sbelakho2/Cutting/hardware/if-b01/manufacturing/draft-r2-2026-09-13/assembly/if-b01-top-render.png

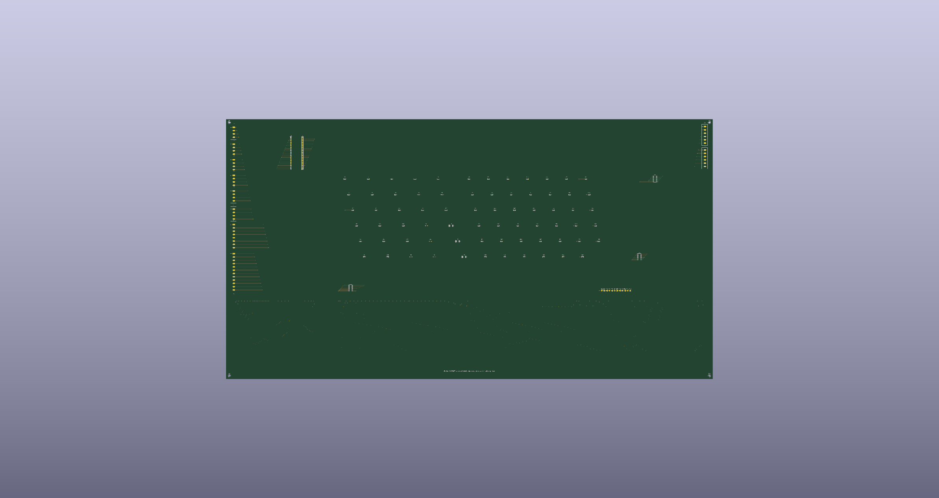
hardware/if-b01/manufacturing/draft-r2-2026-09-13/assembly/if-b01-top-render.png
