sbelakho2/Cutting/branding/brand-board.jpg

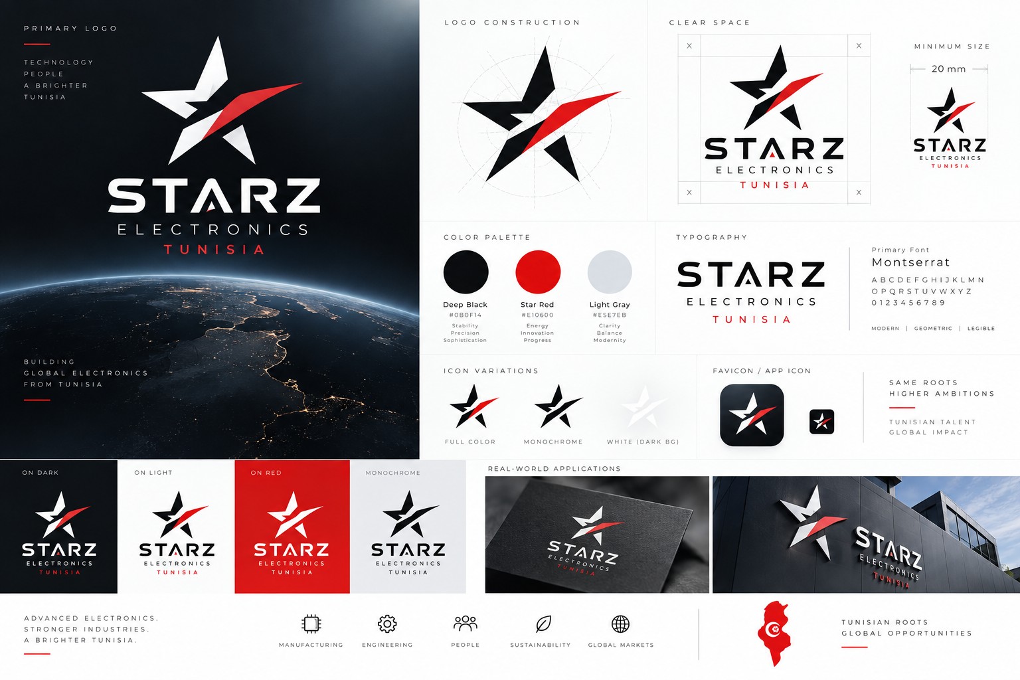
branding/brand-board.jpg
