sbelakho2/Cutting/engineering/README.md

# STARZ engineering — parts-first revision

This directory contains the replacement engineering work. **It is not a fabrication or energisation release.** The earlier generic-stage CAD and the “exact / zero-uncertainty” purchasing and physics reports are not the authority for this revision.

## Committed cutting-axis architecture

Two identical, independently driven, horizontal cutting axes:

| Item | Single selection | Basis |
|---|---|---|
| Complete ballscrew / guide / fixed-bearing axis | HIWIN **KK8610C-340A1-F0** (C-grade substitution, priced MISUMI VN shelf VND 21,146,653 on 2026-09-16; original P-grade identity KK8610P340A1F0 / article 10.00026), one standard block, no cover | Actual manufacturer product record; 10 mm lead, 340 mm rail, 440 mm overall axis length, 194 mm usable travel after reserves; C-grade accuracy margin analysis in [axis-replacement-findings](sources/axis-replacement-findings.md) |
| Motor / driver / cables | STEPPERONLINE **1-CL86T-P85-V41**: **34E1K-85**, **CL86T-V41**, **CM2M-18**, **CE2M**, **CABLE-PC-1** | Actual kit contents and motor drawing; no substitution with the previous NEMA23 kit |
| Shaft coupling | R+W **MK2/100/50/8/14**, H7 bores, no keyways | Manufacturer-configured catalogue coupling; 10 Nm nominal, 40 mm diameter, 50 mm length, **16 mm fit length** on the stage's 18 mm exposed shaft |
| Motion power | One STEPPERONLINE **LE-350-60** per cutting axis; buses **not paralleled** | Actual 60 V / 5.8 A model, 215 × 115 × 30 mm; regeneration protection is a separate design item, not a claimed PSU function |
| Transmission | **Direct 1:1**, no reduction belt | Actual stage lead and motor torque curve determine commanded speed and thrust |

The purchased axis is not shortened or represented as the old 175/180 mm generic slide. The motor is not represented as a 56 mm body. Its drawing shows **112.3 mm motor body plus 21.8 mm rear encoder section**, i.e. **134.1 mm before the 37 mm output shaft**. Cable space is additional.

The detailed shaft check rejected the initially screened KSD10: its 19 mm hub bore length exceeds the stage's 18 mm exposed shaft. The selected MK2 has a documented 16 mm fit length. No shaft extension, partly engaged hub or enlarged purchased housing is introduced.

This commits the actuation architecture, not the whole-machine BOM. Unselected transport, measurement, tooling, guard, electrical-protection and payoff interfaces must not silently inherit fabricated catalogue identities from the old reports.

## Load-path revision from simulation

The first40mm-wide holder passed a preliminary stress screen but **failed the loaded blade-clearance bound**: two holders could consume approximately0.0415mm versus0.020mm nominal clearance. Widening the same eccentric arm to70mm still failed (approximately0.0228mm). **R3 centres the70mm backbone on the screw/load line and machines the blade-seat pocket only at the nose, with a3mm internal fillet.** The blade plane and purchased hardware are unchanged. Earlier stress/displacement values do not validate this new load path; use its own regenerated results.

R3 left only0.00273mm in its isolated single-load-sign clearance screen. **R4 moves each complete purchased axis25mm closer to the wire and shortens the holder by25mm**, retaining the8mm carriage reserve and the0.020mm nominal blade gap. Completed R4all-sign/proof/gravityFEM at1.6mm mesh used77143nodes:working28.9957MPa,proof57.9871MPa,isolated rigid-blade pair gap+0.00454023mm. Holder displacement,frequency andpeak-stress refinement criteria passed. Adapter anddatum retained fourREFINEcriteria;they are not converged.

**R5** shortened the motor adapter to15mm and introduced the256-corner coupling stack,with≥0.53mm full-hub insertion reserve and≥12.58mm shaft-end gap. **R6** preserves that axial stack but deepens F0counterbores to8.5mm after explicitM5screw heads exposed interference with the actual motor pilot. The32adapter/motor screw/washer occurrences are now modeled. [R6adapter drawing](generated/drawings/H003-R6-adapter.pdf). Earlier adapterFEM does not validate this changed geometry.

The dedicated [R6 adapter FEM](generated/adapter-r6-analysis/report.md) now replaces the ideal fixed nodes with a resolved-pressure elastic-foundation model: the 4×8.0kN F0 M5 class10.9 preload (60% of the13.35kN proof load; required-preload screen, not a torque prediction) is applied on the counterbore-floor washer seats r∈[2.75,4.5]mm as a C¹-smooth quartic profile p(r)=p_peak·(1−s²)² with s=(r−3.625)/0.875 — zero with zero slope at both annulus edges, peak376.33MPa at r=3.625mm, mean p0=200.71MPa, so the per-seat resultant stays exactly8.0kN — and the Winkler foundation on the stage-side seat annuli shares the same resolved profile (action–reaction through the ISO7092 washer; peak kn=94,759.7N/mm³, kt=kn/2.67=35,490.5N/mm³), preserving the elastic half-space annular-punch calibration2·E·b/(1−ν²)=2014.41MN/m per seat over the39.86mm² annulus (E=205GPa,ν=0.29,b=4.5mm); the fully free system is solved with the supernodal CHOLMOD direct solver (METIS). The unchanged±8.5Nm/150N resultants stay on the actual85.85mm motor-flange bearing footprint (outside the Ø73.10 pilot bore, clear of the four Ø6.5 motor holes). Six uniform meshes6/4/2.8/2/1.4/1.0mm plus the isolated local-refinement pair (1.0mm background→0.7mm within8mm of the raw peak); finest level110580nodes. The uniform-patch edge singularity is removed — the pair peak285.987MPa sits on the counterbore floor0.59mm inside the washer-OD edge, not at a patch edge — but the gate pair still measures18.4573% raw peak and4.9551% displacement, because the resolved seat features (surface compression layer under the profile peak, floor-shelf deflection at the hole edge) live on the1.75mm seat annulus, the order of the pair's1.0mm background element; the gate rows remain **REFINE** (no criterion was relaxed, and the150000-node direct-solver cap is unchanged). A seat-scale focused pair of the same global model (0.15mm within3mm→0.1mm within2mm of the peak seat,1.5mm bulk,≤150000nodes) refines321.67→312.71MPa, last-change2.86%≤5%, bounding the model peak at≈313MPa — the raw peak converges at the feature's own scale and is local preload seat compression (yield/3 screen216.667MPa **FAIL**, below the650MPa certified yield). Stiffness sensitivity×0.5/×2 moves the peak+0.17%. The remaining gap is physical, not numerical: the resolved profile shape and the foundation stiffness are calibrated models, not measurements — a measured washer/joint contact stiffness or a two-body washer contact solve is the remaining justified step ([findings](sources/adapter-contact-findings.md)).

`starz_engineering` now accepts `--fem-part` with `holder`, `adapter` or `datum`, and a strictly decreasing `--fem-mesh-sizes` sequence for one selected part. Outputs explicitly record the requested scope; omitted parts are not validated. Ten malformed/ambiguous requests are checked by a regression before report creation. The150000-node direct-solver cap and all convergence/equilibrium limits remain unchanged.

## Selected feed cartridge

- **HTPA20S5M250-A-N14** keyed pulleys and **HTBN225S5M-250** belt;62.5mm nominalcentres,52.5–64.5mm adjustment requirement.
- Original **24HS40-5004D-E1000** motor STEP includes aD-flat,not a removablekey. Its50mm mountinggrid is modeled.
- **6001-2Z/C3** rear/nonlocating and **6002-2Z/C3** front/locating bearings,KM2/MB2retention,SEEGERA12groove,positivekeys. The roller receives the explicitly documentedF110secondarykeyway.
- [Cartridge3D](generated/feed/feed-cartridge.step), [four-rollerlayout](generated/feed-cassette/feed-cassette.step), [scope](generated/feed/status.json), [25calculation checks](generated/feed-analysis/checks.csv), [dimension and assembly record](../docs/12-feed-cartridge-fabrication.md), [F101 R6 A3 shaft sheet](generated/drawings/F101-R6-shaft.pdf), [machining-detail sheet](generated/drawings/F101-R6-details.pdf).
- The12mm pulley-seat iteration failed its bending screen and was replaced by14mm. R3combined-load shaft displacement bound0.0263053mm;3×notch-sensitivity working/fault stresses175.371/329.551MPa. These are beam/sensitivity results,not resolved key-seat/root/contactFEM or physical accuracy.
- R2makesF112frontbearingblock removable;the pre-keyed shaft/pulley/module stack entersF102from+S. MB2's actual inwardtang is modeled andits shaftslot extendedacross the14mmseat. Continuous sweep envelopes pass;separate regressions reproduce both the oldmonolithic-housing trap andclosedtang-slot obstruction. Sevenfeedtests passed83.87s.32occurrences in the motor-drivenexample;follower/passiveroles no longerduplicate motors.
- Pressure/tensioning slides,all fasteners,wireguides and full-machine integration are not in the exported single-cartridge assembly.
- R3models the actualMCØ4urethane-access holes andputs thewire atS108.75,with0.55mmboundedpocketclearance and2.10mmtreadedgeclearance. NipsX75.5/138nominal preserve10mminsulatedgrip on200mmparts duringfulltailbackfeed. Motoronfarshaft;upperhousings rotated180°abouttheirshafts. The116-partlayoutpasses1.2/4.5mmwireODstaticchecks;R3targeted9/9tests passed278.08s. Housingreliefnow accommodatesbeltbacking outtoR18.8455,notjust the36mmflanges.
- R4usesmatchedj5bearingseats andbounded housingclearances. [Fitreport](generated/bearing-fit/report.md) and[machiningwindows](generated/bearing-fit/matching-limits.csv):256corners,minresidual1.28µm within theexplicittemperatureenvelope. The desk [bearing-contact-thermal study](generated/bearing-contact-thermal/report.md) closes thehousing-compliance part (17.65MParesolvedseatpressure;seat vm22.73MPavs650MPa,ring82.26MPavs≈1700MPa;the record'sF112boreclearancecarriesnofitpressure;compliant-vs-rigidseatstresschange≤3.9MPaabsolute—PASS) andbounds thethermalfield (30Wstandstill→29.66Kfront-seatrisevs the20Kenvelope atthecentralstatedseatconductance—HOLD). Thethermalfield itselfremainsunverified byhardware;the oldh6bearingseats arewithdrawn.
- One incoming roller-bore band10.000–10.030mm covers the currentH7 product drawing and archivedEU +0.01/+0.03 callout. With the unchanged10h6 shaft, maximum diametral clearance is0.039mm. The key transmits torque; this is not an interference-fit roller.
- R5 added R0.20bearing/roller shoulders,R0.50neck shoulder,R0.04ring-groove roots,R0.15key-floor perimeters,matching C0.20key/C0.30spacer relief,and Ø13.50M15runout. The blind M5 hole has14mm full thread after its C0.20entry,18mm cylindrical drill depth plus118°point; cutting-lead allowance1.28mm,not verified clearance to an undimensioned male centre. The [selected Dormer E412M5 operation](../docs/14-f101-tapping-operation.md) requires guarded measured physical-tip-to-full-form distance≤3.18mm for≥0.50mm cylindrical clearance. Manufacturer3D blind application,not the rejected E003's2.5D.
- R6 adds external C0.20 shaft ends,C0.50 M15 lead,R0.50 washer-slot plan/vertical-intersection blends andR0.15 floor/lip blends. All interacting pocket radii are built simultaneously on the cutting volume. Nominal point classifiers,cartridge intersections and continuous insertion paths pass;the old unfinished shaft is rejected.
- The new [section audit](generated/feed-sections/report.md) integrates191 nominal B-rep plane sections for area,centroid and principal bending inertias. No checked minimum principal I falls below its reduced beam counterpart;minimum ratio1.00. Independent solid/annular/translated/rotated/notched-section benchmarks pass. This is sampled nominal stiffness,not a continuous tolerance bound,local stress,fatigue or true helical-thread analysis. Updated beam displacement screen0.02636934mm;working/fault3× sensitivity175.371/329.551MPa. Local contact/preload/thermal-field work remains open.
- The beam solver now diagonally equilibrates translation/rotation DOFs and uses residual refinement. Every real section/load/support remains a node; redundant subdivisions below0.5mm are avoided because each constant-EI,point-loaded interval has an exact cubic solution. Independent short-feature and original beam benchmarks pass without relaxing residual or comparison tolerances.

## Distributed shaft stress study

The new [F101 R6 3D stress study](generated/feed-fem/report.md) uses eight full-tensor/displacement bases,all radial signs,six transmission-torque vertices and48 rotation phases with a rigorous per-mesh unsampled-angle bound. Distributed resultants do not torsionally clamp the bearing seats. Actual eccentric mesh gravity produces an additional0.000179097Nm drive-holding amplitude,which is checked and retained. [Equations and scope](../docs/15-feed-shaft-stress-model.md).

Four bulk/root meshes2/.30,1.6/.20,1.2/.13,1/.09mm finish at131909nodes/603290tetrahedra. Finest working/fault stress upper bounds76.5876/158.193MPa;working displacement bound0.0205005mm. Whole-shaft peak and displacement last-refinement checks pass,**but16 regional raw-peak/angular-bound checks remain unmet**. No percentile replaces a raw peak. Nominal-thread envelopes and omitted contact/preload/fatigue effects are not qualified.

The distributed solver uses exact gauge cancellation with CHOLMOD supernodal Cholesky through Eigen and METIS nested-dissection ordering;SuiteSparse/CHOLMOD with METIS is an engineering-build dependency. The earlier full suites passed44/44 native and44/44 ASan/UBSan, resolving the scalar-backend timeout with unchanged4% compliance/12% tensor criteria and150000-node cap. The preserved four-mesh/96-phase artifacts pass their ten field-data audits while retaining16 original spatial-convergence holds. [Historical verification record](../docs/verification/feed-shaft-fem.md).

The [earlier focused refinement increment](../docs/16-local-shaft-refinement.md) adds six full-shaft feature series,three independent background checks,all-root compatibility and a96-phase A12 audit:26 meshes,520 regional rows and52 independently checked VTUs. That source state retained A12,M15 and pulley-key/slot local holds. Neck,roller shoulder and roller key passed their local last-change/background comparisons without claiming all-root or physical qualification. Exactly six constraints use rigid-equilibrium reactions plus rigid-motion lifting;seven–twelve retain the Schur formulation. This resolved the focused mesh's false mixed-scale rank rejection,not by changing a dependence threshold. Its code passed **46/46 native in435.55 s** and **46/46 ASan/UBSan in835.01 s**. [Historical verification record](../docs/verification/local-shaft-refinement.md).

The earlier [CAD-feature increment](../docs/17-cad-feature-shaft-refinement.md) audits85 actual shaft faces and640 peak locations,adds five explicit CAD-feature sizing selections,and publishes26 meshes/52 audited fields. That M15 series passes local last-change,finer-background and96-phase comparisons. Pulley key-floor last changes pass,with background checked only at the penultimate level;the wider pulley/slot working check failed. Both A12 roots remained unconverged. The finest front-root peak has four vertices on its torus but a centroid0.000281177056 mm outside the exact solid;the original raw value remains visible. Its source passed **49/49 native tests in440.53 s and49/49 ASan/UBSan in707.15 s**. [Historical verification record](../docs/verification/cad-feature-shaft-refinement.md).

The current [A12 boundary-topology increment](../docs/18-a12-boundary-topology.md) reproduces that exact cell, adds explicit `--mesh-optimizer netgen`, and checks same-surface cells and all40 raw/phase-bound peak centroids. The original default mesher and old results remain reproducible. Eight studies add17 meshes/34 independently audited fields; both A12 roots pass local and specified finest-background0.20→0.17 mm comparisons. A96-phase front audit stays inside the48-phase bounds. The all-root Netgen series still has12 regional refinement holds. Every centroid of the finest front mesh was checked:136 exterior points in the baseline versus25 after optimization, with9→0 in A12. The25 non-A12 points remain reported; this is not complete geometry or stress qualification. All existing limits, regions, physical CAD and focused scope holds are retained. **52/52 native tests passed in579.68 s and52/52 ASan/UBSan tests in873.81 s**,with no sanitizer diagnostics. Project/Eigen code is instrumented;prebuilt third-party libraries are not. [A12 verification record](../docs/verification/a12-boundary-topology.md).

The current [exterior-centroid diagnosis increment](../docs/19-exterior-centroid-diagnosis.md) adds `starz_mesh_io` (fail-closed ASCII linear VTU reader), `starz_cad_boundary` (exact trimmed-face inspector) and `starz_feed_cell_geometry_audit`. All25 retained discrepancies project onto five concave fillet tori (faces68,71/72,63,61,7) with gaps0.0093–5.452 µm; three vertices per cell lie on CAD faces, one is interior. Two torus feature selections (`rear_shoulder_blends`,`roller_key_floor`) and a probe `--focus` list were added; at0.03 mm root with four torus features, all586087 centroids give3 exterior/0 on within148934 nodes; the0.02 and0.009375 mm runs exceed the unchanged150000-node cap and were rejected. Mesh-only; no stress rerun or containment claim. **54/54 native tests passed in 654.37 s; 54/54 ASan/UBSan tests passed in 740.25 s** ([verification record](../docs/verification/exterior-centroid-diagnosis.md)).

The [torus-focused root rerun](../docs/26-feed-shaft-torus-root-rerun.md) runs the unchanged four-mesh series2/.30,1.6/.20,1.2/.13,1/.09 mm with a whole-shaft `concave_fillet_tori` guide (the six diagnosed concave fillet tori plus both A12 roots; growth0.45) and both optimizers, all loads,48 phases, torque vertices, gravity and gates identical. Finest [Netgen](generated/feed-fem-torus/netgen/report.md)129936 nodes/565476 tetrahedra, working/fault bounds74.7377/165.049 MPa, displacement0.0206120 mm. The original gmsh-optimizer variant reported34 exterior same-surface centroids; the 2026-09-16 centroid closure ([findings](sources/centroid-closure-findings.md)) swept24 configurations (feature subsets, 0.02–0.04 mm torus roots, growth0.3–0.6, both optimizers) and showed the gmsh optimizer cannot remove the last concave-surface sliver tetrahedra within the unchanged150000-node cap (best: 2 exterior at148510 nodes), while Netgen eliminates same-surface tetrahedra entirely. The [gmsh](generated/feed-fem-torus/gmsh/report.md) series was therefore rerun with the Netgen volume optimizer (levels, feature, growth, loads, 48 phases and every gate unchanged): 0 exterior same-surface and 0 exterior peak centroids at129936≤150000 nodes, byte-identical to the Netgen series, closing the fail-closed CAD boundary audit gate. The residual whole-shaft continuous CAD-containment audit (`starz_containment_audit`, [findings](sources/containment-audit-findings.md)) then classified every element centroid of all four levels with the exact BRep point-in-solid test at1×10⁻⁷ mm: **32 exterior / 0 on-boundary** of1,125,721 centroids (0/24/3/5 per level), all facet slivers on the concave fillet tori (faces68,7,9,61,63,71,72), gaps0.0071–5.51 µm. The ten remaining regional holds are stable-location stress concentrations at under-resolved R0.15–0.20 blends (M15 runout, roller shoulder, roller key-floor perimeter) whose finer resolution exceeds the unchanged150000-node cap. Growth0.70 variants are worse (29/14 fails) and are retained as [records](generated/feed-fem-torus/gmsh-growth-0.70/status.json) without VTUs. The no-feature path reproduces the published all-root Netgen series byte-identically. No acceptance criterion or node cap was relaxed.

The [regional submodel record](../docs/28-feed-shaft-submodel-record.md) closes the remaining blend holds: exact global displacement transfer (VTU reproduction to1e-7 MPa), interpolated Dirichlet cut faces (0 unsupported points), 0.02→0.01/0.0175 mm sector roots ≤150000 nodes/window, the unchanged5% last-change gate, and Pilkey shoulder-fillet Kt cross-checks where applicable. All eleven regional rows (roller shoulder, M15 relief, roller key root, pulley key/MB2 slot; working+fault; both optimizers) **converge between0.02% and4.0%** with CAD-inside stable peaks; the M15 peak is a real bounded slot-wall∩groove corner (no handbook factor asserted) and the key-floor/S plateaus are documented blend behaviour. The submodel columns are additive. The whole-shaft same-surface exterior-centroid audit closed on 2026-09-16 (0 exterior in both four-mesh series at≤150000 nodes; [closure findings](sources/centroid-closure-findings.md)); it is a mesh-quality audit, not a fabrication blocker. The stronger all-cell containment audit reports32 exterior centroids, so `continuous_CAD_containment_verified` remains false; per-level counts are in [containment-audit.csv](generated/feed-fem-torus/gmsh/containment-audit.csv).

## Combined placement and regressions

[287-occurrencehead/eight-rollerlayout](generated/layout/head-and-feed-layout.step),[manifest](generated/layout/manifest.csv),[scope](generated/layout/status.json). Leftcassette isrotated180°aboutZ,not mirroredintounavailableleft-handedparts. Cross-subsystemstaticchecks passat1.2/4.5mmwireOD. A17.5mmstrictXgap certifieshead/feedseparation for everyindependentjawYposition. Near-shaftmotorplacement failsa dedicatedregression. Theframe,measurement,pressure/tensioningmechanisms,guardsandwiring arenotrepresentedbythisplacementSTEP.

Previous **head R6 / feed R6 / measuring R1** baseline: **39/39 passed natively in 713.65 s** and **39/39 passed under ASan/UBSan in 1324.91 s**. The public R6 cartridge/cassette/combined STEP exports and readbacks completed successfully. F101 R6 has two separately exported single-page A3 sheets;37/38 labels were checked in bounds without overlap. [Verification record](../docs/verification/feed-r6.md). Exact bounding boxes are cached once per unchanged solid; no collision pair or tolerance was removed. Measurement remains a separate interface/mount export,not an installed addition to the287-part layout.

## Mechanism integration R4 (`S1-B-MECH-R4-2026-09-16`)

`starz_mechanism_cad` builds the 504-occurrence full-machine source: head, both cassettes, two spring-loaded pressure carriers (4× MISUMI LHFRW12 bushings on PSFJ12-240 posts, SWU17-60 springs, DIN 913 adjusters), two wire guides with OD-specific F206 inserts, the measuring module with its SWU10.5-35 arm spring and 626 counter-roller fork, the 640×1120×25 EN AW-6082 T651 bed and welded frame, the R2 guard selections (DC01 2 mm side/rear/roof, 5 mm polycarbonate front door, S235JR lock plate, Bernstein SLC/ACF envelopes) and the R2 payoff (welded Ø400×160 spool on a Ø20 h6 C45 spindle, 47H7 6204 pockets in 18 mm S235JR posts, 430×560×8 base, Ø180×6 brake disc and caliper bracket). [Manifest](generated/mechanism/manifest.csv), [BOM](generated/mechanism/mechanism-bom.csv), [scope](generated/mechanism/status.json). A3 sheets: [P002 spindle](generated/drawings/P002-R2-payoff-spindle.pdf), [P004–P007 plates](generated/drawings/P004-P007-R2-payoff-plates.pdf), [G101–G106 panels](generated/drawings/G101-G106-R2-guard-panels.pdf). Checks at 1.2 and 4.5 mm wire verify valid solids for all nine groups, every guard/payoff pair and the remaining implemented cross-group pairs, spring deflection inside catalogue windows, nip preload 50–75 N and wheel force 6–19 N, ±10 mm bushing travel inside the posts, moving-head X clearance, and zero common volume between every part and the 880 mm external wire envelope. The three head/cassette placement pairs are covered separately by `starz_layout_cad`. Four regressions prove the gates reject a shifted bushing, a slack carrier spring, a light wheel and a blocked guard wire route. The R2 guard/payoff parts are fabrication-ready design solids for the internal build (A3 sheets in [generated/drawings](generated/drawings/)): `guard_door_kinematics_validated`, `guard_safety_function_validated`, `payoff_selection_complete` and `payoff_rotation_validated` remain false until the physical build; the brake pads, adjuster spring, door hardware and Bernstein drilling pattern are purchase-to-requirement. Cabinet, wiring and safety functions are not modeled by the mechanism CAD; `full_machine_integrated`, `physical_results` and `fabrication_released` stay false until the machine is built and measured. See the [guard/payoff selection record](../docs/26-guard-and-payoff-selection.md) and the [fabrication guide](../docs/31-fabrication-guide.md).

## Precision finishing and physical qualification

[Finishing cards](../docs/21-precision-finishing.md) (`starz_finishing_cards`) compute per-shaft j5 seat targets and pass schedules from measured bearing bores, and housing bore targets, all guard-banded by gauge U(k=2). [Qualification](../docs/20-physical-qualification.md) (`starz_qualification`) evaluates 30-piece length cells at two ODs × two lengths against ±(0.05 % + 0.20 mm) with Cpk ≥ 1.33, plus nip and wheel force records, and refuses blank or incomplete data. Both ship blank templates under [generated/finishing/templates](generated/finishing/templates) and [generated/qualification/templates](generated/qualification/templates). **No part has been finished and no machine has been measured.**

## Measuring interfaces and calibration R2

- [Manufacturer transcription](sources/measurement-interfaces.csv), [shared constants](../shared/measurement_spec.hpp), [interface STEP manifest](generated/measurement/manifest.csv) and [assembly/calibration record](../docs/13-measuring-interfaces-and-calibration.md).
- Substitution 2026-09-16 (unpriced Kübler/Autonics replaced): **ifm E60137** wheel (200 mm circumference, Ø63.66, Ø6 bore, PU 90 Shore A; ifm publishes no tolerance and no hub/screw dimensions — profile stations are retained placeholders) and **ifm RU3100** encoder (Ø6×10 shaft, no flat, tip10 from face; body Ø58.6×63.5; synchro flange 3×M4×0.7×6 PCD42; 1024 PPR factory TTL/HTL, 1000 kHz, 12000 rpm). Both short-tip and wrong-wheel-screw regressions still reject incorrect interpretations.
- [M201 plate A3 drawing](generated/drawings/M201-R2-encoder-plate.pdf) and [five-part encoder mount](generated/measurement/encoder-mount.step).60×60×6 mm6082-T6 plate; Ø36.5-class synchro-flange seat;3×Ø4.5 onPCD42;4×M4 support taps;M4×12 flange screws and M4×6 support screws in M203 rear counterbores;0.2 mm edge chamfers. The source integrates the measuring shaft and pressure/guide assemblies in mechanism R4 (lug raised15.915 mm for the larger wheel); their physical support/torque, fabrication and qualification evidence remain open.
- [C++ calibration API](include/measurement_models.hpp) and [report](generated/measurement-analysis/report.md). A32-interval weighted phase-map fitter rejects unobservable or nonmonotone data. Negative counts, reversals, int64 extremes, malformed CSV, separate verification, hard-link input aliases and failing residuals are tested. Existing reference controls remain unchanged and disabled for hardware.
- The report's392 held-out observations are **synthetic**. Maximum interpolation residual0.000650204 mm against the independent first-harmonic bound0.000963829 mm (eccentricity bound unchanged; the 200 mm wheel only rescales the phase map) is a numerical benchmark, not physical accuracy. The0.025 mm+0.01% metrology allocation must be verified using actual traceable data, qualified wire/contact conditions and a valid index reference.
- [Current analytic-only results](generated/current-analytical/checks.csv) retain17 checks and2 failures. The uncalibrated1m budget is now **1.65 mm** because source circumference alone contributes1.0 mm. Earlier FEM archives retain their original analytical context; this correction does not rerun or relabel their physical solves. The separate626 CN10K screen leaves0.5 µm before fit loss and is not approved.
- Use the individual `starz_measurement_cad`, `starz_measurement_analysis` and `starz_fabrication_drawings` targets for this work. Do not run the expensive full-head FEM generation target just to update measurement files.

## Evidence and model discipline

- Read [sources/catalogue-evidence.md](sources/catalogue-evidence.md) before using any numerical rating.
- A manufacturer's **static load rating**, **maximum working load**, **dynamic load rating**, and **repeatability** are different quantities.
- Specified load cases are design/test requirements, **not measured wire-cutting forces**.
- Materials, friction, contact, preload, support stiffness, motor temperature and wire-lot behaviour require qualification. No script can remove that requirement.
- Models must expose failed checks, numerical convergence and physical-validation holds. Exit success is not machine certification.
- All new analysis and CAD computation use C++20. Do not extend the legacy Python calculator as the machine's engineering authority.
- Prices observed on a product page are merchandise prices, not Tunisia-delivered quotations. No purchase, vendor contact, freight booking or duty eligibility verification has occurred.

## Superseded work

The S1-A full-machine CAD, the “exact / zero-uncertainty” component, physics, dimension and software-architecture documents, the single-point BOM and the Python calculator were removed from the repository on2026-09-13 and archived outside it (`Cutting-superseded-2026-09-13.tar.zst`). None of their identities, prices, load values or release statements may be reused. Existing nominal CAD checks validate only their explicitly declared geometry. Reference-only controls remain fail-closed.
