sbelakho2/Cutting/branding/README.md

# STARZ Electronics · Tunisia

The supplied [brand board](brand-board.jpg) is preserved unchanged. The machine and native HMI use **STARZ ELECTRONICS / TUNISIA**, not an invented Stars logo.

| Token | Board value |
|---|---|
| Deep Black | `#0B0F14` |
| Star Red | `#E10600` |
| Light Gray | `#E5E7EB` |
| Typography | Montserrat; system sans-serif fallback when not installed |

[starz-mark.svg](starz-mark.svg) is a manually reconstructed engineering trace, **not an original supplied vector master**. The C++ asset exporter also produces an **unaltered raster crop** of the original primary logo for the HMI and machine-decal preview. Use that crop rather than claiming the trace is exact. Approve a vector master before printing production decals; do not distort, mirror, or laser-cut load-bearing structure into the logo shape.

Minimum mark size on the board: 20 mm. Reserve clear space at least one quarter of mark height in this prototype layout pending the brand owner's exact X-unit definition. Use a 120 × 90 mm exterior decal; no branding obscures guards, warning labels, or indicators. Black structural skins, gray working surfaces, red non-safety accent strip. Emergency-stop devices retain their required red actuator/yellow background independently of brand colors.

The original artwork remains the owner's material. No Komax trademarks or product imagery are embedded in the STARZ machine.
