sbelakho2/Cutting/hardware/if-b01/review/if-b01-native-source-review.md

# IF-B01 native source review record

**Revision:** `S1-B-IF-B01-NATIVE-DRAFT-R2-2026-09-13`  
**Status:** source-level evidence only — **not released for PCB fabrication,
assembly, energisation, cabinet integration, safety use or machine operation.**

This record identifies what the native KiCad baseline proves and, importantly,
what it does not prove. It is not a design-review approval, manufacturing
release, physical test result or safety validation record.

## Scope of the native baseline

The editable [project](../if-b01.kicad_pro), [logical schematic](../if-b01.kicad_sch),
[local symbols](../if-b01.kicad_sym), [local footprints](../if-b01.pretty) and
[intent manifest](../if-b01-native-intent.json) are generated from the controlled
[component input](../if-b01-bom.csv), [connector-net input](../if-b01-netlist.csv)
and [controller signal specification](../../../shared/controls_spec.hpp).

The schematic embeds its local-symbol cache so it remains parseable without a
user-specific symbol-library configuration. The PCB file is a
$750\times400\ \mathrm{mm}$, four-layer placed/routed draft with all 90 board
footprints, four M3 mounting holes, local F.Cu pad escapes, In1.Cu vertical
breakouts and B.Cu net buses. The intentionally spacious routing-cell strategy
makes all generated copper inspectable, but remains subject to human and
fabricator review.

## Recorded checks

| Check | Result | Evidence / boundary |
|---|---|---|
| Generator input reconciliation | Passed | Every one of the 112 electrical BOM references is represented once; fixed U1/U2/U3 pin allocations and J3–J12 pin/net mappings are checked before source is written. |
| KiCad CLI | `10.0.6` | Local tool availability only; it does not establish manufacturing capability. |
| Schematic ERC | Zero reported violations | [if-b01-erc.rpt](if-b01-erc.rpt). This is a source-level electrical-rule result, not circuit analysis or a human review. |
| Native export parity | Passed: 112 BOM references, 102 netlist references, 298 connected symbol pins, six intentional no-connects | [if-b01-netlist.net](if-b01-netlist.net) and [if-b01-native-bom.csv](if-b01-native-bom.csv) are compared with the manifest. The ten supplied off-board mating plugs are BOM entries and intentionally have no electrical symbol pins. |
| Coordinate-derived socket regression | Passed: 40 physical Pico 2 pins recovered from J1/J2 pad coordinates | [check_if_b01_gpio_mapping.py](../../../tools/check_if_b01_gpio_mapping.py) derives every physical pin from pad position and fails on a reversed/mirrored socket row; the dry-contact pull-configuration contract is checked in the same gate. |
| PCB DRC with schematic parity | Zero physical DRC violations, zero unconnected pads and zero schematic-parity issues | [if-b01-pcb-drc.rpt](if-b01-pcb-drc.rpt), generated by KiCad 10.0.6 with `--schematic-parity --all-track-errors --severity-all --exit-code-violations`. This is a source check, not layout approval. |
| Draft manufacturing-output generation | Passed after all source gates | [draft output package](../manufacturing/draft-r2-2026-09-13) has four-copper, solder-mask, paste, silkscreen and outline Gerbers; drill, placement, assembly-view, board-only STEP, IPC-D-356, BOM and source/output SHA-256 manifest files. It is not a release package. |

## Preserved source constraints

- J1/J2 place a real Pico 2: J2's dedicated reversed socket footprint puts pad 1
  (physical pin 21, `GP16`) at the row bottom; the coordinate regression fails
  any mirrored or reversed socket row.
- U2 channels 1–7 are BF `PUL−`, BF `DIR−`, BR `PUL−`, BR `DIR−`, FL `PUL−`,
  FL `DIR−`, and FR `PUL−`; U3 channel 1 is FR `DIR−`.
- U3 channels 6 and 7 inputs are tied to `0V_PELV`; their outputs have explicit
  no-connects and no field connector allocation.
- U1 receives the four encoder single-ended TTL signals on its + inputs and
  exposes only the selected non-inverted receiver outputs to `GP8`–`GP11`; the
  minus inputs carry the R38–R45/C14–C17 2.5 V mid-bias and no 120 Ω terminator
  exists on the board.
- The dry-contact pull-configuration contract requires the RP2350 internal pulls
  to be disabled in both firmware images on `GP12`–`GP16`, `GP27`, `GP18`–`GP21`.
- C1 is the 16 V 3.3 V receiver decoupler. C2/C3 are the distinct 50 V
  `GRM188R71H104KA93D` bypass capacitors from `+24V_TPL_COM` to `0V_PELV`.
- F1–F3 are verified 1812 SMD PTCs: `MF-MSMF050/60X` on the 24 V branch and
  `MF-MSMF050/16X` on the two 5 V encoder branches.
- The common-anode 24 V PUL/DIR/ENA positive wiring remains cabinet wiring and
  is not routed through IF-B01.

## Open release gates

1. Review the logical circuit and datasheets, including actual fault energy,
  TPL COM bypass/bulk capacitance, connector ratings, input protection, power
  loading, return paths and the present layout strategy.
2. Validate selected footprints, connector orientation, the 750 × 400 mm panel,
  fabricator stack-up, copper, drill, clearance, mask, silkscreen and assembly
  capability; revise the draft source where a manufacturer requirement differs.
3. Build and inspect a bare board, execute the isolated fixture procedure and
   record actual measurements before connection to production motor drivers.
4. Complete the separate cabinet, DC-power, PE, EMC, guarding and safety-function
   evidence. IF-B01 and its firmware signals are not safety functions.
