sbelakho2/Cutting/engineering/generated/bearing-fit/report.md

# Selected feed bearing fit envelope

SKF6001-2Z/C3and6002-2Z/C3,unmountedC3=11–25µm. Use **matched j5bearing seats**,not unselectedh6. For10<d≤18mm,j5is−3/+5µm;each actualbearing bore ismatched to **3–6µm diametral interference** withinthatzone. The matchingtable lists actual-size limits,not gaugeuncertainty. F102bore28.008–28.018mm;F112bore32.008–32.019mm. No retentionadhesive oradditionalbearingpreload is specified.

Enumerated **256independent corners**. Minimum residualradialclearance **1.28µm**;minimum outerring/housingdiametralclearance **2.432µm**. The maximumcatalogue/C3andj5ranges cannot simplybe combined:anunselected12µminterferencecase fails andis testedasaregression.

## Thermal envelope used

Housing10–55°C;outerring0–5Kabovehousing;innerring0–10Kaboveouter;shaft0–5Kaboveinner. These areexplicitdesign/acceptancelimits,NOTmeasuredtemperatures or a completedheat-transferprediction. The thermalnetwork andinstrumentedcold-start/hot-run testmust demonstrate these limitsbeforethefit isreleased. Steel12µm/m/K,6082aluminium23.4µm/m/K;ringthermalreduction0.012ΔT(d+D)/2inµm. Fitreductionfactor1.0 isusedasaconservativebound;no favourablethick-steelhousingfactor isappliedtoaluminium.

## Inspection and assembly

Finish matchedjournalswithcertifiedcylindricalfinishing;Ra≤0.4µm. Markeachbearing/shaft/cartridgepair. Gaugeuncertaintymustbeincluded:combineddiameteruncertainty≤0.5µm requiresmeasuredinterference3.5–5.5µmandguardedj5limits. Measureat20°C;pressonlytherelevantring. Rearouterringremainsaxiallyfree;do notturnthe6001innerringendfloat intoaxialbearingpreload. Matchreplacementbearings beforeinstallation. Precisionseatrunout/rootgeometryandhousingstiffness remainseparatechecks.
