sbelakho2/Cutting/engineering/generated/feed-analysis/report.md

# Feed drivetrain calculation record

Revision **S1-B-FEED-R6-2026-09-12**.

Selected pulley **HTPA20S5M250-A-N14**, belt **HTBN225S5M-250**; nominal centres **62.5mm**. The12mm pulley-seat iteration failed the bending screen and was replaced by the14mm keyed catalogue bore.

R3puts the wire lane atS108.75,5.25mm off the roller midplane,away from the twoMCurethane-access holes. With4.5mmwire,±0.20mmassembled lane position,4.2mm maximum incoming access diameter,±0.15mmaccess-centre tolerance and−0.2mmroller length: minimum pocket-edge clearance **0.55mm**,tread-edge clearance **2.1mm**. Shaft loads use this actualoffset station.

Nips are X75.5and138.0mm nominal;at maximumcentre setting,thefarnip isX140.0mm. A200mmpart with25mmleadingstrip and25mmtailbackfeed retains **10mm** insulated grip beyondthefarnip. The motor is on theouter/farshaft,awayfromthecutting stages.

R5 adds machined shoulder/key-seat/groove radii and matching key/spacer relief. The blind M5 thread now has14mm full-profile depth after its0.2mm entry chamfer,18mm cylindrical drill depth and a118degree drill point. Worst specified clearance beyond a3-pitch cutting-tap lead is **1.28mm**. R6 defines the external end/thread-lead chamfers and the washer-slot plan/intersection/floor blends. Reduced beam intervals now include the two end chamfers and the S33.30–61.70 key-lip envelope. The separate machined-section audit checks nominal principal bending inertias against these reduced sections. These geometry checks do not replace local contact/root stress analysis.

## Belt and commissioning setting

Minimum catalogue capacity across50–260rpm: **10.889724Nm**. The1Nm operating envelope carries a2.5 reversing-service factor. The separate5Nm mechanical fault envelope has capacity ratio 2.1779448. These are design envelopes, not measured wire forces or a motor tolerance guarantee. No power-table extrapolation to standstill is made. Static holding/jam tooth integrity requires the5Nm bench test in the assembly record.

Set initial strand tension190N, acceptance180–200N. At the62.5mm span, apply **1.000mm** transverse deflection. Corrected deflection force: **13.871528–15.121528N**, target **14.496528N**. Use the actual measured span in the equation if the final tensioned centre distance differs. At180N initial tension and5Nm, the slack strand remains **22.920367N**. Manufacturer225mm belt length tolerance±0.41mm corresponds to±0.205mm geometrical centre change before elastic tensioning.

## Shaft and bearing screens

Eight independent load-sign combinations:±480N belt radialX;±60N rollerX and±60N rollerZ. These conservatively allow simultaneous components. Maximum displacement bound **0.026369341mm**; nominal bending bound **55.288537MPa**. With an explicit3x notch sensitivity: working combined stress **175.37132MPa**,5Nm fault **329.55098MPa**. Peak bearing resultants: rear **321.22845N**,front **309.90595N**. Full-length constant-torque shaft wind-up screen **0.0012349608rad/Nm**; actual torque distribution and encoder correction are separate.

The model uses reduced circular sections, not resolved key-seat roots. The real housing, bearing contact/clearance, corner radii, pulley-belt dynamics, rubber contact and fatigue are not replaced by this beam calculation. No physical accuracy or machine-life result is asserted.

## Axial retention

Rear inner-ring stack minimum end float **0.08mm**, maximum **0.5mm**. The rear outer ring floats axially in28.008–28.018mm. The front6002 is the locating bearing,in32.008–32.019mm,clamped at its inner ring byKM2/MB2. Matchedj5shaftseats use3–6µmactualinterference;see the separatebearing-fit/thermal-enveloperecord. Its outer ring has0.020–0.110mm specified end clearance in the9.02–9.05mm pocket; do not impose nut preload through both bearings.

Generated **25** calculation checks; **0** failures. Refer to the per-check basis. Fabrication release also requires completed housing/root analyses, pressure/tensioning assembly and fastener/tool-access drawings.
