sbelakho2/Cutting/hardware/if-b01/manufacturing/draft-r2-2026-09-13/drill/if-b01-drill-report.txt

Drill report for if-b01.kicad_pcb
Created on 2026-10-13T11:45:14

Copper Layer Stackup:
    =============================================================
    L1 :  F.Cu                      front
    L2 :  Inner layer 1             in1
    L3 :  Inner layer 2             in2
    L4 :  B.Cu                      back

Drill file 'if-b01-PTH.drl' contains
    plated through holes:
    =============================================================
    T1  0.350mm  0.0138"  (410 holes))
    T2  0.600mm  0.0236"  (174 holes))
    T3  1.000mm  0.0394"  (52 holes))
    T4  1.400mm  0.0551"  (56 holes))

    Total plated holes count 692

Drill file 'if-b01-NPTH.drl' contains
    unplated through holes:
    =============================================================
    T1  3.200mm  0.1260"  (4 holes))

    Total unplated holes count 4
