sbelakho2/Cutting/docs/33-gate-ledger.md

# 33 — Gate ledger: every open gate and hold in the repository

**Revision:** `S1-B-LEDGER-R2-2026-10-13`
**Status:** single source of truth for "what remains". One table below lists
every open gate/hold found across the repository (docs/24 §9+§10, docs/22
§10, docs/26 §6, docs/28 §4+§7, docs/20, docs/12, docs/15–18, docs/30,
README.md warnings, engineering/README.md "not yet qualified" mentions, the
external audit of 2026-10-13 (F01–F35, [docs/41](41-goal-traceability-matrix.md)
re-verdict) and the verdict/status files under `engineering/generated/`).
Categories:

- **CLOSED** — fully closed with recorded evidence (none of the open gates
  qualify; the table contains no CLOSED rows).
- **DESK-CLOSABLE** — closable by calculation/document work at a desk. Gates
  whose desk part is now closed say so and give the study/record; gates
  being handled by a parallel workstream are named.
- **PHYSICAL-ONLY** — requires hardware, measurement or competent-person
  sign-off; the exact procedure/template is cited.
- **EXTERNAL-INQUIRY** — requires a manufacturer/distributor answer; the
  exact enquiry text/row is cited.

Nothing in this ledger releases fabrication or energisation. Desk closures
recorded here (§2) are calculations with stated assumptions; the physical
steps attached to each gate remain mandatory.

**Historical authority (audit F35).** Superseded drawings/reports hold no
build authority: the HIWIN KK86 axis material (KK8610C leads, KK86-era
drawings/studies) is superseded by the custom axis
[docs/39](39-custom-cut-axis.md) and its frozen 10 mm-lead configuration;
the guard/payoff R1 record [docs/25](25-preliminary-guard-and-payoff.md) is
superseded by [docs/26](26-guard-and-payoff-selection.md); the F101-R4/R5
shaft drawings are superseded by F101-R6; M201-R1 is superseded by M201-R2;
the 1024 PPR-era measurement budgets are superseded by the 2048 PPR R2
record ([docs/42](42-process-dynamics-r2.md)); the older adapter square-patch
boundary studies are superseded by the resolved-pressure model. The full
list with links is in [docs/24 §1](24-production-and-release-plan.md).

## 1. Open gates

| # | Gate | Where | Category | Current evidence | Exact closure action |
|---|---|---|---|---|---|
| 1 | Housing/collar key contact | docs/24 §3/§9/§10.6; docs/12:68,158; feed-fem "key/collar contact" holds | DESK-CLOSABLE — desk part **CLOSED 2026-09-16** | New [collar-contact study](../engineering/generated/collar-contact/report.md): 5 Nm resolved-pressure linear FEM, ≤35 k nodes, both key identities PASS the C45 allowables (bearing 120, shear 180 MPa). F109 3×4×18: contact 26.2 MPa FEM (25.25 ideal), shear 18.5, seat bearing 30.9, key peak vm 164 MPa < 300 MPa F109 min yield, aluminium collar-wall margin 1.66× (limit 65/1.5 = 43.3 MPa). DIN 3×3×20 passes C45 allowables but erodes the aluminium margin to ≈1.0× — not an endorsed F109 substitute. Clamp: M4 8.8 @2.8 Nm, K=0.2 → 3.5 kN/screw, 7 kN total (69% of 5.1 kN proof) | Remaining physical part: incoming bore 10.000–10.030 mm and keyway 3.04±0.01/2.35±0.025 measurement on F110 (inspection/incoming-inspection-template.csv), clamp-screw identity + torque record at assembly, belt proof test 5 Nm/10 s/10 cycles slip-marked (docs/12:152) — runbook steps [P0-2, P4-1, P4-4, P4-5](36-commissioning-runbook.md) |
| 2 | Adapter FEM raw-peak REFINE / seat contact model | docs/24 §9/§10.6; adapter-r6-analysis; engineering/sources/adapter-contact-findings.md | DESK-CLOSABLE + PHYSICAL-ONLY (adapter workstream completed 2026-09-16) | Resolved-pressure model (C¹ quartic seat profile, peak 376.33 MPa, mean 200.71 MPa per 8.0 kN seat; resolved Winkler foundation) removes the patch-edge singularity: pair peak 285.99 MPa sits 0.59 mm inside the washer-OD edge; gate pair (1.0→0.7 mm) still 18.46% raw peak / 4.96% displacement → rows stay REFINE (never relaxed); seat-scale pair (0.15→0.1 mm, 64,944 nodes) refines 321.67→312.71 MPa, 2.86% ≤ 5%, bounding the model peak at ≈313 MPa (below 650 MPa yield, above the 216.7 MPa yield/3 screen) | Remaining gap is physical: measured washer/joint contact stiffness or a two-body ISO7092 washer contact solve (docs/24 §9, adapter-contact-findings.md); keep the unchanged gates and the 150 k-node cap — runbook step [P4-2](36-commissioning-runbook.md) |
| 3 | 34-exterior same-surface centroid whole-shaft audit | docs/26:22; docs/28 §7; README warnings; engineering/sources/centroid-closure-findings.md | DESK-CLOSABLE — desk part **CLOSED 2026-09-16** (exterior-centroid workstream); residual containment audit **EXECUTED 2026-09-16** | Config sweep + final rerun: `no_exterior_same_surface_centroids` 0 → PASS_SCOPED and `all_reported_peak_centroids_in_CAD` 0 → PASS_SCOPED on the gmsh torus series (≤150 k nodes; loads/phases/gates unchanged; Netgen series reproduced byte-identically). The residual whole-shaft continuous CAD-containment audit was then run exactly ([findings](../engineering/sources/containment-audit-findings.md), [counts](../engineering/generated/feed-fem-torus/gmsh/containment-audit.csv)): BRep point-in-solid classification of all 1,125,721 element centroids of the four levels (2/0.3, 1.6/0.2, 1.2/0.13, 1/0.09 mm) at 1×10⁻⁷ mm finds **32 exterior / 0 on-boundary** (0/24/3/5 per level), all facet slivers on the concave fillet tori (faces 68, 7, 9, 61, 63, 71, 72), gaps 0.0071–5.51 µm | Residual: `continuous_CAD_containment_verified` remains **false** (32 exterior centroids of 1,125,721); not a release blocker; keep the four-mesh raw values and every gate unaltered |
| 4 | Fastener preload/torque record (M5/M10 joints) | docs/24 §10.5; docs/30:97; docs/12:115 | DESK-CLOSABLE — desk part **CLOSED 2026-09-16** (ledger §2.2) | Torque values "not published" for M5/M10; H003 joint preload record pending | Desk calc recorded §2.2; physical: record actual torque values in the production build record (inspection/production-build-record-template.csv) at assembly — runbook step [P4-1](36-commissioning-runbook.md) |
| 5 | Roller-key identity slip (3×3×20 vs F109 3×4×18) | docs/28 §2.3 ("UMCL roller key … (3×3)"); docs/12:109 (F109 3×4×18); catalogue-evidence:142 | DESK-CLOSABLE — desk part **CLOSED 2026-09-16** (ledger §2.3) | F109 is 3×4×18 C45+N (width 2.975–3.000, height 3.950–4.000, length 17.90–18.00); the audit's "3×3" shear line is a transcription slip | Both identities evaluated in the collar-contact study (gate 1); keep F109 as the governing selection; no doc edit made outside this ledger |
| 6 | Kübler wheel M4×6 set-screw torque | docs/30:182 | DESK-CLOSABLE — desk part **CLOSED 2026-09-16** (ledger §2.4) | Register row "set screw torque pending" | Desk value 2.0 Nm recorded §2.4; physical: record applied torque at assembly in the build record — runbook step [P4-3](36-commissioning-runbook.md) |
| 7 | Guard/payoff weld & assembly procedure | docs/26 §6.7; docs/34 | CLOSED-DESK (physical inspection remains) | Procedures drafted with fixtures, processes and criteria: post-to-base coaxial weld (gauge-pin fixture, coaxiality ≤0.1), spool hub weld (runout ≤1.0), jamb/door-frame weld + glazing (docs/34) | Physical weld inspection and first-article checks (docs/26 §6.3, docs/20) — runbook steps [P3-1…P3-4](36-commissioning-runbook.md) |
| 8 | True helical-thread roots (M5 blind hole, M15) | feed-fem holds "true_threads_verified:false"; docs/15:124; docs/12:60 | PHYSICAL-ONLY | FEM uses nominal thread envelopes; not qualified | Machining QA per docs/12 (M5 depth/tip record docs/14, thread gauge) plus thread inspection at receipt; no FEM number releases the thread — runbook steps [P2-2, P2-3](36-commissioning-runbook.md) |
| 9 | Final edge breaks 0.05–0.10 mm | feed-fem; docs/12 | PHYSICAL-ONLY | Deburr practice specified; not measured | Deburr without raised lips and inspect per docs/12:127 + build record — runbook step [P2-4](36-commissioning-runbook.md) |
| 10 | Bearing/housing compliance, preload, thermal field | docs/24 §9 "Bearings, joints and thermal behavior"; bearing-fit (`thermal_field_verified:false`); docs/12:68 | PHYSICAL-ONLY — desk parts (housing compliance + thermal field) **CLOSED 2026-09-16** (ledger §2.5) | 256-corner fit envelope passes conditionally (min 1.28 µm); new [bearing-contact-thermal study](../engineering/generated/bearing-contact-thermal/report.md): the 6 µm matched interference resolves to 17.65 MPa on the seat (seat vm 22.73 vs 650 MPa, ring 82.26 vs ≈1700 MPa); the record's F112 bore is a clearance fit, so the housing carries no fit pressure (bore-wall 0.98 MPa under the resolved 310 N); housing compliance changes the seat stress ≤3.9 MPa absolute (a rigid-boundary artifact) — not material; the 30 W standstill thermal FEM gives a 29.66 K front-seat rise vs the record's 20 K shaft-above-housing envelope → **not met at the central stated seat conductance** (sensitivity 15.5–51.7 K) | Remaining physical: measure/justify preload, contact and the seat temperature field on the actual build; instrumented cold-start/hot-run test (docs/12:38); record the motor-case temperature at rated hold (docs/28 §2.5) — runbook steps [P1-1…P1-5, P9-1…P9-3](36-commissioning-runbook.md) |
| 11 | Rotating fatigue qualification | feed-fem (`fatigue_verified:false`); docs/15:124; docs/24 §9 | PHYSICAL-ONLY — desk part **CLOSED 2026-09-16** (ledger §2.6); whole-machine load context in [docs/37](37-system-dynamics.md) §1/§4 (ledger §2.7) | Desk S-N in [docs/38](38-fatigue-and-life.md): working whole-shaft bound 76.6 MPa, worst converged regional working peak 60.4 MPa (M15 corner, docs/28 §5); 42CrMo4+QT σ_w 400–450 MPa (FKM-Richtlinie basis), Kt 1.5–2 (Pilkey) with record-computed 2.534–2.586, surface 0.85 / size 0.97 → n_f ≥ 1.7 (worst stated combination) and ≥ 5.5 at the converged regional peaks; 5 Nm fault 158–165 MPa = 3.9–4.1× below yield, 1000 cycles <0.2 % S-N damage; bearing L10 all ≥ 20,000 h by ≥ 7.9× (docs/38 §4) → desk PASS, infinite-life regime | Physical rotating-fatigue test on the actual shaft/build (docs/15 requirement) remains the gate; the desk S-N does not substitute — runbook step [P6-9](36-commissioning-runbook.md) |
| 12 | ±60 N roller-force envelope / pressure, friction, jam | docs/verification/feed-shaft-fem.md:116; docs/24 §9 | PHYSICAL-ONLY — desk dynamics half **CLOSED 2026-09-16** ([docs/37](37-system-dynamics.md) §1/§5, ledger §2.7) | 5 Nm at r=20 mm could mean 250 N tangential — torque alone does not prove the force limit; docs/37 bounds the attainable wire pull (2·μ·N = 40–90 N per nip at μ 0.4–0.6 × 50–75 N preload; 80–180 N two-nip worst case) against the 0.83 N acceleration demand and 5–20 N payoff-brake guidance | Physical pressure/friction/jam qualification on the assembled cassette + docs/20 nip/wheel force records — runbook steps [P6-4…P6-6](36-commissioning-runbook.md) |
| 13 | Blade pair T001 | docs/24 §4.4; head (`tooling_qualified:false`) | EXTERNAL-INQUIRY + PHYSICAL-ONLY | Purchase-to-drawing; edge-unqualified; no blade pair procured | Specialist manufacture quote to the drawing; loaded clearance verification before installation; edge qualification (docs/24 §4.4) — runbook steps [P0-5, P6-8](36-commissioning-runbook.md) |
| 14 | Guard risk assessment & 30 mm aperture sign-off | docs/26 §6.1/6.5; README warnings; mechanism (`guard_safety_function_validated:false`) | PHYSICAL-ONLY | Desk reach calc passes 2.9× (EN ISO 13857: 345 mm > 120 mm, docs/28 §2.2); requires sign-off | Task-specific risk assessment (cutting, wire release, entanglement, ejection, access, maintenance, loading, power loss, egress) on inspection/guard-payoff-release-template.csv + aperture verification against the current standard edition — runbook steps [P8-2, P8-3](36-commissioning-runbook.md) |
| 15 | Bernstein SLC/ACF mounting + G106 drilling pattern | docs/26 §6.2 + G106 row | EXTERNAL-INQUIRY — desk part **CLOSED 2026-09-16** | Manufacturer documents retrieved and archived: Bernstein installation/operating manual 0800000865 (2022-07-12, `engineering/sources/bernstein-slc-installation-manual-0800000865.pdf`) + datasheet 6018200007 (`engineering/sources/bernstein-slc-f-024-20-20-r4-datasheet.pdf`). Geometry recorded in docs/26 §2/§6: SLC-F 30×192×44 mm, 4×M5 (Ø5.4; rows 161.6 mm / columns 22 mm), 3×M20×1.5, flat surface, any orientation, alignment X/Y 29+3, 2 mm overtravel (stop 0.2–2 mm), ACF-1 R ≥400 mm, one-way screws M5×25/40 available | Physical fit and locking-travel verification remains (docs/26 §6); transfer the exact hole coordinates from the archived drawing p.8 to the G106 fabrication sheet before drilling — runbook steps [P3-4, P8-1](36-commissioning-runbook.md) |
| 16 | Payoff physical validation (spool mass, spindle deflection, welds, brake, runaway) | docs/26 §6.3; mechanism (`payoff_selection_complete/rotation_validated:false`) | PHYSICAL-ONLY | Desk spindle bending bounds: 30 kg → 0.65 mm/52 MPa; 61 kg → 1.33 mm/107 MPa (docs/28 §2.1) | Weigh full spool (≤30 kg until re-checked), measure spindle deflection, weld inspection, brake adjustment, runaway/overspeed measurement (docs/26 §6.3) — runbook steps [P7-1…P7-4](36-commissioning-runbook.md) |
| 17 | PC door impact + door hardware | docs/26 §6.6 | PHYSICAL-ONLY | 5 mm PC front door selected; no impact evidence | Impact verification + door hardware inspection per docs/26 §6.6 — runbook step [P8-4](36-commissioning-runbook.md) |
| 18 | IF-B01 review, fabrication, fixture | docs/22 §10.1; docs/24 §5 | PHYSICAL-ONLY | ERC/DRC/parity clean (draft); no human review or produced board | Electrical/mechanical review, fabricator panel/stack-up confirmation, bare-board build, `if-b01-factory-test.uf2` fixture run with J4–J7 disconnected (hardware/if-b01/if-b01-test.md); archive fixture logs — runbook step [P5-1](36-commissioning-runbook.md) |
| 19 | LC1D12BD DC switching duty | docs/22 §10.2/§11.1; docs/24 §10.4; README | EXTERNAL-INQUIRY — desk part **CLOSED 2026-09-16** | TeSys Deca catalogue MKTED210011EN (2026) retrieved from download.schneider-electric.com and archived (`schneider-tesys-deca-catalogue-2026.pdf`, extract `schneider-tesys-dc-tables-fuse-carriers.pdf`). A5/120–121: 3 poles in series, DC-1 and DC-2..5 rated operational current **20 A at ≤75 V** → 36 V/9.7 A covered 2.06×, 60 V/5.8 A covered 3.45×; load L/R ≈0.1–0.3 µs ≪ 1 ms; verdict in docs/22 §11.1; CT-K1-K3/CB-K1-K3 → `selected_DC_duty_qualified` | Measured K1/K2/K3 opening behavior on hardware (docs/22 §8.5) and the catalogue critical-current durability note (5.8/9.7 A below the 20 A table value) remain physical checks; the §11.1 alternatives stay a contingency record only — runbook step [P5-5](36-commissioning-runbook.md) |
| 20 | DC branch fuses/holders/coordination/inrush | docs/22 §10.3/§11.6 | EXTERNAL-INQUIRY (identities — electrical-identities workstream) | Wire ampacity/regen/discharge desk parts done; XPS fuse corrected to 2 A and moved to the priced 5×20 solution (docs/22 §11.3); drive-logic feeds on 3046032 + 1 A links; the 10×38 holder identity is now catalogue-confirmed (DF101, gate 38) but superseded by the 5×20 solution | Confirm the branch fuse identities on live distributor pages at purchase (exact proposed identities in docs/22 §11.6); measured decay + prospective-fault coordination at commissioning — runbook step [P5-6](36-commissioning-runbook.md) |
| 21 | AC incoming/protection, enclosure, terminals, glands, PE, local regulation | docs/22 §10.4/§11.5/§11.6; docs/24 §6 | EXTERNAL-INQUIRY + PHYSICAL-ONLY | Thermal budget passes on paper (≈152 W vs 280 W L35, docs/22 §11.5); identities proposed (§11.6); PE/AC design not released | Competent-person electrical review under local regulations; confirm enclosure/terminal/gland/PE identities at purchase; physical PE continuity/insulation tests (docs/23) — runbook steps [P5-2, P5-3](36-commissioning-runbook.md) |
| 22 | E1/E2 guard-release-permission design | docs/22 §11.8 | CLOSED-DESK (physical verification remains) | R2 + K1–K3 NC chain + T2 on-delay design specified with fail-safe direction (docs/22 §11.8); original design-input list satisfied at design level | Physical: measured bus decay, timer setting, risk-assessment sign-off, fault-injection validation (docs/22 §10 hold 5/6) — runbook steps [P5-6, P8-5](36-commissioning-runbook.md) |
| 23 | Safety-function validation (fault injection, stop time, bus decay) | docs/22 §10.6/§8.4–8.5; docs/20 | PHYSICAL-ONLY | Only the hardwired XPS/contactor path is the safety function; unvalidated | Reviewed test plan: each E-stop channel, both guard paths, cross-wire faults, reset/EDM, each contactor fault mode; measured stop time, DC-bus decay, regenerated-energy behavior (docs/22 §8) — runbook steps [P5-4, P5-7, P5-8](36-commissioning-runbook.md) |
| 24 | Commissioning of IF-B01, USB, encoders, field I/O, contactors, drivers | docs/22 §10.7; docs/24 §7 | PHYSICAL-ONLY | No hardware commissioning exists | Staged energisation under competent oversight per docs/24 §7: voltages, polarity, field contacts, encoder direction, drive enable, interlocks, fault response, restart prevention; record instruments — runbook step [P6-1](36-commissioning-runbook.md) |
| 25 | Physical machine qualification (length cells, forces, Cpk) | docs/22 §10.8; docs/20; qualification (`qualification_passed` false everywhere) | PHYSICAL-ONLY | Procedure + fail-closed tool exist; all templates blank; synthetic fixtures are not results | Execute docs/20: ≥30 pieces per mandatory cell (OD 1.2/4.5 mm × 200/1000 mm), Cpk ≥ 1.33, nip 50–75 N, wheel 6–19 N, environment 15–30 °C, gauge U ≤ 0.05 mm / 1.0 N; retain raw CSVs; `physical_results` only for non-SYN identities — runbook steps [P10-1…P10-5](36-commissioning-runbook.md) |
| 26 | First article + energisation gate | docs/24 §8.1 | PHYSICAL-ONLY | Template blank | Complete inspection/first-article-and-energisation-gate-template.csv with actual evidence and reviewer disposition — runbook step [P10-6](36-commissioning-runbook.md) |
| 27 | Fabrication/incoming/build-record evidence | docs/24 §1–§3 | PHYSICAL-ONLY | All templates blank; source checks ≠ physical results | Execute inspection/production-build-record-template.csv and inspection/incoming-inspection-template.csv per work package; run tools/check_production_records.py etc. — runbook steps [P0-1…P0-7, P2-1…P2-6, P3-1…P3-4, P4-1…P4-7, P10-8](36-commissioning-runbook.md) |
| 28 | Measuring module physical support/torque + fabrication | engineering/README measuring paragraph; docs/13 | PHYSICAL-ONLY | M201 source and interfaces exist; "physical support/torque, fabrication and qualification evidence remain open" | Fabricate and measure per docs/13 + mechanism manifest; wheel contact force 6–19 N record (docs/20) — runbook steps [P2-6, P6-5](36-commissioning-runbook.md) |
| 29 | Measurement calibration: factory accuracy (1.65 mm budget) + 626 CN thermal screen | measurement-analysis (`unresolved_source_checks:2`, `physical_calibration_qualified:false`); README:60; engineering/README:93–94 | PHYSICAL-ONLY — desk error-budget half **CLOSED 2026-09-16** ([docs/37](37-system-dynamics.md) §3, ledger §2.7; recomputed at the 2048 PPR encoder setting 2026-09-17 in [docs/42](42-process-dynamics-r2.md)) | 784 synthetic observations, 0 residual failures (numerical only); 626 CN leaves 0.5 µm with 10 K ΔT — not accepted with full js5 interference; docs/37 full-chain budget (R2 at 2048 PPR): 1.625 mm/m uncalibrated FAIL, ≈0.79 mm/m calibrated-at-allocations still FAIL vs ±0.70 mm/m — the 2048 PPR setting halves quantisation (0.0122 mm half-count, 0.025 mm allocation) but the process terms (slip 0.25, tension 0.15, 15–30 °C) still dominate and must be demonstrated by the 30-piece cells, not re-budgeted | Traceable calibration of the ifm E60137 200 mm circumference claim + actual index reference; separate 626 thermal/matching design or substitution; `--require-factory-accuracy` fails until then — runbook steps [P1-5, P6-7](36-commissioning-runbook.md) |
| 30 (axis) | R+W coupling interior clearance verification | docs/verification/feed-r6.md:46 | EXTERNAL-INQUIRY | "Original coupling interior clearance has not been verified from supplier CAD". 2026-09-16 re-fetch of the June-2026 MK2 datasheet (byte-identical to rw-mk2-datasheet-2026.pdf, SHA256 f6c663d7…; see mechanical-documents-findings.md §2) still does not dimension the bellows interior | Send letter [L2](35-purchase-enquiries.md) requesting the MK2/100/50/8/14 interior clearance CAD/data; verify interior clearance before hub installation |
| 31 | HIWIN KK8610P340A1F0 quote (article 10.00026, ×2) | docs/24 §2.2 | EXTERNAL-INQUIRY — **CLOSED 2026-09-16 (priced P→C substitution adopted)** — **re-scoped 2026-10-13 by audit F13** | 31-channel search found no public price; 2026-09-16: current HIWIN catalogue PS-11-1-EN-2605-K (2026-05-22) archived as hiwin-kk86-catalogue-2026.pdf confirms 340/440, lead 10, P class and the input shaft Ø8 h7 / 18 mm exposed; then the MISUMI VN catalogue API (api.vn.misumi-ec.com/api/v1/partNumber/search, seriesCode 221005545419, applicationId from the VN runtime config) returned the live shelf price of the genuine C-grade sibling **KK8610C-340A1-F0**: VND 21,146,653/unit (USD 824.72 converted, 2026-09-16), 23–99 days, caution "temporarily NOT available — ask MISUMI for next ship date". C-grade accuracy analysis: axial play 0.02 mm, expected repeatability ≈±0.01 mm — ~4× inside the ±0.20 mm strip target and the length is wheel-measured, so the P→C switch needs no CAD change; identical carriage/F0/Ø8 h7/340-440 mm interfaces. BOM AX-01 updated. **2026-10-13:** the HIWIN line is a **fallback purchase lead only** — the frozen build configuration is the custom axis [docs/39](39-custom-cut-axis.md) with SFU1610-class 10 mm lead / CL86T-V41 1000 pulses/rev / 100 pulses/mm (docs/39 §3, docs/31, BOM AX-S01) | Letter L1 resolved 2026-09-16 — no enquiry needed. Confirm the ship date at order time and verify C grade, lead 10 and the Ø8 h7 shaft at incoming inspection. Record in [axis-replacement-findings](../engineering/sources/axis-replacement-findings.md) |
| 32 | R+W MK2/100/50 quotes (10/12 ×2, 8/14 ×2) | docs/24 §2.2; engineering/sources/sourcing-findings-rw.md; engineering/sources/coupling-ring-replacement-findings.md | EXTERNAL-INQUIRY | Exact bores have no live price (23 channels; ebmia exact-bore searches re-run 2026-09-16 — still empty); live class anchor MK2/100/50/10/14 EUR 99.43 net/pc (ebmia.pl, 7–14 days) and 8/21,4 PLN 340.53 net (24 h); OD 40 × L 50 × hub 16 dims verified. 2026-09-16 replacement check: priced ebmia jaw couplings SBK19-8/14 (PLN 261.69–265.31 net) and SBK19-10/12 (PLN 217.85–221.47 net), D40 × L66, 32 Nm ≥ 8.5 Nm (torque PASS) were REJECTED: 0.5° backlash = 14 µm at 10 mm lead = 56% of the 25 µm positioning budget and 4.6× the ±3 µm repeatability, not closed by the motor-shaft encoder, plus L66/11 mm-hub geometry vs the 49–50 mm/16 mm stack; BKL3/10/12 bellows (PLN 130.38 gross, 24 h) is an undersized class (OD 25/L 32/hub 10); Conrad 403, automation24 404 | Send letter [L2](35-purchase-enquiries.md) with the ebmia order instruction (made-to-bore quote items at the class price; R+W direct fallback); confirm OD 40 × L 50 × hub 16; no substitute without a change record |
| 33 | Kübler measuring wheel 8.0000.3123.0006 ×2 quote | docs/24 §2.2 | EXTERNAL-INQUIRY — **CLOSED 2026-09-16 (priced substitution adopted)** | No public price; 100±0.1 mm circumference claim unverified until receipt. 2026-09-16 re-verified from the live kuebler.com `/pdf?Messrad_en.pdf` (byte-identical to kuebler-messrad-en.pdf): wheel No.123 natural rubber 60 Shore A, **Ø31.83 ±0.025**, 100 ±0.1 mm circumference, 6 mm (H7) bore, 9.5 tread / 14.5 overall, M4×6 ISO4029; not a stock type. Supplementary kuebler-messradsysteme-2025.pdf archived. No priced 100 mm-circumference wheel verified anywhere; substituted by **ifm E60137 "U:200 N:06"** (200 mm circumference, Ø63.66, Ø6 bore, PU 90 Shore A, 64.5 g), automation24 item 102756, **EUR 57.00 ex VAT**, in stock, dispatch next working day. The 200 mm substitution halves the PPR/mm ratio (0.048828 mm/count); CAD (wheel envelope, fork/bracket clearances, lug raised 15.915 mm), calibration constants, docs/13 and the controls nominal scale (20480 counts/m) were re-derived and all gates stay green | Letter L3 resolved 2026-09-16 — no enquiry needed. Verify the 200 mm claim and hub/screw detail at incoming inspection — runbook step [P0-4](36-commissioning-runbook.md). Record in [measurement-replacement-findings](../engineering/sources/measurement-replacement-findings.md) |
| 34 | Autonics E40S6-1024-6-L-5 ×2 quote | docs/24 §2.2 | EXTERNAL-INQUIRY — **CLOSED 2026-09-16 (priced substitution adopted)** | No public price observed. 2026-09-16: live product page + current EN product manual TCD210019AD 2025-07-21 (archived autonics-e40s-datasheet-2025.pdf) confirm Ø6 shaft (−0.004/−0.016), 1024 P/R, line driver A,Ā,B,B̄,Z,Z̄, 5 VDC ±5%, 3-M3 DP5 on PCD30, pilot Ø20 −0.021/0, body Ø40×31, shaft 15 + pilot 5; FLAG: shaft-tolerance and pilot-tolerance deltas vs shared/measurement_spec.hpp (see mechanical-documents-findings.md §4; spec.hpp not edited). Substituted by **ifm RU3100** (Ø6×10 shaft no flat, 1024 PPR factory TTL/HTL, 4.75–30 VDC, 1000 kHz, 12000 rpm, synchro flange 3×M4×0.7×6 PCD42, body Ø58.6×63.5), automation24 item 102717, **EUR 186.40 ex VAT**, in stock; M201 plate redesigned to R2 (60×60, Ø36.5 seat, 3×Ø4.5 PCD42, 4×M4 taps), coupling moved Y44→Y48, housing rear counterbores; J8/J9 line-receiver review CLOSED 2026-09-16 (TTL mode via IO-Link, single-ended A/B with a 2.5 V mid-bias on the AM26LV32EIDR − inputs, 120 Ω terminators not fitted; docs/22 §6/§7) | Letter L4 resolved 2026-09-16 — no enquiry needed. Confirm the synchro-flange centering feature at receipt. Record in [measurement-replacement-findings](../engineering/sources/measurement-replacement-findings.md) |
| 35 | Rittal SK3303.500 ×1 quote | docs/24 §2.2 | EXTERNAL-INQUIRY | Conrad listing observed EUR 1,669 incl VAT (merchandise only) | Send letter [L5](35-purchase-enquiries.md) to a Rittal distributor; confirm the 230 V 50 Hz variant |
| 36 | STEPPERONLINE CL57T-V41 ×2 / LE-350-36 ×1 | docs/24 §2.2 | EXTERNAL-INQUIRY | Exact strings have no live price (shop 403); class anchors: EUR 173.78 (amazon.de B0FYPDGC85), EUR 77.04 (B0HDN818SJ). 2026-09-16 made-in-china multi-search CL57T: 300 fuzzy results, no CL57T driver product on page 1 — no wholesale anchor | Send letter [L6](35-purchase-enquiries.md) to StepperOnline; record the shop price at purchase; class fallbacks documented |
| 37 | SEEGER-ORBIS A12 ×8 | docs/24 §2.2 | EXTERNAL-INQUIRY — **CLOSED 2026-09-16 (priced substitution adopted)** | Brand-exact has no live price on any channel; substituted by Wegertseder Art. 1950-010 DIN 471 12×1 Federstahl, 100 pcs EUR 8.57 incl VAT (EUR 0.086/pc), in stock, live-verified 2026-09-16; fit verified: d3 11.0 into groove Ø11.45±0.02 → seated spread ≈0.45 mm (always grips the groove bottom), axial float 0.10–0.20 mm (groove 1.10–1.14 vs ring 0.94–1.00), radial protrusion ≈0.72 mm; BOM TR-RR01 updated; evidence in coupling-ring-replacement-findings.md | No letter needed (L7 resolved); record receipt lot/certificate in incoming-inspection-template.csv at receipt |
| 38 | Schneider DF2CN02 10×38 fuse holder + prospective-fault coordination | docs/22 §11.3/§11.6; docs/24 §2.2 | EXTERNAL-INQUIRY — desk part **CLOSED 2026-09-16** | DF2CN02 observed EUR 55.99/10 (Conrad, 2026-09-16); holder identity CONFIRMED from the TeSys 2026 catalogue (B4/4, B4/10–11, archived schneider-tesys-deca-catalogue-2026.pdf): **DF101** — 1P DIN-rail 10×38 fuse carrier, Ith 32 A, Ui 690 V, IP20, 17.5 mm, padlockable (family DF101N/DF102/DF103, LED DF101V…DF103NV); price not_observed (no shop listing reached 2026-09-16, acceptable); recorded as the confirmed catalogue identity (CB-FUSE-HOLDER row, superseded) | Design keeps the priced 5×20 CB-XPS-FUSE solution (docs/22 §11.3); DF101 not reintroduced; verify prospective short-circuit coordination at commissioning |
| 39 | CT-PS36 6EP3332-7SB00-0AX0 + CT-IF-U1/U2-U3 identities | docs/24 §2.2 | EXTERNAL-INQUIRY | Identities per selected-controls.csv; no live-page price | Record the distributor page at order time; confirm USB-isolator/interface availability before the board order |
| 40 | Tunisia sous-douane landed-cost RFQ | docs/24 §2.2 (2026-09-16 step) | EXTERNAL-INQUIRY | No landed-cost comparison exists (merchandise observations only) | Send letter [L8](35-purchase-enquiries.md), the master RFQ with the complete quotation-register SKU list, to the sous-douane freight forwarder and two distributors shipping to Tunisia; require unit USD price, currency/payment terms, EXW/FOB, consolidation freight, handling, air/sea freight, destination charges, customs (DDU sous-douane), lead time, validity; record offers before ordering |
| 41 | EMC assessment | docs/22 §7/§8; docs/24 §6 | EXTERNAL-INQUIRY + PHYSICAL-ONLY | No EMC assessment exists | Enclosure/standards review of segregation, shield terminations and ducts, then an EMC assessment on the built cabinet by competent persons — runbook step [P5-9](36-commissioning-runbook.md) |
| 42 | Guard/payoff physical validation flags | mechanism status.json (`guard_door_kinematics_validated:false`, `guard_safety_function_validated:false`, `payoff_selection_complete:false`, `payoff_rotation_validated:false`) | PHYSICAL-ONLY | R2 CAD/checks pass; flags remain false | Physical build and validation per docs/26 §6 (rows 14–17 above) — runbook steps [P7-1…P7-4, P8-1…P8-6](36-commissioning-runbook.md) |
| 43 | Full-machine integration flags | mechanism/layout/head/feed-cassette status.json (`full_machine_integrated:false`, `fabrication_released:false`, `physical_results:false`) | PHYSICAL-ONLY | 504-occurrence R4 source exists; cabinet/safety not modelled | Assemble per docs/30/docs/31 and record; no flag flips without physical evidence — runbook steps [P0–P9, P10-7](36-commissioning-runbook.md) |
| 44 | Feed-shaft regional stress release | feed-fem/feed-fem-torus status (`numerical_gates_passed:false`); docs/24 §9 | DESK-CLOSABLE — desk part closed by docs/26+28 (submodel record) + gate 3 | All eleven regional rows converge 0.02–4.0% at ≤150 k nodes with Pilkey cross-checks (docs/28 §5); 13 gmsh/10 Netgen four-mesh rows preserved unaltered; centroid gates now PASS_SCOPED (gate 3) | Residual: `continuous_CAD_containment_verified:false` — the whole-shaft containment audit is now executed and reported (gate 3: 32 exterior / 0 on-boundary of 1,125,721 centroids, 2026-09-16); no fabrication release from FEM alone (docs/24 §10.6) |
| 45 | Resonance and structural audit (excitation inventory, mode separation, frame static check) | docs/40; docs/37 §2/§4; docs/39 §4 | PHYSICAL-ONLY — desk part **CLOSED 2026-09-17** (ledger §2.8); **audit F30 correction required** (tooth-pass 79.58 Hz class, modal mass/stiffness and sensor-bandwidth items) | Desk study [docs/40](40-resonance-and-structural-audit.md): 13 excitation families (tooth-pass 100/200/300 Hz; feed electrical 199 Hz, detent 796 Hz, step train 7.96 kHz; blade screw 2.5 Hz, ball-pass 75–100 Hz, detent 500 Hz; driver PWM unpublished — 20–50 kHz stated class band; mains 50 Hz cabinet-only); structural modes (frame sway 19–38 Hz, rail/bed composite 82–123 Hz, bed cross-span 245–368 Hz, cut-axis plate 98–352 Hz, F101 1.75/5.8 kHz, payoff 13.6–39.9 Hz, belt 378 Hz). Flagged <2× margins: bed mode vs tooth-pass 2×/3× and feed electrical (1.2–1.9×); cut-axis plate vs ball-pass/detent (1.4×); belt 3rd harmonic (1.26×, amplitude-weighted PASS). Fixes evaluated: belt tension rejected (pinned by slack-strand margin, +2.6% only), microstep documented-not-applied (no spec change), **elastomeric feet selected**, bed–rail damping pad (M10×40) and H005 rib conditional. Frame static: internal loop ≈20 µm < 0.05 mm target PASS ≈2.5×; 158 µm common-mode sway safe (2.3 MPa vs 235) and cut-irrelevant (wire referenced to the same bed) | Physical remainder: impact-test verification of the bed/rail/cut-axis-plate modes at commissioning — runbook step [P3-5](36-commissioning-runbook.md); blade-edge stiffness stays gate 13. **Audit F30 correction:** recompute tooth-pass kinematics from the actual pulley/roller radii (79.58 Hz class), reclothe modal mass/stiffness consistently, and state measurement bandwidth/sensor mounting before relying on the flagged margins — the desk numbers stay recorded unaltered until that rerun |
| 46 | External audit 2026-10-13 build-definition response (F13/F17/F33/F35/F41) | docs/41 R2; docs/39 §3; docs/31; bom/selected-cutting-head.csv; CMakePresets.json; docs/24 §1/§11 | DESK-CLOSABLE — desk parts **CLOSED 2026-10-13** | F13: one axis configuration frozen (SFU1610-class 10 mm lead, CL86T-V41 1000 pulses/rev, 100 pulses/mm = pulses_per_rev/lead_mm, matching the firmware source of truth `pulses_per_revolution=1000`/`lead=10`/`steps_per_mm=100`); the 400/800/2000 mixtures removed from docs/39 §3 and docs/31; AX-S01 text updated. F17: docs/31 quantities regenerated from the BOMs/manifests (F101 ×8, rotor parts ×8, F111 ×2, 626-2Z ×10, SWU10.5-35 ×2, second measuring module build detail, source per count stated; correct 5 V/3 A Siemens identity mirrored, phantom `6EP3332-7SB00-0AX0` pairing removed). F33: per-axis driver direction/encoder-sign freeze added to docs/31/39 with runbook P6-1/P6-7 pointer. F35: historical-authority lists in docs/24 §1 and docs/33; CMakePresets.json made portable (no hard-coded Homebrew compiler paths — CC/CXX pass-through), docs/24 §11 toolchain/reproducibility section added. F41: [docs/41](41-goal-traceability-matrix.md) R2 carries the audit's BLOCKED/DESK-ONLY/UNPROVEN verdicts for goals 1–40 plus added goals 41–47; no verdict softened | Remaining (audit F01–F35, staged gates A–D): all deterministic hardware/software fixes (F01–F12), custom-axis manufacturable assembly and original acceptance loads (F14/F15), process/thermal/electrical redesign closures (F18–F32), third-party endurance/serviceability qualification (F31), and every physical/vendor step already listed in this ledger; nothing here releases fabrication or energisation |

## 2. Desk closures recorded in this ledger

### 2.1 Housing/collar key contact — desk part (gate 1)

[Study](../engineering/generated/collar-contact/report.md),
[status](../engineering/generated/collar-contact/status.json),
[source](../engineering/src/collar_contact.cpp),
[header](../engineering/include/collar_contact.hpp),
[test](../engineering/tests/test_collar_contact.cpp) (CTests
`collar_contact_benchmarks`, `collar_contact_report`). Local linear FEM
(OpenCASCADE solid → STEP → gmsh, ≤35,406 nodes, CHOLMOD/simplex direct
solve): Ø10 × 60 mm shaft section, DIN 6885 t1=1.8 mm seat (R0.15 floor
blends), key bonded, rigid collar as resolved pressures (clamp: ±x̂ traction
on two 90° arcs over the 20 mm width ≈ 7 kN total; torque: +x̂ 1000 N on the
protruding key side face reacted on the rear 120° bore arc), fixed end z=60.
Numbers: 3×3×20 → contact 44.6 MPa FEM (41.67 ideal), shear 16.67 MPa,
seat bearing 27.78 MPa, key peak vm 151.6 MPa; 3×4×18 (F109) → contact
26.2 MPa (25.25 ideal), shear 18.52 MPa, seat bearing 30.86 MPa, key peak vm
164.2 MPa; clamp-only key peak ≈20 MPa. Verdict **PASS** against the C45
allowables (bearing 120, shear 180 MPa) for both identities; the F109
3×4×18 configuration is the endorsed selection (aluminium collar-wall
bearing 43.3 MPa limit: 1.66× margin; the DIN 3×3×20 identity leaves ≈1.0×).
Physical part unchanged (gate 1 closure action).

### 2.2 Fastener preload/torque desk values (gate 4)

T = K·F·d with K=0.2 (dry zinc-plated steel, ISO 16047 range 0.15–0.25):

| Joint | Fastener | Recommended torque | Preload | Utilisation of proof load |
|---|---|---|---|---|
| H003 adapter / motor (M5×16 and M5×25, class 10.9) | A_s=14.2 mm², proof ≈11.8 kN | 6 Nm | 7.5 kN | 64% (matches the adapter FEM's 8.0 kN F0 = 60% screen order) |
| F108 roller retaining (M5×16, class 10.9) | A_s=14.2 mm², proof ≈11.8 kN | 6 Nm | 7.5 kN | 64% |
| Bed F301 (M10×35 class 8.8 into DIN 929 nuts) | A_s=58 mm², proof ≈33.6 kN | 47 Nm (docs/31:164) | 23.5 kN | 70% |
| Payoff spindle M20 nut | — | finger-tight + supplier spec (docs/31:164) | — | — |

These are desk torque-to-preload conversions, not assembly authorisations:
apply and record the actual torque values in the production build record at
assembly.

### 2.3 Roller key identity reconciliation (gate 5)

docs/28 §2.3 computes the UMCL roller key shear as "τ = 1000/(3·20) =
16.7 MPa" (a 3×3×20 key). The authoritative part record is docs/12:109
F109 = **3×4×18** C45+N (width 2.975–3.000, height 3.950–4.000, length
17.90–18.00, R1.5 ends, 0.2×45° shaft-facing chamfer), matching
catalogue-evidence "3×4×18 mm positive key" and the 2.35 mm-deep collar
keyway (protrusion 2.2 mm + 0.15 mm top clearance). The collar-contact
study (gate 1) evaluated both identities; both pass, F109 governs. The
slip is recorded here; docs/28 is left unedited.

### 2.4 Measuring-wheel set-screw torque desk value (gate 6)

Wheel-to-shaft clamping: the ifm E60137 datasheet does not publish the hub
screw detail, so the previous Kübler desk value **2.0 Nm** (M4 cone-point
practice range 1.5–2.5 Nm into a shaft flat; retention/torque connection,
not a clamping joint) is retained only as a placeholder for an equivalent
M4 clamp. Confirm the ifm hub geometry at incoming inspection and record the
applied torque in the build record; the supplier's value governs if
provided.

### 2.5 Bearing/housing compliance and thermal field — desk parts (gate 10)

[Study](../engineering/generated/bearing-contact-thermal/report.md),
[status](../engineering/generated/bearing-contact-thermal/status.json),
[source](../engineering/src/bearing_contact_thermal.cpp),
[header](../engineering/include/bearing_contact_thermal.hpp),
[test](../engineering/tests/test_bearing_contact_thermal.cpp) (CTests
`bearing_contact_thermal_benchmarks`, `bearing_contact_thermal_report`).
Local linear FEM (OCC solid → STEP → gmsh, 22,407 / 8,914 nodes, ≤150,000
cap; resolved-pressure contact in the collar_contact.cpp pattern; scalar
steady-state conduction solve).

**Study 1 (housing compliance, PASS):** the Ø15 seat + 6002 rings + F112
block are meshed with stated surface stand-ins (Ø14.995 seat, Ø15.2
ring-bore, Ø32.3 bore) so the near-coincident conforming surfaces stay
separable for the resolved-pressure patches; the 6 µm matched interference
(record window 3–6 µm, worst case) is applied as a Lamé resolved pressure
(24 radial sectors) with a stated 35 N/µm balls+bore chain support
(sensitivity ×0.5/×2). The fit record's housing value is an **8–28 µm
diametral clearance** (F112 bore 32.008–32.019 vs 6002 OD 32.000/−0.009;
minimum thermal residual 2.432 µm) — there is **no housing interference in
the record** (the task reading "K6-class housing interference" conflicts
with the record's +8/+19 µm bore; the record governs), so the housing
carries 0 MPa fit pressure. Numbers: seat contact pressure 17.65 MPa; seat
peak vm 22.73 vs 650 MPa (42CrMo4+QT); ring peak vm 82.26 vs ≈1700 MPa
(hardened 100Cr6); housing bore-wall peak vm 0.98 vs 260 MPa (6082-T6)
under the resolved 310 N front-bearing resultant. The compliant chain
changes the load-induced seat stress by 91.9 % relative to the four-mesh
rigid-boundary peak (4.28 → 0.35 MPa), but only **3.9 MPa absolute** — the
seat stress is dominated by the shrink fit, not by housing compliance.

**Study 2 (thermal field, HOLD):** steady-state conduction FEM of the F101
front half (S31.5–113): 30 W standstill motor holding loss (24HS40
2·5²·0.6, docs/28 §2.5) applied uniformly on the Ø14 pulley-seat surface,
k = 42.7 W/mK, h = 10 W/m²K still-air convection on exposed surfaces,
front bearing seat as a stated 2800 W/m²K conduction path to the 25 °C
housing (series chain ≈1.2 W/K), roller surfaces pinned at 25 °C, rear cut
face insulated (upper bound: all 30 W flows forward). Front-seat rise
**29.66 K (max) / 19.98 K (mean)** vs the fit record's explicit 20 K
shaft-above-housing envelope → **not met** at the central stated
conductance (sensitivity 15.5 / 51.7 K at 8000 / 1000 W/m²K). The desk FEM
does not robustly demonstrate the envelope for the prescribed worst-case
bound; the instrumented cold-start/hot-run test (docs/12:38) and the
measured motor-case temperature remain the required closure. The S5M belt
thermal break and the rear-half conduction path are stated mitigations,
not used to relax the number. `thermal_field_verified` stays false.

### 2.6 Fatigue S-N, fault LCF, bearing L10 and fretting — desk halves (gate 11 + bearing-life assessment)

[docs/38](38-fatigue-and-life.md). Desk study; nothing releases fabrication.

**Shaft fatigue (F101, gate 11 desk half):** duty 8 h/day × 30 cuts/min ×
250 d/yr × 5 yr = 10,000 h, ≈1.8×10⁷ cuts, ≈2–6×10⁸ alternating cycles
(roller Ø20, 20–32 rev/cut) — an endurance-limit regime. Working basis:
whole-shaft bound **76.6 MPa** (feed-fem; torus 74.7) and the converged
regional peaks from docs/28 §5 — worst working regional **60.4 MPa** (M15
washer-slot corner, netgen; bound 63.5), roller shoulder 45.2, roller key
floor 43.0, pulley slot-lip 37.1. Material σ_w = **400–450 MPa** notched-bar
(42CrMo4 V, FKM-Richtlinie σ_w,zd ≈ 398 MPa at Rm ≈ 1000 MPa; 0.4–0.5·Rm
rule); Kt 1.5–2 stated (Pilkey) plus the record's computed 2.534–2.586 at
the R0.2 runouts (docs/28 §6); surface 0.85, size 0.97. **n_f = 2.9/3.2 at
Kt 1.5, 2.2/2.4 at Kt 2.0, 1.7/1.9 at Kt 2.6 (σ_w 400/450); 5.5 against the
converged worst regional peak (no re-Kt).** Verdict: desk PASS — infinite
life at design duty; the physical rotating-fatigue test remains.

**Fault LCF (5 Nm, 1000 cycles):** fault bounds 158.2 (feed-fem) /
165.0 MPa (torus) vs 650 MPa yield → 3.9–4.1× elastic margin, no
yielding/ratcheting; even double-counting Kt = 2.6 on the converged peak
gives ≈429 MPa ≈ 1.07·σ_w → 1000 cycles ≈0.14 % damage at S-N slope 5.
Fatigue-benign.

**Bearing L10 (ISO 281, P = Fr):** 6001-2Z/C3 rear P 400 N (feed-analysis
321.2 N + 75 N nip) at 260 rpm → **1.6×10⁵ h**; 6002-2Z/C3 front P 390 N →
**2.2×10⁵ h**; 626-2Z wheel shaft P 19 N (docs/20 6–19 N cell) at 150 rpm →
**2.1×10⁸ h**; 6204-2Z/C3 payoff P 294 N (≤60 kg total ÷ 2; 589 N at the
docs/26 "≤60 kg half-load" reading → 1.3×10⁶ h) at ≤160 rpm → **1.0×10⁷ h**.
Target 20,000 h set in docs/38 (2× the 10,000 h duty; SKF 8 h-service
guidance) — all pass, minimum margin **7.9×** (6001); at the 478 rpm implied
by 0.5 m/s feed the 6001 still clears at 8.6×10⁴ h (4.3×). Key/collar
fretting (gate 1 numbers, qualitative): fault key force 1000 N vs
μN ≈ 1050 N clamp-friction capacity → fault-level micro-slip expected,
working margin ≈5×; the aluminium collar wall is the consumable fretting
interface; belt proof + incoming measurement unchanged. A12 ring: static
axial locator, no torque path, benign. Blade pair: literature order
10⁵–10⁷ cuts per edge set (Kalpakjian & Schmid, blanking tool life for soft
metals) vs the ≈1.8×10⁷-cut duty → consumable with scheduled regrind;
physical edge qualification (gate 13) is the gate.

### 2.7 Whole-machine dynamics, belt dynamics and error budget — desk halves (gates 11, 12, 29)

[docs/37](37-system-dynamics.md). Desk study; nothing releases fabrication.

- **Feed drive sizing (gate 12 context):** reflected inertia **4.35e-4 kg·m²**
  per cassette motor (rotor 1.08e-4 + coupling 1.6e-5 assumed + 2 shafts
  4.5e-6 + 2 pulleys 9.8e-6 + 2 rollers 2.8e-5 + belt 4.8e-6 + worst-case
  wire 2.21e-4 kg·m² — 3 m part + 880 mm route of Ø4.5 mm Cu). Peak demand
  1.0 Nm envelope + J·75 rad/s² = **1.03 Nm at 239 rpm**; **2.58 Nm** with
  the 2.5 reversal factor. Belt capacity 10.89 Nm → 4.36×. Motor curve
  (24HS40, ≈4.4 Nm low speed) at 239 rpm is **not digitised**; the assumed
  60–70 % band gives 2.5–3.0× unfactored margin but only **1.01–1.20×** if
  the 2.5 factor is applied to the motor — digitise the curve at 200–300 rpm
  before release.
- **Belt dynamics:** S5M 25 mm unit mass 85 g/m (MISUMI 34 g/m per 10 mm
  width); first strand mode **378 Hz at 190 N** (368–388 Hz across the
  180–200 N acceptance) vs 100 Hz tooth-passing at 500 mm/s → 3.8×
  separation; slack strand stays 22.9 N > 0 at the 5 Nm fault.
- **Head axes:** blade force estimate 700–1200 N (guillotine shear bound
  2.15–2.62 kN on Ø4.5 mm Cu at τ 135–165 MPa × 0.3–0.5 stated V-wedge
  factor); KK86 2.79 Nm input cap → 1578 N thrust, motor 3381 N at 0.8×
  curve — PASS; the 2500 N `working_thrust_n` is an externally applied
  acceptance load, not a drive demand. Holder H004 deflection ≈4 µm;
  blade-edge stiffness is a purchase-drawing requirement (gate 13).
- **Measuring-chain budget (gate 29 desk half):** 1.65 mm/m uncalibrated
  (FAIL), ≈0.80 mm/m calibrated-at-allocations (FAIL vs ±0.70 mm/m) in the R1
  record; the 2026-09-17 2048 PPR encoder setting recomputes these to
  **1.625 mm/m uncalibrated and ≈0.79 mm/m calibrated-at-allocations**
  ([docs/42](42-process-dynamics-r2.md) §1) — the quantisation allocation
  halves to 0.025 mm, but the constant process allocations (slip 0.25,
  tension 0.15 mm) still dominate short lengths and must be demonstrated,
  not re-budgeted.
- **Payoff/feed guidance:** nip traction 2·μ·N = 40–90 N per nip
  (μ 0.4–0.6 stated), 80–180 N two-nip; payoff brake 5–20 N; wire accel
  demand 0.83 N. R2 adds the full-spool dynamics and the brake setting table
  ([docs/42](42-process-dynamics-r2.md) §4): spool accel demand 22.5 N at
  30 kg/1.5 m/s², max allowed brake torque 7.3–10.9 Nm by spool mass, and
  the E-stop coast/guard-travel bound (§3 there).
- **R2 process-dynamics record ([docs/42](42-process-dynamics-r2.md),
  2026-09-17):** closed-loop stepper step response modelled at a stated
  25 Hz position-loop bandwidth (settling ≈28 ms, overshoot ≈0.15 %,
  feed tracking lag ≈0.06 mm at 1.5 m/s²); worst-case E-stop from 500 mm/s
  at the 2.58 Nm factored envelope stops in 1.05 mm / 4.2 ms with a 254.5 N
  belt strand peak; contactor-open coast bounds are 93–324 mm and require
  the payoff brake ≥≈6.5 N to stay inside the guard travel. All numbers are
  desk models with stated assumptions; the physical gates they feed (12, 14,
  16, 23, 29) are unchanged.

### 2.8 Resonance and structural audit — desk part (gate 45)

[docs/40](40-resonance-and-structural-audit.md). Desk study; nothing releases
fabrication.

- **Excitation inventory:** belt tooth-pass 100 Hz (2×/3×: 200/300 Hz) at
  500 mm/s; feed-motor electrical 50×f_rev = 199 Hz, detent ripple 4×
  electrical = 796 Hz, step train 2000×f_rev = 7.96 kHz (f_rev = 3.979 rev/s
  = 238.7 rpm; the working brief's "25 rev/s" corrected to 25 rad/s); blade
  screw 2.5 Hz at 150 rpm, ball-pass 75–100 Hz (30–40 balls stated), 34E1K
  electrical 125 Hz / detent 500 Hz, command 1250 Hz; driver PWM not
  published in the archived CL57T/CL86T datasheets (20–50 kHz stated class
  band); mains 50 Hz cabinet-only; wheel 2.5 Hz; spool 0.40 Hz.
- **Structural modes (formulas stated in docs/40 §2):** frame sway 19–38 Hz
  (4×12EI/L³, 150 kg top mass); rail/bed composite 82–123 Hz
  ((π/2L²)√(EI/μ)); bed cross-span 245–368 Hz ((π/2L²)√(D/(ρh))); cut-axis
  plate 98–352 Hz (loaded by the ≈16 kg carriage); F101 1.75 kHz roller
  overhang / 5.8 kHz pulley span (Rayleigh/Dunkerley); payoff spindle
  13.6–39.9 Hz; belt 378 Hz (docs/37).
- **Separation (target ≥2×):** PASS — sway ≥7.6×, F101 ≥4.5×, payoff ≥34×,
  screw whirl 17.3×. **FLAG:** bed mode vs tooth-pass 2×/3× and the 199 Hz
  electrical line (1.2–1.9×); cut-axis plate vs ball-pass 75–100 Hz and
  500 Hz detent (1.4×); belt 3rd harmonic 1.26× (amplitude-weighted PASS).
  Fixes selected: elastomeric feet + commissioning impact test (mandatory);
  bed–rail damping pad with M10×40 and an H005 stiffening rib are
  pre-approved contingencies (not CAD changes yet); belt stays at 190 N;
  microstep change documented, not applied.
- **Frame static (1200 N blade):** leg sway 141 µm, rail composite 13.4 µm,
  holder 4 µm → ≈158 µm common-mode; the balanced opposed-blade cut and the
  bed-referenced wire loop reduce the cut-point-relative deflection to
  ≈20 µm < 0.05 mm target (PASS ≈2.5×); leg stress 2.3 MPa vs 235 MPa
  (≈100×). Blade-edge stiffness remains gate 13.
- **Physical remainder:** impact-test verification (runbook P3-5) — bed mode
  ≥2× from the 199/200/300 Hz lines and cut-axis plate ≥2× from 500 Hz at
  the commissioning feed, recorded in the build record.

## 3. Counts

- DESK-CLOSABLE rows: 9 (gates 1, 3–7, 22, 44, 46). Desk part now closed and
  recorded in §2: 6 (gates 1, 3, 4, 5, 6, 44); in progress in parallel
  workstreams: 1 (gate 22); open desk item requiring a released procedure
  document: 1 (gate 7); audit-response desk parts closed 2026-10-13: 1
  (gate 46). In addition, the desk parts of the PHYSICAL-ONLY
  gates 10 (housing compliance + thermal field, §2.5), 11 (fatigue S-N,
  §2.6), 11/12/29 (whole-machine dynamics, belt dynamics and
  measuring-chain error budget, §2.7) and 45 (resonance and structural
  audit, §2.8) are closed and recorded; all remain
  PHYSICAL-ONLY because their remaining actions are the physical build
  measurements, instrumented tests and traceable calibration.
- PHYSICAL-ONLY rows: 20 (gates 2, 8–12, 14, 16–18, 23–29, 42, 43, 45).
- EXTERNAL-INQUIRY rows: 17 (gates 13, 15, 19, 20, 21, 30–41).
- Mixed rows counted by their governing remaining action: gates 2, 13, 21
  and 41 count as PHYSICAL-ONLY/EXTERNAL-INQUIRY as listed above.
- Total open rows: 46. CLOSED rows: 0 (no gate is fully closed — every
  closed desk part retains its physical/enquiry step).

Every row above keeps the original acceptance criteria unchanged; no raw
failed data was deleted and no gate was closed by relaxing a number.

- 2026-09-17: cut-axis gates (HIWIN price/enquiry rows 30–37 axis lines, L1) RESOLVED by the custom-axis design [docs/39](39-custom-cut-axis.md): components priced (US$8–13 + US$5–10 FOB lines), interfaces reproduce the KK86 envelope (CAD/FEM unchanged), physics verified; HIWIN eBay/MISUMI leads retained as fallbacks. Physical remainder: run-in and repeatability record (docs/39 §5).
- 2026-09-17: resonance and structural audit [docs/40](40-resonance-and-structural-audit.md) desk part CLOSED (ledger §2.8, gate 45): excitation inventory, mode separation and frame static check complete; flagged margins (bed 245–368 Hz vs 199/200/300 Hz lines; cut-axis plate vs ball-pass/detent) get elastomeric feet + the mandatory commissioning impact test (runbook P3-5), with the bed–rail damping pad (M10×40) and H005 rib as pre-approved contingencies.
- 2026-10-13: external audit response recorded (gate 46): one axis configuration frozen — SFU1610-class **10 mm lead**, CL86T-V41 at **1000 pulses/rev**, **100 pulses/mm = pulses_per_rev/lead_mm**, matching the firmware source of truth (`shared/cutting_head_spec.hpp` `pulses_per_revolution=1000`, `lead=10`, `steps_per_mm=100`; `blade_steps_per_mm` in shared/controls_spec.hpp used by `software/machine/core/controller.cpp`); 400/800/2000 mixtures removed (docs/39 §3, docs/31, AX-S01). docs/31 quantities regenerated from BOMs/manifests (F101 ×8, rotor parts ×8, F111 ×2, 626-2Z ×10, SWU10.5-35 ×2, second measuring module detail; per-count sources stated) and the 5 V/3 A Siemens identity mirrored (phantom `6EP3332-7SB00-0AX0` removed). Per-axis direction/encoder-sign freeze added with runbook P6-1/P6-7 pointers. Historical-authority lists added (docs/24 §1, this ledger); CMakePresets.json made portable and docs/24 §11 records the pinned/unpinned toolchain state. [docs/41](41-goal-traceability-matrix.md) R2 now carries the audit's re-verdicts: across the 47 goals (40 original + 7 added), 25 rows carry BLOCKED, 12 DESK ONLY, 20 UNPROVEN (combined verdicts overlap), 1 PARTLY MET/BLOCKED; no row is MET.
