sbelakho2/Cutting/engineering/generated/drawings/F101-R6-details.pdf

# STARZ ELECTRONICS

## F101 — SLOT / END MACHINING DETAILS · R6 · SHEET2/2

## ENGINEERING DRAWING — RELEASE HOLD

Units mm · A3 · Do not scale dimensions

S31.20

S33.45 | S61.55

S73.00

POCKET TOOL SECTION Z6.20 / 5-1 · S increases right

Near/far intersection coordinates are REF;nominal key circles R2.52,centres S35.97/59.03.

MB2 slot: W4.20±0.05

Start S31.20±0.02;end S73.00±0.02

Four plan corners R0.50±0.02

Four vertical key intersections R0.50±0.02

All slot floor/lip blends R0.15±0.02

Floor Z5.50±0.05;key floor Z4.00±0.02

Do not round the key's straight load flanks

End0.00–0.04 before actual Ø15 seat start

Fit MB2 before the pulley key

Rear entry is interrupted by the Ø12 land

4.20 ±0.05

S70 LOCAL FLOOR SECTION / 10-1

Z5.50±0.05 · R0.15±0.02 both roots

END / THREAD / FINISH REQUIREMENTS

S0 and S113 external edges: 0.20±0.02×45°.

M15 lead at S64.50: 0.50±0.02×45°;full profile S65.10–71.30.

M5 entry: C0.20±0.02,independent of the external end chamfer.

Final slot/key machining precedes matched journal finishing.

Remove raised lips;edge break0.05–0.10 on remaining slot openings.

Do not touch bearing-seat lands or dimensional key load flanks.

INSPECT: optical profile/replica of slot roots and intersections;slot start/end/width/depth;end chamfers;thread GO/NO-GO and full depth.

SECTION AUDIT-191 nominal B-rep sections compared against the reduced beam I;this does not resolve local peak stress or fatigue.

Angular C:pulley-key radial midplane,+Z toward opening. Roller key180°±0.10°;MB2 slot median offset≤0.025 to C.

RELEASE HOLD: local stress/contact,joint preload and operating thermal field. No machining or physical inspection result is prefilled.

## PART F101 · FEED ROTOR · DETAIL SHEET

S1-B-FEED-R6-2026-09-12

SCALES5-1 /10-1 · SHEET2 OF2

All unspecified axial coordinates ±0.02 · do not scale
