sbelakho2/Cutting/engineering/generated/drawings/F101-R6-shaft.pdf

# STARZ ELECTRONICS

## F101 — FEED ROTOR SHAFT / R6 · SHEET1/2

## ENGINEERING DRAWING — RELEASE HOLD

Units mm · A3 · Do not scale dimensions

113.00 ±0.02

SIDE VIEW / 2)1 · S from rear end · small root radii per callouts

S interval Diameter / thread

0–18.5 Ø12 h6

18.5–19.62 groove Ø11.45 ±0.02

19.62–31.5 Ø12 matched j5

31.5–64.5 Ø14 h6

64.5–71.5 M15×1-6g

71.5–73 relief Ø13.50 ±0.02

73–82 Ø15 matched j5

82–87 Ø19 ±0.02

87–92 Ø12 −0.02/0

92–113 Ø10 h6

DATUM A: common bearing-seat axis. DATUM B: front bearing shoulder S82.

Bearing seats: j5 −0.003/+0.005 AND 0.003–0.006 actual interference to assigned SKF P6 bore.

12 h6 /14 h6: −0.011/0;10 h6: −0.009/0. Match-bearing table governs final seat diameters.

Bearing-seat cylindricity0.001,total radial runout0.002 to A;B perpendicularity0.004 to A.

Ø14/Ø10 total runout0.010 to A. Bearing seats Ra0.4µm;roller/coupling0.8µm;other surfaces3.2µm.

PULLEY KEY: S33.45–61.55,L28.10±0.02,W5.04±0.01,on+Z;floorZ4.00±0.02;endsR2.52.

ROLLER KEY: S94.45–112.55,L18.10±0.02,W3.04±0.01,on−Z;floorZ−3.20±0.02;endsR1.52.

Both key-floor perimeters R0.15±0.02;matching keys:shaft-facing perimeter0.20±0.02×45°.

MB2 SLOT: S31.20–73.00,W4.20±0.05,on+Z;floorZ5.50±0.05;R0.50plan/intersections,R0.15floor. See sheet2.

GROOVE: S18.50±0.02,W1.12±0.02,Ø11.45±0.02;both rootsR0.04±0.01;SEEGER A12.

SHOULDERS: S31.5/S82/S92 R0.20±0.02;S87 R0.50±0.05;M15 relief rootsR0.20±0.02.

END TAP: M5×0.8-6H,14.00–14.05full thread AFTER C0.20±0.02;drillØ4.20+0.03/0×18.00±0.05 PLUS118°±2° point.

Material42CrMo4+QT,certified yield≥650MPa;rough stockØ20×120;quantity8. General axial coordinates±0.02.

ENDS: external C0.20±0.02 at S0/S113;M15 lead C0.50±0.02. Full-profile M15 thread required over S65.10–71.30.

ASSEMBLY: fit MB2 BEFORE pulley key. Keep F112 removable;insert preassembled rotor from+S with locating dowels removed.

RELEASE HOLD: local stress/contact,thermal-field validation and joint preload. R6 edge geometry is defined on both sheets.

## PART F101 · FEED ROTOR · SHAFT

S1-B-FEED-R6-2026-09-12

SCALE2)1 / DIMENSION RECORD / NO RELEASE STAMP

Companion: feed cartridge assembly and bearing matching record
