sbelakho2/Cutting/engineering/generated/drawings/G101-G106-R2-guard-panels.pdf

# STARZ ELECTRONICS

## G101–G106 — GUARD PANELS AND DOOR / R2

## ENGINEERING DRAWING — RELEASE HOLD

Units mm · A3 · Do not scale dimensions

Ø30 WIRE
PASS-THROUGH

LEFT/RIGHT SIDE: 690 × 315 × 2, APERTURE Ø30 AT X±(345..347), Y0, Z112

Side/rear/roof panels: DC01 2 mm, powder-coat RAL7035,edges deburred, radiused C2 on

exposed corners. Rear 690 × 315 × 2;roof 690 × 1250 × 2. Mounting:M6×12 8.8 at ≤200 pitch

into rivet nuts;pass-through edge guarded with split grommet (purchase-to-requirement).

FRONT DOOR (G105): clear polycarbonate 5 mm,

690 × 315, in a 20×20×2 S235JR tube frame;

door weight ≈ panel 1.2 kg/m² × 0.217 m²

+ frame;two hinges rated ≥15 kg total,

zinc-plated (purchase-to-requirement);

ACF-1 actuator mounted to the door,

SLC body on the G106 jamb plate.

LOCK PLATE (G106): S235JR 5 mm, 60 × 55,

welded to the door jamb;body pocket

30×192×44 +0.5 clearance per CAD;the SLC

drilling pattern REQUIRES the Bernstein

mounting drawing — do not drill from the

envelope (docs/26 §2).

PROCESS: laser/brake;powder-coat after bending;mount rivet nuts;glaze door with mechanical fixing + seal.

INSPECT: panel flatness, coating, aperture position, door weight, hinge alignment, actuator/lock alignment by

physical fit. ASSEMBLY: hang door, verify 0.5 mm CAD clearance class and locking travel physically.

## PARTS G101–G106 · GUARD SET

S1-B-MECH-R4-2026-09-16

DIMENSION RECORD

RELEASE HOLD: risk assessment,safety distances,aperture;not fabricated
