sbelakho2/Cutting/engineering/generated/drawings/H003-R6-adapter.pdf

# STARZ ELECTRONICS

## H003 — CUTTING MOTOR ADAPTER / R6

## ENGINEERING DRAWING — RELEASE HOLD

Units mm · A3 · Do not scale dimensions

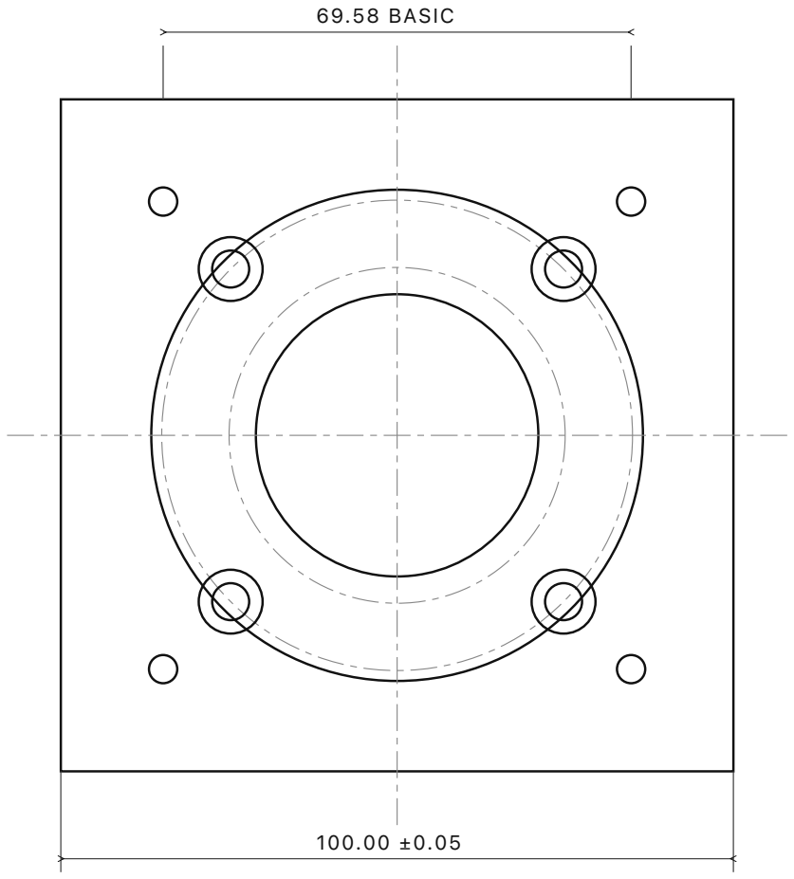
[picture p3: figure]
69.58 BASIC

MOTOR-SIDE VIEW / 1.1

4 × M5×0.8-6H THRU; square69.58 BASIC; position Ø0.10 to A|B|C

4 × Ø5.50 +0.10/0 THRU on PCD70 BASIC,45° quadrants

Counterbore Ø9.50 +0.10/0 ×8.50 ±0.05 deep FROM MOTOR FACE

Pilot pocket Ø73.10 +0.02/0 ×2.10 ±0.02 deep;central Ø42.00 +0.10/0

15.00 ±0.02

AXIAL SECTION / 1.1

DATUM A: F0 mounting face

DATUM B: Ø49.97 F0 register axis

DATUM C: left edge X−50 in this view

F0 boss: Ø49.97 ±0.01 ×2.00 ±0.02

A flatness0.01;motor face parallel0.01 to A

Pilot pocket position Ø0.03 to A|B

Mounting/pilot surfaces Ra0.8µm

Other machined surfaces Ra3.2µm

Material42CrMo4+QT,min650MPa yield

Rough stock105×105×20;quantity2

No paint/plating on locating or joint faces

General edges0.2×45°;remove all burrs

Do not countersink screw bearing seats

F0.4 ×ISO4762 M5×16,class10.9

withISO7092 M5 washers Ø9×1,200HV

Motor:4 ×M5×25,class10.9,same washers

Counterbore depth clears the motor pilot

Old5.5mm recess FAILS screw-head collision

Joint preload and peak convergence open

PROCESS: rough all features;finish A and motor face in controlled setups;finish concentric registers;drill/tap;deburr;inspect.

INSPECT: thickness at4corners;A/face flatness;both register diameters;pilot depth;counterbore depths;hole position;M5thread gauges.

ASSEMBLY: remove motor key;use actual free-length coupling;set stage hub1.00±0.05from locknut shoulder;do not stretch bellows.

Release hold: updated adapter stress/convergence,joint/thread checks,and remaining full-machine integration. Drawing is not a release stamp.

## PART H003 · ADAPTER · SINGLE SELECTED DESIGN

S1-B-KK86-R6-2026-09-12

SCALE1.1 / THIRD-ANGLE FRONT + AXIAL SECTION

SOURCE: shared cutting_head_spec and catalogue evidence
