sbelakho2/Cutting/engineering/sources/24HS40-5004D-E1000-drawing.png

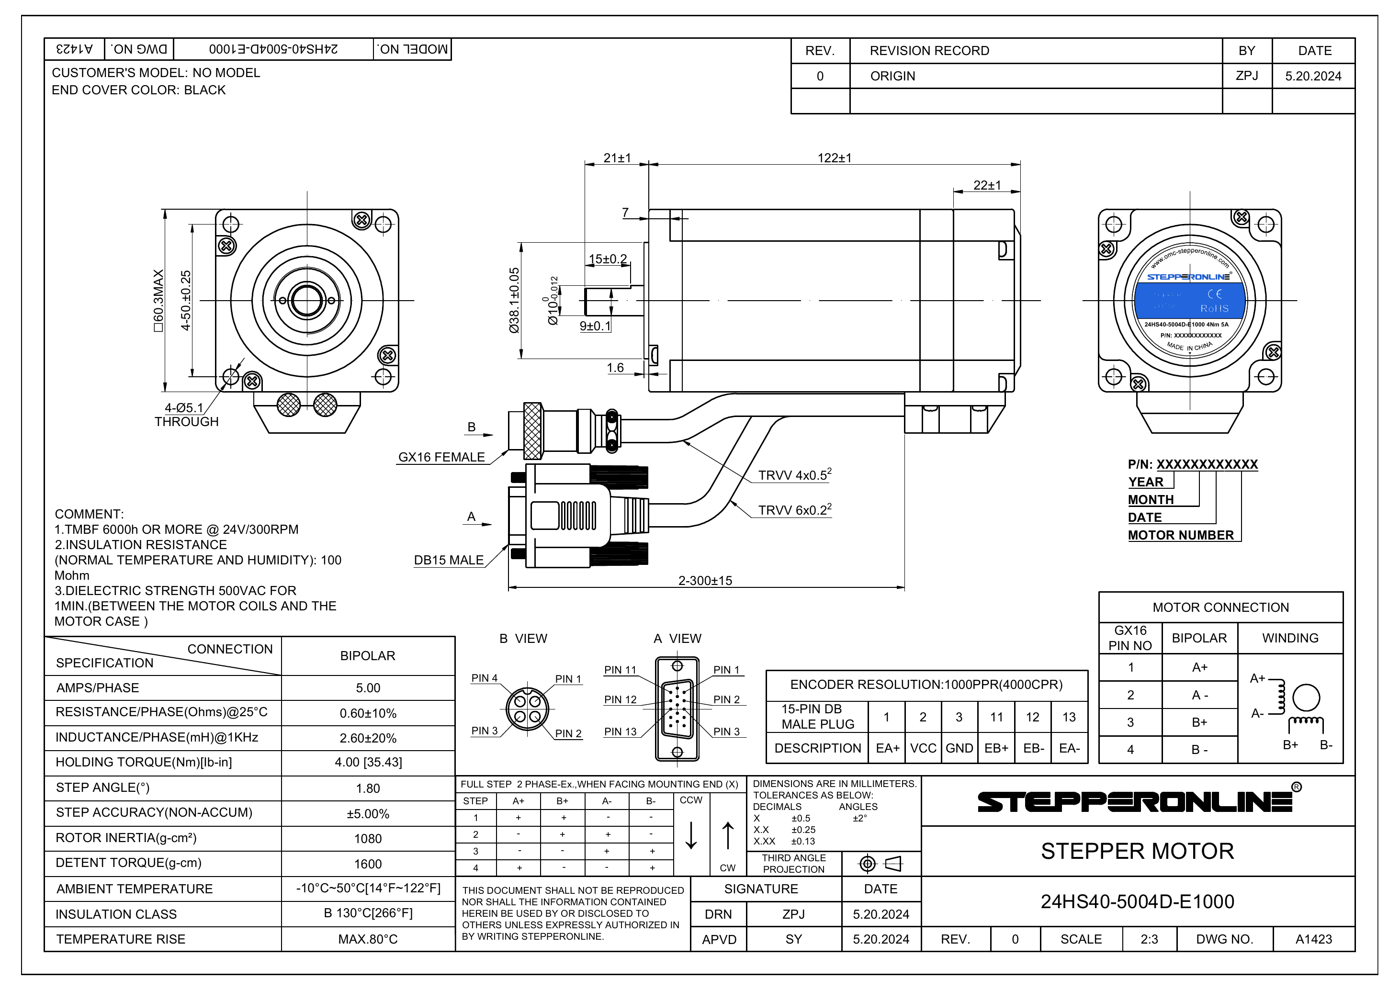
engineering/sources/24HS40-5004D-E1000-drawing.png
