sbelakho2/Cutting/engineering/sources/24HS40-5004D-E1000-torque.png

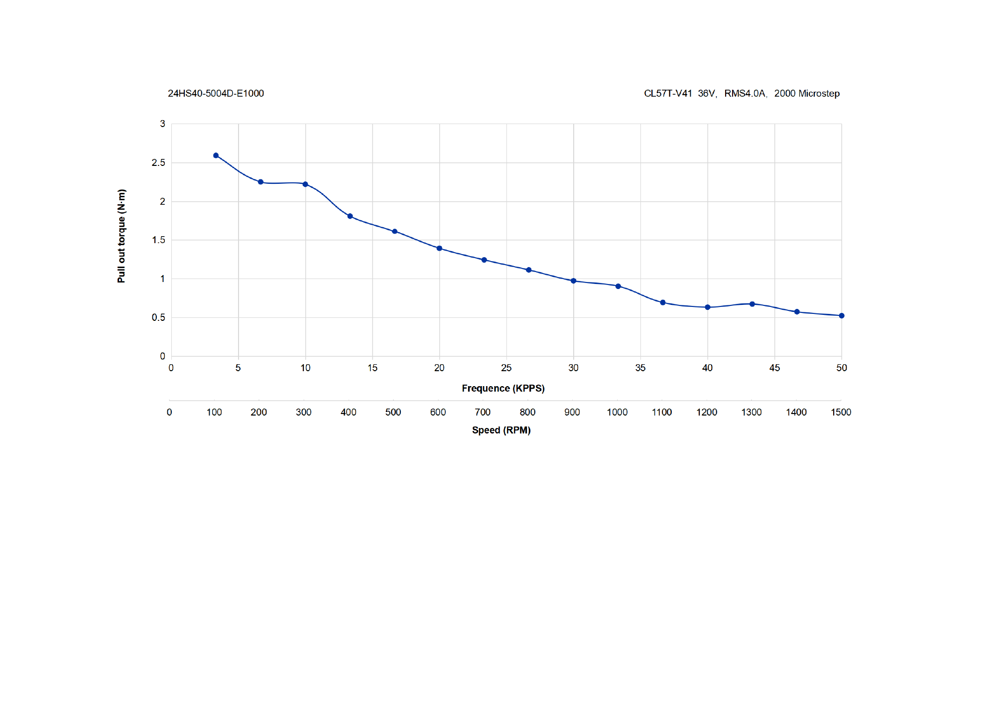
engineering/sources/24HS40-5004D-E1000-torque.png
