sbelakho2/Cutting/engineering/sources/34E1K-85-drawing.png

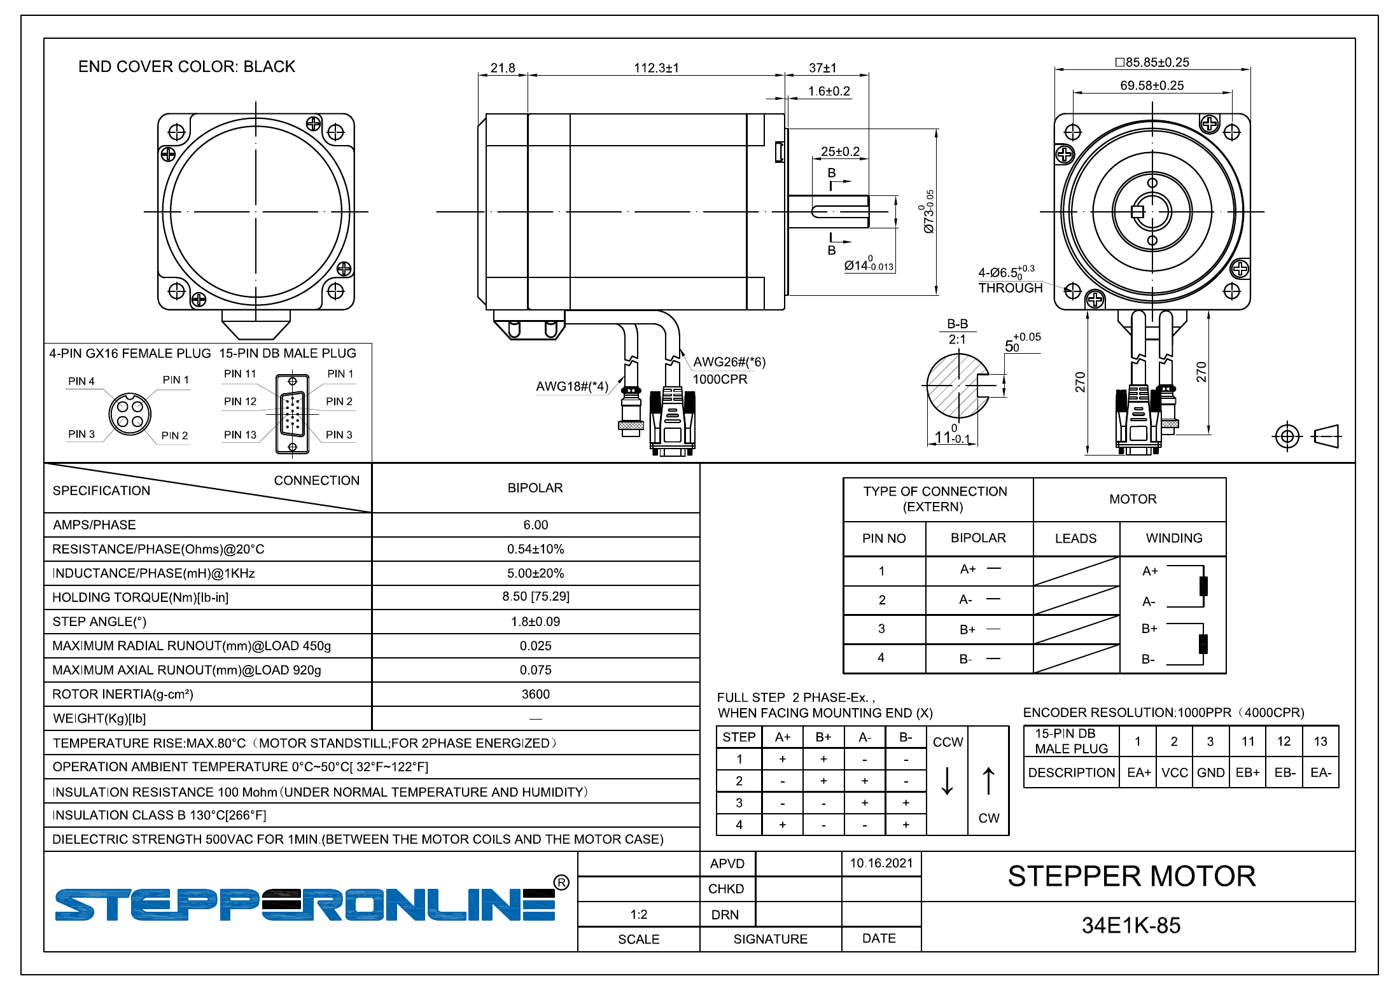
engineering/sources/34E1K-85-drawing.png
