sbelakho2/Cutting/engineering/sources/34E1K-85-torque.png

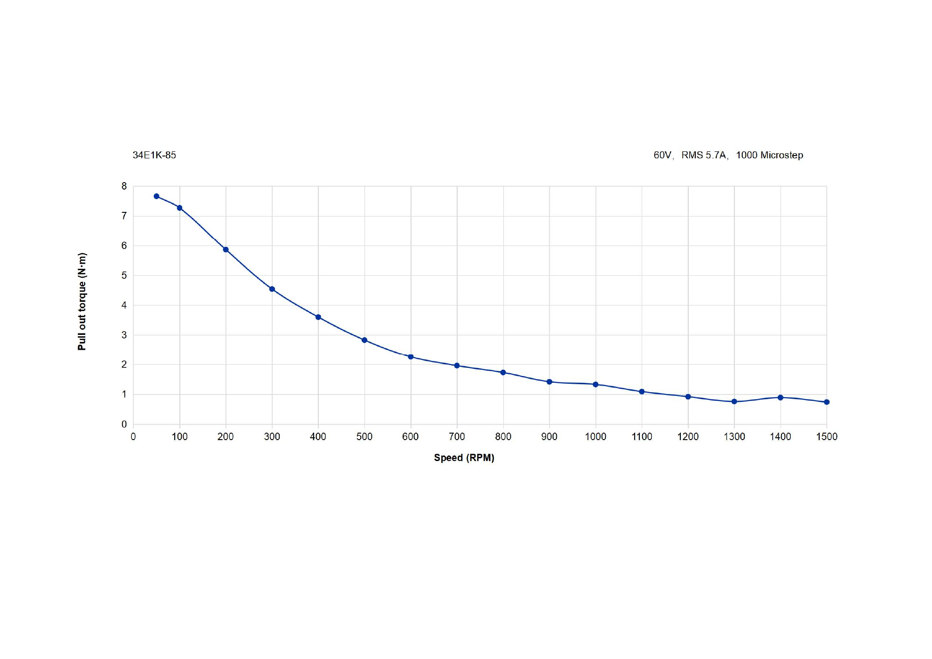
engineering/sources/34E1K-85-torque.png
