sbelakho2/Cutting/engineering/sources/autonics-e40-drawing.png

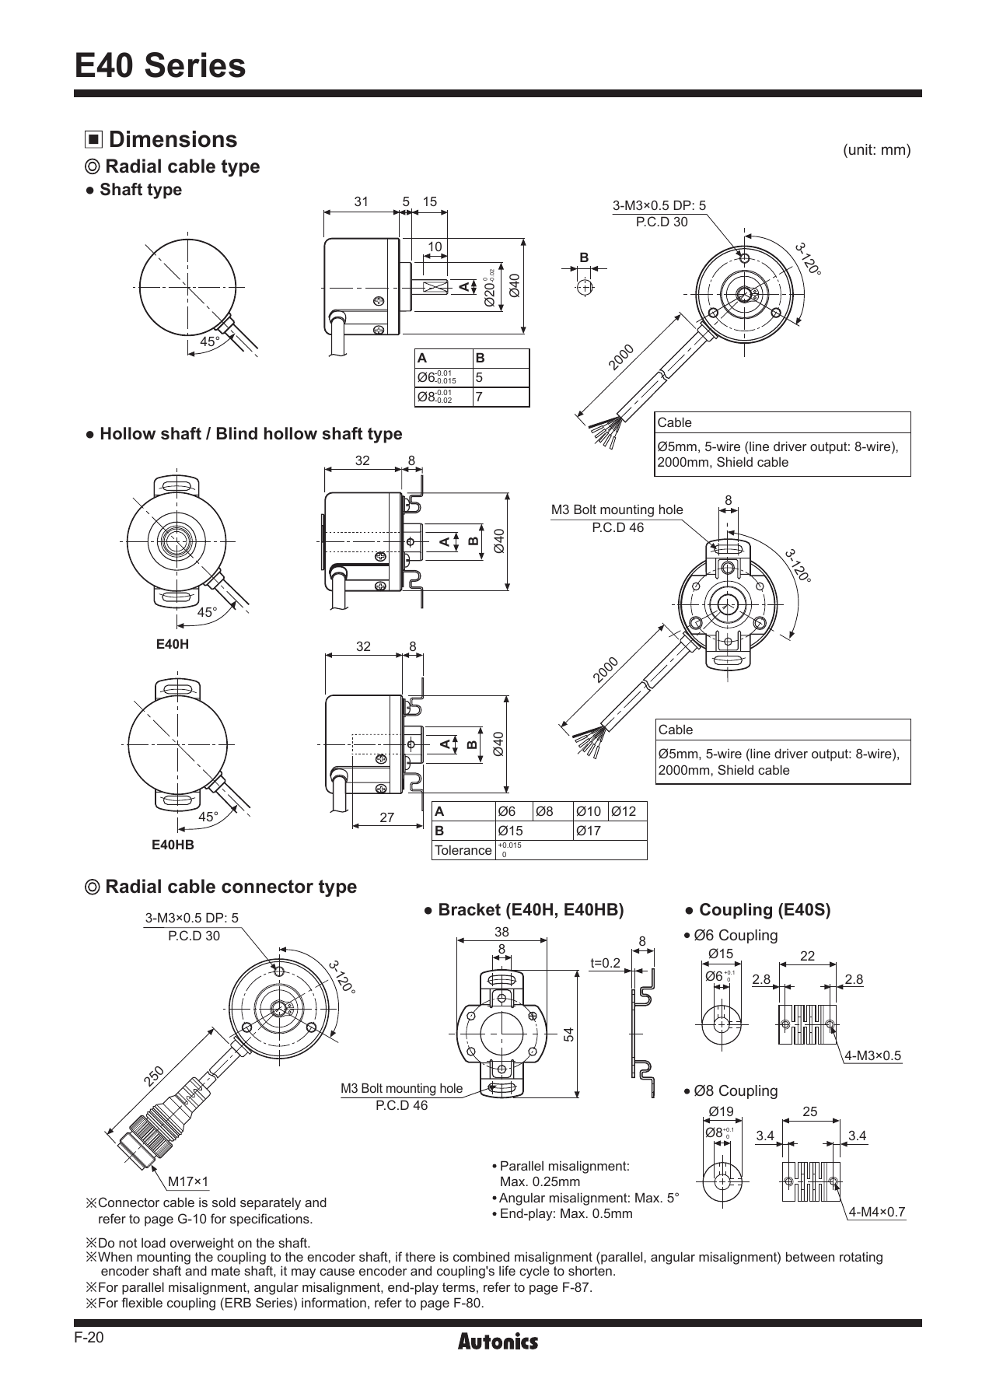
engineering/sources/autonics-e40-drawing.png
