sbelakho2/Cutting/engineering/sources/dormer-e412-family-dim.png

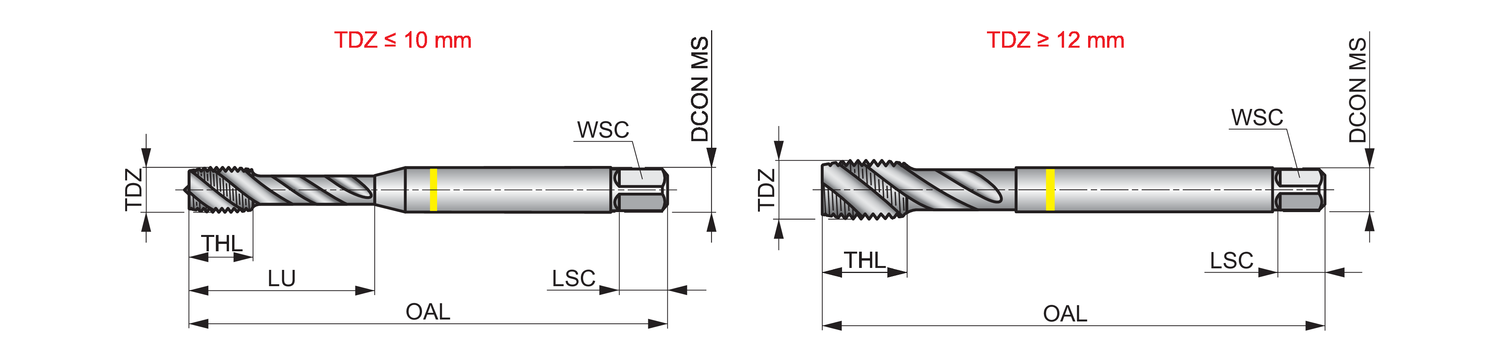
engineering/sources/dormer-e412-family-dim.png
