sbelakho2/Cutting/engineering/sources/feed-motor-dimensions.png

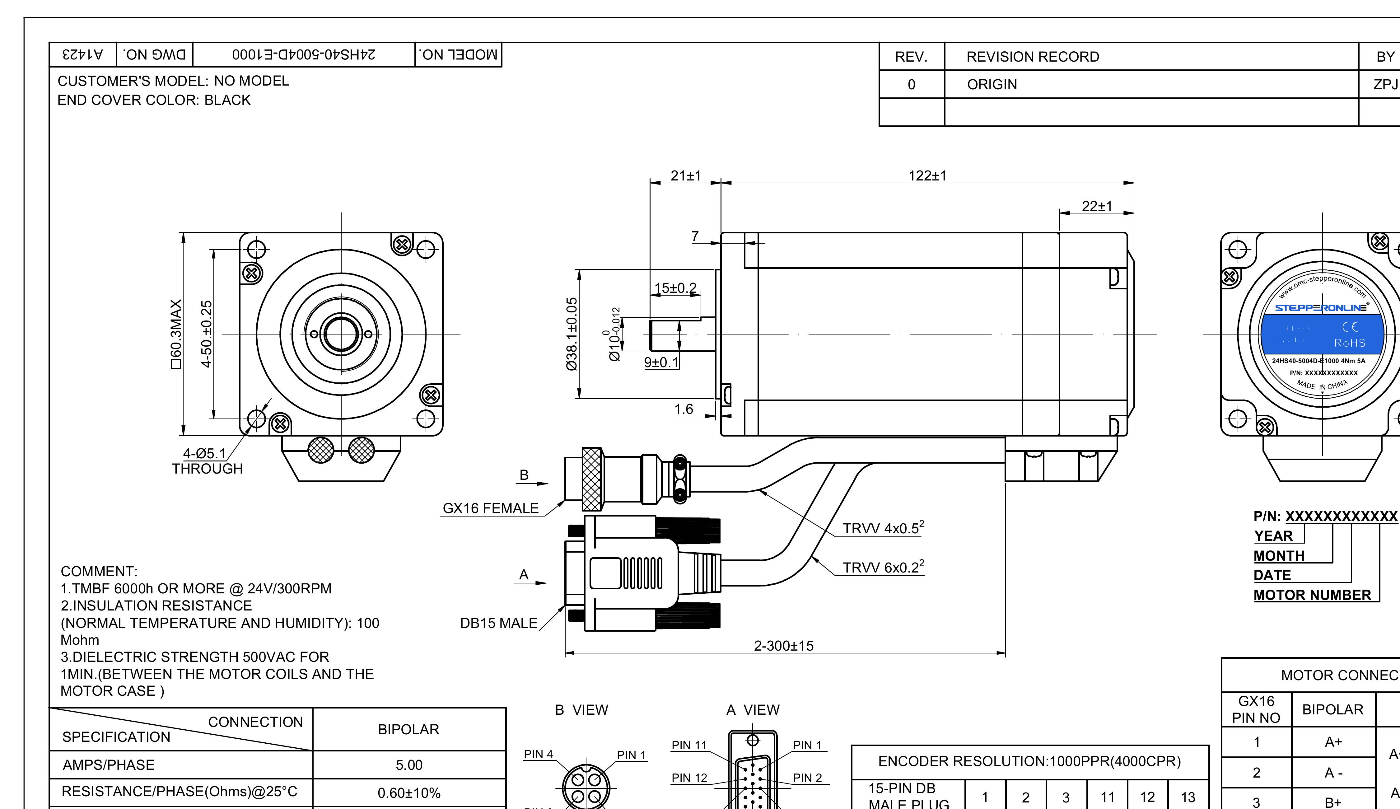
engineering/sources/feed-motor-dimensions.png
