sbelakho2/Cutting/engineering/sources/hiwin-kk86-detailed.png

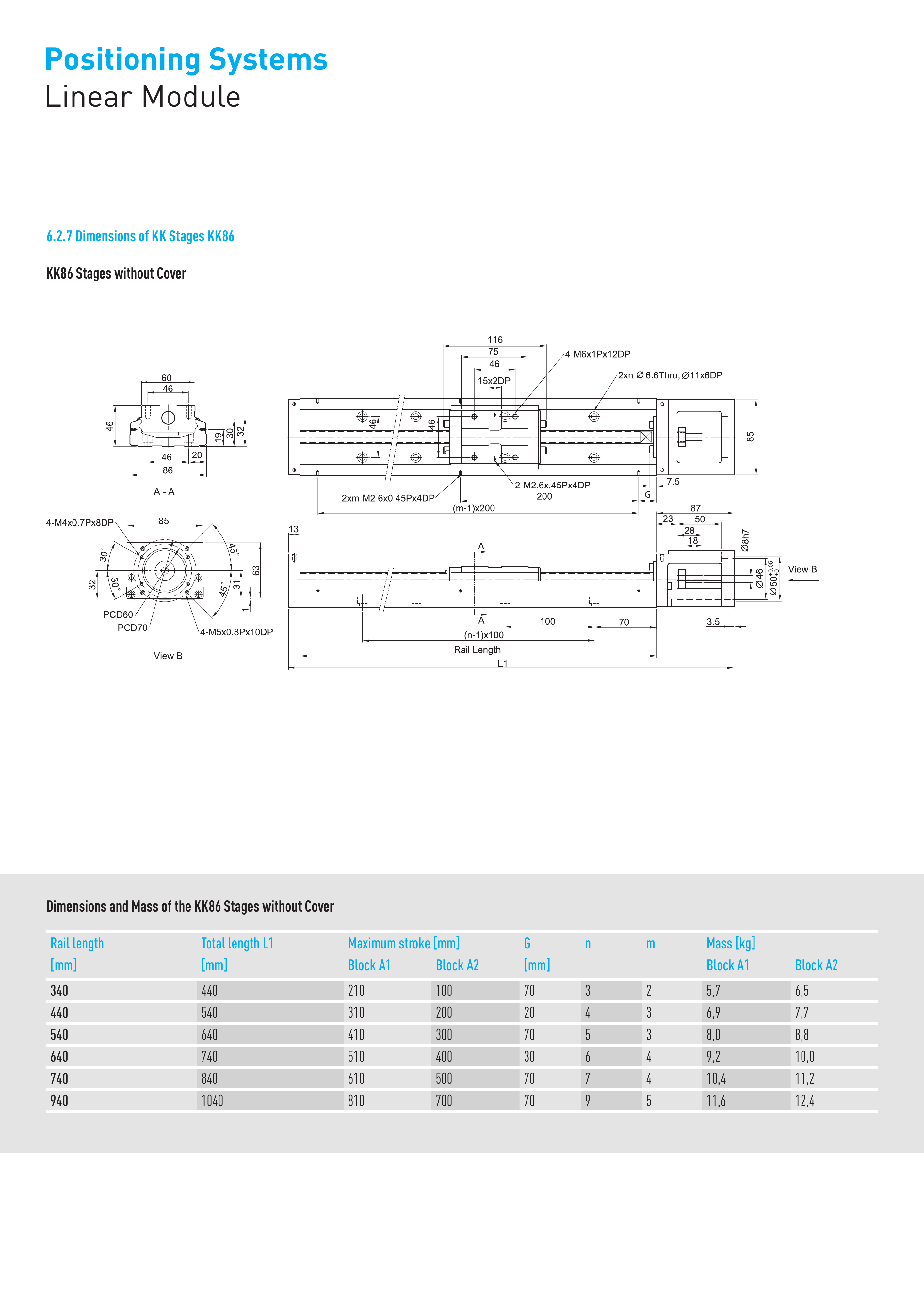
engineering/sources/hiwin-kk86-detailed.png
