sbelakho2/Cutting/engineering/sources/hiwin-kk86-shaft-detail.png

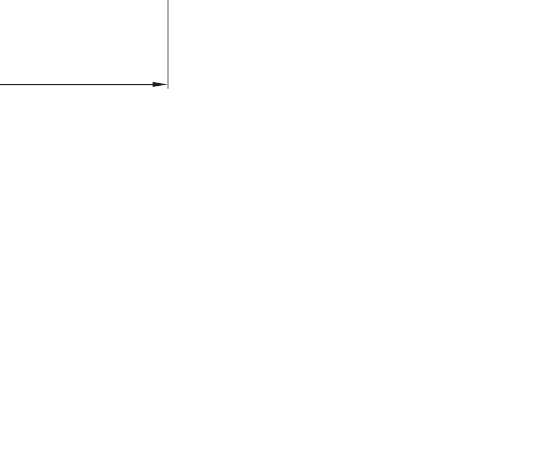
engineering/sources/hiwin-kk86-shaft-detail.png
