sbelakho2/Cutting/engineering/sources/jakob-ksd-drawing.png

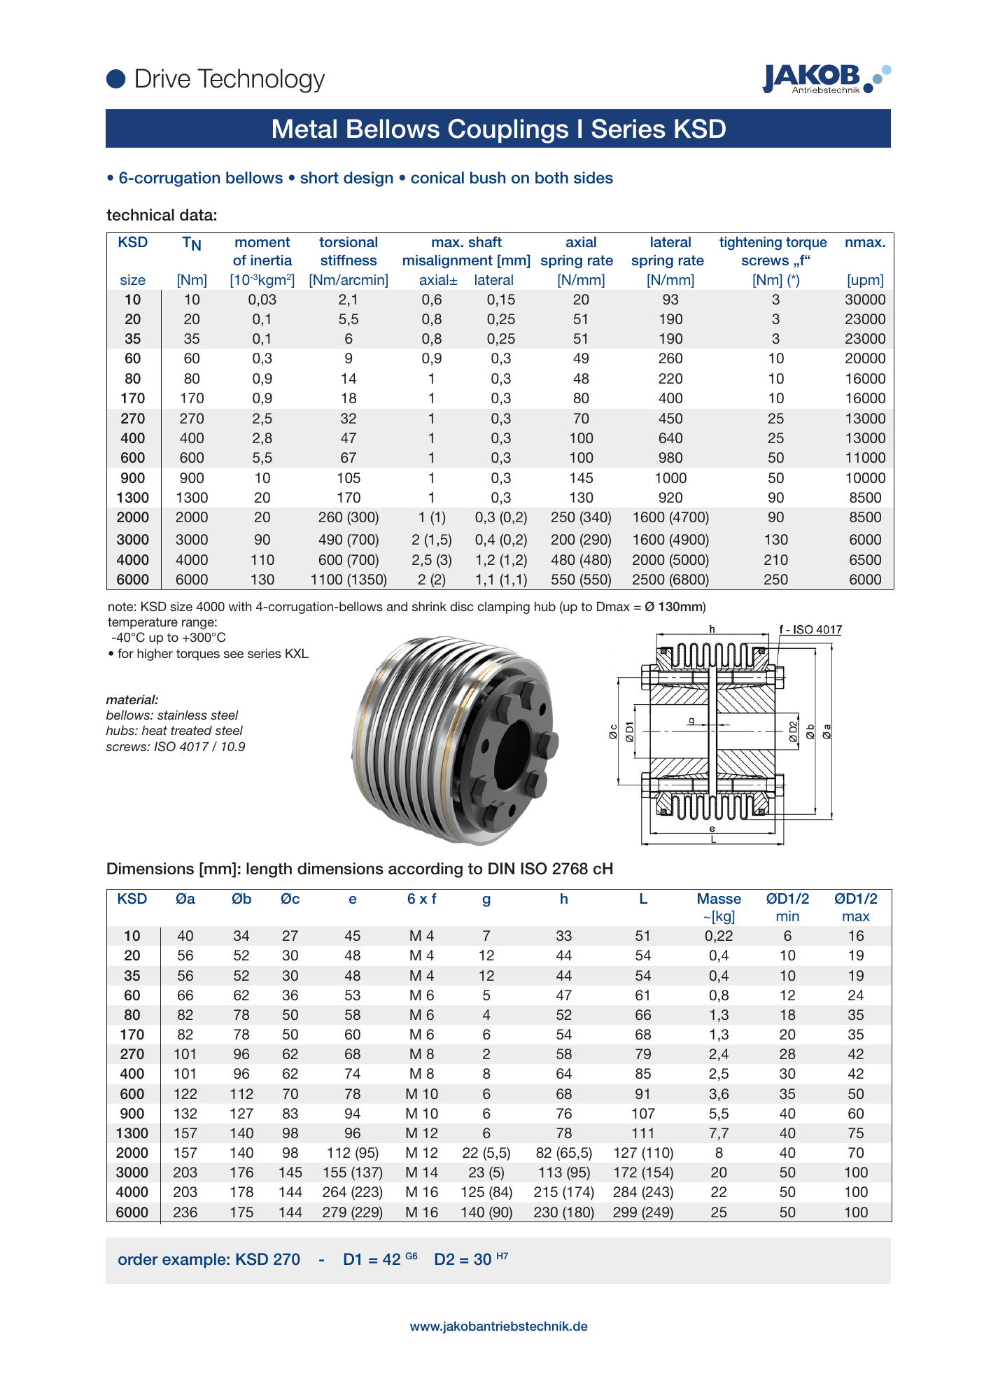
engineering/sources/jakob-ksd-drawing.png
