sbelakho2/Cutting/engineering/sources/misumi-collar-rollers.png

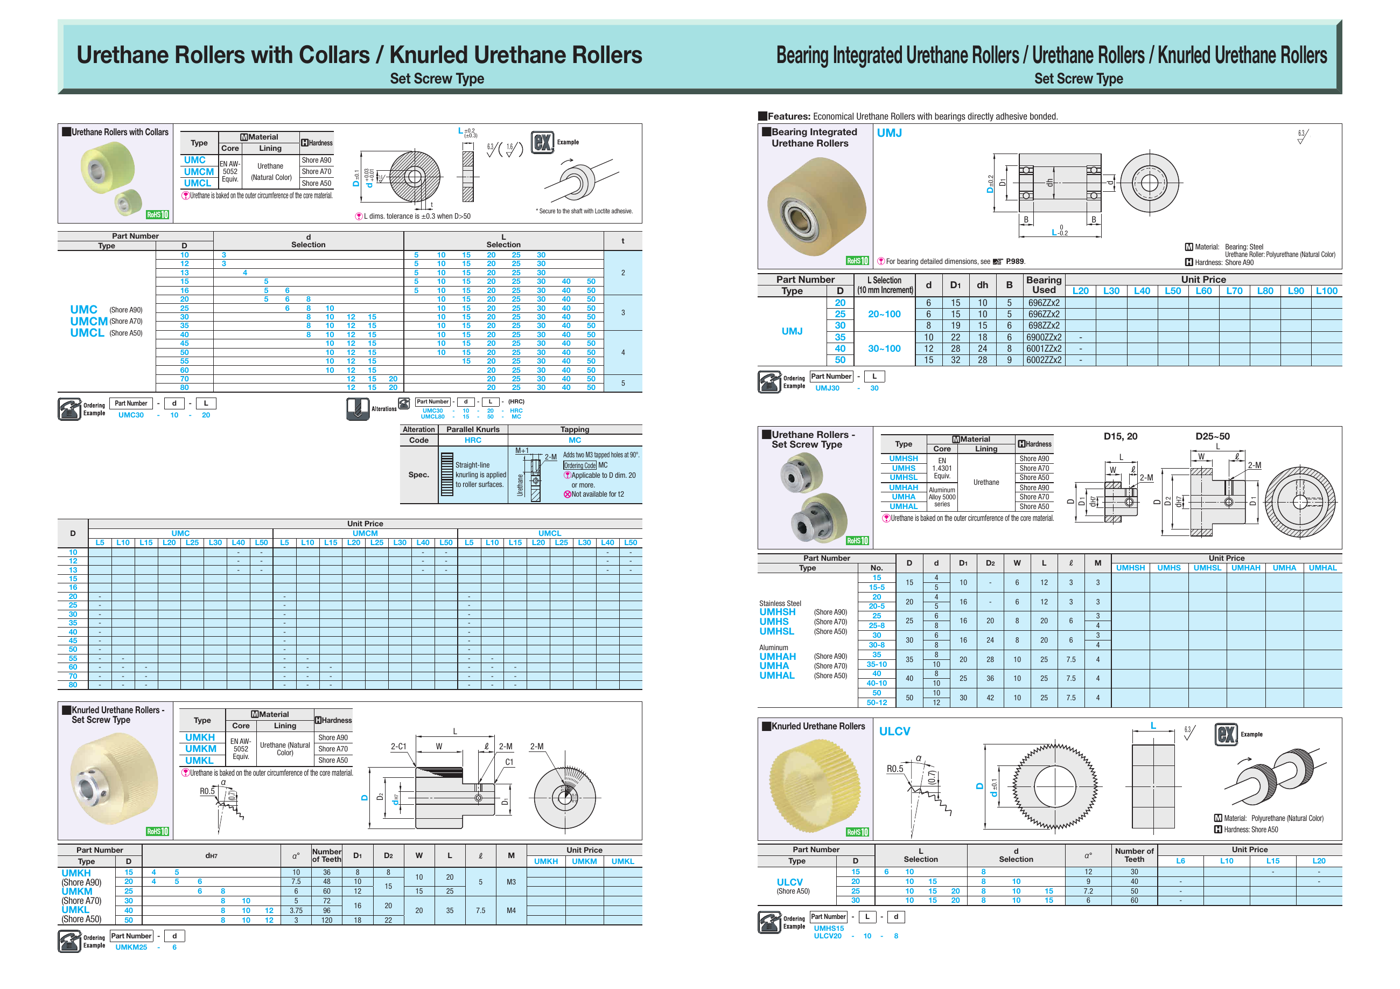
engineering/sources/misumi-collar-rollers.png
