sbelakho2/Cutting/engineering/sources/misumi-s3m-pulleys.png

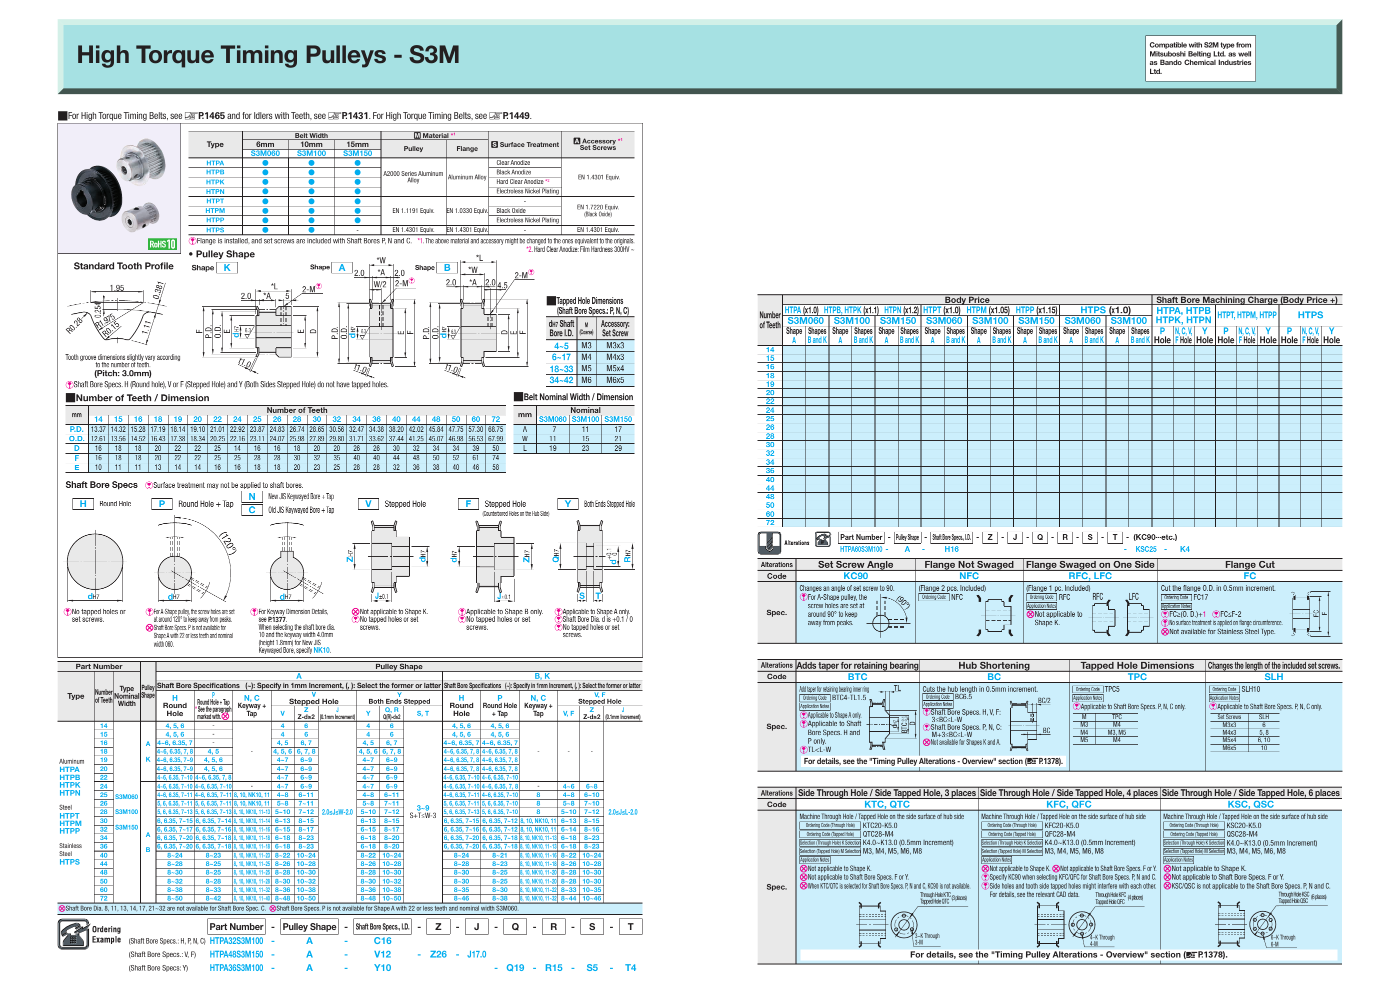
engineering/sources/misumi-s3m-pulleys.png
