sbelakho2/Cutting/engineering/sources/misumi-s5m-pulleys.png

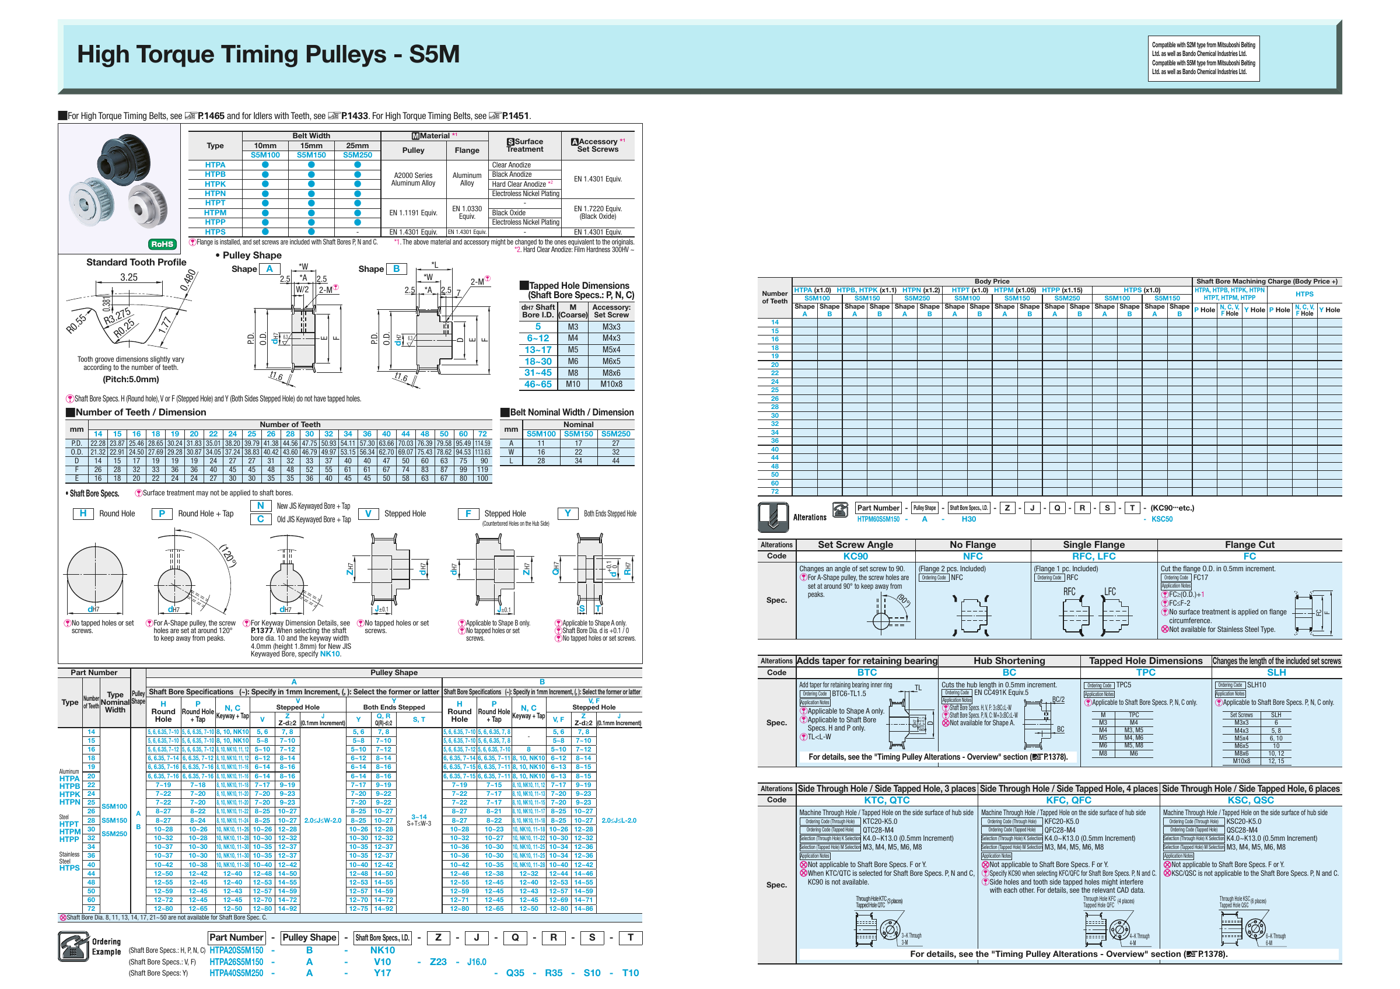
engineering/sources/misumi-s5m-pulleys.png
