sbelakho2/Cutting/engineering/sources/misumi-umcl-drawing.gif

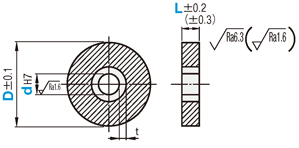
engineering/sources/misumi-umcl-drawing.gif
