sbelakho2/Cutting/engineering/sources/supply-drawing.png

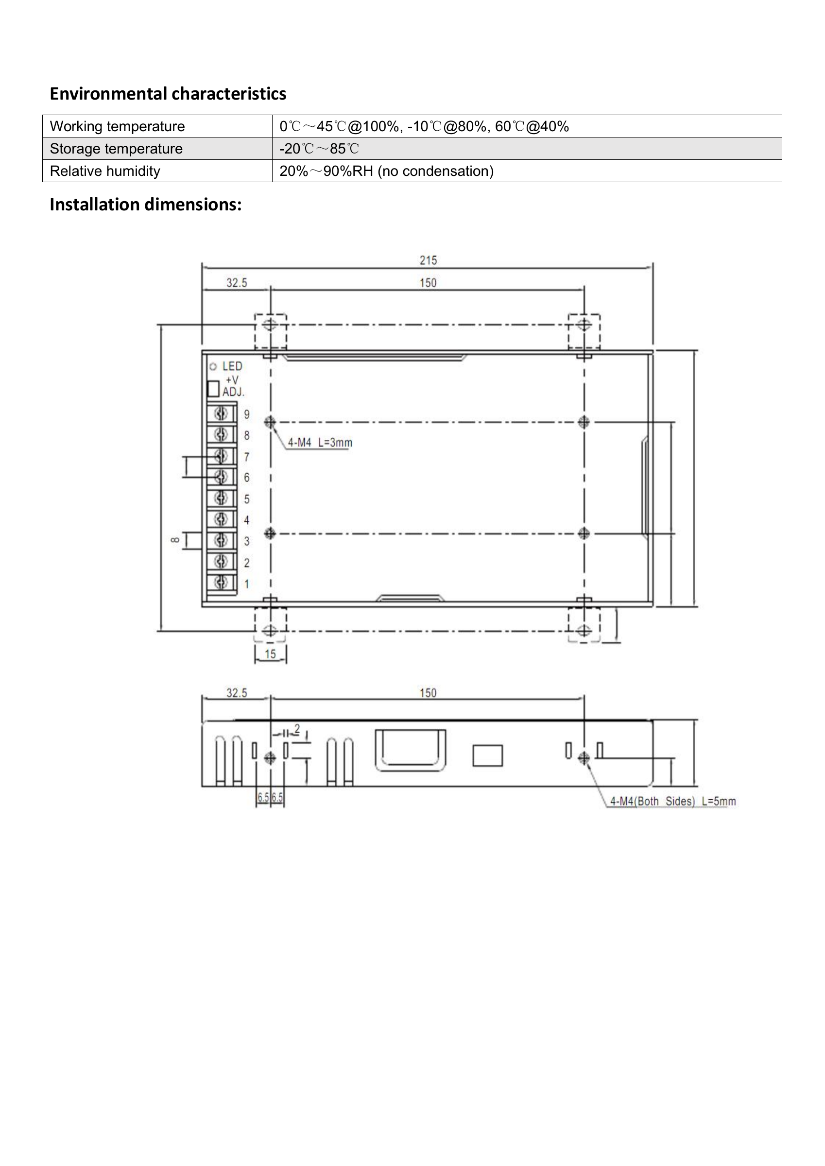
engineering/sources/supply-drawing.png
