sbelakho2/Cutting/bom/README.md

# BOM authority and commercial status

**Active selections:** [selected-cutting-head.csv](selected-cutting-head.csv), [selected-transport-and-cabinet.csv](selected-transport-and-cabinet.csv), [selected-mechanism.csv](selected-mechanism.csv), [selected-controls.csv](selected-controls.csv), [selected-cabinet-wiring.csv](selected-cabinet-wiring.csv), [feed-custom-parts.csv](feed-custom-parts.csv), [measurement-custom-parts.csv](measurement-custom-parts.csv) and [mechanism-custom-parts.csv](mechanism-custom-parts.csv), supported by [manufacturer evidence](../engineering/sources/catalogue-evidence.md). These are current subsystem selections, not a complete replacement machine BOM or an energisation release. The controls selection and cabinet-wiring schedule contain explicit `HOLD-` and `UNSELECTED` rows: they are not purchasable selections and prevent a cabinet release until exact terminal, enclosure, wiring and branch-protection choices are source-backed. [sourcing-evidence.csv](sourcing-evidence.csv) keeps direct public-page observations separate from inherited source links and never represents a public price as a delivered cost. F110 is the secondary operation on TR-R01,not an additional purchased roller. M201 is the encoder face plate; the measuring shaft, arm, bracket and counter roller are the M202–M210 custom parts, and the pressure carriers, wire guides, bed and welded frame are the F201–F305 custom parts. Fastener quantities per assembly are generated into [mechanism-bom.csv](../engineering/generated/mechanism/mechanism-bom.csv) from the CAD model.

**Fabrication tools, separate from installed parts:** [fabrication-tooling.csv](fabrication-tooling.csv) selects the actual Dormer E412M5 blind tap for F101, one working tool and one spare. The observed USD81.10 merchandise extension is not included as eight installed shaft components and is not a delivered price. See the [tool/physical-tip operation record](../docs/14-f101-tapping-operation.md).

**Removed2026-09-13:** the withdrawn single-point BOM/report, S1-A component lists, delivered-cost table, interface-control sheet, budget report, sourcing map, Alibaba evidence and freight pools were deleted from the repository (archived outside it as `Cutting-superseded-2026-09-13.tar.zst`). Their interfaces, prices, freight totals and release statements are not authoritative and must not be reintroduced. The current CSV selection records in this directory are the BOM authority; draft IF-B01 and cabinet records do not become fabrication or electrical-release artifacts merely by appearing here.

**Observed merchandise, installed purchased parts:** the following limited subtotals cover mechanics only. Twelve of36 selected head/transport rows have observed unit prices (AX-01,DR-01,PS-01,TR-M01,TR-R01,TR-TP01,TR-TB01,TR-B01,TR-B02,TR-N01,TR-W01,ME-B01), extending to **USD2720.50** before freight (ECB-dated conversions from the Simply Bearings GBP observations and the 2026-09-16 VND conversion of the MISUMI VN axis price are merchandise arithmetic, not vendor USD quotes); the five mechanism rows (LHFRW12,PSFJ12-240,SWU17-60,SWU10.5-35,6204-2Z/C3) have observed merchandise prices extending to **EUR134.20** ex-VAT before freight. [selected-controls.csv](selected-controls.csv) contains individual observed unit values where available but no complete control/cabinet subtotal because the quotation-register lines (axes, couplings, wheels, encoders, cooler) are unpriced until their quotations return. Other selected controls, custom parts, fasteners and fabrication remain unpriced. No delivered machine cost exists.

**Added 2026-09-13 (live public-page observations, merchandise only):** the SKF bearing/retention lines now have observed Simply Bearings GBP prices — 6001-2Z/C3 GBP6.32, 6002-2Z/C3 GBP6.91, 626-2Z GBP4.49, KM2 GBP7.90, MB2 GBP2.15 — recorded in [selected-transport-and-cabinet.csv](selected-transport-and-cabinet.csv) as ECB-converted USD with the exact basis; the payoff spindle's new SKF 6204-2Z/C3 pair is GBP8.68 in [selected-mechanism.csv](selected-mechanism.csv). The three Schneider LC1D12BD contactors have an observed Automation24 EUR70.40 (page RRP108.00, in stock). Quality-equivalent same-designation FAG/KOYO rows were observed on the same page family and are recorded in [catalogue evidence](../engineering/sources/catalogue-evidence.md); they are comparisons requiring an approved change record, not substitutions. The HIWIN axis price is observed 2026-09-16 via the MISUMI VN catalogue API (KK8610C-340A1-F0, VND 21,146,653 = USD 824.72 converted; P→C substitution adopted, see [axis-replacement-findings](../engineering/sources/axis-replacement-findings.md)); R+W couplings and Rittal cooler public prices remain unobserved. Resolved 2026-09-16 by priced automation24 substitutions: the Kübler wheel is replaced by **ifm E60137** (EUR 57.00 ex VAT, in stock) and the Autonics encoder by **ifm RU3100** (EUR 186.40 ex VAT, in stock) — rows ME-W01/ME-E01 updated; the original unpriced identities are superseded in [measurement-replacement-findings](../engineering/sources/measurement-replacement-findings.md). [Guard/payoff R2](../docs/26-guard-and-payoff-selection.md) selects panels, door, spool, spindle, bearings and friction brake as design identities; all remain `selected_design_not_fabricated`.

## Supplier comparison, without substitution

| Source | Scope retained for this revision | Verified commercial status |
|---|---|---|
| STEPPERONLINE direct | Exact34E1K-85/CL86T-V41 kit andLE-350-60 supply | Public USD merchandise prices observed; Tunisia freight and lead time not quoted |
| HIWIN / official distributor | ExactKK8610C-340A1-F0 complete axes (C-grade substitution for KK8610P340A1F0) | Manufacturer dimensions/rating verified; live MISUMI VN catalogue-API price VND 21,146,653 (USD 824.72 converted, 2026-09-16); 23–99 days, temp-not-available caution |
| R+W / official distributor | ExactMK2/100/50/8/14 configured coupling | Catalogue configuration verified; price not observed |
| MISUMI manufacturer-direct | UMCL40-10-20-MC,HTPA20S5M250-A-N14,HTBN225S5M-250,LHFRW12,PSFJ12-240,SWU17-60,SWU10.5-35 | Confirmed configurations and EURmerchandise prices;BOM USDvalues are datedECBconversions,not vendor USDquotes |
| SKF / official distributor | 6001-2Z/C3,6002-2Z/C3,626-2Z,KM2,MB2 | Manufacturer geometry/rating selected; Simply Bearings GBP merchandise prices observed 2026-09-13 with FAG/KOYO same-designation comparisons |
| SKF / payoff spindle | 6204-2Z/C3 pair | Selected in [guard/payoff R2](../docs/26-guard-and-payoff-selection.md); GBP8.68 observed 2026-09-13; not fabricated |
| SEEGER-ORBIS / distributor | A12 spring-steelDIN471rings | Original catalogue groove/rating checked;price not observed |
| DigiKey | Exact selected interface components and relay couplers where individually listed | Unit observations are not a cabinet quotation; no delivered quote or substitution claim |
| Mouser | Same comparison basis for exact electrical components | No verified cost advantage or Tunisia freight quote claimed |
| Alibaba | Market research only for this critical head | The investigatedHL2080 listing does not establish the old50mm/SFU1204 configuration or load/moment ratings; it is not selected |
| Tunisia local fabrication | Raw stock, CNC, finishing, guards after engineering release | No fabricated local quote; transport of heavy local stock not included in observed merchandise subtotal |

No “best delivered price” ranking can honestly be computed from list prices with absent freight quotations. No purchase/contact was made. Duty/tax is budgeted zero **only under the user's stated sous-douane premise**; customs eligibility and treatment were not verified. The direct-page records for XPSUAF13AP and 3SU1851-0NB00-2AC2 do show a selling price below the RRP printed on that same page; this is not a competing-supplier comparison or delivered-price conclusion.

The2026-09-12 [DigiKey search for the selected measuring encoder](https://www.digikey.com/en/products?keywords=E40S6-1024-6-L-5) displayed0 results and suggested a different NPN-output part. That suggestion is not used. The old48.50 USD/1864-1042-ND/3-day line is not a verified current listing and remains withdrawn. A blocked page or rate limit is not evidence that a distributor does not carry a part. Superseded 2026-09-16: ME-E01 is now the ifm RU3100 (automation24 item 102717, EUR 186.40 ex VAT, in stock) and ME-W01 the ifm E60137 (item 102756, EUR 57.00 ex VAT, in stock).
