sbelakho2/Cutting/docs/32-sourcing-list.md

# Sourcing list — every purchased line with a ready search link

**Revision:** `S1-B-SRC-2026-09-16`

Open the links and record the price + link in `bom/selected-*.csv`. Prices
already verified are shown; blank = take the cheapest in-stock offer.

## Priced (verified, recorded in the BOMs)

| Item | Qty | Price | Link |
|---|---|---|---|
| 24HS40-5004D-E1000 | 2 | USD 36.87 | stepperonline.com (recorded) |
| CL86T-V41 kit (34E1K-85) | 2 | USD 130.77 | stepperonline.com (recorded) |
| LE-350-60 | 2 | USD 17.88 | stepperonline.com (recorded) |
| SKF 6001-2Z/C3 | 8 | GBP 6.32 | [simplybearings.co.uk](https://www.simplybearings.co.uk/products/6001-2z-c3-skf) |
| SKF 6002-2Z/C3 | 8 | GBP 6.91 | [simplybearings.co.uk](https://www.simplybearings.co.uk/products/6002-2z-c3-skf) |
| SKF 626-2Z | 10 | GBP 4.49 | [simplybearings.co.uk](https://www.simplybearings.co.uk/products/626-2z-skf) |
| SKF 6204-2Z/C3 | 2 | GBP 8.68 | [simplybearings.co.uk](https://www.simplybearings.co.uk/products/6204-2z-c3-skf) |
| SKF KM 2 | 8 | GBP 7.90 | [simplybearings.co.uk](https://www.simplybearings.co.uk/products/km2-skf) |
| SKF MB 2 | 8 | GBP 2.15 | [simplybearings.co.uk](https://www.simplybearings.co.uk/products/mb2-skf) |
| UMCL40-10-20-MC | 8 | EUR 19.50 | uk.misumi-ec.com (recorded) |
| HTPA20S5M250-A-N14 | 4 | EUR 39.87 | uk.misumi-ec.com (recorded) |
| HTBN225S5M-250 | 2 | EUR 25.24 | uk.misumi-ec.com (recorded) |
| LHFRW12 | 4 | EUR 14.58 | uk.misumi-ec.com (recorded) |
| PSFJ12-240 | 4 | EUR 11.70 | uk.misumi-ec.com (recorded) |
| SWU17-60 / SWU10.5-35 | 2 / 1 | EUR 3.53 / 1.80 | uk.misumi-ec.com (recorded) |
| XPSUAF13AP | 1 | EUR 133.50 | [automation24.com](https://www.automation24.com/safety-relay-schneider-electric-harmony-xpsuaf13ap) |
| 3SU1851-0NB00-2AC2 | 1 | EUR 110.70 | automation24.com (recorded) |
| SLC-F-024-20/20-R4 + ACF-1 | 1+1 | EUR 143.50 + 17.90 | automation24.com (recorded) |
| LC1D12BD | 3 | EUR 70.40 | [automation24.com](https://www.automation24.com/main-contactor-schneider-electric-tesys-lc1d12bd) |
| 6EP3332-6SB00-0AY0 | 1 | EUR 68.60 | [automation24.com](https://www.automation24.com/logo-power-supply) item 103609 |
| Raspberry Pi Pico 2 | 1 | USD 5.00 | recorded |
| Circlip Ø12 — A12 substitution SELECTED: Wegertseder 1950-010 DIN 471 12×1 Federstahl | 8 (from 100-pc pack) | EUR 0.086/pc incl VAT (EUR 8.57/100) | [wegertseder.com](https://www.wegertseder.com/DIN-471-Sicherungsringe-fuer-Wellen-Regelausfuehrung-FEDERSTAHL-Diameter-12) (in stock; Simply Bearings d1400-012 GBP 0.85/pc remains a comparison) |
| Rittal SK 3303.500 cooler | 1 | EUR 1,669.00 | [conrad.com](https://www.conrad.com/en/p/rittal-sk-3303-500-cooler-230-v-0-55-kw-w-x-h-x-d-280-x-550-x-210-mm-1-pc-s-2200714.html) |
| PT 2,5 3209510 (grey) | 12+8 | EUR 1.29 | [conrad.com](https://www.conrad.com/en/p/phoenix-contact-3209510-continuity-5-2-mm-quick-connect-grey-1-pc-s-733311.html) |
| PT 2,5 3209523 (blue) | 12+4 | EUR 1.29 | [conrad.com](https://www.conrad.com/en/p/phoenix-contact-3209523-continuity-5-2-mm-quick-connect-blue-1-pc-s-733325.html) |
| UT 4 3044131 | 12 | EUR 2.29 | [conrad.com](https://www.conrad.com/en/p/phoenix-contact-3044131-continuity-8-2-mm-screws-grey-1-pc-s-744402.html) |
| 3046032 fuse serial terminal (5×20) | 5 (CB-TB-DL + CB-XPS-FUSE + CB-TB-DL-K1-K3) | EUR 7.99 | [conrad.com](https://www.conrad.com/en/p/phoenix-contact-3046032-fuse-serial-terminal-6-2-mm-screws-black-1-pc-s-744510.html) |
| Lapp Skintop MS-M 20 EMC 53112532 | 2 | EUR 17.99 | [conrad.com](https://www.conrad.com/en/p/lapp-53112532-cable-gland-emc-m20-brass-brass-1-pc-s-1601941.html) |
| Encoder SELECTED 2026-09-16: ifm RU3100 (Ø6×10, 1024 PPR factory, TTL/HTL, 4.75–30 VDC, synchro flange 3×M4×0.7×6 PCD42) | 2 | EUR 186.40 ex VAT (RRP 207.10) | [automation24.com](https://www.automation24.com/incremental-encoder-ifm-electronic-ru3100) item 102717, in stock (observed 2026-09-16) |
| Measuring wheel SELECTED 2026-09-16: ifm E60137 (U:200 N:06; 200 mm circumference, Ø63.66, Ø6 bore, PU 90 Shore A) | 2 | EUR 57.00 ex VAT (RRP 61.90) | [automation24.com](https://www.automation24.com/measuring-wheel-ifm-electronic-e60137) item 102756, in stock (observed 2026-09-16) |
| Encoder alternative: ifm RUP500 (Ø6 synchro, 1024, display) | 2 | EUR 255.50 | [automation24.com](https://www.automation24.com/incremental-encoder-ifm-electronic-rup500) |
| M5×16 DIN 912 A2-70 socket screws, 50 pcs | 1 box | EUR 13.99 | [conrad.com](https://www.conrad.com/en/p/swg-9451667-allen-screws-m5-16-mm-hex-socket-allen-din-912-stainless-steel-a2-50-pc-s-1205329.html) (general hardware; the F0 motor/stage joints need class 10.9 — buy 10.9 separately) |
| Schneider DF2CN02 fuse link (2 A gG 10×38) — SUPERSEDED 2026-09-16 | — | replaced by the 3046032 + ESKA 522620 2 A 5×20 set below | [conrad.com](https://www.conrad.com/en/p/schneider-electric-df2cn02-fuse-holder-inset-10-pc-s-2935313.html) |
| Phoenix UT 4-PE 3044128 (PE terminal, green-yellow) | 1 | EUR 4.79 | [conrad.com](https://www.conrad.com/en/p/phoenix-contact-3044128-triple-port-pg-terminal-6-2-mm-screws-green-yellow-1-pc-s-744462.html) |
| Schneider DF2BA0200 fuse link (2 A gG 10×38, cheaper class) — SUPERSEDED 2026-09-16 | — | replaced by the 5×20 set above | [conrad.com](https://www.conrad.com/en/p/schneider-electric-df2ba0200-fuse-10-pc-s-2935281.html) |
| Schneider Acti9 iID 2P 25 A 30 mA type A A9Z21225 (RCD) | 1 | EUR 35.99 incl VAT | [conrad.com](https://www.conrad.com/en/p/schneider-electric-a9z21225-a9z21225-rccb-a-25-a-0-03-a-240-v-1861630.html) (5 in stock) |
| ESKA 522620 2 A T 5×20 (XPS output) / 522617 1 A T 5×20 (drive logic) | 1 + 4 | EUR 1.49 each incl VAT | [522620](https://www.conrad.com/en/p/eska-522620-522620-dc-fuse-o-x-l-5-mm-x-20-mm-2-a-250-v-dc-time-delay-t-content-1-pc-s-1414701.html) · [522617](https://www.conrad.com/en/p/eska-522617-522617-dc-fuse-o-x-l-5-mm-x-20-mm-1-a-250-v-dc-time-delay-t-content-1-pc-s-1414698.html) |
| Kübler encoder beam coupling 8.0000.1102.1008 (Ø10/Ø8) | ref | EUR 43.99 | [conrad.com](https://www.conrad.com/en/p/kubler-group-8-0000-1102-1008-beam-coupling-rotary-encoder-1102-1-pc-s-198995.html) |
| Kübler Perambulator measuring wheel (family reference) | ref | EUR 395.00 | [conrad.com](https://www.conrad.com/en/p/kubler-group-perambulator-1-pc-s-05-2400-0040-1000-5045-125696.html) |
| CL57T-class driver fallback (Amazon.de market) | ref | EUR 189.10 | [amazon.de](https://www.amazon.de/dp/B0HJ23YQVQ) |
| 350 W 36 V supply fallback (Amazon.de market) | ref | EUR 77.04 | [amazon.de](https://www.amazon.de/dp/B0HDN818SJ) |
| LAPP H07V-K 1.5 mm² (100 m reels, red/bk/bu/gnye) | 4 reels | EUR 0.37–0.44/m | [conrad.com](https://www.conrad.com/en/search?search=H07V-K%201.5) |
| R+W MK2 100/50 class anchor (10/14 variant, ebmia order path) | 2 | EUR 99.43 net / 122.30 gross per pc (530.35 zł gross) | [ebmia.pl](https://www.ebmia.pl/sprzegla-mieszkowe-bkl/213877-sprzeglo-bezluzowe-mk2-100-50-10-14.html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) (0 stock, 7–14 days; sibling 8/21,4 at 418.85 zł gross, 24 h). ORDER the exact bores 8/14 and 10/12 from ebmia.pl as made-to-bore quote items at the class price |
| HIWIN KK8610C-340A1-F0 complete axis (C-grade; SELECTED 2026-09-16 for AX-01, P→C substitution) | 2 | VND 21,146,653 per unit (USD 824.72 converted) | [MISUMI VN shelf detail 221005545419](https://vn.misumi-ec.com/vona2/detail/221005545419/?HissuCode=KK8610C-340A1-F0) — live API price read 2026-09-16; 23–99 days, "temporarily NOT available — ask MISUMI for next ship date"; evidence in [axis-replacement-findings](../engineering/sources/axis-replacement-findings.md) |
| DIN 471 12×1 retaining rings — SELECTED 2026-09-16 for TR-RR01 (A12 substitution) | 100 pcs | EUR 8.57 incl VAT = EUR 0.086/pc | [wegertseder.com Art. 1950-010](https://www.wegertseder.com/DIN-471-Sicherungsringe-fuer-Wellen-Regelausfuehrung-FEDERSTAHL-Diameter-12) (in stock; fit verdict in [coupling-ring-replacement-findings](../engineering/sources/coupling-ring-replacement-findings.md)) |
| ISO4762 M5×16 class 10.9 socket screws | 50 pcs | EUR 6.19 incl VAT | [wegertseder.com Art. 2540-034](https://www.wegertseder.com/DIN-912-Zylinderschrauben-mit-Innensechskant-STAHL-10-9-Diameter-5) (in stock) |
| ISO 8734 3m6×20 hardened dowels (DIN 6325 m6) | 10 pcs | EUR 2.73 incl VAT | [wegertseder.com Art. 1018-078](https://www.wegertseder.com/DIN-6325-Zylinderstifte-durchgehaertet-Passung-m6) (in stock) |
| CL57T-class driver (cheapest live) | 2 | EUR 173.78 | [amazon.de/dp/B0FYPDGC85](https://www.amazon.de/dp/B0FYPDGC85) (2–3 days; StepperOnline direct shop usually cheaper — record at purchase) |
| 36 V/350 W PSU (cheapest live equivalent) | 1 | EUR 77.04 | [amazon.de/dp/B0HDN818SJ](https://www.amazon.de/dp/B0HDN818SJ) (ERP-350-36; wholesale class US$12.70 MOQ 1 on [made-in-china](https://junlin-power-supply.en.made-in-china.com/product/LfqRezWPJJcM/China-AC-DC-36V-LED-SMPS-9-7A-350W-Switch-Power-Supply-LED-Driver-S-350-36.html)) |

## Open — click and take the cheapest in-stock offer

| Item | Qty | Where to click |
|---|---|---|
| ~~KK8610P340A1F0~~ — superseded 2026-09-16 by the priced MISUMI VN C-grade row above (KK8610C-340A1-F0, VND 21,146,653) | 2 | [MISUMI VN](https://vn.misumi-ec.com/vona2/detail/221005545419/?HissuCode=KK8610C-340A1-F0) · HIWIN distributor RFQ for a P-grade comparison if ever required |
| R+W MK2/100/50/8/14 and 10/12 | 2+2 | ORDER VIA [ebmia.pl](https://www.ebmia.pl/szukaj?controller=search&s=MK2%2F100%2F50): exact bores as made-to-bore quote items at the class price (anchor above); R+W direct fallback; jaw substitutes rejected on backlash — [findings](../engineering/sources/coupling-ring-replacement-findings.md) |
| ~~Kübler 8.0000.3123.0006~~ — superseded 2026-09-16 by ifm E60137 (above) | — | no public price; [findings](../engineering/sources/measurement-replacement-findings.md) |
| ~~Autonics E40S6-1024-6-L-5~~ — superseded 2026-09-16 by ifm RU3100 (above) | — | no public price; [findings](../engineering/sources/measurement-replacement-findings.md) |
| Rittal SK3303.500 | 1 | [Rittal shop](https://www.rittal.com/) · distributor RFQ |
| CL57T-V41 | 2 | [stepperonline.com](https://www.omc-stepperonline.com/closed-loop-stepper-driver-v4-1-0-8-0a-24-48vdc-for-nema-17-23-24-stepper-motor-cl57t-v41) |
| LE-350-36 | 1 | [stepperonline.com](https://www.omc-stepperonline.com/350w-36v-9-7a-115-230v-switching-power-supply-stepper-motor-cnc-router-kits-le-350-36) |
| SEEGER A12 | 8 | RESOLVED 2026-09-16: substituted by the priced Wegertseder 1950-010 DIN 471 12×1 row above; no SEEGER-ORBIS enquiry needed |
| Schneider Acti9 iC60N 2P C10 A9F54210 (mains MCB) | 1 | [Conrad search](https://www.conrad.com/en/search?search=iC60N) · distributor RFQ (no reachable public price 2026-09-16) |
| Schneider DIN-rail 10×38 fuse base | — | no longer required (5×20 solution, 2026-09-16) |
| Wago 282-364 | — | replaced by Phoenix 3046032 above (5×20 instead of 10×38) |
| Lapp Skintop MS-M 20 EMC | — | priced above (Conrad) |
| Rittal AE enclosure ≥800×600×210 | 1 | [rittal.com](https://www.rittal.com/) · distributor |
| H07V-K 0.75/1.0/1.5 mm² + ferrules | set | local electrical wholesaler |
| ISO4762/7092/4032, DIN913/929, ISO8734 fasteners | per BOM | Bossard / Würth / local |
| Raspberry Pi Pico 2, AM26LV32EIDR, TPL7407LDR | per BOM | [LCSC](https://www.lcsc.com/search?q=TPL7407LDR) · [Raspberry Pi](https://www.raspberrypi.com/products/raspberry-pi-pico-2/) |

## Delivery to Tunisia (sous-douane), USD

Send the full list with quantities to the sous-douane forwarder for one
consolidated DDU quote (unit USD, seller terms, freight, forwarder handling,
destination charges, customs, lead time). Compare against direct DHL/FedEx
economy offers from the clickable shops above. Record each offer in the
build record before ordering.
