sbelakho2/Cutting/bom/mechanism-custom-parts.csv

id | quantity | description | material | nominal_stock | manufacturing_record | release_state
F201 | 2 | stepped_carrier_base;block72x185x13.75_plus_flange49x185x13.75;M5_housing_cbores;post_bores12.01x30_with_clamp_slits;bed_M8_cbores | EN_AW_6082-T6 | 130x195x60 | engineering/generated/mechanism/manifest.csv | geometry_checked_in_code_not_fabricated
F202 | 2 | pressure_carrier_plate;10_thick;2x21.01_bushing_bores;4xM4_PCD32_each;10_dowel_hole;M5_cassette_cbores | EN_AW_6082-T6 | 125x190x12 | engineering/generated/mechanism/manifest.csv | geometry_checked_in_code_not_fabricated
F203 | 2 | post_bridge40x178x12;slit_clamps;M8_adjuster_tap | C45 | 45x185x15 | engineering/generated/mechanism/manifest.csv | geometry_checked_in_code_not_fabricated
F205 | 2 | wire_guide_holder9x24x83;8_insert_bore;M4_set_screw | EN_AW_6082-T6 | 12x28x90 | engineering/generated/mechanism/manifest.csv | geometry_checked_in_code_not_fabricated
F206 | 2 | guide_insert8h6x9;bore_wire_od_plus0.5;60deg_cones | CuZn39Pb3 | 10_round_bar | engineering/generated/mechanism/manifest.csv | wire_size_specific_insert
F208 | 2 | carrier_spring_cap24x6;spigot10x10;recess9x2 | C45 | 25_round_bar | engineering/generated/mechanism/manifest.csv | geometry_checked_in_code_not_fabricated
M202 | 2 | measuring_wheel_shaft6h6_L57.75;collar7.5x2.25;bearing_seats6j5 | C45_ground | 8_round_bar | engineering/generated/mechanism/manifest.csv | geometry_checked_in_code_not_fabricated
M203 | 2 | measuring_bearing_housing46x46x59.5;626_seats_K6;coupling_window | EN_AW_6082-T6 | 50x50x65 | engineering/generated/mechanism/manifest.csv | geometry_checked_in_code_not_fabricated
M204 | 2 | pivot_arm100x40x12;hub30;626_seats_K6 | EN_AW_6082-T6 | 110x50x35 | engineering/generated/mechanism/manifest.csv | geometry_checked_in_code_not_fabricated
M206 | 2 | measuring_bracket;base71x112x12;slotted_column40x70;adjuster_lug | EN_AW_6082-T6 | 80x120x240 | engineering/generated/mechanism/manifest.csv | geometry_checked_in_code_not_fabricated
M207 | 2 | counter_roller_column;base36x48x10;column16x20x90 | EN_AW_6082-T6 | 40x50x105 | engineering/generated/mechanism/manifest.csv | geometry_checked_in_code_not_fabricated
M209 | 2 | arm_spring_cap14x5;spigot5.8x6;recess7x1.5 | C45 | 16_round_bar | engineering/generated/mechanism/manifest.csv | geometry_checked_in_code_not_fabricated
M210 | 2 | counter_roller_fork18x19x28;slot6.4;4mm_vertical_adjustment | EN_AW_6082-T6 | 20x22x32 | engineering/generated/mechanism/manifest.csv | geometry_checked_in_code_not_fabricated
F301 | 1 | machine_bed640x1120x25;tapped_H001/F201/M206/M207_patterns | EN_AW_6082_T651_tooling_plate | 650x1130x30 | engineering/generated/mechanism/manifest.csv | geometry_checked_in_code_not_fabricated
F302 | 2 | long_rail_square_tube60x60x3_L1080;M10_weld_nuts_under_top_wall | S235JR | 60x60x3_tube | engineering/generated/mechanism/manifest.csv | weldment_not_fabricated
F303 | 2 | cross_rail_square_tube60x60x3_L440 | S235JR | 60x60x3_tube | engineering/generated/mechanism/manifest.csv | weldment_not_fabricated
F304 | 4 | leg_square_tube60x60x3_L760 | S235JR | 60x60x3_tube | engineering/generated/mechanism/manifest.csv | weldment_not_fabricated
F305 | 4 | foot_plate100x100x8;4x13_anchor_holes | S235JR | 100x100x8 | engineering/generated/mechanism/manifest.csv | weldment_not_fabricated
G101 | 1 | preliminary_left_guard_panel5mm;DC01_2mm_powder_coat_RAL7035;30mm_wire_pass_through_not_a_safety_gap | DC01_2mm_powder_coated | 2mm_sheet | docs/26-guard-and-payoff-selection.md | selected_design_not_fabricated
G102 | 1 | preliminary_right_guard_panel5mm;DC01_2mm_powder_coat_RAL7035;30mm_wire_pass_through_not_a_safety_gap | DC01_2mm_powder_coated | 2mm_sheet | docs/26-guard-and-payoff-selection.md | selected_design_not_fabricated
G103 | 1 | preliminary_fixed_rear_guard_panel5mm;DC01_2mm_powder_coat_RAL7035 | DC01_2mm_powder_coated | 2mm_sheet | docs/26-guard-and-payoff-selection.md | selected_design_not_fabricated
G104 | 1 | preliminary_guard_roof5mm;DC01_2mm_powder_coat_RAL7035 | DC01_2mm_powder_coated | 2mm_sheet | docs/26-guard-and-payoff-selection.md | selected_design_not_fabricated
G105 | 1 | preliminary_closed_front_door5mm;5mm_PC_door_in_20x20x2_S235JR_tube_frame;hinges_handle_actuator_purchase_to_requirement | PC5mm_plus_S235JR_20x20x2_tube | 5mm_PC_sheet_plus_tube | docs/26-guard-and-payoff-selection.md | selected_design_not_fabricated
G106 | 1 | preliminary_guard_lock_mounting_plate;S235JR_5mm_welded_jamb_plate;SLC_drilling_pattern_requires_manufacturer_drawing | S235JR | 5mm_plate | docs/26-guard-and-payoff-selection.md | selected_design_not_fabricated
P001 | 1 | provisional_payoff_spool_envelope_OD400x160;S235JR_3mm_laser_flanges_OD400_with_60.5_bore;hub_tube_60x2.5_160;8xM8_tie_rods | S235JR_plus_ERW_tube | 3mm_sheet_plus_60x2.5_tube | docs/26-guard-and-payoff-selection.md | selected_design_not_fabricated
P002 | 1 | provisional_payoff_spindle_envelope39mm;C45_20h6_ground_L680;M20x1.5_ends;60x50_keyed_boss;brake_and_bearing_selection_in_R2 | C45_ground | 20_round_bar | docs/26-guard-and-payoff-selection.md | selected_design_not_fabricated
P003 | 1 | provisional_payoff_base_envelope430x560x8;S235JR_430x560x8;4x13_anchor_holes | S235JR | 8mm_plate_430x560 | docs/26-guard-and-payoff-selection.md | selected_design_not_fabricated
P004 | 1 | provisional_payoff_left_support_post_envelope60x70;S235JR_18mm_plate;47H7_bearing_pocket;welded_to_base | S235JR | 18mm_plate | docs/26-guard-and-payoff-selection.md | selected_design_not_fabricated
P005 | 1 | provisional_payoff_right_support_post_envelope60x70;S235JR_18mm_plate;47H7_bearing_pocket;welded_to_base | S235JR | 18mm_plate | docs/26-guard-and-payoff-selection.md | selected_design_not_fabricated
P006 | 1 | payoff_brake_disc_180x6;S235JR;20H7_hub_bore_with_keyway;outboard_of_right_post | S235JR | 180x6_plate | docs/26-guard-and-payoff-selection.md | selected_design_not_fabricated
P007 | 1 | payoff_brake_caliper;S235JR_bracket_plus_2x_pads_40x20x8;M8_adjuster_with_SWU_class_spring;friction_tension_not_safety_brake | S235JR_plus_friction_pads | 40x20x8_pads | docs/26-guard-and-payoff-selection.md | selected_design_not_fabricated
P008 | 1 | keyed_spool_drive_boss_54.6x12;20H7_bore_plus_6JS9_keyseat;welded_to_left_flange_inside_hub;transmits_brake_torque | C45 | 60_round_bar | docs/26-guard-and-payoff-selection.md | selected_design_not_fabricated
