sbelakho2/Cutting/bom/selected-controls.csv

id | quantity | manufacturer | exact_order | source_url | observed_unit | price_basis | checked_date | release_status | interface_or_hold
CT-MCU01 | 1 | Raspberry Pi | Raspberry Pi Pico 2 SC1631 | https://www.raspberrypi.com/products/raspberry-pi-pico-2/ | USD5.00 | manufacturer_list_from_price_no_freight | 2026-09-13 | selected_unqualified | RP2350; 26 GPIO at 3.3 V only; USB CDC commissioning/service endpoint; no physical-machine validation
CT-IF01 | 1 | STARZ | IF-B01 interface board | in-house |  | not_quoted | 2026-09-13 | draft_custom_design | Native KiCad four-layer 750 x 400 mm source is placed/routed; ERC, physical DRC and schematic parity are clean and a SHA-256-marked draft output package exists; human layout/fabricator review, assembled board and fixture records remain open
CT-IF-U1 | 1 | Texas Instruments | AM26LV32EIDR | https://www.ti.com/product/AM26LV32E |  | not_observed | 2026-09-13 | draft_IF-B01_component | 3.3 V quad RS-422 receiver for two encoder A/B pairs; current draft placement exists but electrical, footprint and physical review remain open
CT-IF-U2-U3 | 2 | Texas Instruments | TPL7407LDR | https://www.ti.com/product/TPL7407L |  | not_observed | 2026-09-13 | draft_IF-B01_component | 40 V seven-channel low-side NMOS arrays; U2 PUL/DIR channels, U3 FR_DIR/ENA/green/red/buzzer; U3 unused channels tied low/no field connection
CT-SR01 | 1 | Schneider Electric | Harmony XPSUAF13AP | https://www.automation24.com/safety-relay-schneider-electric-harmony-xpsuaf13ap | EUR133.50 | automation24_ex_VAT_no_freight | 2026-09-13 | selected_system_unqualified | 24 VAC/DC safety relay; selected configuration concept is application selector 1/start selector 3; three NO safety outputs; Z1 is diagnostic only; see docs/22
CT-ES01 | 1 | Siemens | SIRIUS ACT 3SU1851-0NB00-2AC2 | https://www.automation24.com/emergency-stop-off-button-complete-unit-siemens-sirius-act-3su1851-0nb00-2ac2 | EUR110.70 | automation24_ex_VAT_no_freight | 2026-09-13 | selected_system_unqualified | Red mushroom; two independent NC contacts for the two XPS input channels; actual safety-function validation remains open
CT-GL01 | 1 | Bernstein | SLC-F-024-20/20-R4 article 6018200007 | https://www.automation24.com/mechanical-switch-with-guard-locking-bernstein-slc-f-024-20-20-r4-6018200007 | EUR143.50 | automation24_ex_VAT_no_freight | 2026-09-13 | selected_system_unqualified | 24 VAC/DC spring-force guard lock; two NC interlock contacts plus two NC locked-state contacts; public page observed EUR143.50 plus VAT/dispatch; E1/E2 release circuit deliberately unresolved
CT-GLA01 | 1 | Bernstein | ACF-1 article 3911742391 | https://www.automation24.com/actuator-bernstein-acf-1-3911742391 | EUR17.90 | automation24_ex_VAT_no_freight | 2026-09-13 | selected_system_unqualified | Compatible guard actuator; public page observed EUR17.90 plus VAT/dispatch, 60 x 40 x 52.6 mm and 400 mm minimum actuation radius; mechanical fit and guard-release risk assessment remain open
CT-K1-K3 | 3 | Schneider Electric | TeSys Deca LC1D12BD | https://www.automation24.com/main-contactor-schneider-electric-tesys-lc1d12bd | EUR70.40 | automation24_ex_VAT_no_freight | 2026-09-13 | selected_DC_duty_qualified | 24 VDC coil; three NO main poles, 13-14 NO and mirror-certified 21-22 NC auxiliary; proposed one per 60 V/60 V/36 V supply; DC duty QUALIFIED 2026-09-16 from the TeSys Deca 2026 catalogue A5/120-121 (3 poles in series: 20 A at <=75 V in DC-1 and DC-2..5, margins 3.45x/2.06x vs 5.8/9.7 A; docs/22 11.1); measured opening behavior and contact durability remain commissioning checks
CT-FSR01 | 1 | Phoenix Contact | Phoenix 3046032 fuse terminal + 2 A 5x20 link | https://www.conrad.com/en/p/phoenix-contact-3046032-fuse-serial-terminal-6-2-mm-screws-black-1-pc-s-744510.html | EUR7.99 | conrad_incl_VAT_observed_2026-09-16_terminal;link_EUR1.49_incl_VAT | 2026-09-16 | selected_coordination_comparison_open | XPS output fuse realized as the 3046032 5x20 fused terminal (6.3 A rated, EUR7.99 incl VAT, 34 in stock) plus an ESKA 522620 2 A T 5x20 link (EUR1.49 incl VAT, 1368 in stock, https://www.conrad.com/en/p/eska-522620-522620-dc-fuse-o-x-l-5-mm-x-20-mm-2-a-250-v-dc-time-delay-t-content-1-pc-s-1414701.html, listed as a 250 V DC T link); replaces the DF2CN02 10x38 link and closes the 10x38 holder hold; load ~0.45 A; the explicit clearing-curve/breaking-capacity/relay-I2t comparison required by docs/22 11.3 (audit F27a) is NOT yet recorded - the 2 A value stays provisional
CT-PB01 | 1 | Siemens | SIRIUS ACT 3SU1152-0AB40-1BA0 | https://www.automation24.com/illuminated-pushbutton-complete-unit-siemens-sirius-act-3su1152-0ab40-1ba0 | EUR22.00 | automation24_ex_VAT_no_freight | 2026-09-13 | selected_unqualified | START; green illuminated; one NO contact; normal controller input only
CT-PB02 | 1 | Siemens | SIRIUS ACT 3SU1152-0AB20-1CA0 | https://www.automation24.com/illuminated-pushbutton-complete-unit-siemens-sirius-act-3su1152-0ab20-1ca0 | EUR22.00 | automation24_ex_VAT_no_freight | 2026-09-13 | selected_unqualified | STOP; red illuminated; one NC contact; normal software stop only, not an E-stop
CT-PB03 | 1 | Siemens | SIRIUS ACT 3SU1152-0AB50-1BA0 | https://www.automation24.com/illuminated-pushbutton-complete-unit-siemens-sirius-act-3su1152-0ab50-1ba0 | EUR22.00 | automation24_ex_VAT_no_freight | 2026-09-13 | selected_system_unqualified | RESET/ACK; one NO contact drives distinct KA3 and KSR1 coils in parallel; cannot reuse one relay contact for both functions
CT-BZ01 | 1 | Siemens | SIRIUS ACT 3SU1200-6LB10-1AA0 | https://www.automation24.com/acoustic-indicator-complete-device-siemens-sirius-act-3su1200-6lb10-1aa0 | EUR46.10 | automation24_ex_VAT_no_freight | 2026-09-13 | selected_unqualified | 24 VAC/DC acoustic indicator; low-side IF-B01 output only after board qualification
CT-PS24 | 1 | Siemens | LOGO!POWER 6EP3332-6SB00-0AY0 | https://www.automation24.com/siemens-logo-power-24v-2-5a-6ep3332-6sb00-0ay0 | EUR68.60 | automation24_ex_VAT_no_freight | 2026-09-13 | selected_load_calculation_open | 24 VDC / 2.5 A control supply; final load, inrush, branch fuse and voltage-drop calculation remains open
CT-PS05 | 1 | Siemens | LOGO!POWER 6EP3310-6SB00-0AY0 | https://mall.industry.siemens.com/mall/en/WW/Catalog/Product/6EP3310-6SB00-0AY0 | USD124.88 | digikey_list_price_no_freight_2026-09-13;identity_verified_maker_record_2026-10-13 | 2026-10-13 | selected_identity_verified_load_calculation_open | 5 VDC / 3 A supply for Pico VSYS and the encoder branches through IF-B01; maker product record confirms 5 V, +-3 % overall tolerance, adjustable 4.6-5.4 V, 3 A, 4.7 W typical loss at rated output; set to 5.2 V at commissioning (docs/22 11.9); no AHCT/LVC architecture is selected
CT-RC01 | 11 | Phoenix Contact | PLC-RSC-24DC/21 2966171 | https://www.digikey.com/en/products/detail/phoenix-contact/2966171/349700 | USD16.13 | digikey_unit_no_freight | 2026-09-13 | selected_load_and_interface_review_open | KA1–KA10 field/alarm relay couplers (START, STOP_OK, RESET monitor, XPS diagnostic, two home sensors, four driver alarms) plus R2, the E1/E2 release-permission relay (docs/22 11.8, 2026-10-13); exact coil/load compatibility and cabinet terminal allocation require review
CT-KSR1 | 1 | Phoenix Contact | PLC-RSC-24DC/21 2966171 | https://www.digikey.com/en/products/detail/phoenix-contact/2966171/349700 | USD16.13 | digikey_unit_no_freight | 2026-09-13 | proposed_reset_interposing_relay | Dedicated KSR1 relay for the XPS Y1/Y2 monitored falling-edge reset/EDM chain; separate from KA3; safety-function suitability remains to be validated
CT-HS01 | 2 | ifm electronic | IE5338 IEBC003BASKG/AS-514 | https://www.automation24.com/inductive-sensor-ifm-electronic-ie5338-iebc003baskg-as | EUR53.00 | automation24_ex_VAT_no_freight | 2026-09-13 | selected_interface_review_open | M8 10–30 VDC PNP NO blade-open home sensors; actual sensor-to-relay coil compatibility and installation remain open
CT-PS60 | 2 | STEPPERONLINE | LE-350-60 | https://www.omc-stepperonline.com/350w-60v-5-8a-115-230v-switching-power-supply-stepper-motor-cnc-router-kits-le-350-60 | USD17.88 | merchandise_only_no_freight | 2026-09-13 | selected_DC_power_release_open | One isolated 60 V / 5.8 A source per blade driver; K1/K2 interruption, branch fusing, regeneration and bus discharge are unresolved
CT-PS36 | 1 | STEPPERONLINE | LE-350-36 | https://www.omc-stepperonline.com/350w-36v-9-7a-115-230v-switching-power-supply-stepper-motor-cnc-router-kits-le-350-36 |  | not_observed | 2026-09-13 | selected_DC_power_release_open | 36 V / 9.7 A feed source; K3 interruption, two protected driver branches, regeneration and bus discharge are unresolved
CT-AUX01 | 3 | Schneider Electric | LADN02 2 NC front auxiliary contact block | https://www.automation24.com/search?search=LADN02 |  | not_observed_2026-10-13_automation24_conrad_fetch_blocked | 2026-10-13 | selected_release_chain_identity_price_not_observed | Second dedicated NC contacts (one per K1-K3 LC1D12BD) for the E1/E2 release-permission chain; DC-coil LC1D09...D38 accept exactly one front block, 1-contact LADN01 is not offered (TeSys Deca catalogue 2026 B8/43-44); the add-on NC is not a catalogued mirror contact - docs/22 11.8
CT-T2 | 1 | Finder | 80.01.0.240.0000 | https://www.conrad.com/en/search?search=80.01.0.240.0000 |  | not_observed_2026-10-13_automation24_conrad_fetch_blocked | 2026-10-13 | selected_release_chain_timer_price_not_observed | On-delay timer T2 for the E1/E2 release chain (docs/22 11.8): DIN-rail multifunction time relay 24-240 V AC/DC, 1 CO 16 A configured on-delay; set to the measured bus decay + >=1 s; exact identity and price to confirm at purchase
CT-PB04 | 1 | Siemens | SIRIUS ACT 3SU1152-0AB40-1BA0 | https://www.automation24.com/illuminated-pushbutton-complete-unit-siemens-sirius-act-3su1152-0ab40-1ba0 | EUR22.00 | automation24_ex_VAT_no_freight | 2026-09-13 | selected_release_chain_request_input | GUARD RELEASE REQUEST pushbutton PB04 in the E1/E2 release chain (docs/22 11.8); same identity as START PB01, green momentary 1 NO; hold-to-release; not a safety device by itself
HOLD-TERMINALS-PE-ENCLOSURE | 1 | UNSELECTED | Cabinet terminal system PE bar enclosure glands ferrules and cable |  |  |  |  | release_hold_not_for_procurement | No exact product is selected; do not purchase or infer a physical cabinet wiring release from logical TB24/TB-S/TB-M designations
