sbelakho2/Cutting/bom/selected-cutting-head.csv

id | quantity | manufacturer | exact_order | source | status | observed_unit_usd | price_basis | interface
AX-01 | 1 | STARZ | Custom S1-B cut axis assembly (docs/39): 2x HGR20 400mm rail+block sets + SFU1610-class C7 500mm screw (10mm lead) + nut + DSG16h + BK12/BF12 + H005 base + H006 carriage per axis | custom_design_not_released |  | component_lines_AX-R01/AX-S01 | Two axes: rail 440 total | carriage pad 60x75 at 46mm | Ø8x18 screw end; one frozen config: 10mm lead | CL86T-V41 at 1000 pulses/rev | 100 pulses/mm=1000/10 (shared/cutting_head_spec.hpp); loads per docs/39 (audit F15 states the acceptance-load revalidation remains open)
AX-R01 | 4 | CNC HGR20-class | HGR20 400mm linear rail + 2x HGH20CA block set | https://taiyin6666.en.made-in-china.com/product/ztLrHCpjCsci/China-Hgr20-High-Accuracy-High-Qualit-Linear-Guide-Rail-Set-Hgr20-400mm-Hg20-Linear-Rail-and-Bloc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 |  | 8.00-13.00 | FOB_USD_range_MOQ1_observed_2026-09-17 | Two rail+block sets per axis; blocks HGH20CA; rails bolt M5 at 60mm pitch
AX-S01 | 2 | Sair/C7-class | SFU1610-class C7 500mm rolled ballscrew, 10mm lead, end-machined + flange nut + DSG16h housing + BK12/BF12 supports | https://autolinearmotion.en.made-in-china.com/product/PtaYZwvVEukB/China-Sfu1605-500mm-600mm-800mm-C7-with-End-Machined-1605-Ball-Nut-Housing-Bk-Bf12-End-Supp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 |  | 5.00-10.00 | FOB_USD_range_MOQ1_observed_2026-09-17 | One frozen config (docs/39 §3): 10mm lead; CL86T-V41 driver setting 1000 pulses/rev; steps/mm = pulses_per_rev/lead_mm = 1000/10 = 100, matching the firmware constant (shared/cutting_head_spec.hpp, blade_steps_per_mm in shared/controls_spec.hpp); screw end machined Ø8 h7 x18 exposed (R+W MK2/100/50/8/14 hub); DSG16h housing; no 5mm-lead option in this build
H005 | 2 | STARZ | H005 S1-B axis base plate | 6082-T6 plate and qualified machining | custom_design_not_released |  | not_quoted | 20x86x440; rail seats milled; BK12/BF12 lands; 6xØ6.6 base grid 46/100; sheet H005-H006
H006 | 2 | STARZ | H006 S1-B carriage plate | 6082-T6 plate and qualified machining | custom_design_not_released |  | not_quoted | 60x75 pad at 46mm; Ø49.97 F0 register + 4xM5 PCD70 + 46x46 4xM6; DSG16h nut pocket; 4x HGH20CA lands; sheet H005-H006
DR-01 | 2 | STEPPERONLINE | 1-CL86T-P85-V41 | STEPPERONLINE direct | catalogue_selected | 130.77 | merchandise_only_no_freight | 34E1K-85+CL86T-V41+CM2M-18+CE2M+CABLE-PC-1;134.1mm rear motor envelope
CP-01 | 2 | R+W | MK2/100/50/8/14 | ebmia.pl quote order path / R+W dealer | configured_catalogue_selected |  | not_observed_exact_bores;ebmia_quote_order_path;class_anchor_MK2_100_50_10_14_EUR99.43_net_observed_2026-09-16;SBK19_8_14_32Nm_jaw_rejected_backlash_0.5deg_14um_vs_25um_positioning | 10Nm;40OD;50L;16mm hubs;8H7/14H7
PS-01 | 2 | STEPPERONLINE | LE-350-60 | STEPPERONLINE direct | catalogue_selected_electrical_release_pending | 17.88 | merchandise_only_no_freight | 60V5.8A;one per axis;no paralleling;bus protection separate
H001 | 1 | STARZ | H001 S1-B ground datum | Local certified steel stock and qualified machining | custom_design_not_released |  | not_quoted | 180x1040x20;see STEP and drawing requirements
H002 | 2 | STARZ | H002 S1-B riser | Local certified steel stock and qualified machining | custom_design_not_released |  | not_quoted | 110x355x20;actual six-hole stage grid
H003 | 2 | STARZ | H003 R6 motor adapter | 42CrMo4+QT certified650MPa minimum yield and qualified machining | custom_design_not_released |  | not_quoted | 100x100x15;F0_PCD70_M5_with9.5x8.5counterbores;motor69.58mm_grid_M5;73.10pilot;A3drawing_generated
HF0-B | 8 | standard | ISO4762 M5x16 class10.9 | Traceable industrial fastener supplier | geometry_selected_joint_preload_pending |  | not_quoted | F0_stage_mounting;ISO7092_M5washer;8.5nominal_thread_engagement
HM-B | 8 | standard | ISO4762 M5x25 class10.9 | Traceable industrial fastener supplier | geometry_selected_joint_preload_pending |  | not_quoted | Original9mm_motor_flange;1mmwasher;15mm_adapter_thread_engagement_nominal
HM-W | 16 | standard | ISO7092 M5 200HV 5.3x9x1 | Traceable industrial fastener supplier | geometry_selected_joint_preload_pending |  | not_quoted | Reduced_OD9mm_fits9.5mm_counterbore;not_ISO7089_OD10washer
H004 | 2 | STARZ | H004 S1-B monolithic holder | 42CrMo4+QT with certified650MPa minimum yield | custom_design_not_released |  | not_quoted | Actual STEP load path;ground blade seat;no printed structural parts
T001 | 1 | Tooling supplier | PURCHASE_TO_DRAWING matched90deg V pair | Specialist tool grinding and heat treatment | not_catalogue_selected_not_qualified |  | not_quoted | 49x38x3 envelope;edge grind and loaded clearance qualification required
H007 | 2 | STARZ | H007 S1-B blade backing plate | 42CrMo4+QT certified 650MPa minimum yield | custom_design_not_released |  | not_quoted | 30x46x8; shimmed blade seat; carries the 1200 N blade reaction (docs/39? no - audit F22; face gap set at assembly docs/34)
