sbelakho2/Cutting/hardware/if-b01/review/if-b01-native-bom.csv

Reference | Value | Footprint | Manufacturer | MPN | Description | Quantity | DNP
C1 | 100nF 16V | IFB01:C_0603_1608 | Murata | GRM188R71C104KA01D | 100 nF 16 V X7R ceramic decoupler | 1
C2 | 100nF 50V | IFB01:C_0603_1608 | Murata | GRM188R71H104KA93D | 100 nF 50 V X7R ceramic bypass capacitor | 1
C3 | 100nF 50V | IFB01:C_0603_1608 | Murata | GRM188R71H104KA93D | 100 nF 50 V X7R ceramic bypass capacitor | 1
C4 | 10nF 16V | IFB01:C_0603_1608 | Murata | GRM188R71C103KA01D | 10 nF 16 V X7R input filter | 1
C5 | 10nF 16V | IFB01:C_0603_1608 | Murata | GRM188R71C103KA01D | 10 nF 16 V X7R input filter | 1
C6 | 10nF 16V | IFB01:C_0603_1608 | Murata | GRM188R71C103KA01D | 10 nF 16 V X7R input filter | 1
C7 | 10nF 16V | IFB01:C_0603_1608 | Murata | GRM188R71C103KA01D | 10 nF 16 V X7R input filter | 1
C8 | 10nF 16V | IFB01:C_0603_1608 | Murata | GRM188R71C103KA01D | 10 nF 16 V X7R input filter | 1
C9 | 10nF 16V | IFB01:C_0603_1608 | Murata | GRM188R71C103KA01D | 10 nF 16 V X7R input filter | 1
C10 | 10nF 16V | IFB01:C_0603_1608 | Murata | GRM188R71C103KA01D | 10 nF 16 V X7R input filter | 1
C11 | 10nF 16V | IFB01:C_0603_1608 | Murata | GRM188R71C103KA01D | 10 nF 16 V X7R input filter | 1
C12 | 10nF 16V | IFB01:C_0603_1608 | Murata | GRM188R71C103KA01D | 10 nF 16 V X7R input filter | 1
C13 | 10nF 16V | IFB01:C_0603_1608 | Murata | GRM188R71C103KA01D | 10 nF 16 V X7R input filter | 1
C14 | 100nF 16V | IFB01:C_0603_1608 | Murata | GRM188R71C104KA01D | 100 nF 16 V X7R bias filter | 1
C15 | 100nF 16V | IFB01:C_0603_1608 | Murata | GRM188R71C104KA01D | 100 nF 16 V X7R bias filter | 1
C16 | 100nF 16V | IFB01:C_0603_1608 | Murata | GRM188R71C104KA01D | 100 nF 16 V X7R bias filter | 1
C17 | 100nF 16V | IFB01:C_0603_1608 | Murata | GRM188R71C104KA01D | 100 nF 16 V X7R bias filter | 1
D1 | BZX384-C3V6 | IFB01:SOD_323 | Nexperia | BZX384-C3V6 | 3.6 V input clamp diode | 1
D2 | BZX384-C3V6 | IFB01:SOD_323 | Nexperia | BZX384-C3V6 | 3.6 V input clamp diode | 1
D3 | BZX384-C3V6 | IFB01:SOD_323 | Nexperia | BZX384-C3V6 | 3.6 V input clamp diode | 1
D4 | BZX384-C3V6 | IFB01:SOD_323 | Nexperia | BZX384-C3V6 | 3.6 V input clamp diode | 1
D5 | BZX384-C3V6 | IFB01:SOD_323 | Nexperia | BZX384-C3V6 | 3.6 V input clamp diode | 1
D6 | BZX384-C3V6 | IFB01:SOD_323 | Nexperia | BZX384-C3V6 | 3.6 V input clamp diode | 1
D7 | BZX384-C3V6 | IFB01:SOD_323 | Nexperia | BZX384-C3V6 | 3.6 V input clamp diode | 1
D8 | BZX384-C3V6 | IFB01:SOD_323 | Nexperia | BZX384-C3V6 | 3.6 V input clamp diode | 1
D9 | BZX384-C3V6 | IFB01:SOD_323 | Nexperia | BZX384-C3V6 | 3.6 V input clamp diode | 1
D10 | BZX384-C3V6 | IFB01:SOD_323 | Nexperia | BZX384-C3V6 | 3.6 V input clamp diode | 1
F1 | MF-MSMF050/60X | IFB01:PTC_1812 | Bourns | MF-MSMF050/60X | 0.50 A hold 60 V 1812 SMD resettable PTC; +24V_TPL_COM branch; pads per the Bourns recommended layout (1.68 x 2.95 mm, 3.1 mm gap) | 1
F2 | MF-MSMF050/16X | IFB01:PTC_1812 | Bourns | MF-MSMF050/16X | 0.50 A hold 16 V 1812 SMD resettable PTC; one per encoder 5 V branch; pads per the Bourns recommended layout (1.68 x 2.95 mm, 3.1 mm gap) | 1
F3 | MF-MSMF050/16X | IFB01:PTC_1812 | Bourns | MF-MSMF050/16X | 0.50 A hold 16 V 1812 SMD resettable PTC; one per encoder 5 V branch; pads per the Bourns recommended layout (1.68 x 2.95 mm, 3.1 mm gap) | 1
J1 | Pico 2 SC1631 left socket | IFB01:PICO_SOCKET_1X20 | Samtec | SSQ-120-23-G-S | Pico 2 left socket row | 1
J2 | Pico 2 SC1631 right socket | IFB01:PICO_SOCKET_1X20_RIGHT | Samtec | SSQ-120-23-G-S | Pico 2 right socket row | 1
J3 | 1759033 | IFB01:MSTB_2_5_4_G_5_08 | Phoenix Contact | 1759033 | 4-position 5.08 mm PCB plug header | 1
J4 | 1759033 | IFB01:MSTB_2_5_4_G_5_08 | Phoenix Contact | 1759033 | blade-front drive 4-position PCB plug header | 1
J5 | 1759033 | IFB01:MSTB_2_5_4_G_5_08 | Phoenix Contact | 1759033 | blade-rear drive 4-position PCB plug header | 1
J6 | 1759033 | IFB01:MSTB_2_5_4_G_5_08 | Phoenix Contact | 1759033 | feed-left drive 4-position PCB plug header | 1
J7 | 1759033 | IFB01:MSTB_2_5_4_G_5_08 | Phoenix Contact | 1759033 | feed-right drive 4-position PCB plug header | 1
J8 | 1759059 | IFB01:MSTB_2_5_6_G_5_08 | Phoenix Contact | 1759059 | left encoder 6-position PCB plug header | 1
J9 | 1759059 | IFB01:MSTB_2_5_6_G_5_08 | Phoenix Contact | 1759059 | right encoder 6-position PCB plug header | 1
J10 | 1759114 | IFB01:MSTB_2_5_12_G_5_08 | Phoenix Contact | 1759114 | field-contact 12-position PCB plug header | 1
J11 | 1759091 | IFB01:MSTB_2_5_8_G_5_08 | Phoenix Contact | 1759091 | drive-alarm 8-position PCB plug header | 1
J12 | 1759033 | IFB01:MSTB_2_5_4_G_5_08 | Phoenix Contact | 1759033 | indicator and buzzer 4-position PCB plug header | 1
MH1 | M3 3.2mm | IFB01:MountingHole_3_2mm_M3 | Keystone | 9903 | M3 nylon board mounting hardware set | 1
MH2 | M3 3.2mm | IFB01:MountingHole_3_2mm_M3 | Keystone | 9903 | M3 nylon board mounting hardware set | 1
MH3 | M3 3.2mm | IFB01:MountingHole_3_2mm_M3 | Keystone | 9903 | M3 nylon board mounting hardware set | 1
MH4 | M3 3.2mm | IFB01:MountingHole_3_2mm_M3 | Keystone | 9903 | M3 nylon board mounting hardware set | 1
P3 | 1757233 |  | Phoenix Contact | 1757233 | matching 4-position 5.08 mm screw plug for J3 | 1
P4 | 1757233 |  | Phoenix Contact | 1757233 | matching 4-position 5.08 mm screw plug for J4 | 1
P5 | 1757233 |  | Phoenix Contact | 1757233 | matching 4-position 5.08 mm screw plug for J5 | 1
P6 | 1757233 |  | Phoenix Contact | 1757233 | matching 4-position 5.08 mm screw plug for J6 | 1
P7 | 1757233 |  | Phoenix Contact | 1757233 | matching 4-position 5.08 mm screw plug for J7 | 1
P8 | 1757259 |  | Phoenix Contact | 1757259 | matching 6-position 5.08 mm screw plug for J8 | 1
P9 | 1757259 |  | Phoenix Contact | 1757259 | matching 6-position 5.08 mm screw plug for J9 | 1
P10 | 1757314 |  | Phoenix Contact | 1757314 | matching 12-position 5.08 mm screw plug for J10 | 1
P11 | 1757291 |  | Phoenix Contact | 1757291 | matching 8-position 5.08 mm screw plug for J11 | 1
P12 | 1757233 |  | Phoenix Contact | 1757233 | matching 4-position 5.08 mm screw plug for J12 | 1
R5 | 100k | IFB01:R_0603_1608 | Yageo | RC0603FR-07100KL | 100 kiloohm 1 percent GP17 pull-down | 1
R6 | 1k | IFB01:R_0603_1608 | Yageo | RC0603FR-071KL | 1 kiloohm GPIO output series resistors | 1
R7 | 1k | IFB01:R_0603_1608 | Yageo | RC0603FR-071KL | 1 kiloohm GPIO output series resistors | 1
R8 | 1k | IFB01:R_0603_1608 | Yageo | RC0603FR-071KL | 1 kiloohm GPIO output series resistors | 1
R9 | 1k | IFB01:R_0603_1608 | Yageo | RC0603FR-071KL | 1 kiloohm GPIO output series resistors | 1
R10 | 1k | IFB01:R_0603_1608 | Yageo | RC0603FR-071KL | 1 kiloohm GPIO output series resistors | 1
R11 | 1k | IFB01:R_0603_1608 | Yageo | RC0603FR-071KL | 1 kiloohm GPIO output series resistors | 1
R12 | 1k | IFB01:R_0603_1608 | Yageo | RC0603FR-071KL | 1 kiloohm GPIO output series resistors | 1
R13 | 1k | IFB01:R_0603_1608 | Yageo | RC0603FR-071KL | 1 kiloohm GPIO output series resistors | 1
R14 | 1k | IFB01:R_0603_1608 | Yageo | RC0603FR-071KL | 1 kiloohm GPIO output series resistors | 1
R15 | 1k | IFB01:R_0603_1608 | Yageo | RC0603FR-071KL | 1 kiloohm GPIO output series resistors | 1
R16 | 1k | IFB01:R_0603_1608 | Yageo | RC0603FR-071KL | 1 kiloohm GPIO output series resistors | 1
R17 | 1k | IFB01:R_0603_1608 | Yageo | RC0603FR-071KL | 1 kiloohm GPIO output series resistors | 1
R18 | 10k | IFB01:R_0603_1608 | Yageo | RC0603FR-0710KL | 10 kiloohm input series resistors | 1
R19 | 10k | IFB01:R_0603_1608 | Yageo | RC0603FR-0710KL | 10 kiloohm input series resistors | 1
R20 | 10k | IFB01:R_0603_1608 | Yageo | RC0603FR-0710KL | 10 kiloohm input series resistors | 1
R21 | 10k | IFB01:R_0603_1608 | Yageo | RC0603FR-0710KL | 10 kiloohm input series resistors | 1
R22 | 10k | IFB01:R_0603_1608 | Yageo | RC0603FR-0710KL | 10 kiloohm input series resistors | 1
R23 | 10k | IFB01:R_0603_1608 | Yageo | RC0603FR-0710KL | 10 kiloohm input series resistors | 1
R24 | 10k | IFB01:R_0603_1608 | Yageo | RC0603FR-0710KL | 10 kiloohm input series resistors | 1
R25 | 10k | IFB01:R_0603_1608 | Yageo | RC0603FR-0710KL | 10 kiloohm input series resistors | 1
R26 | 10k | IFB01:R_0603_1608 | Yageo | RC0603FR-0710KL | 10 kiloohm input series resistors | 1
R27 | 10k | IFB01:R_0603_1608 | Yageo | RC0603FR-0710KL | 10 kiloohm input series resistors | 1
R28 | 47k | IFB01:R_0603_1608 | Yageo | RC0603FR-0747KL | 47 kiloohm 1 percent input pull-up resistors | 1
R29 | 47k | IFB01:R_0603_1608 | Yageo | RC0603FR-0747KL | 47 kiloohm 1 percent input pull-up resistors | 1
R30 | 47k | IFB01:R_0603_1608 | Yageo | RC0603FR-0747KL | 47 kiloohm 1 percent input pull-up resistors | 1
R31 | 47k | IFB01:R_0603_1608 | Yageo | RC0603FR-0747KL | 47 kiloohm 1 percent input pull-up resistors | 1
R32 | 47k | IFB01:R_0603_1608 | Yageo | RC0603FR-0747KL | 47 kiloohm 1 percent input pull-up resistors | 1
R33 | 47k | IFB01:R_0603_1608 | Yageo | RC0603FR-0747KL | 47 kiloohm 1 percent input pull-up resistors | 1
R34 | 47k | IFB01:R_0603_1608 | Yageo | RC0603FR-0747KL | 47 kiloohm 1 percent input pull-up resistors | 1
R35 | 47k | IFB01:R_0603_1608 | Yageo | RC0603FR-0747KL | 47 kiloohm 1 percent input pull-up resistors | 1
R36 | 47k | IFB01:R_0603_1608 | Yageo | RC0603FR-0747KL | 47 kiloohm 1 percent input pull-up resistors | 1
R37 | 47k | IFB01:R_0603_1608 | Yageo | RC0603FR-0747KL | 47 kiloohm 1 percent input pull-up resistors | 1
R38 | 10k | IFB01:R_0603_1608 | Yageo | RC0603FR-0710KL | 10 kiloohm 1 percent receiver mid-bias divider resistors | 1
R39 | 10k | IFB01:R_0603_1608 | Yageo | RC0603FR-0710KL | 10 kiloohm 1 percent receiver mid-bias divider resistors | 1
R40 | 10k | IFB01:R_0603_1608 | Yageo | RC0603FR-0710KL | 10 kiloohm 1 percent receiver mid-bias divider resistors | 1
R41 | 10k | IFB01:R_0603_1608 | Yageo | RC0603FR-0710KL | 10 kiloohm 1 percent receiver mid-bias divider resistors | 1
R42 | 10k | IFB01:R_0603_1608 | Yageo | RC0603FR-0710KL | 10 kiloohm 1 percent receiver mid-bias divider resistors | 1
R43 | 10k | IFB01:R_0603_1608 | Yageo | RC0603FR-0710KL | 10 kiloohm 1 percent receiver mid-bias divider resistors | 1
R44 | 10k | IFB01:R_0603_1608 | Yageo | RC0603FR-0710KL | 10 kiloohm 1 percent receiver mid-bias divider resistors | 1
R45 | 10k | IFB01:R_0603_1608 | Yageo | RC0603FR-0710KL | 10 kiloohm 1 percent receiver mid-bias divider resistors | 1
TP1 | TP +24V_PELV | IFB01:TestPoint_1_0mm | Keystone | 5000 | loop test point | 1
TP2 | TP +5V_LOGIC | IFB01:TestPoint_1_0mm | Keystone | 5000 | loop test point | 1
TP3 | TP 3V3_MCU | IFB01:TestPoint_1_0mm | Keystone | 5000 | loop test point | 1
TP4 | TP 0V_PELV | IFB01:TestPoint_1_0mm | Keystone | 5000 | loop test point | 1
TP5 | TP DRV_ENA_NEG | IFB01:TestPoint_1_0mm | Keystone | 5000 | loop test point | 1
TP6 | TP GP0 | IFB01:TestPoint_1_0mm | Keystone | 5000 | loop test point | 1
TP7 | TP GP8 | IFB01:TestPoint_1_0mm | Keystone | 5000 | loop test point | 1
TP8 | TP GP10 | IFB01:TestPoint_1_0mm | Keystone | 5000 | loop test point | 1
TP9 | TP L_ENC_A_N | IFB01:TestPoint_1_0mm | Keystone | 5000 | loop test point | 1
TP10 | TP L_ENC_B_N | IFB01:TestPoint_1_0mm | Keystone | 5000 | loop test point | 1
TP11 | TP R_ENC_A_N | IFB01:TestPoint_1_0mm | Keystone | 5000 | loop test point | 1
TP12 | TP R_ENC_B_N | IFB01:TestPoint_1_0mm | Keystone | 5000 | loop test point | 1
U1 | AM26LV32EIDR | IFB01:SOIC_16_3_9x9_9_P1_27 | Texas Instruments | AM26LV32EIDR | 3.3 V quad RS-422 differential receiver | 1
U2 | TPL7407LDR | IFB01:SOIC_16_3_9x9_9_P1_27 | Texas Instruments | TPL7407LDR | 40 V seven-channel low-side NMOS driver; PUL/DIR channels | 1
U3 | TPL7407LDR | IFB01:SOIC_16_3_9x9_9_P1_27 | Texas Instruments | TPL7407LDR | 40 V seven-channel low-side NMOS driver; ENA/indicator/buzzer channels | 1
