sbelakho2/Cutting/engineering/generated/measurement/manifest.csv

id | description | volume_mm3 | xmin_mm | ymin_mm | zmin_mm | xmax_mm | ymax_mm | zmax_mm
ME-W01 | ifm E60137 measuring wheel dimensioned external/bore/thread envelope;U:200 N:06 | 30519.2505979 | -31.83 | -1e-07 | -31.83 | 31.83 | 14.5000001 | 31.83
ME-E01 | ifm RU3100 synchro-flange dimensioned body/shaft/flange envelope | 171317.691869 | -29.3 | -63.5 | -29.3 | 29.3 | 10 | 29.3
ME-C01 | Supplied6/6 flexible coupling15x22 envelope;flexure interior not provided | 3136.80505359 | -7.5000001 | -1e-07 | -7.5000001 | 7.50000012616 | 22.0000001 | 7.5000001
ME-B01 | SKF626-2Z outer/bore/width interface;no raceway internals | 1531.52641863 | -9.5 | 0 | -9.5 | 9.5 | 6 | 9.5
M201 | STARZ encoder plate60x60x6 | 14715.5840764 | -30 | -1.69323639372e-15 | -30 | 30 | 6 | 30
