sbelakho2/Cutting/engineering/generated/layout/manifest.csv

id | description | xmin_mm | ymin_mm | zmin_mm | xmax_mm | ymax_mm | zmax_mm
H001 | Ground head datum / S1-B | -90 | -520 | 0 | 90 | 520 | 20
H002_F | Stage riser /20mm clearance for true NEMA34 body | -55 | -375 | 20 | 55 | -20 | 40
AX01-R_F | Custom-axis HGR20 rail pair external envelope (docs/39) | -43 | -368 | 40 | 43 | -28 | 59
AX01-F_F | Custom-axis BK12 fixed-end envelope / Ø46 coupling clearance (docs/39) | -42.5 | -455 | 40 | 42.5 | -368 | 103
AX01-D_F | Custom-axis BF12 distal-end envelope | -43 | -28 | 40 | 43 | -15 | 72
AX01-S_F | Custom-axis screw Ø8 x18 exposed input end (docs/39) | -4 | -419 | 68 | 4 | -401 | 76
AX01-C_F | Custom-axis H006 carriage envelope / M6 46mm grid (docs/39) | -30 | -160 | 59 | 30 | -44 | 86
H003_F | 15mm motor adapter / full hub tolerance stack / M5 motor fixings | -50 | -470 | 22 | 50 | -453 | 122
DR01-M_F | 34E1K-85 / original supplier STEP; removable shaft key removed | -42.9250001001 | -604.1 | 29.0749998999 | 42.9250001001 | -419.55 | 215.925
HF0-B1_F | ISO4762 M5x16 class10.9;nominal-major cosmetic thread | -28.9987373415 | -467.5 | 43.0012626585 | -20.4987373415 | -446.5 | 51.5012626585
HF0-W1_F | ISO7092 M5 200HV reduced-OD washer9x5.3x1 | -29.2487373415 | -462.5 | 42.7512626585 | -20.2487373415 | -461.5 | 51.7512626585
HF0-B2_F | ISO4762 M5x16 class10.9;nominal-major cosmetic thread | -28.9987373415 | -467.5 | 92.4987373415 | -20.4987373415 | -446.5 | 100.998737342
HF0-W2_F | ISO7092 M5 200HV reduced-OD washer9x5.3x1 | -29.2487373415 | -462.5 | 92.2487373415 | -20.2487373415 | -461.5 | 101.248737342
HF0-B3_F | ISO4762 M5x16 class10.9;nominal-major cosmetic thread | 20.4987373415 | -467.5 | 43.0012626585 | 28.9987373415 | -446.5 | 51.5012626585
HF0-W3_F | ISO7092 M5 200HV reduced-OD washer9x5.3x1 | 20.2487373415 | -462.5 | 42.7512626585 | 29.2487373415 | -461.5 | 51.7512626585
HF0-B4_F | ISO4762 M5x16 class10.9;nominal-major cosmetic thread | 20.4987373415 | -467.5 | 92.4987373415 | 28.9987373415 | -446.5 | 100.998737342
HF0-W4_F | ISO7092 M5 200HV reduced-OD washer9x5.3x1 | 20.2487373415 | -462.5 | 92.2487373415 | 29.2487373415 | -461.5 | 101.248737342
HM-B1_F | ISO4762 M5x25 class10.9;nominal-major cosmetic thread | -39.04 | -485 | 32.96 | -30.54 | -455 | 41.46
HM-W1_F | ISO7092 M5 200HV motor washer9x5.3x1 | -39.29 | -480 | 32.71 | -30.29 | -479 | 41.71
HM-B2_F | ISO4762 M5x25 class10.9;nominal-major cosmetic thread | -39.04 | -485 | 102.54 | -30.54 | -455 | 111.04
HM-W2_F | ISO7092 M5 200HV motor washer9x5.3x1 | -39.29 | -480 | 102.29 | -30.29 | -479 | 111.29
HM-B3_F | ISO4762 M5x25 class10.9;nominal-major cosmetic thread | 30.54 | -485 | 32.96 | 39.04 | -455 | 41.46
HM-W3_F | ISO7092 M5 200HV motor washer9x5.3x1 | 30.29 | -480 | 32.71 | 39.29 | -479 | 41.71
HM-B4_F | ISO4762 M5x25 class10.9;nominal-major cosmetic thread | 30.54 | -485 | 102.54 | 39.04 | -455 | 111.04
HM-W4_F | ISO7092 M5 200HV motor washer9x5.3x1 | 30.29 | -480 | 102.29 | 39.29 | -479 | 111.29
CP01_F | R+W MK2/100/50/8/14 interference envelope | -20 | -452 | 52 | 20 | -402 | 92
H004_F | 42CrMo4+QT single-piece blade holder | -35 | -139.5 | 86 | 35 | -17 | 134
H007_F | 42CrMo4+QT blade backing plate 30x46x8;shimmed blade seat;carries the 1200 N blade reaction;face gap set at assembly (docs/34) | 0.49 | -41.5 | 89.5 | 8.49 | -12.5 | 134.5
T001_F | Ground V tooling purchase-to-drawing / qualification hold | -3.01 | -34 | 93 | -0.01 | 15 | 131
H002_R | Stage riser /20mm clearance for true NEMA34 body | -55 | 20 | 20 | 55 | 375 | 40
AX01-R_R | Custom-axis HGR20 rail pair external envelope (docs/39) | -43 | 28 | 40 | 43 | 368 | 59
AX01-F_R | Custom-axis BK12 fixed-end envelope / Ø46 coupling clearance (docs/39) | -42.5 | 368 | 40 | 42.5 | 455 | 103
AX01-D_R | Custom-axis BF12 distal-end envelope | -43 | 15 | 40 | 43 | 28 | 72
AX01-S_R | Custom-axis screw Ø8 x18 exposed input end (docs/39) | -4 | 401 | 68 | 4 | 419 | 76
AX01-C_R | Custom-axis H006 carriage envelope / M6 46mm grid (docs/39) | -30 | 44 | 59 | 30 | 160 | 86
H003_R | 15mm motor adapter / full hub tolerance stack / M5 motor fixings | -50 | 453 | 22 | 50 | 470 | 122
DR01-M_R | 34E1K-85 / original supplier STEP; removable shaft key removed | -42.9250001001 | 419.55 | 29.0749998999 | 42.9250001001 | 604.1000001 | 215.925
HF0-B1_R | ISO4762 M5x16 class10.9;nominal-major cosmetic thread | 20.4987373415 | 446.5 | 43.0012626585 | 28.9987373415 | 467.5 | 51.5012626585
HF0-W1_R | ISO7092 M5 200HV reduced-OD washer9x5.3x1 | 20.2487373415 | 461.5 | 42.7512626585 | 29.2487373415 | 462.5 | 51.7512626585
HF0-B2_R | ISO4762 M5x16 class10.9;nominal-major cosmetic thread | 20.4987373415 | 446.5 | 92.4987373415 | 28.9987373415 | 467.5 | 100.998737342
HF0-W2_R | ISO7092 M5 200HV reduced-OD washer9x5.3x1 | 20.2487373415 | 461.5 | 92.2487373415 | 29.2487373415 | 462.5 | 101.248737342
HF0-B3_R | ISO4762 M5x16 class10.9;nominal-major cosmetic thread | -28.9987373415 | 446.5 | 43.0012626585 | -20.4987373415 | 467.5 | 51.5012626585
HF0-W3_R | ISO7092 M5 200HV reduced-OD washer9x5.3x1 | -29.2487373415 | 461.5 | 42.7512626585 | -20.2487373415 | 462.5 | 51.7512626585
HF0-B4_R | ISO4762 M5x16 class10.9;nominal-major cosmetic thread | -28.9987373415 | 446.5 | 92.4987373415 | -20.4987373415 | 467.5 | 100.998737342
HF0-W4_R | ISO7092 M5 200HV reduced-OD washer9x5.3x1 | -29.2487373415 | 461.5 | 92.2487373415 | -20.2487373415 | 462.5 | 101.248737342
HM-B1_R | ISO4762 M5x25 class10.9;nominal-major cosmetic thread | 30.54 | 455 | 32.96 | 39.04 | 485 | 41.46
HM-W1_R | ISO7092 M5 200HV motor washer9x5.3x1 | 30.29 | 479 | 32.71 | 39.29 | 480 | 41.71
HM-B2_R | ISO4762 M5x25 class10.9;nominal-major cosmetic thread | 30.54 | 455 | 102.54 | 39.04 | 485 | 111.04
HM-W2_R | ISO7092 M5 200HV motor washer9x5.3x1 | 30.29 | 479 | 102.29 | 39.29 | 480 | 111.29
HM-B3_R | ISO4762 M5x25 class10.9;nominal-major cosmetic thread | -39.04 | 455 | 32.96 | -30.54 | 485 | 41.46
HM-W3_R | ISO7092 M5 200HV motor washer9x5.3x1 | -39.29 | 479 | 32.71 | -30.29 | 480 | 41.71
HM-B4_R | ISO4762 M5x25 class10.9;nominal-major cosmetic thread | -39.04 | 455 | 102.54 | -30.54 | 485 | 111.04
HM-W4_R | ISO7092 M5 200HV motor washer9x5.3x1 | -39.29 | 479 | 102.29 | -30.29 | 480 | 111.29
CP01_R | R+W MK2/100/50/8/14 interference envelope | -20 | 402 | 52 | 20 | 452 | 92
H004_R | 42CrMo4+QT single-piece blade holder | -35 | 17 | 86 | 35 | 139.5 | 134
H007_R | 42CrMo4+QT blade backing plate 30x46x8;shimmed blade seat;carries the 1200 N blade reaction;face gap set at assembly (docs/34) | -8.49 | 12.5 | 89.5 | -0.49 | 41.5 | 134.5
T001_R | Ground V tooling purchase-to-drawing / qualification hold | 0.01 | -15 | 93 | 3.01 | 34 | 131
LEFT_L1_F101 | 42CrMo4+QT rotor;matched j5 bearing seats;nominal-major cosmetic threads | -85 | -4.25 | 80.25 | -66 | 108.75 | 99.25
LEFT_L1_F102 | 6082-T6 rear bearing/base;front module removable for assembly | -98.5 | 16.75 | 55.75 | -52.5 | 89.75 | 108.75
LEFT_L1_F112 | 6082-T6 removable locating-bearing module;32.008–32.019 bore;matched to F102 | -98.5 | 16.7499999 | 71.2499999 | -52.5 | 35.77 | 108.7500001
LEFT_L1_F103 | Front bearing rear cover;M3 clearance holes | -98.5 | 35.77 | 71.5 | -52.5 | 37.77 | 108.75
LEFT_L1_F104 | 16ODx12.1IDx2.7 rear inner-ring abutment with positive end float | -83.5 | 86.25 | 81.75 | -67.5 | 88.95 | 97.75
LEFT_L1_F105 | 16ODx12.1IDx1 rear-bearing abutment;shaft-shoulder side C0.30 | -83.5 | 77.25 | 81.75 | -67.5 | 78.25 | 97.75
LEFT_L1_F106 | 19.5ODx15.1IDx1 front inner-ring abutment | -85.25 | 35.75 | 80 | -65.75 | 36.75 | 99.5
LEFT_L1_F107 | 17.5ODx10.1IDx1.5 roller spacer;shaft-shoulder side C0.30 | -84.25 | 15.25 | 81 | -66.75 | 16.75 | 98.5
LEFT_L1_F108 | 17.5ODx5.5IDx3 positive roller end plate | -84.25 | -7.75 | 81 | -66.75 | -4.75 | 98.5
LEFT_L1_F109 | C45 roller key3x4x18;inside perimeter C0.20 | -77 | -3.75 | 82.55 | -74 | 14.25 | 86.55
LEFT_L1_F110 | Secondary-keyed UMCL40-10-20-MC;18mm collar;MC4mm urethane-access holes | -95.5000001268 | -4.7500001 | 69.7499999 | -55.4999999 | 15.2500001 | 109.7500001
LEFT_L1_RB01 | SKF6001-2Z/C3 external interface | -89.5 | 78.25 | 75.75 | -61.5 | 86.25 | 103.75
LEFT_L1_RB02 | SKF6002-2Z/C3 interface;minimum R0.3 inner shoulder corner | -91.5 | 26.75 | 73.75 | -59.5 | 35.75 | 105.75
LEFT_L1_RR01 | SEEGER A12 installed envelope;centred between rounded groove roots | -84.6 | 89.19 | 80.65 | -66.4 | 90.19 | 98.85
LEFT_L1_RN01 | SKF KM2 M15x1 nut | -87.8389626793 | 37.75 | 77.4110373207 | -63.1610373207 | 42.75 | 102.088962679
LEFT_L1_RW01 | SKF MB2;actual4mm inward tang in open shaft slot | -89.5 | 36.75 | 75.75 | -61.5 | 37.75 | 103.75
LEFT_L1_FB01 | ISO4762 M5x16 class10.9 roller retention;socket omitted | -79.75 | -12.75 | 85.5 | -71.25 | 8.25 | 94
LEFT_L1_FMB1 | ISO4762 M4x20 class10.9 front-module screw | -63 | 21.25 | 56.25 | -56 | 28.25 | 80.25
LEFT_L1_FMW1 | ISO7092 M4 washer4.3x8x0.5 200HV | -63.5 | 20.75 | 60.25 | -55.5 | 28.75 | 60.75
LEFT_L1_FDP1 | ISO8734 dowel3m6x20;recessed1.5mm from underside | -67 | 18.25 | 57.25 | -64 | 21.25 | 77.25
LEFT_L1_FMB2 | ISO4762 M4x20 class10.9 front-module screw | -95 | 21.25 | 56.25 | -88 | 28.25 | 80.25
LEFT_L1_FMW2 | ISO7092 M4 washer4.3x8x0.5 200HV | -95.5 | 20.75 | 60.25 | -87.5 | 28.75 | 60.75
LEFT_L1_FDP2 | ISO8734 dowel3m6x20;recessed1.5mm from underside | -87 | 18.25 | 57.25 | -84 | 21.25 | 77.25
LEFT_L1_FCB1 | ISO4762 M3x8 class8.8 locating-bearing cover screw | -59.25 | 29.77 | 74.5 | -53.75 | 40.77 | 80
LEFT_L1_FCB2 | ISO4762 M3x8 class8.8 locating-bearing cover screw | -59.25 | 29.77 | 99.5 | -53.75 | 40.77 | 105
LEFT_L1_FCB3 | ISO4762 M3x8 class8.8 locating-bearing cover screw | -97.25 | 29.77 | 74.5 | -91.75 | 40.77 | 80
LEFT_L1_FCB4 | ISO4762 M3x8 class8.8 locating-bearing cover screw | -97.25 | 29.77 | 99.5 | -91.75 | 40.77 | 105
LEFT_L1_TP01 | HTPA20S5M250-A-N14 purchased external interface | -93.5 | 45.25 | 71.75 | -57.5 | 77.25 | 107.75
LEFT_L1_TK01 | DIN6885-A5x5x28 C45 key;inside perimeter C0.20 finishing operation | -78 | 47.25 | 93.75 | -73 | 75.25 | 98.75
LEFT_L2_F101 | 42CrMo4+QT rotor;matched j5 bearing seats;nominal-major cosmetic threads | -147.5 | -4.25 | 80.25 | -128.5 | 108.75 | 99.25
LEFT_L2_F102 | 6082-T6 rear bearing/base;front module removable for assembly | -161 | 16.75 | 55.75 | -115 | 89.75 | 108.75
LEFT_L2_F112 | 6082-T6 removable locating-bearing module;32.008–32.019 bore;matched to F102 | -161 | 16.7499999 | 71.2499999 | -115 | 35.77 | 108.7500001
LEFT_L2_F103 | Front bearing rear cover;M3 clearance holes | -161 | 35.77 | 71.5 | -115 | 37.77 | 108.75
LEFT_L2_F104 | 16ODx12.1IDx2.7 rear inner-ring abutment with positive end float | -146 | 86.25 | 81.75 | -130 | 88.95 | 97.75
LEFT_L2_F105 | 16ODx12.1IDx1 rear-bearing abutment;shaft-shoulder side C0.30 | -146 | 77.25 | 81.75 | -130 | 78.25 | 97.75
LEFT_L2_F106 | 19.5ODx15.1IDx1 front inner-ring abutment | -147.75 | 35.75 | 80 | -128.25 | 36.75 | 99.5
LEFT_L2_F107 | 17.5ODx10.1IDx1.5 roller spacer;shaft-shoulder side C0.30 | -146.75 | 15.25 | 81 | -129.25 | 16.75 | 98.5
LEFT_L2_F108 | 17.5ODx5.5IDx3 positive roller end plate | -146.75 | -7.75 | 81 | -129.25 | -4.75 | 98.5
LEFT_L2_F109 | C45 roller key3x4x18;inside perimeter C0.20 | -139.5 | -3.75 | 82.55 | -136.5 | 14.25 | 86.55
LEFT_L2_F110 | Secondary-keyed UMCL40-10-20-MC;18mm collar;MC4mm urethane-access holes | -158.000000127 | -4.7500001 | 69.7499999 | -117.9999999 | 15.2500001 | 109.7500001
LEFT_L2_RB01 | SKF6001-2Z/C3 external interface | -152 | 78.25 | 75.75 | -124 | 86.25 | 103.75
LEFT_L2_RB02 | SKF6002-2Z/C3 interface;minimum R0.3 inner shoulder corner | -154 | 26.75 | 73.75 | -122 | 35.75 | 105.75
LEFT_L2_RR01 | SEEGER A12 installed envelope;centred between rounded groove roots | -147.1 | 89.19 | 80.65 | -128.9 | 90.19 | 98.85
LEFT_L2_RN01 | SKF KM2 M15x1 nut | -150.338962679 | 37.75 | 77.4110373207 | -125.661037321 | 42.75 | 102.088962679
LEFT_L2_RW01 | SKF MB2;actual4mm inward tang in open shaft slot | -152 | 36.75 | 75.75 | -124 | 37.75 | 103.75
LEFT_L2_FB01 | ISO4762 M5x16 class10.9 roller retention;socket omitted | -142.25 | -12.75 | 85.5 | -133.75 | 8.25 | 94
LEFT_L2_FMB1 | ISO4762 M4x20 class10.9 front-module screw | -125.5 | 21.25 | 56.25 | -118.5 | 28.25 | 80.25
LEFT_L2_FMW1 | ISO7092 M4 washer4.3x8x0.5 200HV | -126 | 20.75 | 60.25 | -118 | 28.75 | 60.75
LEFT_L2_FDP1 | ISO8734 dowel3m6x20;recessed1.5mm from underside | -129.5 | 18.25 | 57.25 | -126.5 | 21.25 | 77.25
LEFT_L2_FMB2 | ISO4762 M4x20 class10.9 front-module screw | -157.5 | 21.25 | 56.25 | -150.5 | 28.25 | 80.25
LEFT_L2_FMW2 | ISO7092 M4 washer4.3x8x0.5 200HV | -158 | 20.75 | 60.25 | -150 | 28.75 | 60.75
LEFT_L2_FDP2 | ISO8734 dowel3m6x20;recessed1.5mm from underside | -149.5 | 18.25 | 57.25 | -146.5 | 21.25 | 77.25
LEFT_L2_FCB1 | ISO4762 M3x8 class8.8 locating-bearing cover screw | -121.75 | 29.77 | 74.5 | -116.25 | 40.77 | 80
LEFT_L2_FCB2 | ISO4762 M3x8 class8.8 locating-bearing cover screw | -121.75 | 29.77 | 99.5 | -116.25 | 40.77 | 105
LEFT_L2_FCB3 | ISO4762 M3x8 class8.8 locating-bearing cover screw | -159.75 | 29.77 | 74.5 | -154.25 | 40.77 | 80
LEFT_L2_FCB4 | ISO4762 M3x8 class8.8 locating-bearing cover screw | -159.75 | 29.77 | 99.5 | -154.25 | 40.77 | 105
LEFT_L2_TP01 | HTPA20S5M250-A-N14 purchased external interface | -156 | 45.25 | 71.75 | -120 | 77.25 | 107.75
LEFT_L2_TK01 | DIN6885-A5x5x28 C45 key;inside perimeter C0.20 finishing operation | -140.5 | 47.25 | 93.75 | -135.5 | 75.25 | 98.75
LEFT_L2_CP02 | MK2/100/50/10/12 catalogue interference envelope | -158 | 91.75 | 69.75 | -118 | 141.75 | 109.75
LEFT_L2_FM01 | Original24HS40-5004D-E1000 STEP;D-flat retained | -168.5000001 | 72.65 | 59.2499998999 | -107.4999999 | 268.95 | 223.2500001
LEFT_L2_F111 | 80x80x10 feed-motor plate;50mm mounting grid | -178 | 133.95 | 49.75 | -98 | 143.95 | 129.75
LEFT_U1_F101 | 42CrMo4+QT rotor;matched j5 bearing seats;nominal-major cosmetic threads | -85 | -4.25 | 124.75 | -66 | 108.75 | 143.75
LEFT_U1_F102 | 6082-T6 rear bearing/base;front module removable for assembly | -98.5 | 16.75 | 115.25 | -52.5 | 89.75 | 168.25
LEFT_U1_F112 | 6082-T6 removable locating-bearing module;32.008–32.019 bore;matched to F102 | -98.5 | 16.7499999 | 115.2499999 | -52.5 | 35.77 | 152.7500001
LEFT_U1_F103 | Front bearing rear cover;M3 clearance holes | -98.5 | 35.77 | 115.25 | -52.5 | 37.77 | 152.5
LEFT_U1_F104 | 16ODx12.1IDx2.7 rear inner-ring abutment with positive end float | -83.5 | 86.25 | 126.25 | -67.5 | 88.95 | 142.25
LEFT_U1_F105 | 16ODx12.1IDx1 rear-bearing abutment;shaft-shoulder side C0.30 | -83.5 | 77.25 | 126.25 | -67.5 | 78.25 | 142.25
LEFT_U1_F106 | 19.5ODx15.1IDx1 front inner-ring abutment | -85.25 | 35.75 | 124.5 | -65.75 | 36.75 | 144
LEFT_U1_F107 | 17.5ODx10.1IDx1.5 roller spacer;shaft-shoulder side C0.30 | -84.25 | 15.25 | 125.5 | -66.75 | 16.75 | 143
LEFT_U1_F108 | 17.5ODx5.5IDx3 positive roller end plate | -84.25 | -7.75 | 125.5 | -66.75 | -4.75 | 143
LEFT_U1_F109 | C45 roller key3x4x18;inside perimeter C0.20 | -77 | -3.75 | 137.45 | -74 | 14.25 | 141.45
LEFT_U1_F110 | Secondary-keyed UMCL40-10-20-MC;18mm collar;MC4mm urethane-access holes | -95.5000001 | -4.7500001 | 114.2499999 | -55.4999998732 | 15.2500001 | 154.2500001
LEFT_U1_RB01 | SKF6001-2Z/C3 external interface | -89.5 | 78.25 | 120.25 | -61.5 | 86.25 | 148.25
LEFT_U1_RB02 | SKF6002-2Z/C3 interface;minimum R0.3 inner shoulder corner | -91.5 | 26.75 | 118.25 | -59.5 | 35.75 | 150.25
LEFT_U1_RR01 | SEEGER A12 installed envelope;centred between rounded groove roots | -84.6 | 89.19 | 125.15 | -66.4 | 90.19 | 143.35
LEFT_U1_RN01 | SKF KM2 M15x1 nut | -87.8389626793 | 37.75 | 121.911037321 | -63.1610373207 | 42.75 | 146.588962679
LEFT_U1_RW01 | SKF MB2;actual4mm inward tang in open shaft slot | -89.5 | 36.75 | 120.25 | -61.5 | 37.75 | 148.25
LEFT_U1_FB01 | ISO4762 M5x16 class10.9 roller retention;socket omitted | -79.75 | -12.75 | 130 | -71.25 | 8.25 | 138.5
LEFT_U1_FMB1 | ISO4762 M4x20 class10.9 front-module screw | -95 | 21.25 | 143.75 | -88 | 28.25 | 167.75
LEFT_U1_FMW1 | ISO7092 M4 washer4.3x8x0.5 200HV | -95.5 | 20.75 | 163.25 | -87.5 | 28.75 | 163.75
LEFT_U1_FDP1 | ISO8734 dowel3m6x20;recessed1.5mm from underside | -87 | 18.25 | 146.75 | -84 | 21.25 | 166.75
LEFT_U1_FMB2 | ISO4762 M4x20 class10.9 front-module screw | -63 | 21.25 | 143.75 | -56 | 28.25 | 167.75
LEFT_U1_FMW2 | ISO7092 M4 washer4.3x8x0.5 200HV | -63.5 | 20.75 | 163.25 | -55.5 | 28.75 | 163.75
LEFT_U1_FDP2 | ISO8734 dowel3m6x20;recessed1.5mm from underside | -67 | 18.25 | 146.75 | -64 | 21.25 | 166.75
LEFT_U1_FCB1 | ISO4762 M3x8 class8.8 locating-bearing cover screw | -97.25 | 29.77 | 144 | -91.75 | 40.77 | 149.5
LEFT_U1_FCB2 | ISO4762 M3x8 class8.8 locating-bearing cover screw | -97.25 | 29.77 | 119 | -91.75 | 40.77 | 124.5
LEFT_U1_FCB3 | ISO4762 M3x8 class8.8 locating-bearing cover screw | -59.25 | 29.77 | 144 | -53.75 | 40.77 | 149.5
LEFT_U1_FCB4 | ISO4762 M3x8 class8.8 locating-bearing cover screw | -59.25 | 29.77 | 119 | -53.75 | 40.77 | 124.5
LEFT_U2_F101 | 42CrMo4+QT rotor;matched j5 bearing seats;nominal-major cosmetic threads | -147.5 | -4.25 | 124.75 | -128.5 | 108.75 | 143.75
LEFT_U2_F102 | 6082-T6 rear bearing/base;front module removable for assembly | -161 | 16.75 | 115.25 | -115 | 89.75 | 168.25
LEFT_U2_F112 | 6082-T6 removable locating-bearing module;32.008–32.019 bore;matched to F102 | -161 | 16.7499999 | 115.2499999 | -115 | 35.77 | 152.7500001
LEFT_U2_F103 | Front bearing rear cover;M3 clearance holes | -161 | 35.77 | 115.25 | -115 | 37.77 | 152.5
LEFT_U2_F104 | 16ODx12.1IDx2.7 rear inner-ring abutment with positive end float | -146 | 86.25 | 126.25 | -130 | 88.95 | 142.25
LEFT_U2_F105 | 16ODx12.1IDx1 rear-bearing abutment;shaft-shoulder side C0.30 | -146 | 77.25 | 126.25 | -130 | 78.25 | 142.25
LEFT_U2_F106 | 19.5ODx15.1IDx1 front inner-ring abutment | -147.75 | 35.75 | 124.5 | -128.25 | 36.75 | 144
LEFT_U2_F107 | 17.5ODx10.1IDx1.5 roller spacer;shaft-shoulder side C0.30 | -146.75 | 15.25 | 125.5 | -129.25 | 16.75 | 143
LEFT_U2_F108 | 17.5ODx5.5IDx3 positive roller end plate | -146.75 | -7.75 | 125.5 | -129.25 | -4.75 | 143
LEFT_U2_F109 | C45 roller key3x4x18;inside perimeter C0.20 | -139.5 | -3.75 | 137.45 | -136.5 | 14.25 | 141.45
LEFT_U2_F110 | Secondary-keyed UMCL40-10-20-MC;18mm collar;MC4mm urethane-access holes | -158.0000001 | -4.7500001 | 114.2499999 | -117.999999873 | 15.2500001 | 154.2500001
LEFT_U2_RB01 | SKF6001-2Z/C3 external interface | -152 | 78.25 | 120.25 | -124 | 86.25 | 148.25
LEFT_U2_RB02 | SKF6002-2Z/C3 interface;minimum R0.3 inner shoulder corner | -154 | 26.75 | 118.25 | -122 | 35.75 | 150.25
LEFT_U2_RR01 | SEEGER A12 installed envelope;centred between rounded groove roots | -147.1 | 89.19 | 125.15 | -128.9 | 90.19 | 143.35
LEFT_U2_RN01 | SKF KM2 M15x1 nut | -150.338962679 | 37.75 | 121.911037321 | -125.661037321 | 42.75 | 146.588962679
LEFT_U2_RW01 | SKF MB2;actual4mm inward tang in open shaft slot | -152 | 36.75 | 120.25 | -124 | 37.75 | 148.25
LEFT_U2_FB01 | ISO4762 M5x16 class10.9 roller retention;socket omitted | -142.25 | -12.75 | 130 | -133.75 | 8.25 | 138.5
LEFT_U2_FMB1 | ISO4762 M4x20 class10.9 front-module screw | -157.5 | 21.25 | 143.75 | -150.5 | 28.25 | 167.75
LEFT_U2_FMW1 | ISO7092 M4 washer4.3x8x0.5 200HV | -158 | 20.75 | 163.25 | -150 | 28.75 | 163.75
LEFT_U2_FDP1 | ISO8734 dowel3m6x20;recessed1.5mm from underside | -149.5 | 18.25 | 146.75 | -146.5 | 21.25 | 166.75
LEFT_U2_FMB2 | ISO4762 M4x20 class10.9 front-module screw | -125.5 | 21.25 | 143.75 | -118.5 | 28.25 | 167.75
LEFT_U2_FMW2 | ISO7092 M4 washer4.3x8x0.5 200HV | -126 | 20.75 | 163.25 | -118 | 28.75 | 163.75
LEFT_U2_FDP2 | ISO8734 dowel3m6x20;recessed1.5mm from underside | -129.5 | 18.25 | 146.75 | -126.5 | 21.25 | 166.75
LEFT_U2_FCB1 | ISO4762 M3x8 class8.8 locating-bearing cover screw | -159.75 | 29.77 | 144 | -154.25 | 40.77 | 149.5
LEFT_U2_FCB2 | ISO4762 M3x8 class8.8 locating-bearing cover screw | -159.75 | 29.77 | 119 | -154.25 | 40.77 | 124.5
LEFT_U2_FCB3 | ISO4762 M3x8 class8.8 locating-bearing cover screw | -121.75 | 29.77 | 144 | -116.25 | 40.77 | 149.5
LEFT_U2_FCB4 | ISO4762 M3x8 class8.8 locating-bearing cover screw | -121.75 | 29.77 | 119 | -116.25 | 40.77 | 124.5
LEFT_TB01 | HTBN225S5M-250 external backing envelope;tooth engagement excluded | -156.845494309 | 48.75 | 70.9045056908 | -56.6545056908 | 73.75 | 108.595494309
RIGHT_L1_F101 | 42CrMo4+QT rotor;matched j5 bearing seats;nominal-major cosmetic threads | 66 | -108.75 | 80.25 | 85 | 4.25 | 99.25
RIGHT_L1_F102 | 6082-T6 rear bearing/base;front module removable for assembly | 52.5 | -89.75 | 55.75 | 98.5 | -16.75 | 108.75
RIGHT_L1_F112 | 6082-T6 removable locating-bearing module;32.008–32.019 bore;matched to F102 | 52.5 | -35.77 | 71.2499999 | 98.5 | -16.7499999 | 108.7500001
RIGHT_L1_F103 | Front bearing rear cover;M3 clearance holes | 52.5 | -37.77 | 71.5 | 98.5 | -35.77 | 108.75
RIGHT_L1_F104 | 16ODx12.1IDx2.7 rear inner-ring abutment with positive end float | 67.5 | -88.95 | 81.75 | 83.5 | -86.25 | 97.75
RIGHT_L1_F105 | 16ODx12.1IDx1 rear-bearing abutment;shaft-shoulder side C0.30 | 67.5 | -78.25 | 81.75 | 83.5 | -77.25 | 97.75
RIGHT_L1_F106 | 19.5ODx15.1IDx1 front inner-ring abutment | 65.75 | -36.75 | 80 | 85.25 | -35.75 | 99.5
RIGHT_L1_F107 | 17.5ODx10.1IDx1.5 roller spacer;shaft-shoulder side C0.30 | 66.75 | -16.75 | 81 | 84.25 | -15.25 | 98.5
RIGHT_L1_F108 | 17.5ODx5.5IDx3 positive roller end plate | 66.75 | 4.75 | 81 | 84.25 | 7.75 | 98.5
RIGHT_L1_F109 | C45 roller key3x4x18;inside perimeter C0.20 | 74 | -14.25 | 82.55 | 77 | 3.75 | 86.55
RIGHT_L1_F110 | Secondary-keyed UMCL40-10-20-MC;18mm collar;MC4mm urethane-access holes | 55.4999999 | -15.2500001 | 69.7499999 | 95.5000001268 | 4.7500001 | 109.7500001
RIGHT_L1_RB01 | SKF6001-2Z/C3 external interface | 61.5 | -86.25 | 75.75 | 89.5 | -78.25 | 103.75
RIGHT_L1_RB02 | SKF6002-2Z/C3 interface;minimum R0.3 inner shoulder corner | 59.5 | -35.75 | 73.75 | 91.5 | -26.75 | 105.75
RIGHT_L1_RR01 | SEEGER A12 installed envelope;centred between rounded groove roots | 66.4 | -90.19 | 80.65 | 84.6 | -89.19 | 98.85
RIGHT_L1_RN01 | SKF KM2 M15x1 nut | 63.1610373207 | -42.75 | 77.4110373207 | 87.8389626793 | -37.75 | 102.088962679
RIGHT_L1_RW01 | SKF MB2;actual4mm inward tang in open shaft slot | 61.5 | -37.75 | 75.75 | 89.5 | -36.75 | 103.75
RIGHT_L1_FB01 | ISO4762 M5x16 class10.9 roller retention;socket omitted | 71.25 | -8.25 | 85.5 | 79.75 | 12.75 | 94
RIGHT_L1_FMB1 | ISO4762 M4x20 class10.9 front-module screw | 56 | -28.25 | 56.25 | 63 | -21.25 | 80.25
RIGHT_L1_FMW1 | ISO7092 M4 washer4.3x8x0.5 200HV | 55.5 | -28.75 | 60.25 | 63.5 | -20.75 | 60.75
RIGHT_L1_FDP1 | ISO8734 dowel3m6x20;recessed1.5mm from underside | 64 | -21.25 | 57.25 | 67 | -18.25 | 77.25
RIGHT_L1_FMB2 | ISO4762 M4x20 class10.9 front-module screw | 88 | -28.25 | 56.25 | 95 | -21.25 | 80.25
RIGHT_L1_FMW2 | ISO7092 M4 washer4.3x8x0.5 200HV | 87.5 | -28.75 | 60.25 | 95.5 | -20.75 | 60.75
RIGHT_L1_FDP2 | ISO8734 dowel3m6x20;recessed1.5mm from underside | 84 | -21.25 | 57.25 | 87 | -18.25 | 77.25
RIGHT_L1_FCB1 | ISO4762 M3x8 class8.8 locating-bearing cover screw | 53.75 | -40.77 | 74.5 | 59.25 | -29.77 | 80
RIGHT_L1_FCB2 | ISO4762 M3x8 class8.8 locating-bearing cover screw | 53.75 | -40.77 | 99.5 | 59.25 | -29.77 | 105
RIGHT_L1_FCB3 | ISO4762 M3x8 class8.8 locating-bearing cover screw | 91.75 | -40.77 | 74.5 | 97.25 | -29.77 | 80
RIGHT_L1_FCB4 | ISO4762 M3x8 class8.8 locating-bearing cover screw | 91.75 | -40.77 | 99.5 | 97.25 | -29.77 | 105
RIGHT_L1_TP01 | HTPA20S5M250-A-N14 purchased external interface | 57.5 | -77.25 | 71.75 | 93.5 | -45.25 | 107.75
RIGHT_L1_TK01 | DIN6885-A5x5x28 C45 key;inside perimeter C0.20 finishing operation | 73 | -75.25 | 93.75 | 78 | -47.25 | 98.75
RIGHT_L2_F101 | 42CrMo4+QT rotor;matched j5 bearing seats;nominal-major cosmetic threads | 128.5 | -108.75 | 80.25 | 147.5 | 4.25 | 99.25
RIGHT_L2_F102 | 6082-T6 rear bearing/base;front module removable for assembly | 115 | -89.75 | 55.75 | 161 | -16.75 | 108.75
RIGHT_L2_F112 | 6082-T6 removable locating-bearing module;32.008–32.019 bore;matched to F102 | 115 | -35.77 | 71.2499999 | 161 | -16.7499999 | 108.7500001
RIGHT_L2_F103 | Front bearing rear cover;M3 clearance holes | 115 | -37.77 | 71.5 | 161 | -35.77 | 108.75
RIGHT_L2_F104 | 16ODx12.1IDx2.7 rear inner-ring abutment with positive end float | 130 | -88.95 | 81.75 | 146 | -86.25 | 97.75
RIGHT_L2_F105 | 16ODx12.1IDx1 rear-bearing abutment;shaft-shoulder side C0.30 | 130 | -78.25 | 81.75 | 146 | -77.25 | 97.75
RIGHT_L2_F106 | 19.5ODx15.1IDx1 front inner-ring abutment | 128.25 | -36.75 | 80 | 147.75 | -35.75 | 99.5
RIGHT_L2_F107 | 17.5ODx10.1IDx1.5 roller spacer;shaft-shoulder side C0.30 | 129.25 | -16.75 | 81 | 146.75 | -15.25 | 98.5
RIGHT_L2_F108 | 17.5ODx5.5IDx3 positive roller end plate | 129.25 | 4.75 | 81 | 146.75 | 7.75 | 98.5
RIGHT_L2_F109 | C45 roller key3x4x18;inside perimeter C0.20 | 136.5 | -14.25 | 82.55 | 139.5 | 3.75 | 86.55
RIGHT_L2_F110 | Secondary-keyed UMCL40-10-20-MC;18mm collar;MC4mm urethane-access holes | 117.9999999 | -15.2500001 | 69.7499999 | 158.000000127 | 4.7500001 | 109.7500001
RIGHT_L2_RB01 | SKF6001-2Z/C3 external interface | 124 | -86.25 | 75.75 | 152 | -78.25 | 103.75
RIGHT_L2_RB02 | SKF6002-2Z/C3 interface;minimum R0.3 inner shoulder corner | 122 | -35.75 | 73.75 | 154 | -26.75 | 105.75
RIGHT_L2_RR01 | SEEGER A12 installed envelope;centred between rounded groove roots | 128.9 | -90.19 | 80.65 | 147.1 | -89.19 | 98.85
RIGHT_L2_RN01 | SKF KM2 M15x1 nut | 125.661037321 | -42.75 | 77.4110373207 | 150.338962679 | -37.75 | 102.088962679
RIGHT_L2_RW01 | SKF MB2;actual4mm inward tang in open shaft slot | 124 | -37.75 | 75.75 | 152 | -36.75 | 103.75
RIGHT_L2_FB01 | ISO4762 M5x16 class10.9 roller retention;socket omitted | 133.75 | -8.25 | 85.5 | 142.25 | 12.75 | 94
RIGHT_L2_FMB1 | ISO4762 M4x20 class10.9 front-module screw | 118.5 | -28.25 | 56.25 | 125.5 | -21.25 | 80.25
RIGHT_L2_FMW1 | ISO7092 M4 washer4.3x8x0.5 200HV | 118 | -28.75 | 60.25 | 126 | -20.75 | 60.75
RIGHT_L2_FDP1 | ISO8734 dowel3m6x20;recessed1.5mm from underside | 126.5 | -21.25 | 57.25 | 129.5 | -18.25 | 77.25
RIGHT_L2_FMB2 | ISO4762 M4x20 class10.9 front-module screw | 150.5 | -28.25 | 56.25 | 157.5 | -21.25 | 80.25
RIGHT_L2_FMW2 | ISO7092 M4 washer4.3x8x0.5 200HV | 150 | -28.75 | 60.25 | 158 | -20.75 | 60.75
RIGHT_L2_FDP2 | ISO8734 dowel3m6x20;recessed1.5mm from underside | 146.5 | -21.25 | 57.25 | 149.5 | -18.25 | 77.25
RIGHT_L2_FCB1 | ISO4762 M3x8 class8.8 locating-bearing cover screw | 116.25 | -40.77 | 74.5 | 121.75 | -29.77 | 80
RIGHT_L2_FCB2 | ISO4762 M3x8 class8.8 locating-bearing cover screw | 116.25 | -40.77 | 99.5 | 121.75 | -29.77 | 105
RIGHT_L2_FCB3 | ISO4762 M3x8 class8.8 locating-bearing cover screw | 154.25 | -40.77 | 74.5 | 159.75 | -29.77 | 80
RIGHT_L2_FCB4 | ISO4762 M3x8 class8.8 locating-bearing cover screw | 154.25 | -40.77 | 99.5 | 159.75 | -29.77 | 105
RIGHT_L2_TP01 | HTPA20S5M250-A-N14 purchased external interface | 120 | -77.25 | 71.75 | 156 | -45.25 | 107.75
RIGHT_L2_TK01 | DIN6885-A5x5x28 C45 key;inside perimeter C0.20 finishing operation | 135.5 | -75.25 | 93.75 | 140.5 | -47.25 | 98.75
RIGHT_L2_CP02 | MK2/100/50/10/12 catalogue interference envelope | 118 | -141.75 | 69.75 | 158 | -91.75 | 109.75
RIGHT_L2_FM01 | Original24HS40-5004D-E1000 STEP;D-flat retained | 107.4999999 | -268.95 | 59.2499998999 | 168.5000001 | -72.6499999 | 223.2500001
RIGHT_L2_F111 | 80x80x10 feed-motor plate;50mm mounting grid | 98 | -143.95 | 49.75 | 178 | -133.95 | 129.75
RIGHT_U1_F101 | 42CrMo4+QT rotor;matched j5 bearing seats;nominal-major cosmetic threads | 66 | -108.75 | 124.75 | 85 | 4.25 | 143.75
RIGHT_U1_F102 | 6082-T6 rear bearing/base;front module removable for assembly | 52.5 | -89.75 | 115.25 | 98.5 | -16.75 | 168.25
RIGHT_U1_F112 | 6082-T6 removable locating-bearing module;32.008–32.019 bore;matched to F102 | 52.5 | -35.77 | 115.2499999 | 98.5 | -16.7499999 | 152.7500001
RIGHT_U1_F103 | Front bearing rear cover;M3 clearance holes | 52.5 | -37.77 | 115.25 | 98.5 | -35.77 | 152.5
RIGHT_U1_F104 | 16ODx12.1IDx2.7 rear inner-ring abutment with positive end float | 67.5 | -88.95 | 126.25 | 83.5 | -86.25 | 142.25
RIGHT_U1_F105 | 16ODx12.1IDx1 rear-bearing abutment;shaft-shoulder side C0.30 | 67.5 | -78.25 | 126.25 | 83.5 | -77.25 | 142.25
RIGHT_U1_F106 | 19.5ODx15.1IDx1 front inner-ring abutment | 65.75 | -36.75 | 124.5 | 85.25 | -35.75 | 144
RIGHT_U1_F107 | 17.5ODx10.1IDx1.5 roller spacer;shaft-shoulder side C0.30 | 66.75 | -16.75 | 125.5 | 84.25 | -15.25 | 143
RIGHT_U1_F108 | 17.5ODx5.5IDx3 positive roller end plate | 66.75 | 4.75 | 125.5 | 84.25 | 7.75 | 143
RIGHT_U1_F109 | C45 roller key3x4x18;inside perimeter C0.20 | 74 | -14.25 | 137.45 | 77 | 3.75 | 141.45
RIGHT_U1_F110 | Secondary-keyed UMCL40-10-20-MC;18mm collar;MC4mm urethane-access holes | 55.4999998732 | -15.2500001 | 114.2499999 | 95.5000001 | 4.7500001 | 154.2500001
RIGHT_U1_RB01 | SKF6001-2Z/C3 external interface | 61.5 | -86.25 | 120.25 | 89.5 | -78.25 | 148.25
RIGHT_U1_RB02 | SKF6002-2Z/C3 interface;minimum R0.3 inner shoulder corner | 59.5 | -35.75 | 118.25 | 91.5 | -26.75 | 150.25
RIGHT_U1_RR01 | SEEGER A12 installed envelope;centred between rounded groove roots | 66.4 | -90.19 | 125.15 | 84.6 | -89.19 | 143.35
RIGHT_U1_RN01 | SKF KM2 M15x1 nut | 63.1610373207 | -42.75 | 121.911037321 | 87.8389626793 | -37.75 | 146.588962679
RIGHT_U1_RW01 | SKF MB2;actual4mm inward tang in open shaft slot | 61.5 | -37.75 | 120.25 | 89.5 | -36.75 | 148.25
RIGHT_U1_FB01 | ISO4762 M5x16 class10.9 roller retention;socket omitted | 71.25 | -8.25 | 130 | 79.75 | 12.75 | 138.5
RIGHT_U1_FMB1 | ISO4762 M4x20 class10.9 front-module screw | 88 | -28.25 | 143.75 | 95 | -21.25 | 167.75
RIGHT_U1_FMW1 | ISO7092 M4 washer4.3x8x0.5 200HV | 87.5 | -28.75 | 163.25 | 95.5 | -20.75 | 163.75
RIGHT_U1_FDP1 | ISO8734 dowel3m6x20;recessed1.5mm from underside | 84 | -21.25 | 146.75 | 87 | -18.25 | 166.75
RIGHT_U1_FMB2 | ISO4762 M4x20 class10.9 front-module screw | 56 | -28.25 | 143.75 | 63 | -21.25 | 167.75
RIGHT_U1_FMW2 | ISO7092 M4 washer4.3x8x0.5 200HV | 55.5 | -28.75 | 163.25 | 63.5 | -20.75 | 163.75
RIGHT_U1_FDP2 | ISO8734 dowel3m6x20;recessed1.5mm from underside | 64 | -21.25 | 146.75 | 67 | -18.25 | 166.75
RIGHT_U1_FCB1 | ISO4762 M3x8 class8.8 locating-bearing cover screw | 91.75 | -40.77 | 144 | 97.25 | -29.77 | 149.5
RIGHT_U1_FCB2 | ISO4762 M3x8 class8.8 locating-bearing cover screw | 91.75 | -40.77 | 119 | 97.25 | -29.77 | 124.5
RIGHT_U1_FCB3 | ISO4762 M3x8 class8.8 locating-bearing cover screw | 53.75 | -40.77 | 144 | 59.25 | -29.77 | 149.5
RIGHT_U1_FCB4 | ISO4762 M3x8 class8.8 locating-bearing cover screw | 53.75 | -40.77 | 119 | 59.25 | -29.77 | 124.5
RIGHT_U2_F101 | 42CrMo4+QT rotor;matched j5 bearing seats;nominal-major cosmetic threads | 128.5 | -108.75 | 124.75 | 147.5 | 4.25 | 143.75
RIGHT_U2_F102 | 6082-T6 rear bearing/base;front module removable for assembly | 115 | -89.75 | 115.25 | 161 | -16.75 | 168.25
RIGHT_U2_F112 | 6082-T6 removable locating-bearing module;32.008–32.019 bore;matched to F102 | 115 | -35.77 | 115.2499999 | 161 | -16.7499999 | 152.7500001
RIGHT_U2_F103 | Front bearing rear cover;M3 clearance holes | 115 | -37.77 | 115.25 | 161 | -35.77 | 152.5
RIGHT_U2_F104 | 16ODx12.1IDx2.7 rear inner-ring abutment with positive end float | 130 | -88.95 | 126.25 | 146 | -86.25 | 142.25
RIGHT_U2_F105 | 16ODx12.1IDx1 rear-bearing abutment;shaft-shoulder side C0.30 | 130 | -78.25 | 126.25 | 146 | -77.25 | 142.25
RIGHT_U2_F106 | 19.5ODx15.1IDx1 front inner-ring abutment | 128.25 | -36.75 | 124.5 | 147.75 | -35.75 | 144
RIGHT_U2_F107 | 17.5ODx10.1IDx1.5 roller spacer;shaft-shoulder side C0.30 | 129.25 | -16.75 | 125.5 | 146.75 | -15.25 | 143
RIGHT_U2_F108 | 17.5ODx5.5IDx3 positive roller end plate | 129.25 | 4.75 | 125.5 | 146.75 | 7.75 | 143
RIGHT_U2_F109 | C45 roller key3x4x18;inside perimeter C0.20 | 136.5 | -14.25 | 137.45 | 139.5 | 3.75 | 141.45
RIGHT_U2_F110 | Secondary-keyed UMCL40-10-20-MC;18mm collar;MC4mm urethane-access holes | 117.999999873 | -15.2500001 | 114.2499999 | 158.0000001 | 4.7500001 | 154.2500001
RIGHT_U2_RB01 | SKF6001-2Z/C3 external interface | 124 | -86.25 | 120.25 | 152 | -78.25 | 148.25
RIGHT_U2_RB02 | SKF6002-2Z/C3 interface;minimum R0.3 inner shoulder corner | 122 | -35.75 | 118.25 | 154 | -26.75 | 150.25
RIGHT_U2_RR01 | SEEGER A12 installed envelope;centred between rounded groove roots | 128.9 | -90.19 | 125.15 | 147.1 | -89.19 | 143.35
RIGHT_U2_RN01 | SKF KM2 M15x1 nut | 125.661037321 | -42.75 | 121.911037321 | 150.338962679 | -37.75 | 146.588962679
RIGHT_U2_RW01 | SKF MB2;actual4mm inward tang in open shaft slot | 124 | -37.75 | 120.25 | 152 | -36.75 | 148.25
RIGHT_U2_FB01 | ISO4762 M5x16 class10.9 roller retention;socket omitted | 133.75 | -8.25 | 130 | 142.25 | 12.75 | 138.5
RIGHT_U2_FMB1 | ISO4762 M4x20 class10.9 front-module screw | 150.5 | -28.25 | 143.75 | 157.5 | -21.25 | 167.75
RIGHT_U2_FMW1 | ISO7092 M4 washer4.3x8x0.5 200HV | 150 | -28.75 | 163.25 | 158 | -20.75 | 163.75
RIGHT_U2_FDP1 | ISO8734 dowel3m6x20;recessed1.5mm from underside | 146.5 | -21.25 | 146.75 | 149.5 | -18.25 | 166.75
RIGHT_U2_FMB2 | ISO4762 M4x20 class10.9 front-module screw | 118.5 | -28.25 | 143.75 | 125.5 | -21.25 | 167.75
RIGHT_U2_FMW2 | ISO7092 M4 washer4.3x8x0.5 200HV | 118 | -28.75 | 163.25 | 126 | -20.75 | 163.75
RIGHT_U2_FDP2 | ISO8734 dowel3m6x20;recessed1.5mm from underside | 126.5 | -21.25 | 146.75 | 129.5 | -18.25 | 166.75
RIGHT_U2_FCB1 | ISO4762 M3x8 class8.8 locating-bearing cover screw | 154.25 | -40.77 | 144 | 159.75 | -29.77 | 149.5
RIGHT_U2_FCB2 | ISO4762 M3x8 class8.8 locating-bearing cover screw | 154.25 | -40.77 | 119 | 159.75 | -29.77 | 124.5
RIGHT_U2_FCB3 | ISO4762 M3x8 class8.8 locating-bearing cover screw | 116.25 | -40.77 | 144 | 121.75 | -29.77 | 149.5
RIGHT_U2_FCB4 | ISO4762 M3x8 class8.8 locating-bearing cover screw | 116.25 | -40.77 | 119 | 121.75 | -29.77 | 124.5
RIGHT_TB01 | HTBN225S5M-250 external backing envelope;tooth engagement excluded | 56.6545056908 | -73.75 | 70.9045056908 | 156.845494309 | -48.75 | 108.595494309
