sbelakho2/Cutting/engineering/generated/adapter-r6-analysis/checks.csv

id | category | value | limit | unit | result | provenance
motor_running_margin | conditional_design | 1.26881122108 | 1.25 | ratio | PASS | 60V/5.7Arms catalogue curve;80% qualification reserve
coupling_working_torque | catalogue_screen | 4.65002192759 | 10 | Nm | PASS | MK2/100 catalogue
fixed_bearing_stall_thrust | catalogue_screen | 5340.7075111 | 6320 | N | PASS | HIWIN6320N maximum axial, not9240N rating
ballscrew_static_factor | catalogue_screen | 2.36710210655 | 2 | ratio | PASS | HIWIN static capacity / calculated stall thrust
guide_combined_static_screen | conditional_design | 0.419664763102 | 0.5 | utilisation | PASS | Linear sum; imposed2500/750/375N load case; required factor2
screw_basic_l10_revolutions | informational | 116582194.665 | 1000000 | rev | PASS | Specified illustrative travel-weighted spectrum; NOT machine life
coupling_elastic_position | catalogue_screen | 0.000817761298631 | 0.005 | mm | PASS | Catalogue torsional stiffness; one axis
pulse_frequency | catalogue_screen | 1250 | 40000 | Hz | PASS | Shared controller pulse ceiling
holder_axial_average_stress | conditional_design | 0.811688311688 | 216.666666667 | MPa | PASS | Certified650MPa steel requirement; local stresses require FEA
holder_joint_slip | conditional_design | 2500 | 5357.8125 | N | PASS | M6 class12.9; required measured9kN preload; qualify mu>=0.15
holder_joint_bolt_proof | conditional_design | 0.462811586398 | 0.75 | utilisation | PASS | ISO898 class12.9 proof970MPa; required preload, not torque prediction
wire_tension_error_0p5mm2_1m | sensitivity | 0.0909090909091 | 0.7 | mm | PASS | 110GPa copper, imposed5N tension; strand/layer compliance excluded
encoder_runout_error_bound | catalogue_screen | 0.2 | 0.2 | mm | PASS | Kuebler0.2mm radialTIR => first-order arbitrary-phase error<=0.2mm
motor_encoder_count_spacing | informational | 0.0025 | 0.2 | mm | PASS | 4000CPR; resolution only
axis_power_screen | conditional_design | 103.847102222 | 243.6 | W | PASS | 70% electrical budget; winding+driver loss factors are qualification loads
driver_at_40C_room_with_5C_rise | design_failure | 45 | 40 | degC | FAIL | Driver manual maximum40C; ventilation alone cannot cool below room
uncalibrated_length_budget_1m | design_failure | 1.65 | 0.7 | mm | FAIL | Bounded sum:0.2runout/0.05quantisation/1.0factory_circumference/0.15tension/0.25slip;Kuebler100plusminus0.1mm;other terms are allocations,not measured errors
