sbelakho2/Cutting/engineering/sources/rw-mk2-ordering.png

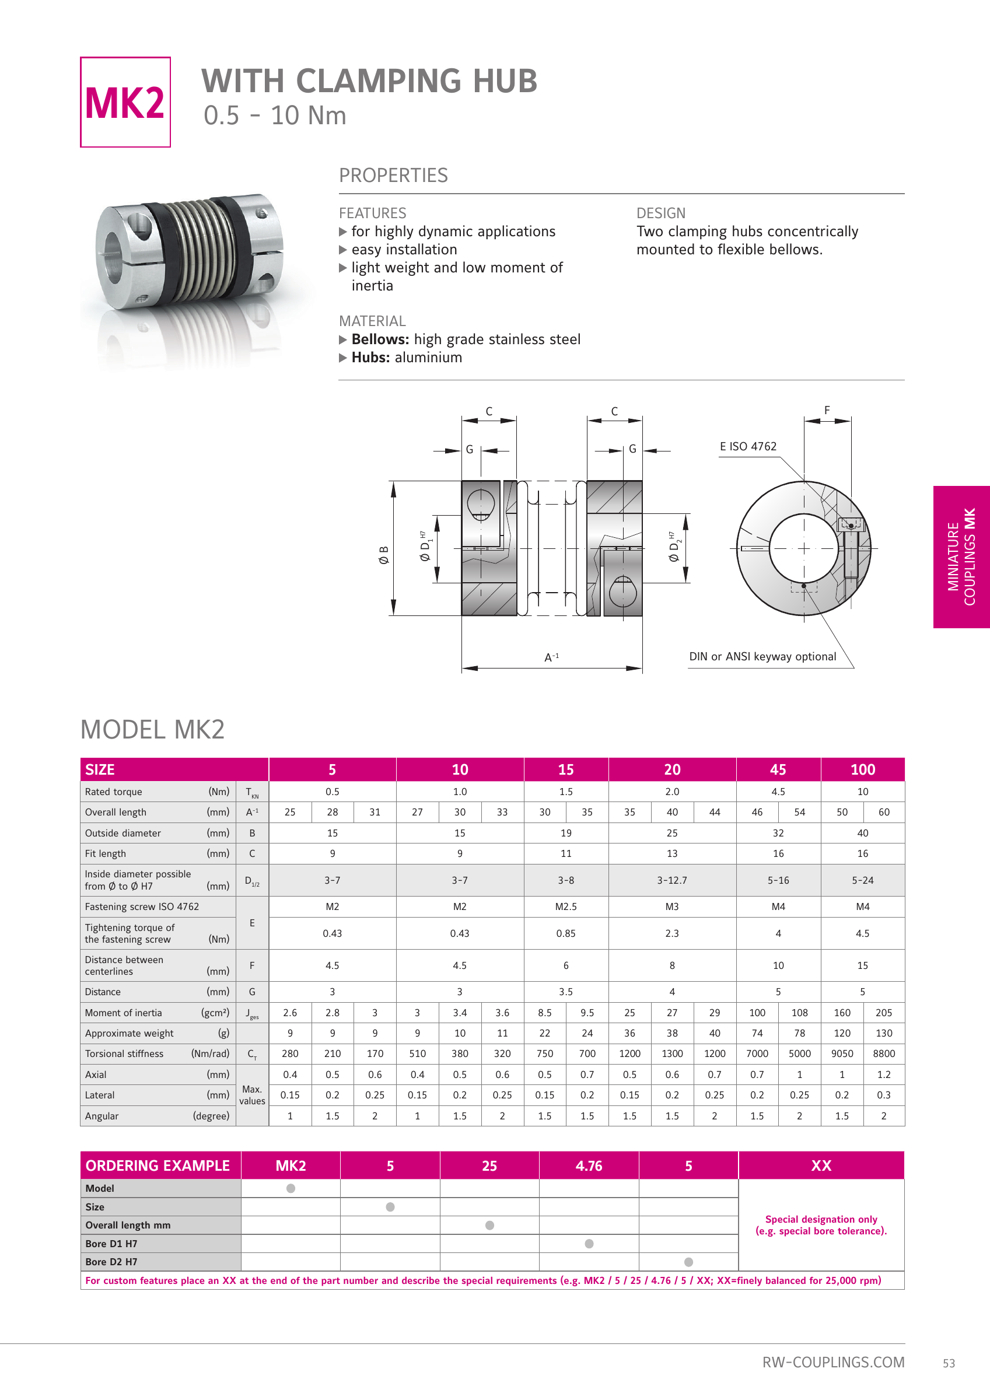
engineering/sources/rw-mk2-ordering.png
