sbelakho2/Cutting/engineering/generated/adapter-r6-analysis/fem/adapter.step

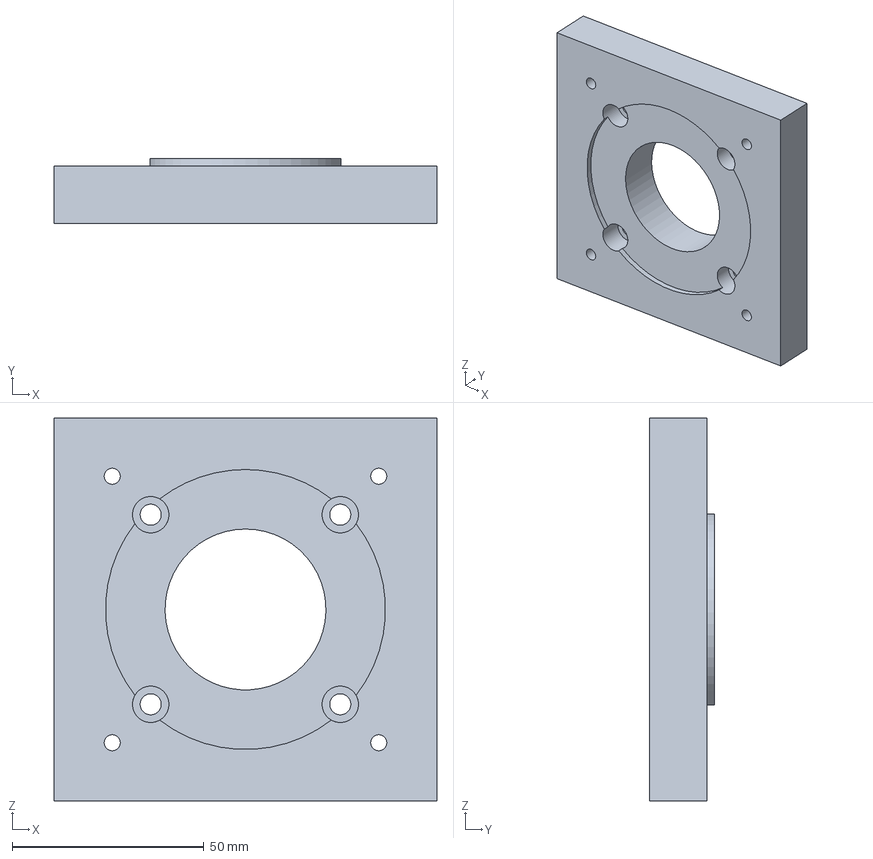
[picture p20: CAD file, 2026-09-16]
engineering/generated/adapter-r6-analysis/fem/adapter.step
100.0 x 17.0 x 100.0 mm
