sbelakho2/Cutting/engineering/generated/analysis/fem/holder.step

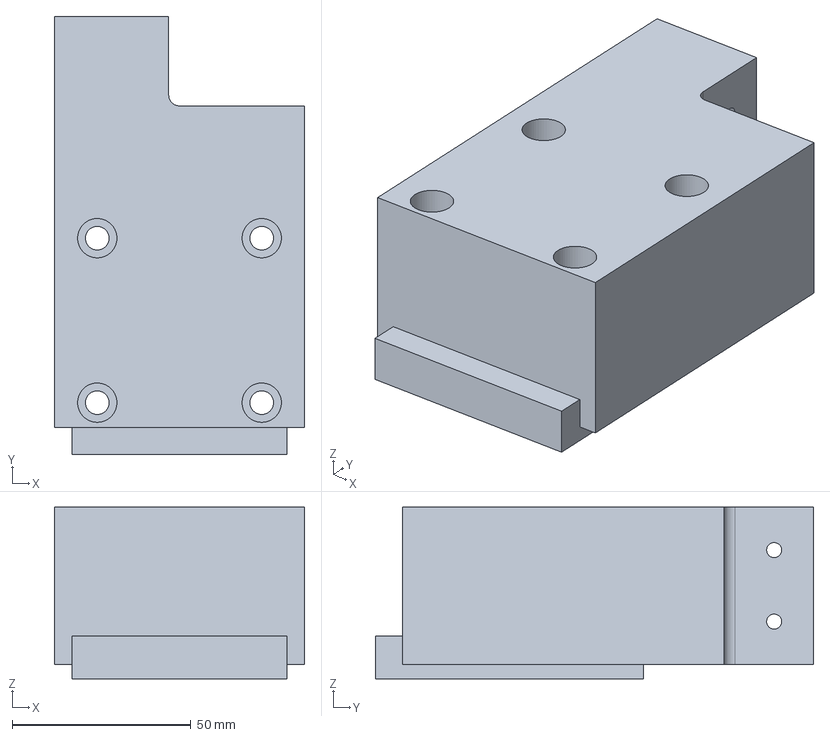
[picture p21: CAD file, 2026-09-13]
engineering/generated/analysis/fem/holder.step
70.0 x 122.5 x 48.0 mm
