sbelakho2/Cutting/engineering/generated/feed-cassette/feed-cassette.step

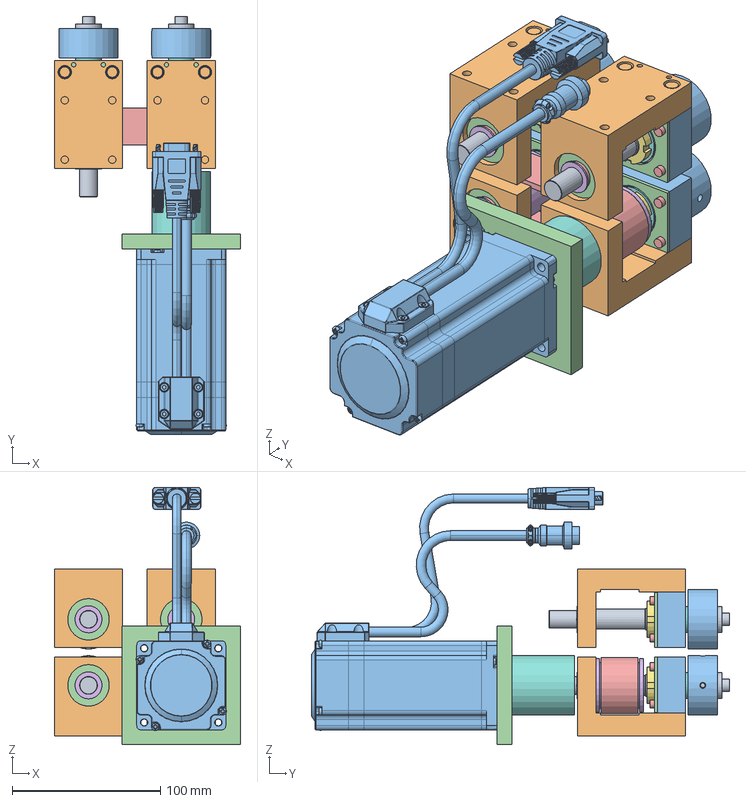
[picture p22: CAD file, 2026-09-13]
engineering/generated/feed-cassette/feed-cassette.step
125.5 x 281.7 x 173.5 mm
