sbelakho2/Cutting/engineering/generated/feed-cassette/step/U1_FMW2.step

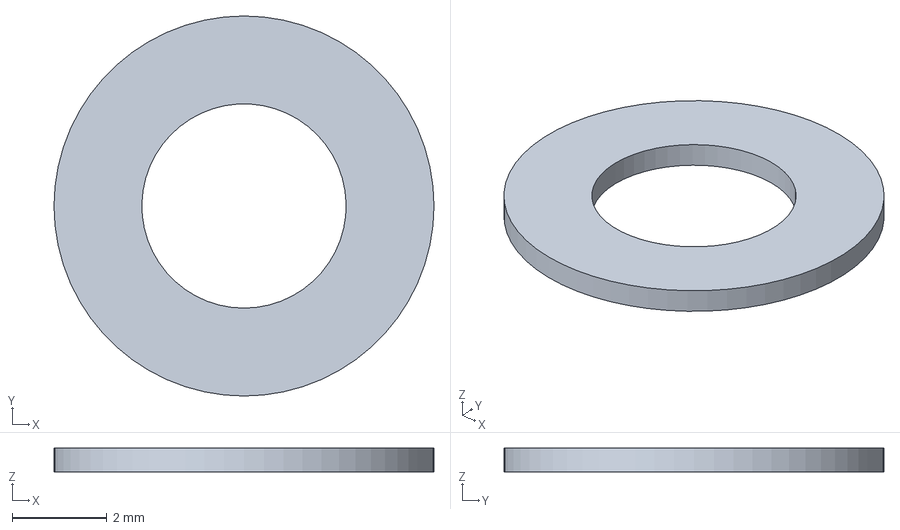
[picture p23: CAD file, 2026-09-13]
engineering/generated/feed-cassette/step/U1_FMW2.step
8.00 x 8.00 x 0.5 mm
