sbelakho2/Cutting/engineering/generated/feed-fem-boundary-detail/netgen-torus-focus/F101-R6-analysis.step

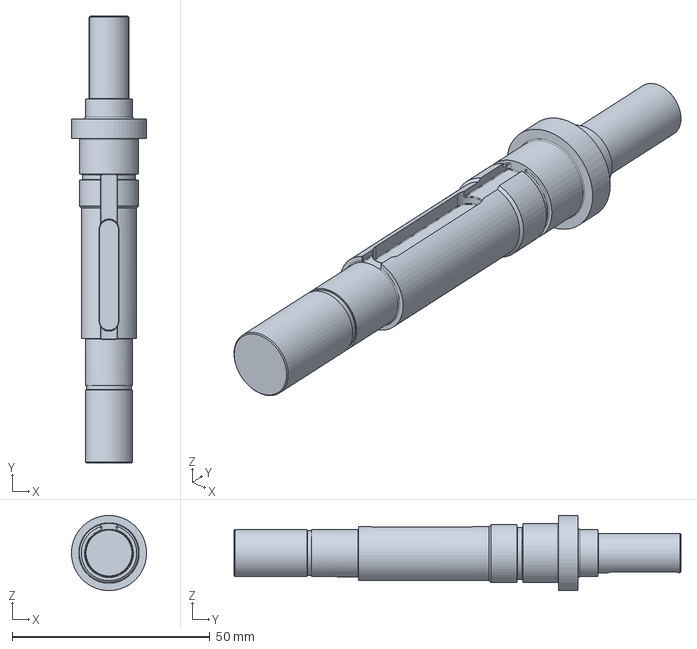
[picture p24: CAD file, 2026-09-13]
engineering/generated/feed-fem-boundary-detail/netgen-torus-focus/F101-R6-analysis.step
19.0 x 113.0 x 19.0 mm
