sbelakho2/Cutting/engineering/generated/feed-submodel/gmsh/m15_relief/submodel.step

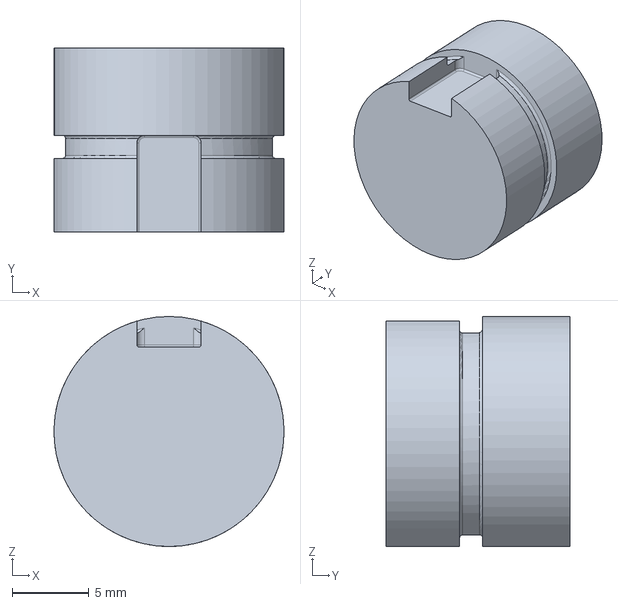
[picture p25: CAD file, 2026-09-16]
engineering/generated/feed-submodel/gmsh/m15_relief/submodel.step
15.0 x 12.0 x 15.0 mm
