sbelakho2/Cutting/engineering/generated/feed-submodel/gmsh/pulley_key_fault/submodel.step

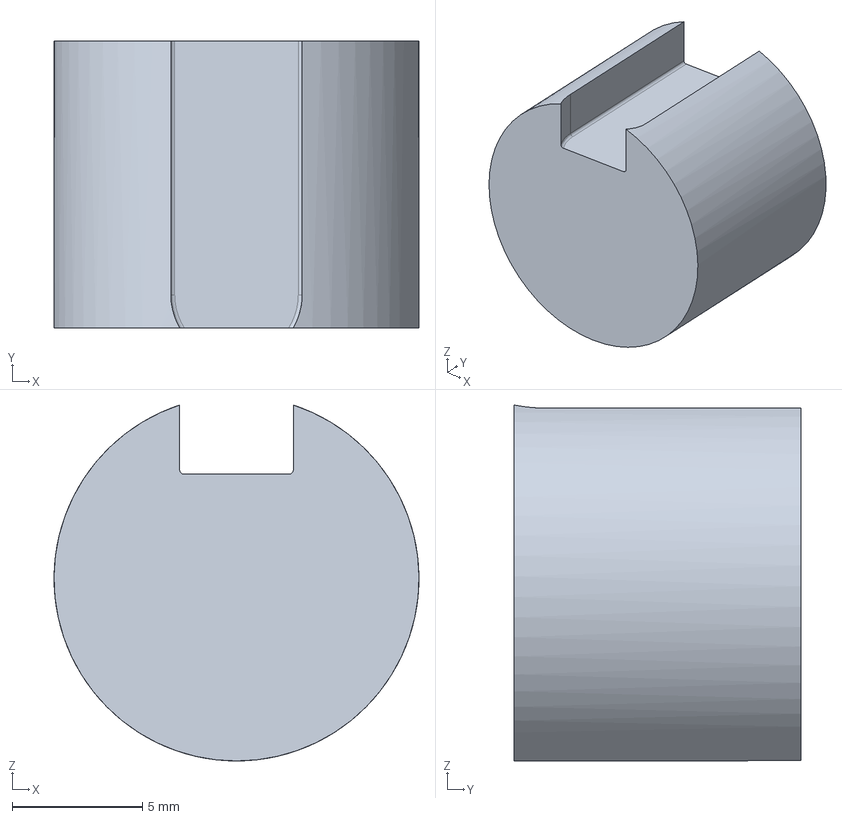
[picture p26: CAD file, 2026-09-16]
engineering/generated/feed-submodel/gmsh/pulley_key_fault/submodel.step
14.0 x 11.0 x 13.7 mm
