sbelakho2/Cutting/engineering/generated/feed-submodel/gmsh/pulley_key_working/submodel.step

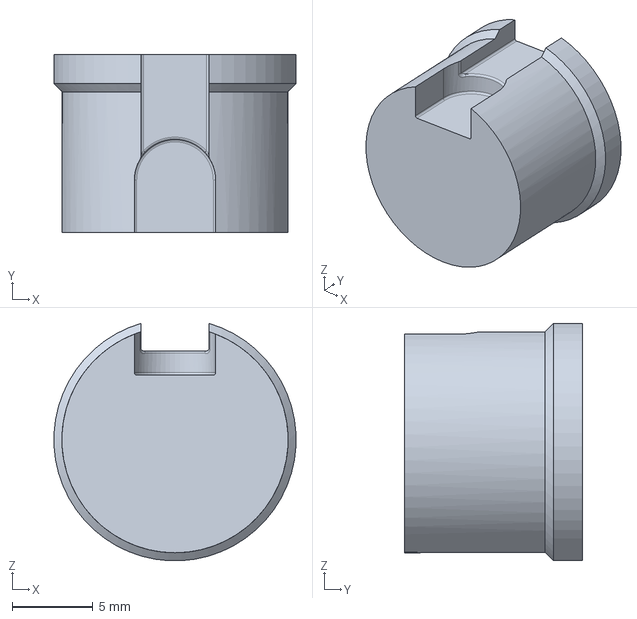
[picture p27: CAD file, 2026-09-16]
engineering/generated/feed-submodel/gmsh/pulley_key_working/submodel.step
15.0 x 11.0 x 14.7 mm
