sbelakho2/Cutting/engineering/generated/feed-submodel/gmsh/roller_key_root/submodel.step

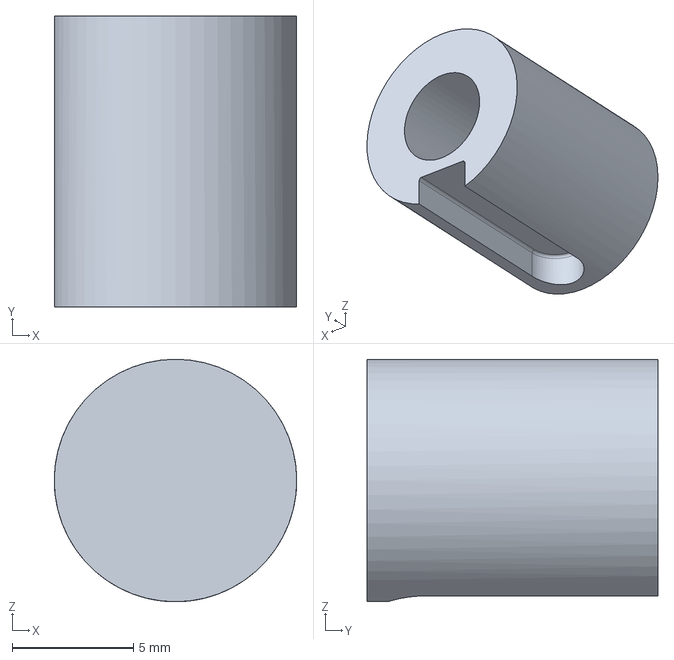
[picture p28: CAD file, 2026-09-16]
engineering/generated/feed-submodel/gmsh/roller_key_root/submodel.step
10.0 x 12.0 x 10.0 mm
