sbelakho2/Cutting/engineering/generated/feed-submodel/gmsh/roller_shoulder/submodel.step

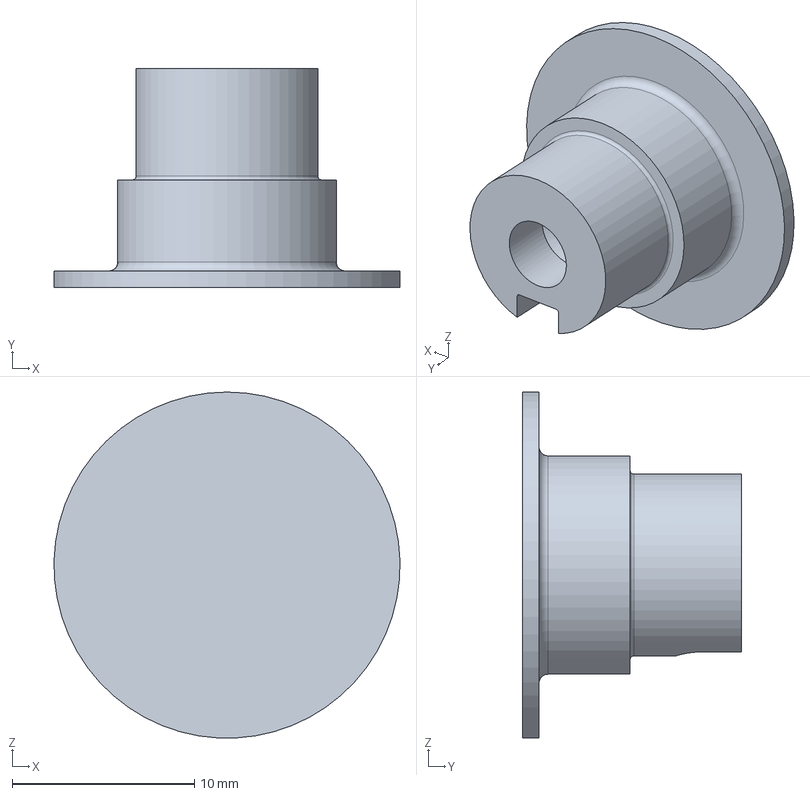
[picture p29: CAD file, 2026-09-16]
engineering/generated/feed-submodel/gmsh/roller_shoulder/submodel.step
19.0 x 12.0 x 19.0 mm
