sbelakho2/Cutting/engineering/generated/feed/feed-cartridge.step

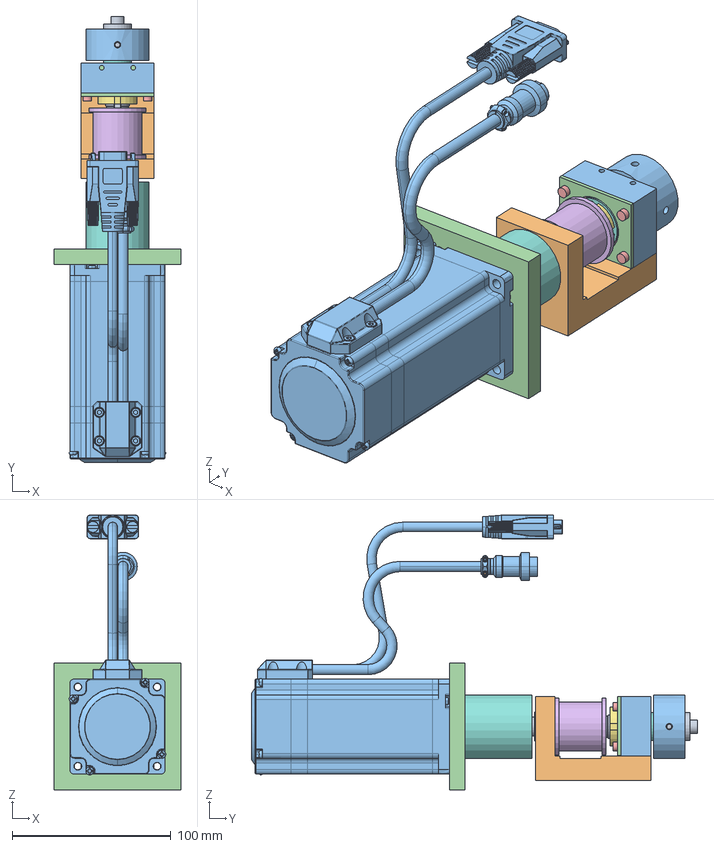
[picture p30: CAD file, 2026-09-13]
engineering/generated/feed/feed-cartridge.step
80.0 x 281.7 x 173.5 mm
