sbelakho2/Cutting/engineering/generated/feed/step/FM01.step

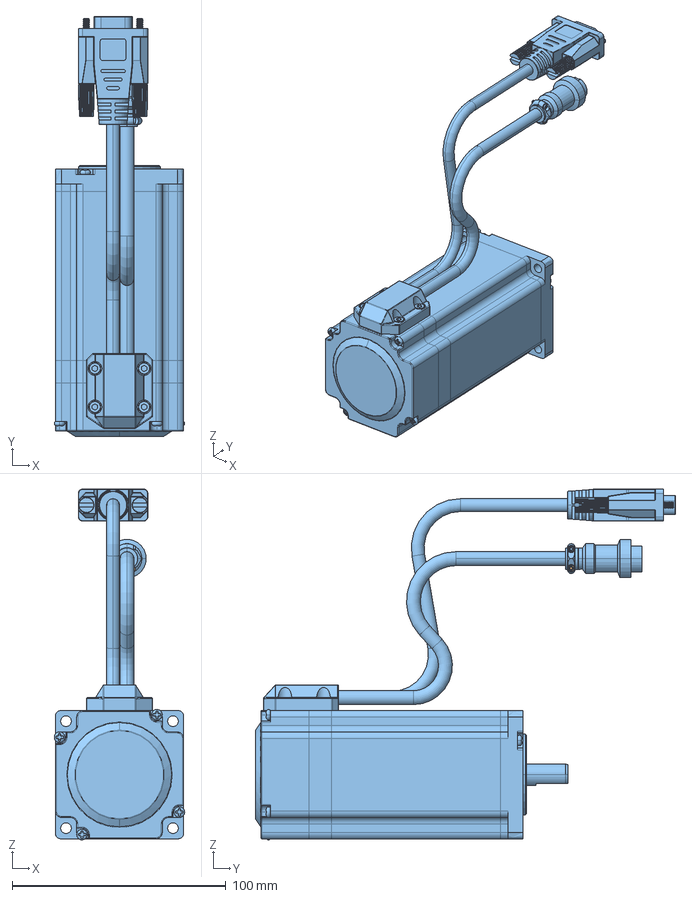
[picture p31: CAD file, 2026-09-13]
engineering/generated/feed/step/FM01.step
61.0 x 196.3 x 164.0 mm
