sbelakho2/Cutting/engineering/generated/head/step/T001_R.step

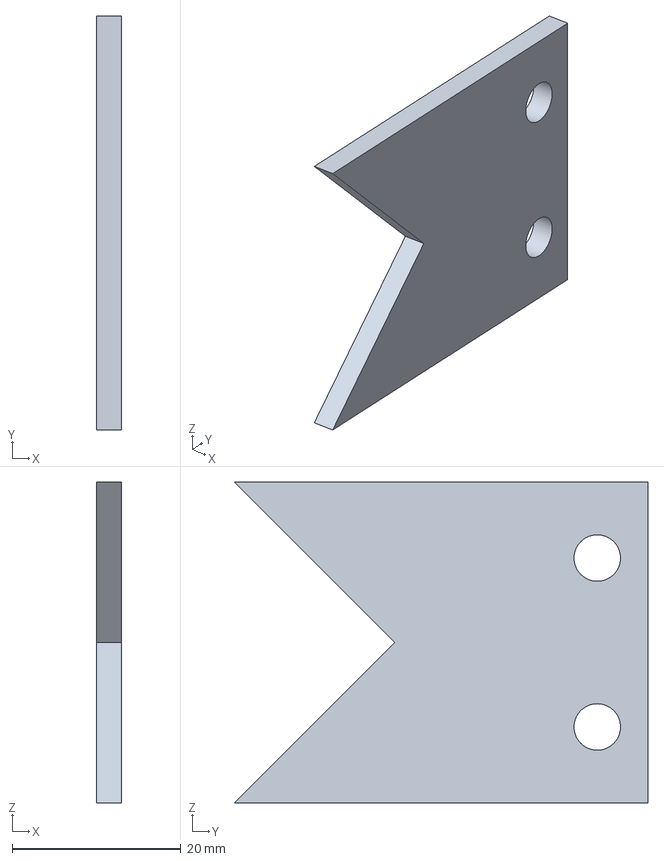
[picture p32: CAD file, 2026-10-13]
engineering/generated/head/step/T001_R.step
3.00 x 49.0 x 38.0 mm
