sbelakho2/Cutting/engineering/generated/measurement/encoder-mount.step

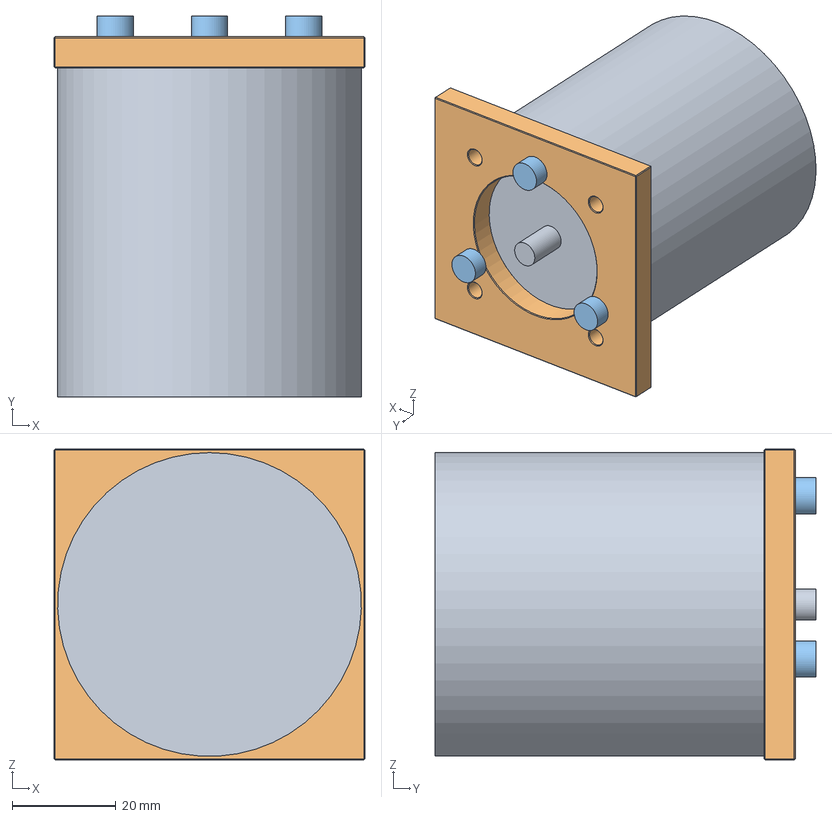
[picture p33: CAD file, 2026-09-16]
engineering/generated/measurement/encoder-mount.step
60.0 x 73.5 x 60.0 mm
