sbelakho2/Cutting/engineering/generated/measurement/step/M201.step

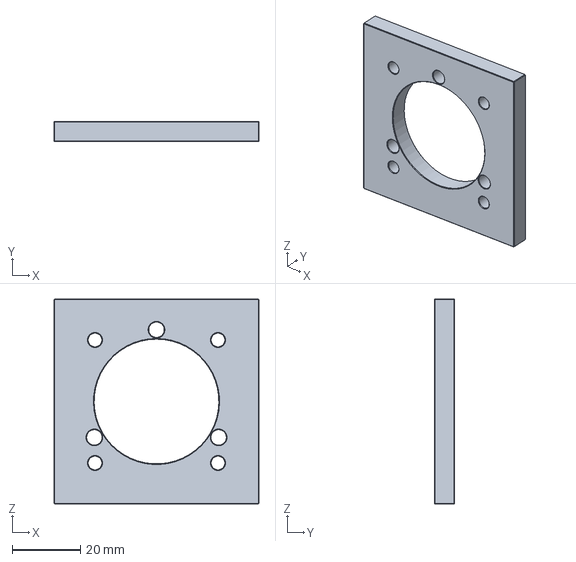
[picture p34: CAD file, 2026-09-16]
engineering/generated/measurement/step/M201.step
60.0 x 6.00 x 60.0 mm
