sbelakho2/Cutting/engineering/sources/CL86T-V41.step

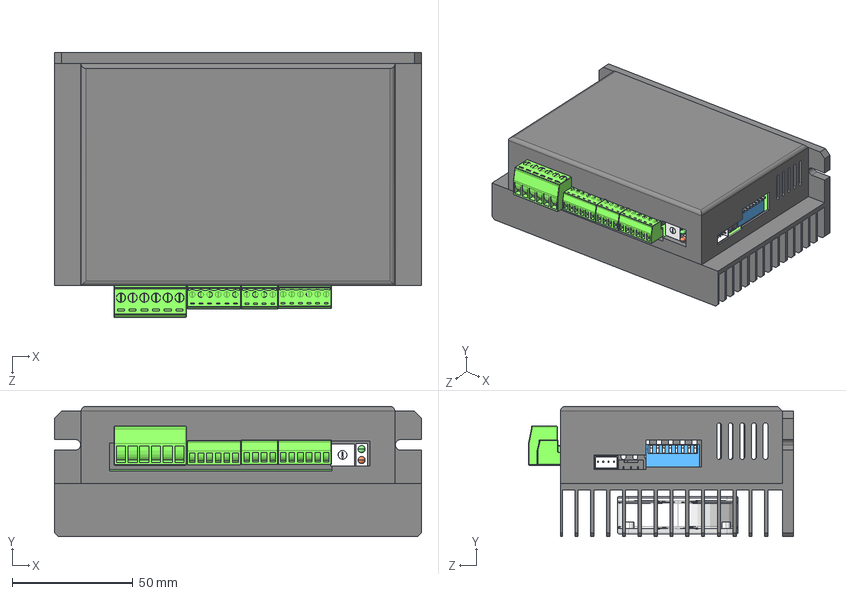
[picture p35: CAD file, 2026-09-13]
engineering/sources/CL86T-V41.step
152.0 x 53.9 x 109.8 mm
