sbelakho2/Cutting/hardware/if-b01/manufacturing/draft-r2-2026-09-13/mechanical/if-b01-board-only.step

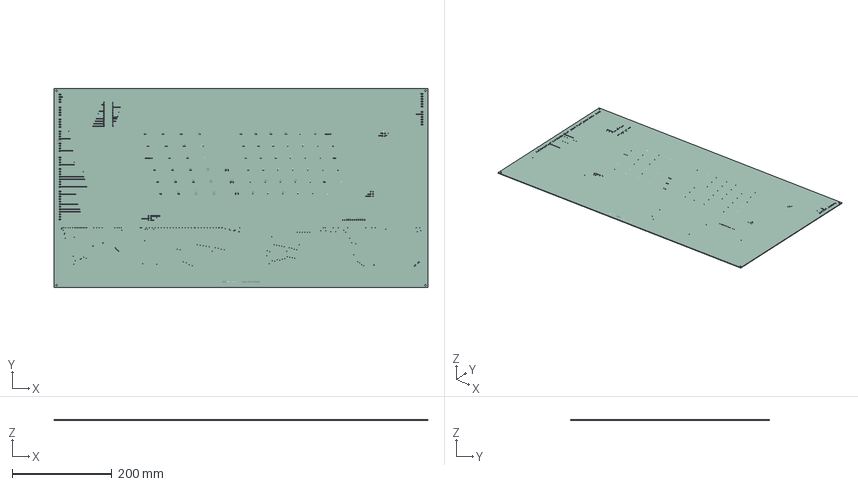
[picture p36: CAD file, 2026-10-13]
hardware/if-b01/manufacturing/draft-r2-2026-09-13/mechanical/if-b01-board-only.step
750.0 x 400.0 x 1.64 mm
if-b01_copper
if-b01_pad
if-b01_via
if-b01_silkscreen
if-b01_soldermask x 2
if-b01_PCB
