sbelakho2/Cutting/engineering/generated/analysis/fem/datum.step

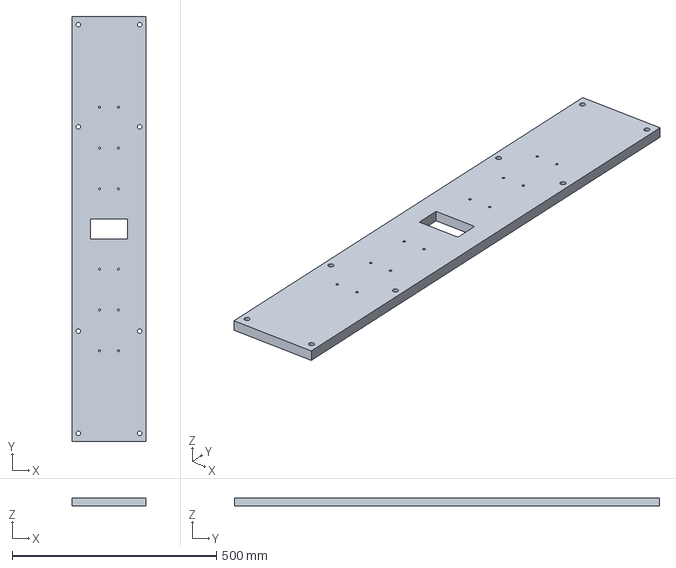
[picture p37: CAD file, 2026-09-13]
engineering/generated/analysis/fem/datum.step
180.0 x 1040.0 x 20.0 mm
