sbelakho2/Cutting/engineering/generated/feed-cassette/step/U1_RB01.step

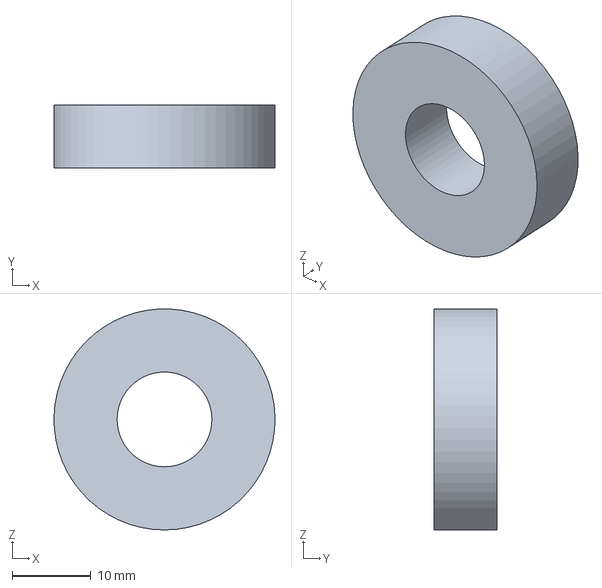
[picture p38: CAD file, 2026-09-13]
engineering/generated/feed-cassette/step/U1_RB01.step
28.0 x 8.00 x 28.0 mm
