sbelakho2/Cutting/engineering/generated/feed/step/F108.step

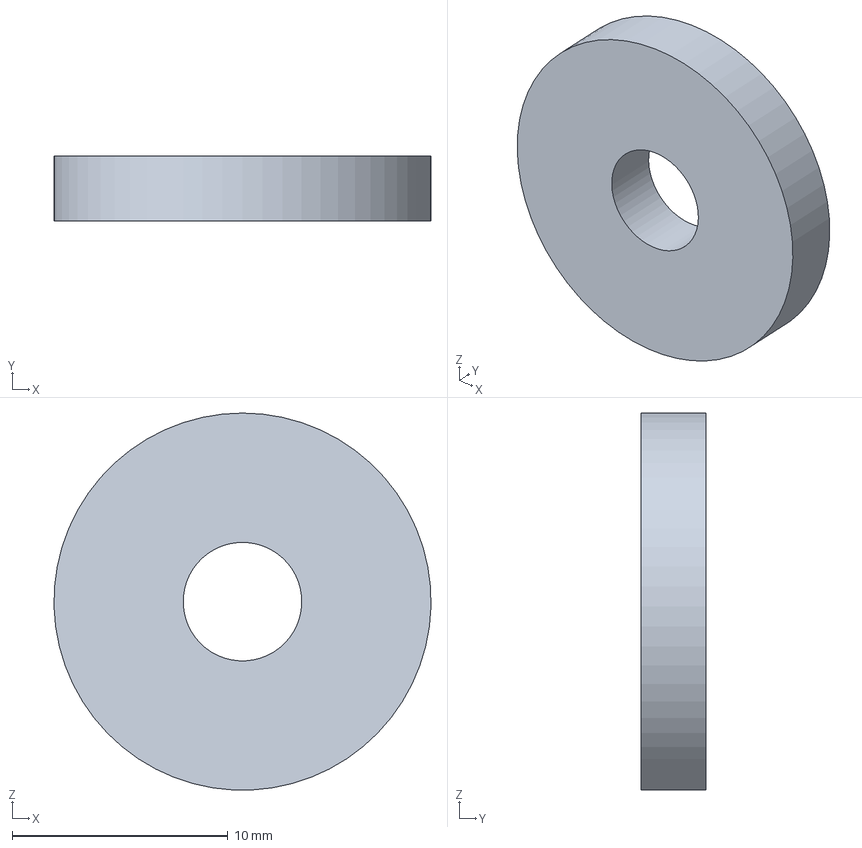
[picture p39: CAD file, 2026-09-13]
engineering/generated/feed/step/F108.step
17.5 x 3.00 x 17.5 mm
