sbelakho2/Cutting/engineering/generated/head/step/AX01-R_R.step

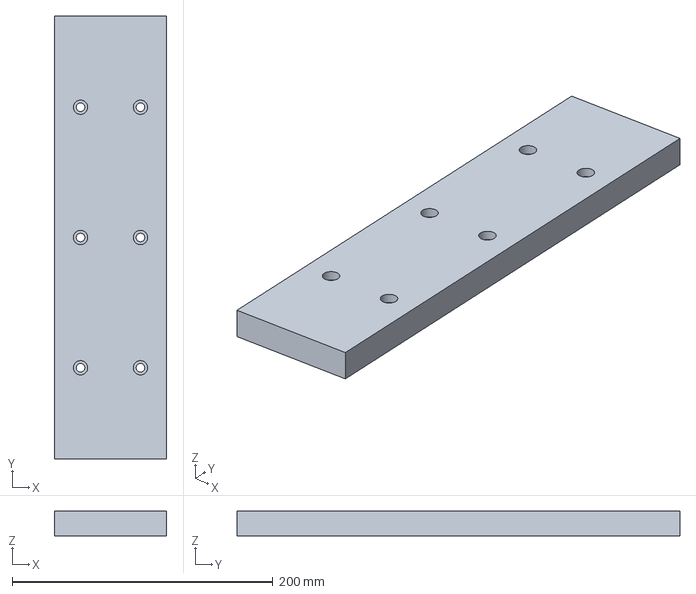
[picture p40: CAD file, 2026-10-13]
engineering/generated/head/step/AX01-R_R.step
86.0 x 340.0 x 19.0 mm
