sbelakho2/Cutting/engineering/generated/measurement/step/ME-E01.step

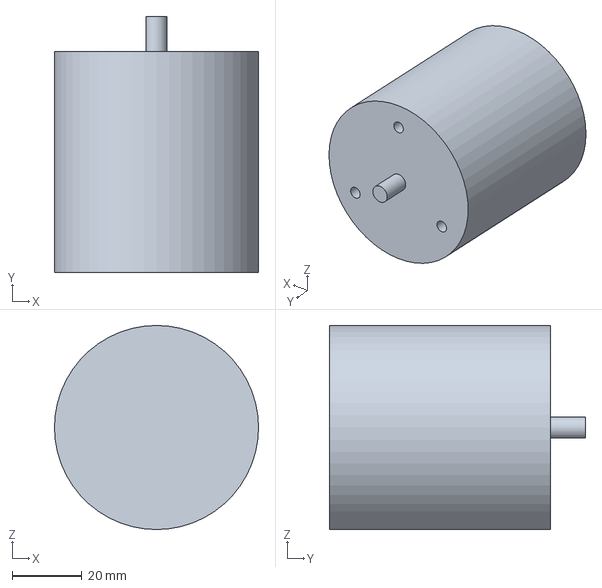
[picture p41: CAD file, 2026-09-16]
engineering/generated/measurement/step/ME-E01.step
58.6 x 73.5 x 58.6 mm
