sbelakho2/Cutting/engineering/sources/34E1K-85.step

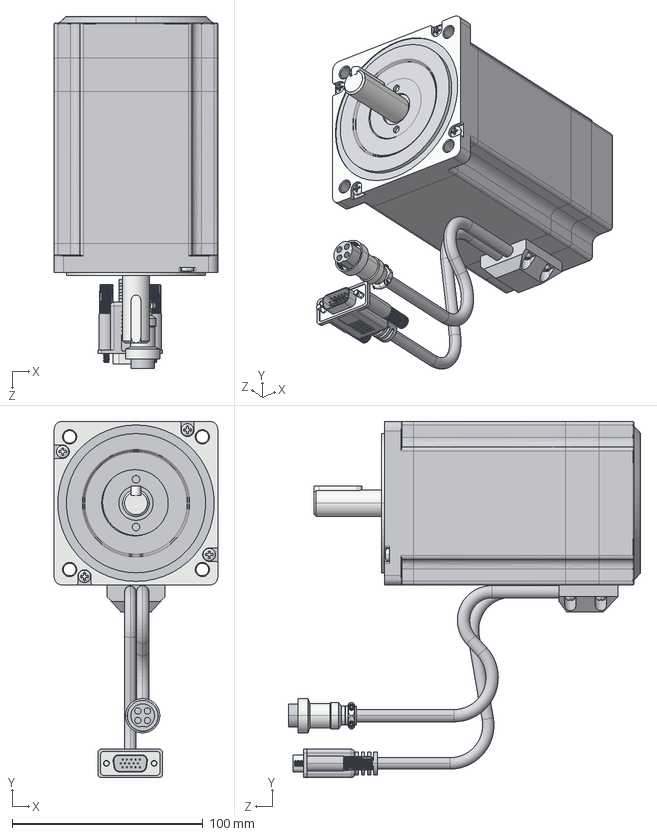
[picture p42: CAD file, 2026-09-13]
engineering/sources/34E1K-85.step
85.9 x 186.9 x 184.6 mm
