sbelakho2/Cutting/engineering/generated/analysis/fem/adapter.step

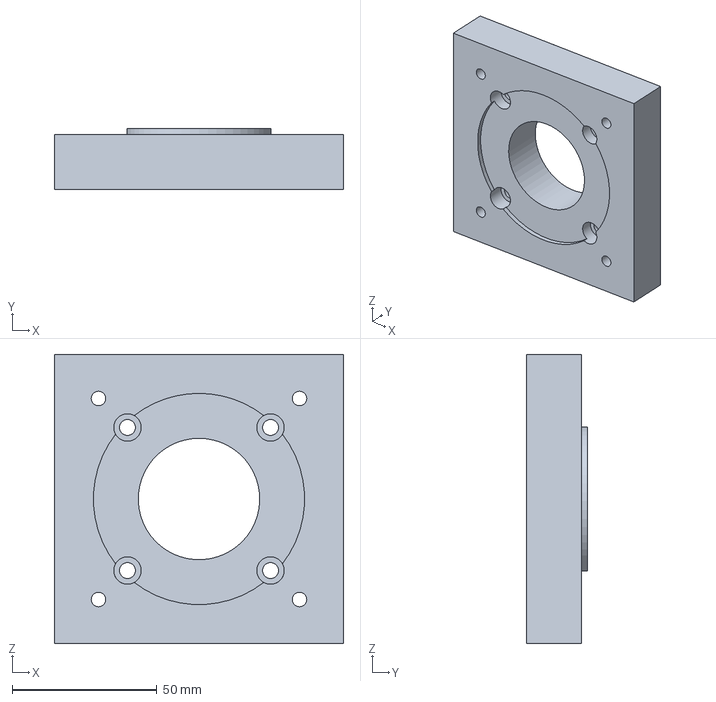
[picture p43: CAD file, 2026-09-13]
engineering/generated/analysis/fem/adapter.step
100.0 x 21.0 x 100.0 mm
