sbelakho2/Cutting/engineering/generated/feed-cassette/step/U1_F103.step

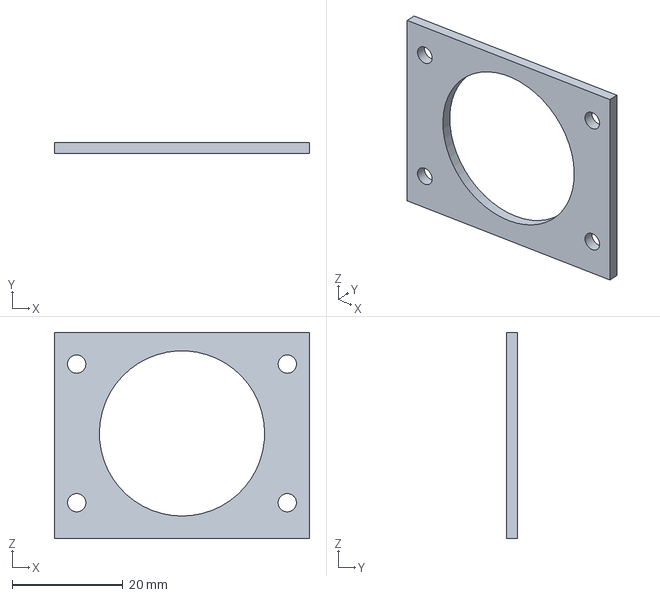
[picture p44: CAD file, 2026-09-13]
engineering/generated/feed-cassette/step/U1_F103.step
46.0 x 2.00 x 37.2 mm
