sbelakho2/Cutting/engineering/generated/feed/step/FCB4.step

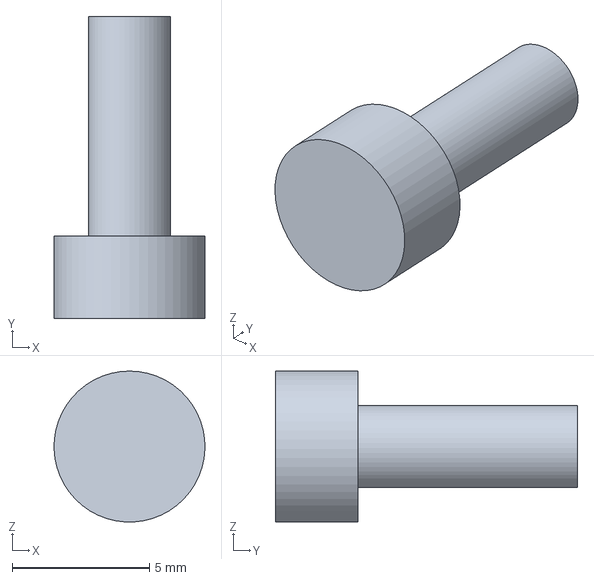
[picture p45: CAD file, 2026-09-13]
engineering/generated/feed/step/FCB4.step
5.50 x 11.0 x 5.49 mm
