sbelakho2/Cutting/engineering/generated/head/holder-local.step

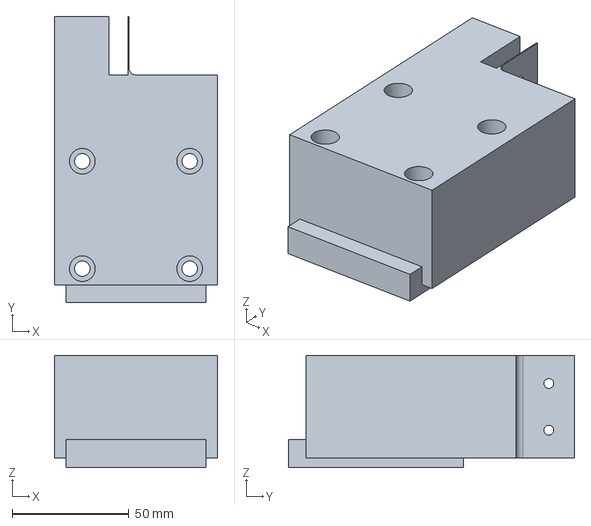
[picture p46: CAD file, 2026-10-13]
engineering/generated/head/holder-local.step
70.0 x 122.5 x 48.0 mm
