sbelakho2/Cutting/engineering/generated/head/step/HF0-W4_F.step

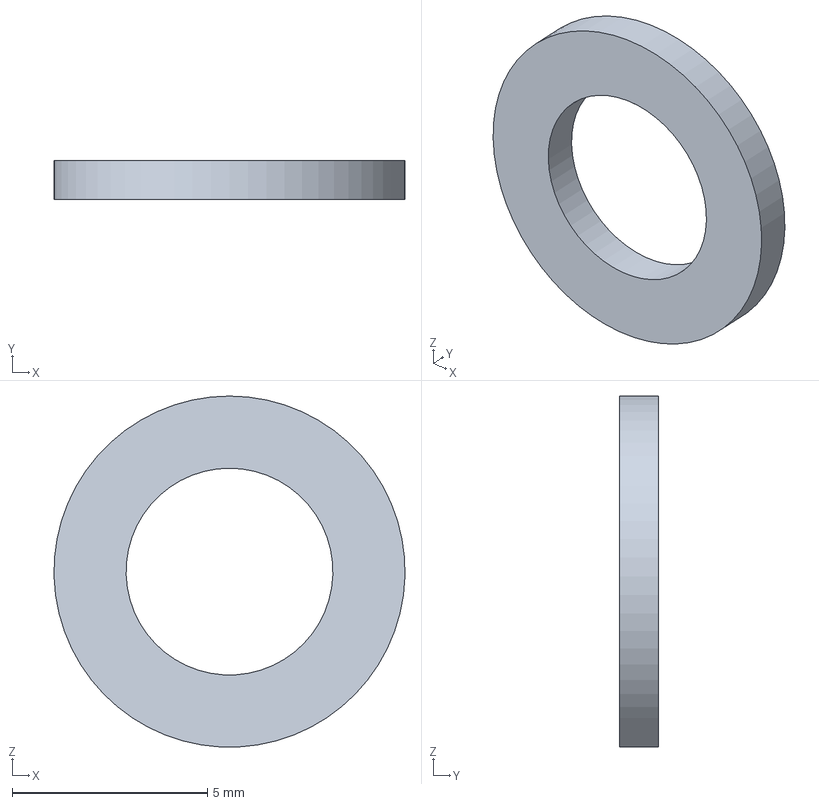
[picture p47: CAD file, 2026-10-13]
engineering/generated/head/step/HF0-W4_F.step
9.00 x 1.00 x 8.99 mm
