sbelakho2/Cutting/engineering/generated/measurement/step/ME-C01.step

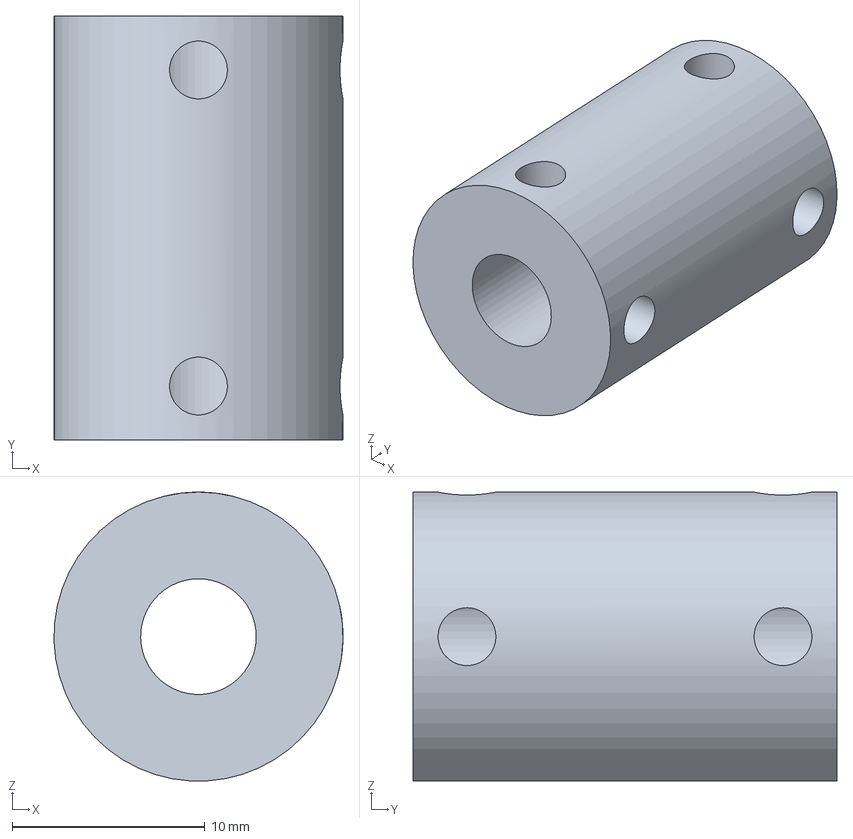
[picture p48: CAD file, 2026-09-16]
engineering/generated/measurement/step/ME-C01.step
15.0 x 22.0 x 15.0 mm
