sbelakho2/Cutting/engineering/sources/LE-350-60.step

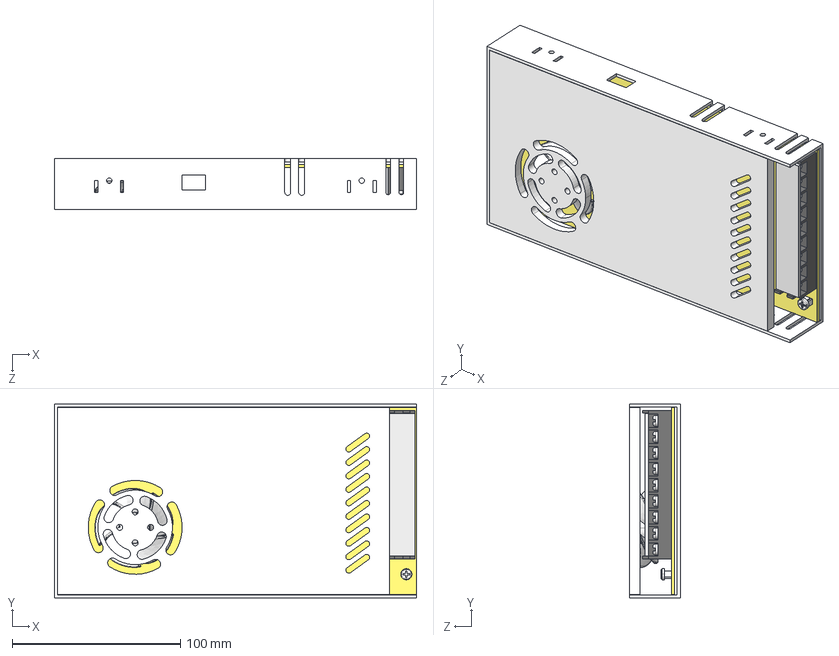
[picture p49: CAD file, 2026-09-13]
engineering/sources/LE-350-60.step
215.0 x 115.0 x 30.0 mm
外壳
fan
接线端子
