sbelakho2/Cutting/engineering/generated/feed/step/FMB2.step

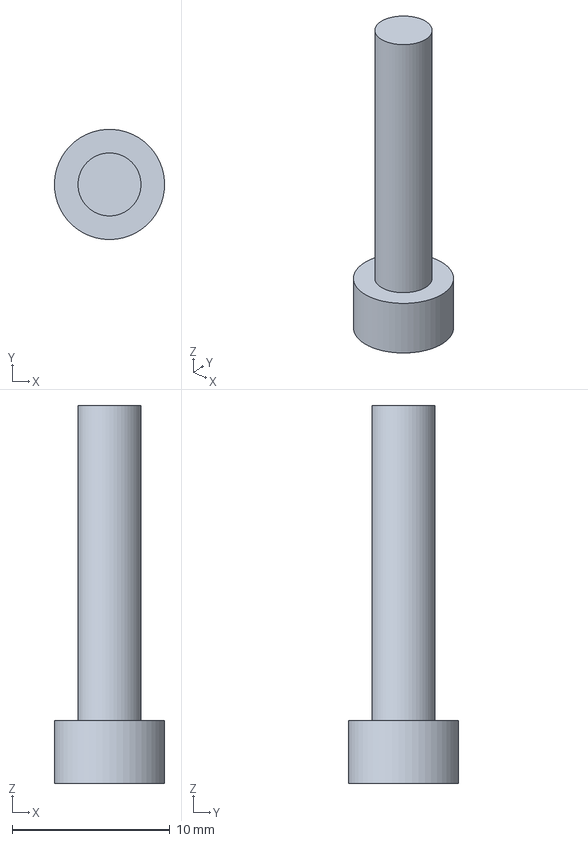
[picture p50: CAD file, 2026-09-13]
engineering/generated/feed/step/FMB2.step
7.00 x 6.99 x 24.0 mm
