sbelakho2/Cutting/engineering/generated/measurement/step/ME-W01.step

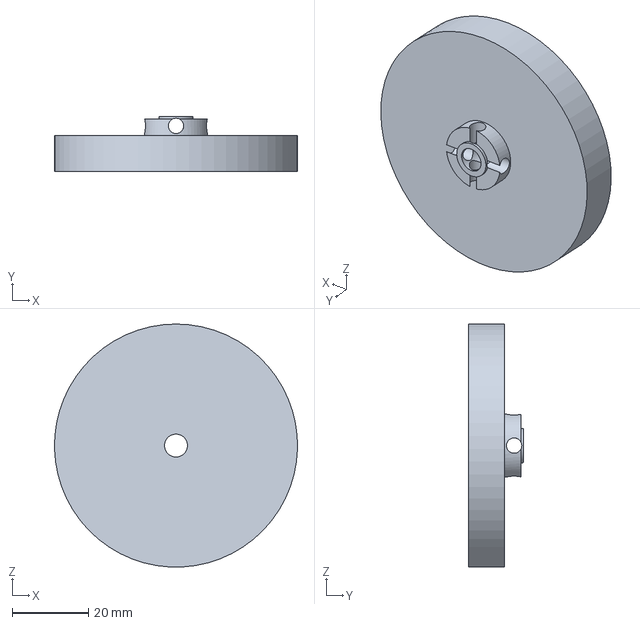
[picture p51: CAD file, 2026-09-16]
engineering/generated/measurement/step/ME-W01.step
63.6 x 14.5 x 63.6 mm
