sbelakho2/Cutting/engineering/generated/head/step/CP01_R.step

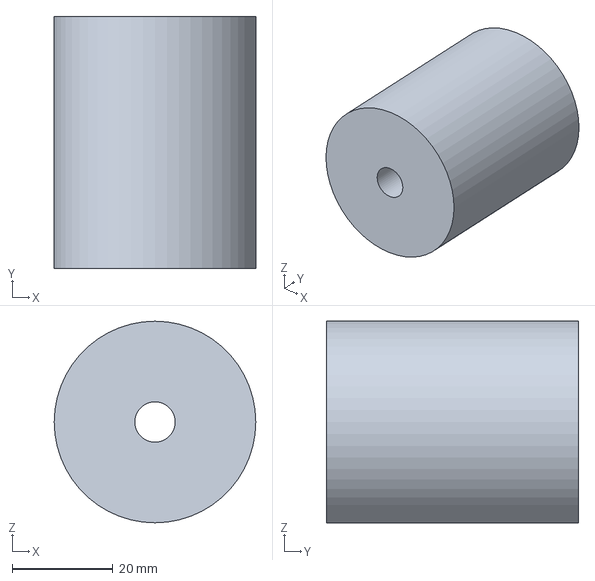
[picture p52: CAD file, 2026-10-13]
engineering/generated/head/step/CP01_R.step
40.0 x 50.0 x 40.0 mm
