sbelakho2/Cutting/engineering/generated/measurement/step/ME-B01.step

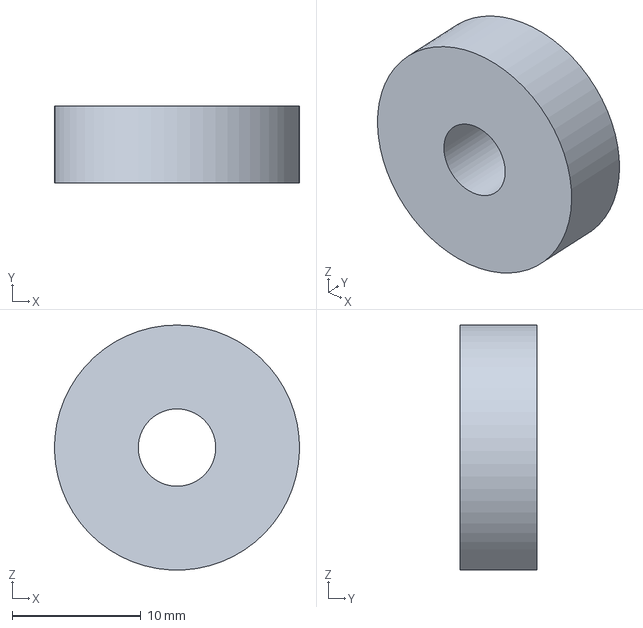
[picture p53: CAD file, 2026-09-16]
engineering/generated/measurement/step/ME-B01.step
19.0 x 6.00 x 19.0 mm
