sbelakho2/Cutting/engineering/generated/feed/step/FB01.step

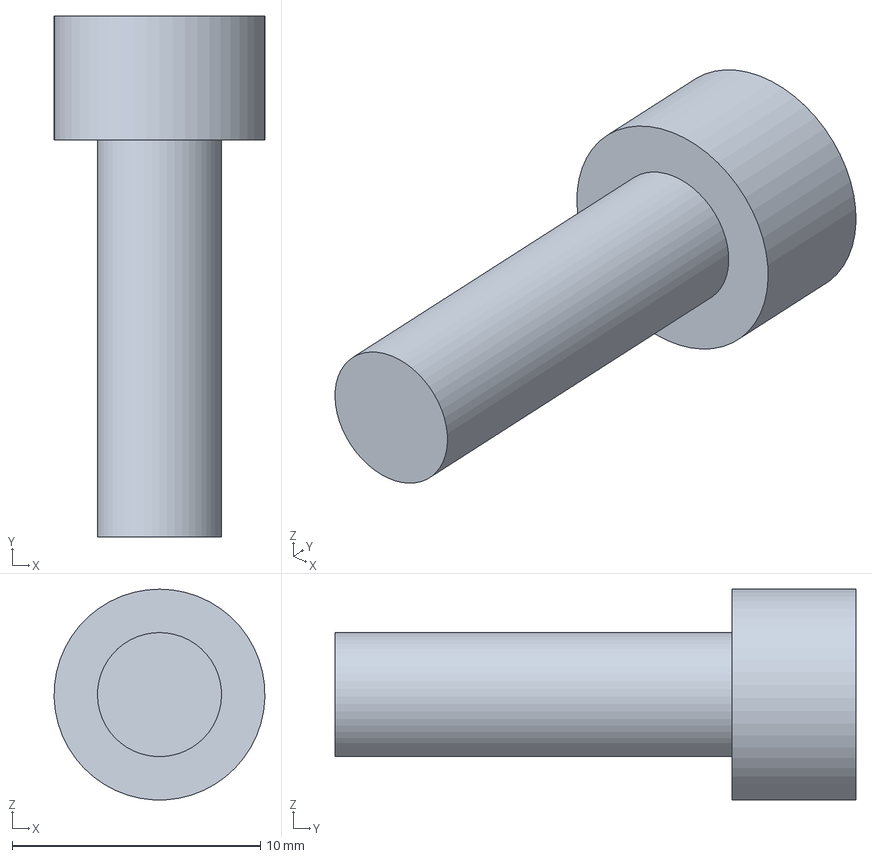
[picture p54: CAD file, 2026-09-13]
engineering/generated/feed/step/FB01.step
8.50 x 21.0 x 8.49 mm
