sbelakho2/Cutting/engineering/generated/head/step/H007_R.step

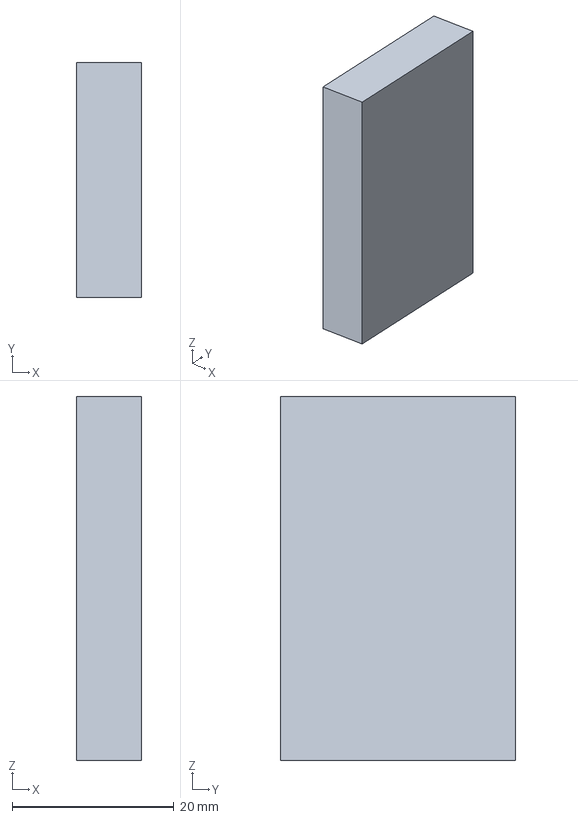
[picture p55: CAD file, 2026-10-13]
engineering/generated/head/step/H007_R.step
8.00 x 29.0 x 45.0 mm
