sbelakho2/Cutting/engineering/generated/feed/step/RW01.step

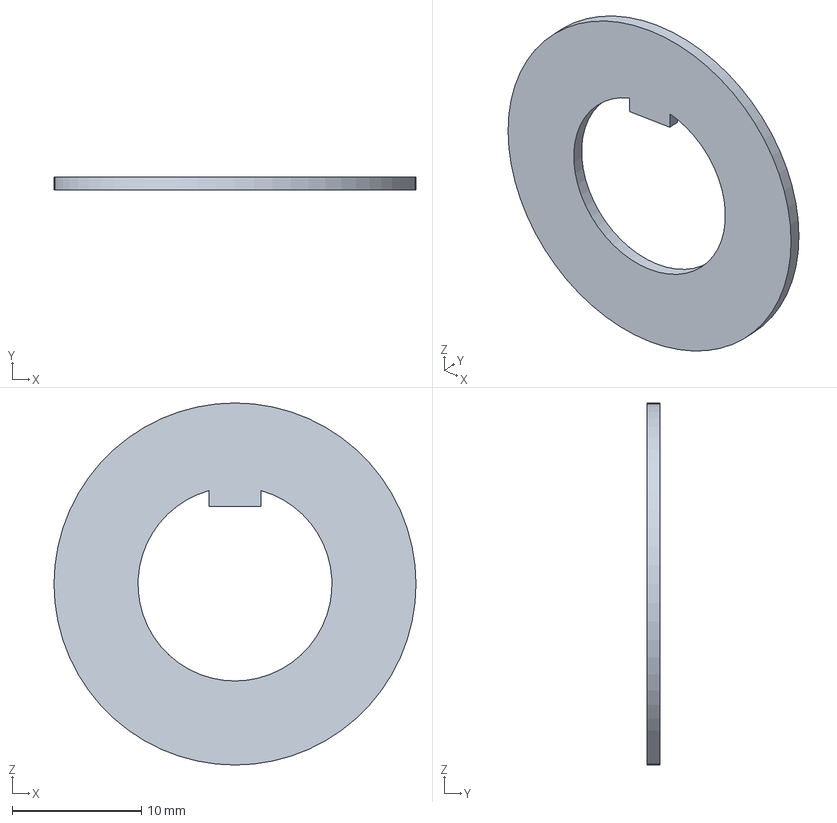
[picture p56: CAD file, 2026-09-13]
engineering/generated/feed/step/RW01.step
28.0 x 1.00 x 28.0 mm
