sbelakho2/Cutting/engineering/generated/feed-cassette/step/L2_FDP2.step

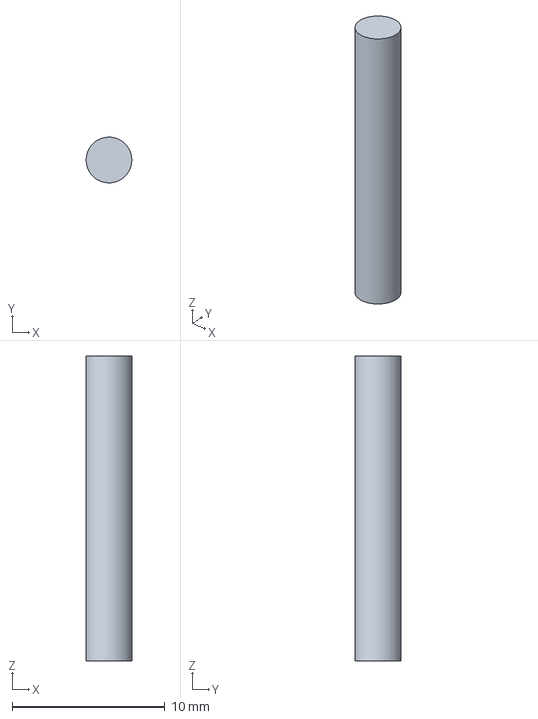
[picture p57: CAD file, 2026-09-13]
engineering/generated/feed-cassette/step/L2_FDP2.step
3.00 x 3.00 x 20.0 mm
