sbelakho2/Cutting/engineering/generated/feed/step/F102.step

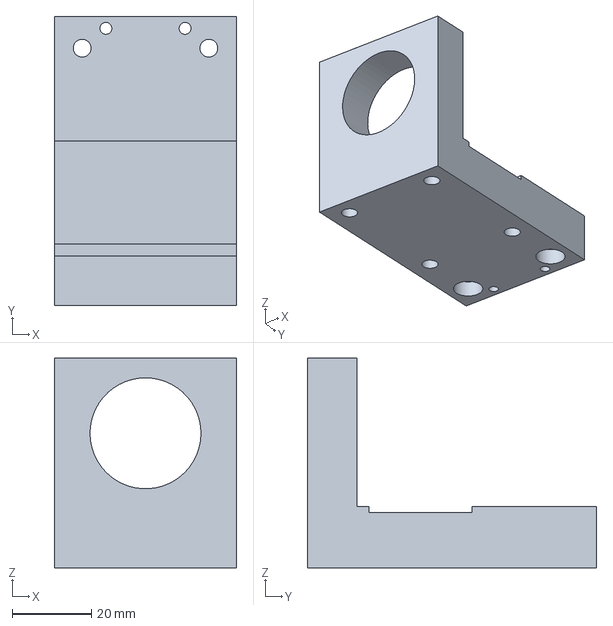
[picture p58: CAD file, 2026-09-13]
engineering/generated/feed/step/F102.step
46.0 x 73.0 x 53.0 mm
