sbelakho2/Cutting/engineering/generated/head/step/HM-B1_F.step

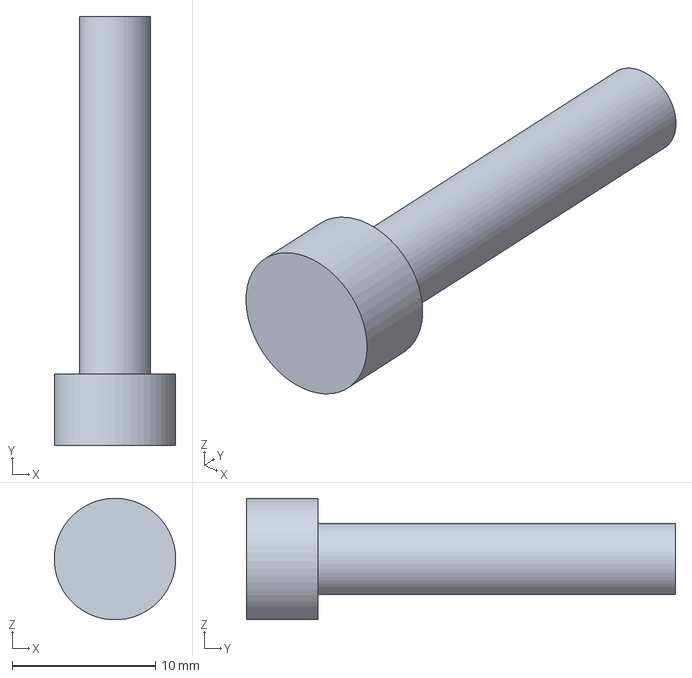
[picture p59: CAD file, 2026-10-13]
engineering/generated/head/step/HM-B1_F.step
8.50 x 30.0 x 8.49 mm
