sbelakho2/Cutting/engineering/generated/feed/step/F107.step

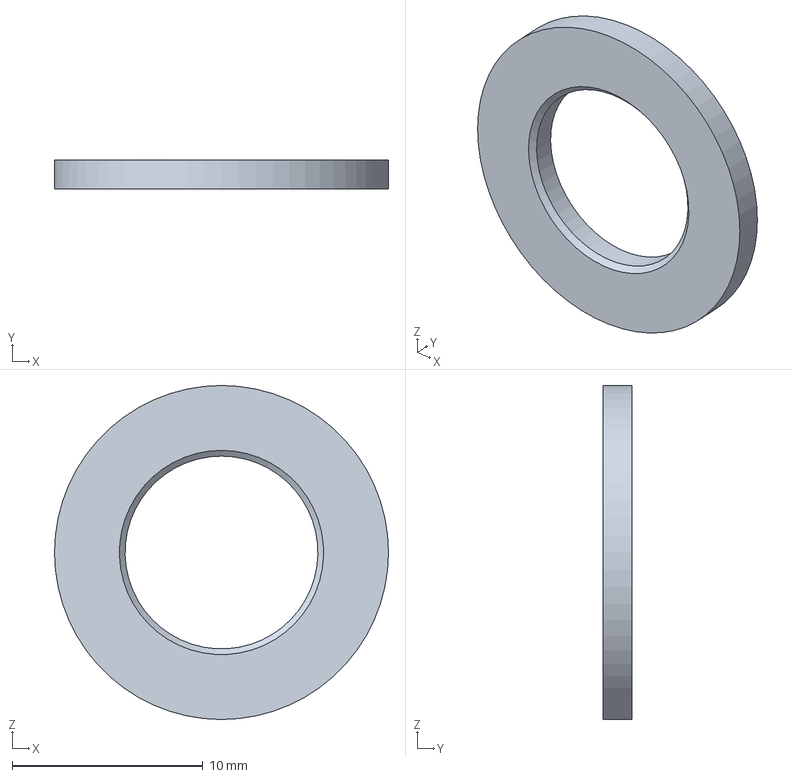
[picture p60: CAD file, 2026-09-13]
engineering/generated/feed/step/F107.step
17.5 x 1.50 x 17.5 mm
