sbelakho2/Cutting/engineering/generated/feed-cassette/step/U1_F104.step

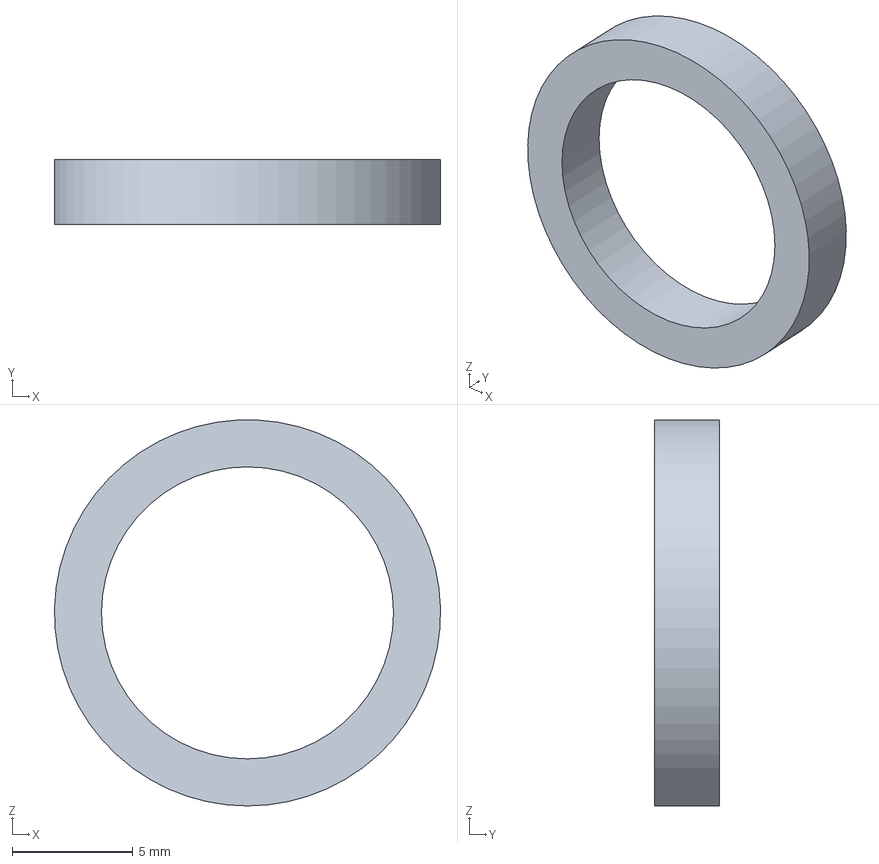
[picture p61: CAD file, 2026-09-13]
engineering/generated/feed-cassette/step/U1_F104.step
16.0 x 2.70 x 16.0 mm
