sbelakho2/Cutting/engineering/generated/feed/step/TP01.step

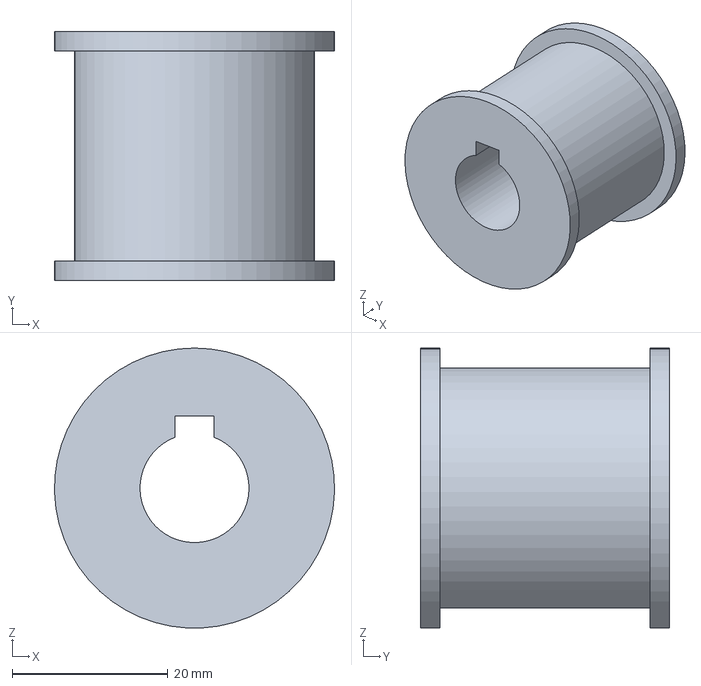
[picture p62: CAD file, 2026-09-13]
engineering/generated/feed/step/TP01.step
36.0 x 32.0 x 36.0 mm
