sbelakho2/Cutting/engineering/generated/head/step/AX01-S_R.step

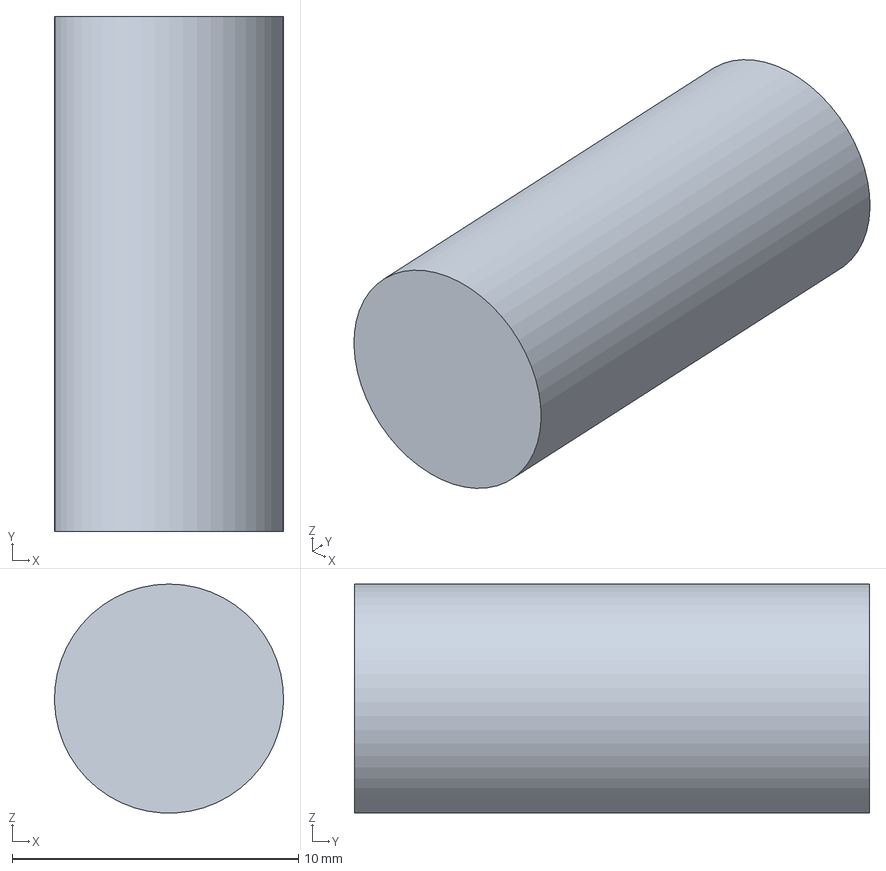
[picture p63: CAD file, 2026-10-13]
engineering/generated/head/step/AX01-S_R.step
8.00 x 18.0 x 7.99 mm
