sbelakho2/Cutting/engineering/generated/feed-cassette/step/L1_F110.step

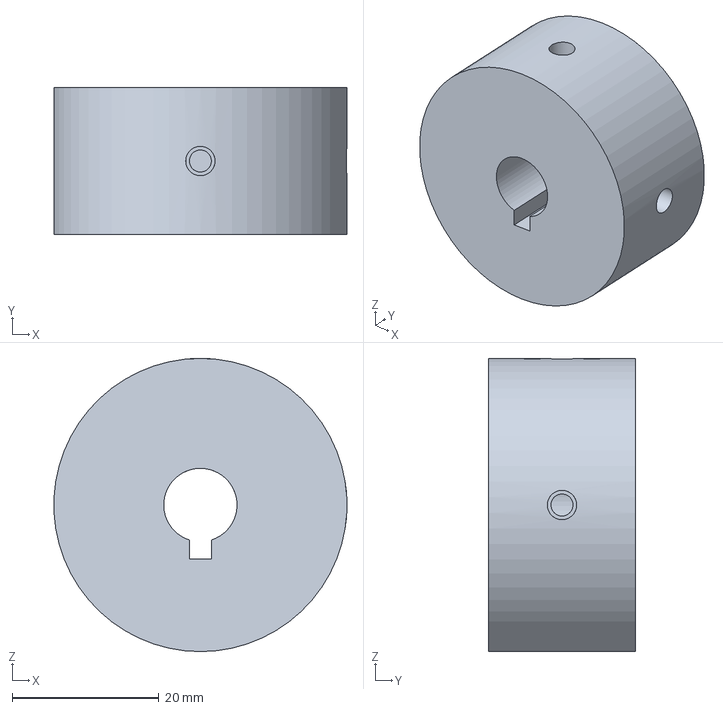
[picture p64: CAD file, 2026-09-13]
engineering/generated/feed-cassette/step/L1_F110.step
40.0 x 20.0 x 40.0 mm
