sbelakho2/Cutting/engineering/generated/feed-cassette/step/U1_F105.step

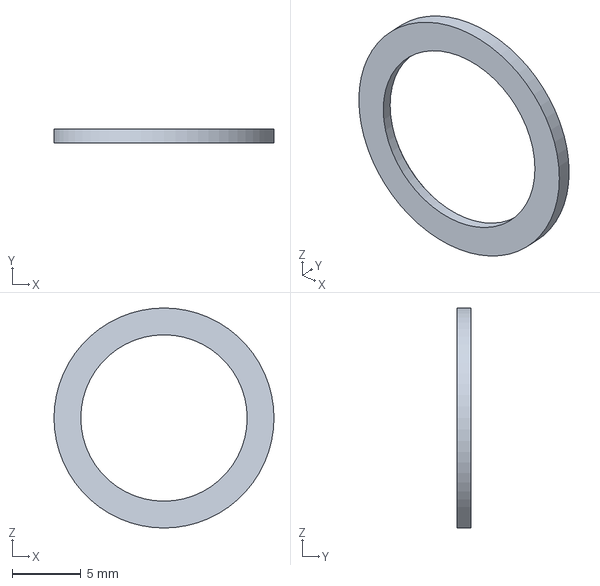
[picture p65: CAD file, 2026-09-13]
engineering/generated/feed-cassette/step/U1_F105.step
16.0 x 1.00 x 16.0 mm
