sbelakho2/Cutting/engineering/generated/feed/step/RB02.step

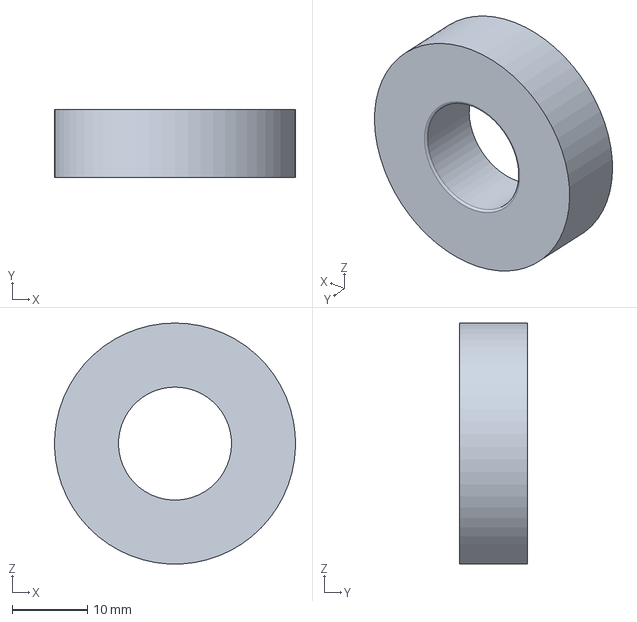
[picture p66: CAD file, 2026-09-13]
engineering/generated/feed/step/RB02.step
32.0 x 9.00 x 32.0 mm
