sbelakho2/Cutting/engineering/generated/feed/step/F112.step

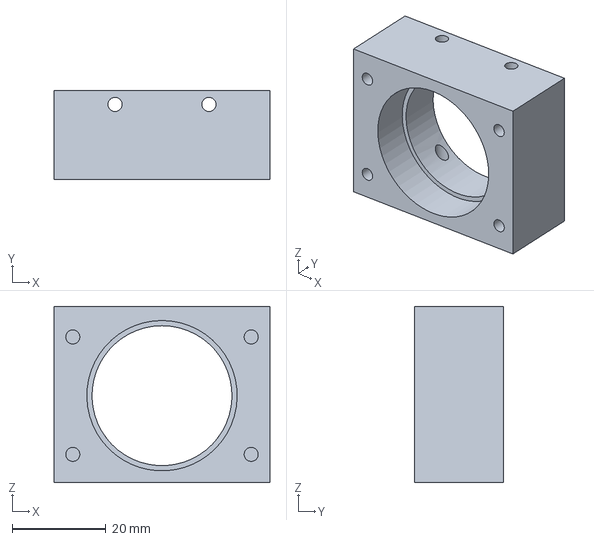
[picture p67: CAD file, 2026-09-13]
engineering/generated/feed/step/F112.step
46.0 x 19.0 x 37.5 mm
