sbelakho2/Cutting/engineering/generated/feed/step/F106.step

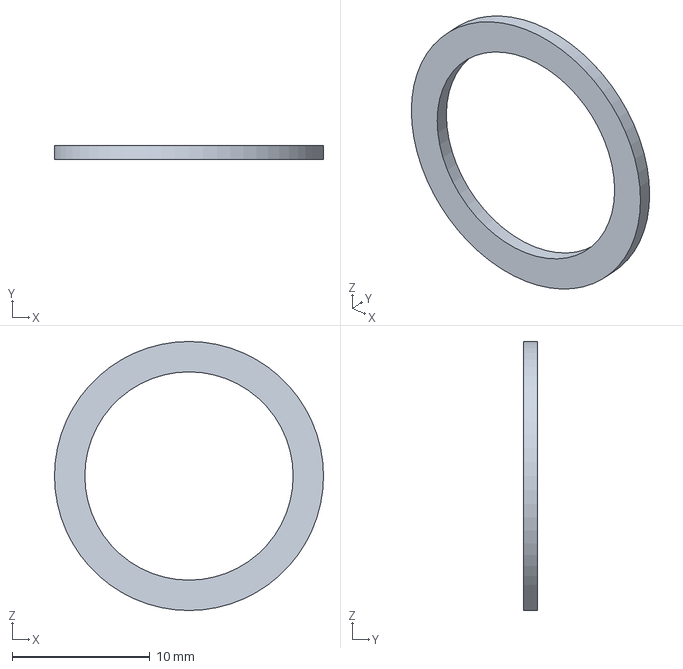
[picture p68: CAD file, 2026-09-13]
engineering/generated/feed/step/F106.step
19.5 x 1.00 x 19.5 mm
