sbelakho2/Cutting/engineering/generated/feed/step/RR01.step

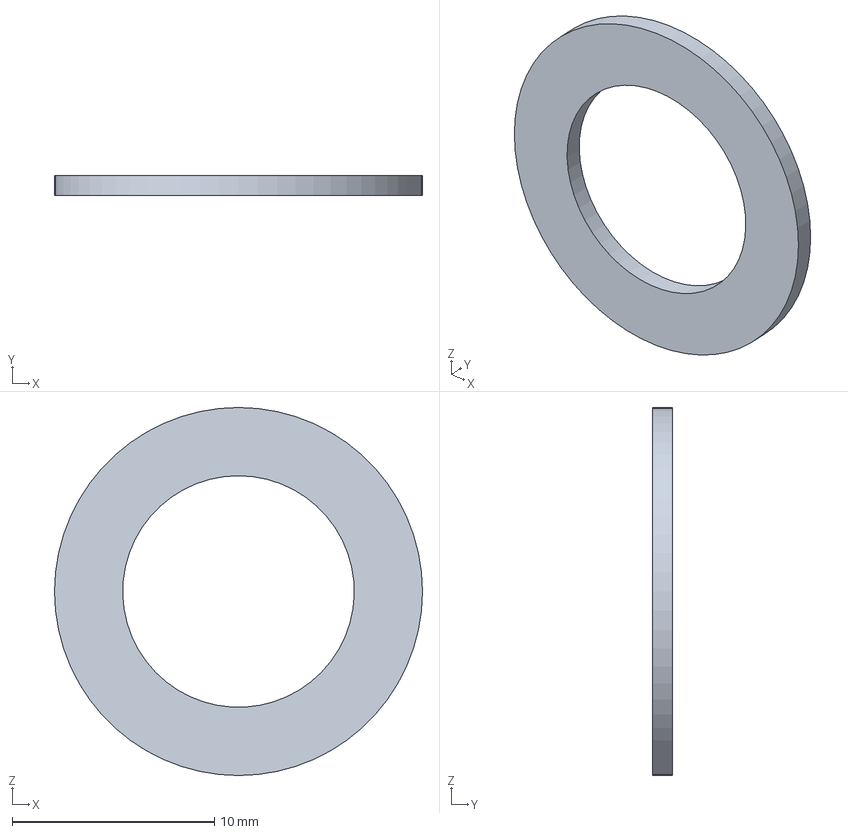
[picture p69: CAD file, 2026-09-13]
engineering/generated/feed/step/RR01.step
18.2 x 1.00 x 18.2 mm
