sbelakho2/Cutting/engineering/generated/feed/step/TK01.step

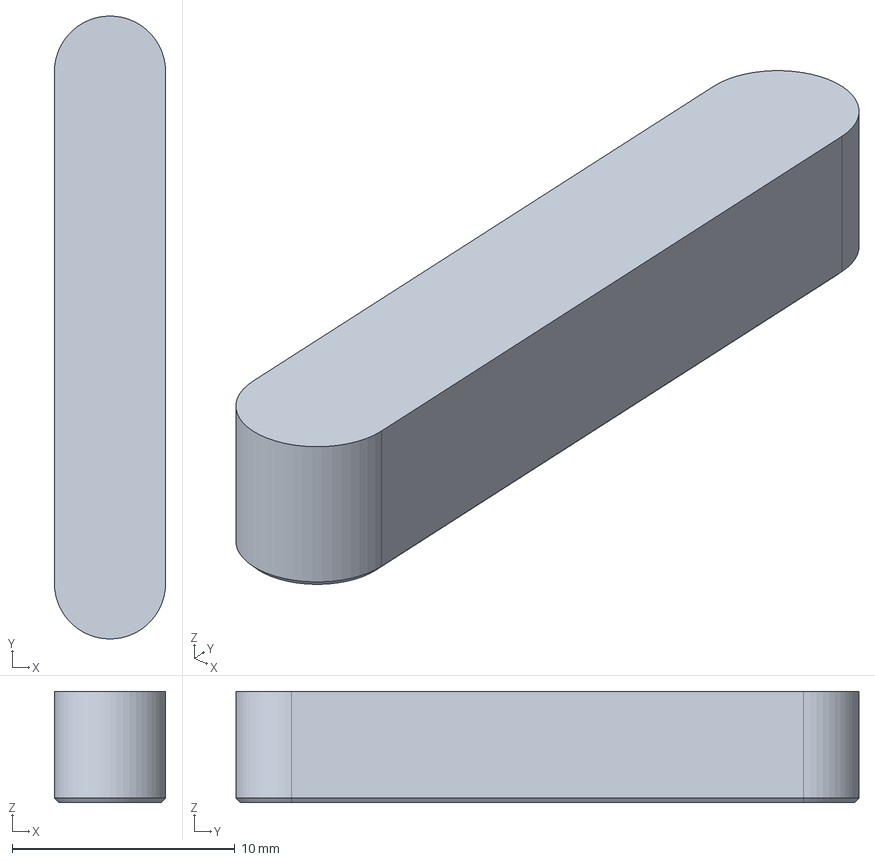
[picture p70: CAD file, 2026-09-13]
engineering/generated/feed/step/TK01.step
5.00 x 28.0 x 5.00 mm
