sbelakho2/Cutting/engineering/generated/head/step/AX01-D_F.step

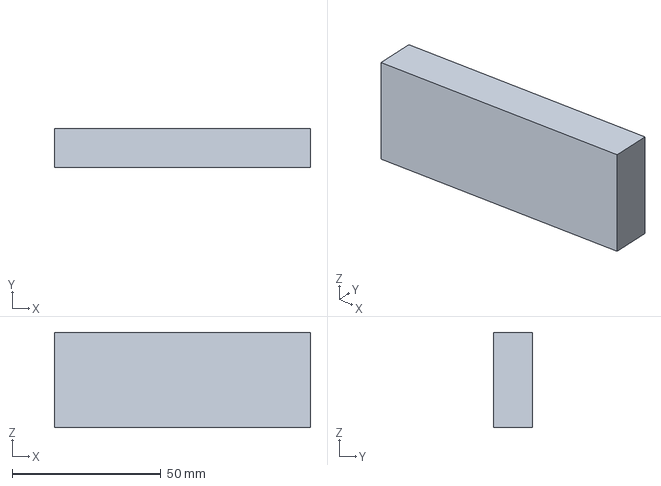
[picture p71: CAD file, 2026-10-13]
engineering/generated/head/step/AX01-D_F.step
86.0 x 13.0 x 32.0 mm
