sbelakho2/Cutting/engineering/generated/feed/step/F111.step

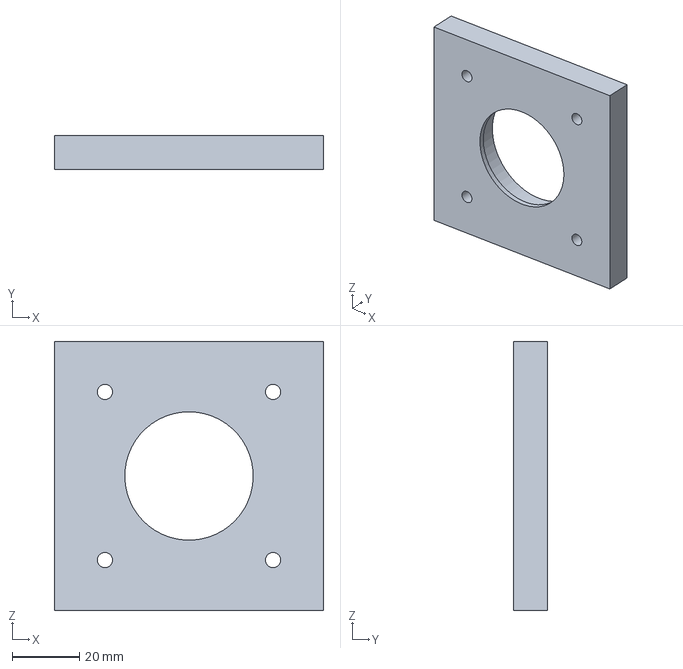
[picture p72: CAD file, 2026-09-13]
engineering/generated/feed/step/F111.step
80.0 x 10.0 x 80.0 mm
