sbelakho2/Cutting/(list of files, cad)

Other CAD files:
engineering/generated/mechanism/full-machine.step
engineering/generated/head/head-assembly.step
engineering/generated/feed-fem-boundary-detail/torus-focus-root-0.02/F101-R6-analysis.step
engineering/generated/feed-fem-boundary-detail/torus-focus-root-0.03/F101-R6-analysis.step
engineering/generated/feed-fem-boundary/A12-front-background/F101-R6-analysis.step
engineering/generated/feed-fem-boundary/A12-front-phase/F101-R6-analysis.step
engineering/generated/feed-fem-boundary/A12-front/F101-R6-analysis.step
engineering/generated/feed-fem-boundary/A12-rear-background/F101-R6-analysis.step
engineering/generated/feed-fem-boundary/A12-rear/F101-R6-analysis.step
engineering/generated/feed-fem-boundary/all-root-compatibility/F101-R6-analysis.step
engineering/generated/feed-fem-boundary/all-root-netgen/F101-R6-analysis.step
engineering/generated/feed-fem-boundary/baseline-A12-front/F101-R6-analysis.step
engineering/generated/feed-fem-boundary/centroid-audit-baseline/F101-R6-analysis.step
engineering/generated/feed-fem-boundary/centroid-audit-netgen/F101-R6-analysis.step
engineering/generated/feed-fem-cad-features/A12-front/F101-R6-analysis.step
engineering/generated/feed-fem-cad-features/A12-rear/F101-R6-analysis.step
engineering/generated/feed-fem-cad-features/all-root-compatibility/F101-R6-analysis.step
engineering/generated/feed-fem-cad-features/M15-background/F101-R6-analysis.step
engineering/generated/feed-fem-cad-features/M15-phase/F101-R6-analysis.step
engineering/generated/feed-fem-cad-features/M15-slot/F101-R6-analysis.step
engineering/generated/feed-fem-cad-features/pulley-background-intermediate/F101-R6-analysis.step
engineering/generated/feed-fem-cad-features/pulley-blends/F101-R6-analysis.step
engineering/generated/feed-fem-cad-features/pulley-floor/F101-R6-analysis.step
engineering/generated/feed-fem-diagnostic/F101-R6-analysis.step
engineering/generated/feed-fem-focused/A12-groove/F101-R6-analysis.step
engineering/generated/feed-fem-focused/A12-phase-audit/F101-R6-analysis.step
engineering/generated/feed-fem-focused/all-root-compatibility/F101-R6-analysis.step
engineering/generated/feed-fem-focused/M15-relief/F101-R6-analysis.step
engineering/generated/feed-fem-focused/neck-background-audit/F101-R6-analysis.step
engineering/generated/feed-fem-focused/neck-shoulder/F101-R6-analysis.step
engineering/generated/feed-fem-focused/pulley-key/F101-R6-analysis.step
engineering/generated/feed-fem-focused/roller-key-background-audit/F101-R6-analysis.step
engineering/generated/feed-fem-focused/roller-key/F101-R6-analysis.step
engineering/generated/feed-fem-focused/roller-shoulder-background-audit/F101-R6-analysis.step
engineering/generated/feed-fem-focused/roller-shoulder/F101-R6-analysis.step
engineering/generated/feed-fem-phase-audit/F101-R6-analysis.step
engineering/generated/feed-fem-torus/gmsh/F101-R6-analysis.step
engineering/generated/feed-fem-torus/netgen/F101-R6-analysis.step
engineering/generated/feed-fem/F101-R6-analysis.step
engineering/generated/feed-submodel/netgen/m15_relief/submodel.step
engineering/generated/feed-submodel/netgen/roller_key_root/submodel.step
engineering/generated/feed-submodel/netgen/roller_shoulder/submodel.step
engineering/generated/head/adapter-local.step
engineering/generated/layout/head-and-feed-layout.step
engineering/generated/head/datum-local.step
engineering/generated/feed-cassette/step/L2_FCB1.step
engineering/generated/head/step/H004_F.step
engineering/generated/feed-cassette/step/L1_FMB2.step
engineering/generated/feed/step/F101.step
engineering/generated/feed-cassette/step/U1_FCB1.step
engineering/generated/feed-cassette/step/L1_FCB4.step
engineering/generated/feed/step/FCB2.step
engineering/generated/head/step/HM-W1_R.step
engineering/generated/feed-cassette/step/U1_FMB2.step
engineering/generated/head/step/HM-W2_F.step
engineering/generated/feed-cassette/step/U2_FMW2.step
engineering/generated/head/step/HF0-B2_R.step
engineering/generated/feed-cassette/step/L1_FB01.step
engineering/generated/feed/step/FCB3.step
engineering/generated/head/step/HM-B1_R.step
engineering/generated/feed-cassette/step/L1_F108.step
engineering/generated/feed/step/F103.step
engineering/generated/head/step/HF0-W4_R.step
engineering/generated/feed/step/FMW2.step
engineering/generated/head/step/HF0-B2_F.step
engineering/generated/feed-cassette/step/U2_F103.step
engineering/generated/feed/step/FDP1.step
engineering/generated/head/step/HF0-W3_F.step
engineering/generated/feed/step/F105.step
engineering/generated/head/step/T001_F.step
engineering/generated/feed-cassette/step/L2_FB01.step
engineering/generated/head/step/HM-W3_R.step
engineering/generated/feed-cassette/step/L2_FMB2.step
engineering/generated/head/step/HM-B2_F.step
engineering/generated/feed-cassette/step/L1_FDP1.step
engineering/generated/feed/step/CP02.step
engineering/generated/head/step/H003_R.step
engineering/generated/feed-cassette/step/L1_RW01.step
engineering/generated/head/step/HM-B3_F.step
engineering/generated/feed-cassette/step/U2_FCB1.step
engineering/generated/head/step/HM-B3_R.step
engineering/generated/feed-cassette/step/L2_F101.step
engineering/generated/head/step/HM-W2_R.step
engineering/generated/feed-cassette/step/L1_RB01.step
engineering/generated/feed/step/FDP2.step
engineering/generated/feed-cassette/step/U2_FMW1.step
engineering/generated/feed/step/FMB1.step
engineering/generated/head/step/HF0-W1_F.step
engineering/generated/feed-cassette/step/L1_F101.step
engineering/generated/feed/step/FMW1.step
engineering/generated/head/step/H007_F.step
engineering/generated/feed-cassette/step/L1_F112.step
engineering/generated/head/step/HM-B4_R.step
engineering/generated/feed-cassette/step/U2_F106.step
engineering/generated/feed/step/RB01.step
engineering/generated/head/step/H004_R.step
engineering/generated/feed-cassette/step/L2_F105.step
engineering/generated/feed-cassette/step/L1_F102.step
engineering/generated/feed-cassette/step/L1_F103.step
engineering/generated/feed-cassette/step/L1_F104.step
engineering/generated/feed-cassette/step/L1_F105.step
engineering/generated/feed-cassette/step/L1_F106.step
engineering/generated/feed-cassette/step/L1_F107.step
engineering/generated/feed-cassette/step/L1_F109.step
engineering/generated/feed-cassette/step/L1_FCB1.step
engineering/generated/feed-cassette/step/L1_FCB2.step
engineering/generated/feed-cassette/step/L1_FCB3.step
engineering/generated/feed-cassette/step/L1_FDP2.step
engineering/generated/feed-cassette/step/L1_FMB1.step
engineering/generated/feed-cassette/step/L1_FMW1.step
engineering/generated/feed-cassette/step/L1_FMW2.step
engineering/generated/feed-cassette/step/L1_RB02.step
engineering/generated/feed-cassette/step/L1_RN01.step
engineering/generated/feed-cassette/step/L1_RR01.step
engineering/generated/feed-cassette/step/L1_TK01.step
engineering/generated/feed-cassette/step/L1_TP01.step
engineering/generated/feed-cassette/step/L2_CP02.step
engineering/generated/feed-cassette/step/L2_F102.step
engineering/generated/feed-cassette/step/L2_F103.step
engineering/generated/feed-cassette/step/L2_F104.step
engineering/generated/feed-cassette/step/L2_F106.step
engineering/generated/feed-cassette/step/L2_F107.step
engineering/generated/feed-cassette/step/L2_F108.step
engineering/generated/feed-cassette/step/L2_F109.step
engineering/generated/feed-cassette/step/L2_F110.step
engineering/generated/feed-cassette/step/L2_F111.step
engineering/generated/feed-cassette/step/L2_F112.step
engineering/generated/feed-cassette/step/L2_FCB2.step
engineering/generated/feed-cassette/step/L2_FCB3.step
engineering/generated/feed-cassette/step/L2_FCB4.step
engineering/generated/feed-cassette/step/L2_FDP1.step
engineering/generated/feed-cassette/step/L2_FM01.step
engineering/generated/feed-cassette/step/L2_FMB1.step
engineering/generated/feed-cassette/step/L2_FMW1.step
engineering/generated/feed-cassette/step/L2_FMW2.step
engineering/generated/feed-cassette/step/L2_RB01.step
engineering/generated/feed-cassette/step/L2_RB02.step
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
