sbelakho2/Cutting/docs/22-controls-and-wiring.md

# Controls and cabinet electrical design input — S1-B

**Revision:** `S1-B-CTRL-CAB-R2-2026-09-13`  
**Status:** **fabrication-ready design input for the internal cabinet build.**
Energisation, commissioning and any personnel-safety use remain gated by
section 10 and the measured evidence listed there.

This document records the intended hardwired control and safety topology for
one S1-B machine. It is a controlled design input for schematic capture,
review, cabinet construction planning, and subsequent physical qualification.
It is not an approved electrical drawing, a risk assessment, a verification
record, or a safety certificate. No assembled IF-B01 board, cabinet, motor
power interruption, guard-lock release circuit, stop-time measurement, EMC
assessment, PE-continuity test, insulation test, or safety-function validation
exists at this revision.

The safety relay component capability must not be relabelled as an achieved
machine performance level or SIL. Work on mains, PELV distribution, safety
circuits, and guarded machinery requires review and execution by competent
persons under the applicable local regulations.

## 1. Governing records and boundary

| Record | Purpose | Status at this revision |
|---|---|---|
| [controls specification](../shared/controls_spec.hpp) | Target GPIO polarity, timing and selected interface intent | Source authority for controller-facing signals |
| [IF-B01 native schematic](../hardware/if-b01/if-b01.kicad_sch) | Editable KiCad logical capture | Draft source with clean ERC/native-netlist parity; not a reviewed or released design |
| [IF-B01 netlist](../hardware/if-b01/if-b01-netlist.csv) | Controlled connector-to-net design input | Reconciled to the native export; not a fabrication netlist |
| [IF-B01 GPIO allocation](../hardware/if-b01/if-b01-gpio-allocation.csv) | Machine-readable connector/net/controller allocation | Reconciled by source check; not a physical wiring or safety validation |
| [IF-B01 component list](../hardware/if-b01/if-b01-bom.csv) | Controlled board-component design input | Reconciled to the native KiCad BOM; not a fabrication BOM |
| [IF-B01 PCB DRC](../hardware/if-b01/review/if-b01-pcb-drc.rpt) | KiCad physical and schematic-parity check of the placed/routed four-layer draft board | Zero physical violations, zero unconnected pads and zero schematic-parity issues; not a human layout/fabrication approval |
| [IF-B01 draft outputs](../hardware/if-b01/manufacturing/draft-r2-2026-09-13) | Verification-gated Gerber, drill, placement, visual assembly, board-only STEP, IPC-D-356, BOM and SHA-256 package | Explicitly draft only; not an order, build or release authorisation |
| [IF-B01 cabinet integration](../hardware/if-b01/if-b01-cabinet-integration.md) | Exact board-terminal / relay-contact cabinet schedule | Draft connection source; not a released wiring drawing |
| [cabinet wiring BOM](../bom/selected-cabinet-wiring.csv) | Selected-device cross-references and explicit terminal/protection holds | Not a procurement authorisation |
| [cabinet assembly plan](23-cabinet-electrical-assembly.md) | De-energised installation sequence and mandatory physical records | Not a released assembly or energisation procedure |
| [controls selection BOM](../bom/selected-controls.csv) | Procurement identities and release holds | Current controls selection record |
| [manufacturer evidence](../engineering/sources/catalogue-evidence.md) | Catalogue facts and source links | Evidence archive, not a machine validation record |
| [physical qualification procedure](20-physical-qualification.md) | Required records after assembly | Blank; no qualification has been performed |
| [master production/release plan](24-production-and-release-plan.md) | Ordered work packages, incoming/FAI templates and source evidence gates | Source-controlled plan; not a release authority |
| [preliminary guard/payoff CAD](25-preliminary-guard-and-payoff.md) | Static guard-lock/spool accommodation and external wire-route geometry | Not a guard design, release or safety-function validation |

IF-B01 is a PELV/SELV interface between the Pico 2 and low-voltage external
signals. It carries neither mains nor a safety function. It must not be used
as the means of emergency power removal. The hardwired XPS safety relay and
three DC contactors are the proposed power-removal path; that path remains
unreleased until the open items in section 10 are closed.

```mermaid
flowchart LR
  AC[Site AC supply\nunreleased protection and PE design] --> PS24[24 V control PSU]
  AC --> P60F[60 V blade-front PSU]
  AC --> P60R[60 V blade-rear PSU]
  AC --> P36[36 V feed PSU]
  ESTOP[Two-channel E-stop] --> XPS[XPSUAF13AP safety relay]
  GUARD[Guard interlock + guard-lock contacts] --> XPS
  XPS --> K1[K1: front 60 V contactor coil]
  XPS --> K2[K2: rear 60 V contactor coil]
  XPS --> K3[K3: feed 36 V contactor coil]
  K1 --> P60F
  K2 --> P60R
  K3 --> P36
  PS24 --> FIELD[Panel controls, relay couplers, drive logic]
  FIELD --> IFB[IF-B01 + Pico 2]
  IFB --> DRIVE[Drive PUL-/DIR-/ENA- and indicators]
  XPS -. non-safety diagnostic via KA4 .-> IFB
```

The diagram identifies functional relationships only. It is not a physical
routing drawing and does not approve the AC supply, wire sizes, terminal
products, protective devices, supply fusing, DC bus discharge, regenerated
energy path, enclosure, or thermal design.

## 2. Power domains and intended power removal

| Domain | Selected source | Intended load | Required state / release hold |
|---|---|---|---|
| `+24V_PELV` | Siemens `6EP3332-6SB00-0AY0`, 24 VDC / 2.5 A | XPS relay, panel controls, relay couplers, drive-input anodes, indicators and IF-B01 low-voltage interface | Distribution, load calculation, branch protection and wiring are not released |
| `+5V_LOGIC` | Siemens `6EP3310-6SB00-0AY0`, 5 VDC / 3 A | Pico `VSYS` and encoder branches through IF-B01 | Distribution and short-circuit coordination are not released. Identity verified 2026-10-13 on the maker product record ([6EP3310-6SB00-0AY0](https://mall.industry.siemens.com/mall/en/WW/Catalog/Product/6EP3310-6SB00-0AY0)): 5 V DC, ±3 % overall tolerance, adjustable 4.6–5.4 V, 3 A, 4.7 W typical loss at rated output; the earlier "second 24 V PSU" wording is superseded — IF-B01 contains no 24→5 V converter |
| `+60V_BF` | one `LE-350-60` | blade-front CL86T driver power | K1 is the proposed isolation contactor; DC interrupting duty is unproven |
| `+60V_BR` | second, isolated `LE-350-60` | blade-rear CL86T driver power | K2 is the proposed isolation contactor; DC interrupting duty is unproven |
| `+36V_FEED` | one `LE-350-36` | both CL57T feed-driver branches | K3 is the proposed isolation contactor; DC interrupting duty is unproven |
| PE / AC | site installation | chassis, supplies, cooler and mains-fed equipment | No complete design or acceptance record exists |

The two 60 V supplies must remain electrically separate; they are not to be
paralleled. The 36 V feed supply remains separate from both 60 V supplies.

The proposed K1/K2/K3 contacts are Schneider Electric `LC1D12BD`, each with a
24 VDC coil, three main normally-open poles (`1/L1-2/T1`, `3/L2-4/T2`,
`5/L3-6/T3`), a NO auxiliary (`13-14`) and a mirror-certified NC auxiliary
(`21-22`). The design concept uses all three main poles in series in the
positive branch of that contactor's DC supply. This is **not** a released
36 VDC or 60 VDC interruption design: available product material establishes a
power-circuit voltage limit but does not establish the required DC utilisation
category/current/duty for this exact series-pole application. Do not energise
this arrangement until an applicable manufacturer rating, branch protection
coordination, switching test and DC-bus measurement have been reviewed.

The proposed assignments are:

| Contactor | Supply isolated by proposed main-pole series chain | Safety-output coil command |
|---|---|---|
| K1 | blade-front `LE-350-60` positive branch | XPS `13-14` |
| K2 | blade-rear `LE-350-60` positive branch | XPS `23-24` |
| K3 | feed `LE-350-36` positive branch | XPS `33-34` |

The selected XPS documentation specifies a 10 A gG external fuse for its
safety output circuit; that rating cannot protect the 5 A DC-1 outputs, so a
2 A link is selected provisionally (§11.3, subject to the explicit
curve/breaking-capacity comparison recorded there): an ESKA 522620 2 A T 5×20
link in a Phoenix 3046032 fused terminal (selected 2026-09-16, CB-XPS-FUSE).
DC branch coordination, prospective-fault assessment and installation are
still release holds. `C10G` is not selected for this machine; it is an
Eaton Bussmann series, not a Mersen or Schneider designation.

## 3. Safety relay configuration and two-channel inputs

### 3.1 Selected XPS configuration

The selected device is Schneider Harmony `XPSUAF13AP`, supplied at `A1/A2`
from 24 VAC/DC with `B2` as the 0 V reference for 24 V control signals. The
proposed selector settings are:

| XPS setting | Proposed value | Reason |
|---|---:|---|
| Application-function selector | `1` | Monitors two safety input channels for E-stop / electrical guard use with input dynamisation and interlock monitoring |
| Start-function selector | `3` | Monitored falling-edge start with dynamisation; a start pulse must be held for at least 80 ms and is accepted on release after the device's stated power-on delay |

The following terminal roles are used exactly as named by the XPS documentation:
`S11` / `S21` are the two safety-input test/control outputs; `S12` / `S22`
are the two safety-input channels; `Y1` / `Y2` form the start/feedback path;
and `13-14`, `23-24`, `33-34` are the three normally-open safety outputs.
`Z1` is a **non-safety diagnostic output** and must never be used as a safety
signal, a safety-input substitute, or an actuator-power source.

### 3.2 Proposed dual-channel safety loop

The E-stop is Siemens `3SU1851-0NB00-2AC2` with two independent NC contacts.
The guard device is Bernstein `SLC-F-024-20/20-R4`, article `6018200007`,
with the compatible `ACF-1` actuator, article `3911742391`. Its contact state
is material to the topology:

- `11-12` and `21-22` are NC guard-interlock contacts closed while the actuator
  is inserted, whether the guard is locked or unlocked.
- `31-32` and `41-42` are NC guard-lock contacts closed only while the actuator
  is inserted **and** the guard is locked.
- The locking magnet is a 24 VAC/DC `E1/E2` load; spring force retains the
  locked state on loss of its supply.

The draft channel paths are therefore:

| Channel | Series path | Expected healthy condition |
|---|---|---|
| CH1 | `S11 → E-STOP CH1 NC → SLC 11-12 → SLC 31-32 → S12` | E-stop released, actuator inserted and guard locked |
| CH2 | `S21 → E-STOP CH2 NC → SLC 21-22 → SLC 41-42 → S22` | E-stop released, actuator inserted and guard locked |

Opening either E-stop channel, either guard-interlock contact, either
locked-state contact, or the associated wire must remove the safety-relay
output according to the device's evaluated safety function. The XPS catalogue
response specification (maximum 20 ms on safety-input deactivation) is a
component property; it is **not** a verified K1/K2/K3 opening time or machine
stopping time.

### 3.3 Start/reset and external-device monitoring path

`PB03` is the blue RESET/ACK pushbutton. Its one NO contact must not be reused
as one contact path for two unrelated functions. The proposed design uses two
distinct downstream relay coils in parallel, each with its own function:

| Device | Coil command from PB03 | Contact function | Prohibited use |
|---|---|---|---|
| KA3 | `+24V_PELV → PB03 NO → KA3 coil → 0V_PELV` | KA3 NO contact reports the local reset pushbutton to IF-B01 `GP14` | Do not route XPS `Y1/Y2` through KA3 |
| KSR1 | `+24V_PELV → PB03 NO → KSR1 coil → 0V_PELV` | KSR1 NO forms the independent XPS start pulse | Do not use KSR1 as the GPIO monitor |

The proposed XPS feedback/start chain is:

`Y1 → KSR1 NO → K1 21-22 NC → K2 21-22 NC → K3 21-22 NC → Y2`

The three contactor NC auxiliaries form the external-device monitoring chain.
KSR1 must drop when PB03 is released so the XPS sees the required monitored
falling edge. KSR1 is a separately required 24 V interposing relay; the current
procurement intent is a further Phoenix Contact `PLC-RSC-24DC/21` relay coupler
only if its coil load, contact function, installation and safety-function
suitability are accepted during detailed design. This is not an approval of
that relay as a safety-rated component.

### 3.4 Non-safety diagnostic to the controller

KA4 is separate from KSR1 and KA3. Its proposed coil is placed in parallel
with the K1-coil command downstream of XPS `13-14`; KA4's isolated NO contact
then closes IF-B01 `J10-7` to `J10-8` / `0V_PELV`. The controller reads the
result at active-low `GP15` (`IN_SAFETY_OK`). KA4 means only that this one XPS
output branch is energised; it does **not** prove that every contactor opened
or closed, that DC buses are at a safe voltage, or that the guard may unlock.
KA4, IF-B01, `GP15`, firmware and USB are diagnostic only and are not part of
the safety function.

The coil current of KA4 and KSR1, XPS output loading, contactor-coil inrush,
24 V PSU loading and protective-device coordination must be calculated and
measured before release. The `LC1D12BD` coil data identifies a 24 VDC coil with
5.4 W maximum coil consumption; even the simple upper-bound arithmetic
$3 \times 5.4\ \mathrm{W} / 24\ \mathrm{V} = 0.675\ \mathrm{A}$ does not close
that calculation because it excludes KA4, KSR1, the XPS, field relays,
indicators, board loads and transient conditions.

## 4. Guard unlocking release-permission (design specified 2026-10-13)

The E1/E2 guard-lock release is a hardwired, firmware-free permission chain
specified in [§11.8](#118-e1e2-guard-release-permission-chain-redesigned-2026-10-13).
It is a **new desk design**, not a qualified safety function: the circuit
elements, identities and terminal-level wiring now exist in this document and
in the [IF-B01 cabinet-integration note](../hardware/if-b01/if-b01-cabinet-integration.md),
while the measured bus decay, timer setting, contact proof tests, fault
injection and the risk-assessment acceptance remain physical holds (§10 item 5).
Until those close, access after a trip remains a controlled lockout/tagout
procedure, not an automatic unlock feature.

## 11.8 E1/E2 guard-release-permission chain (redesigned 2026-10-13)

### 11.8.1 Why the 2026-09-16 draft was not executable

The earlier desk draft placed the K1–K3 `21-22` NC auxiliaries **both** in the
XPS `Y1`/`Y2` monitored-start (EDM) chain **and** in the R2 release-coil chain.
One contact cannot carry two independent circuits, and the TeSys Deca catalogue
states that the mirror contact to IEC 60947-4-1 is the single NC **incorporated
in the contactor** (B8/94). The draft was therefore not a separated wiring
design. The corrected design uses **distinct** contacts:

- the built-in `21-22` mirror NC of each K1–K3 stays **exclusively** in the
  [§3.3](#33-startreset-and-external-device-monitoring-path) `Y1 → KSR1 NO →
  K1 21-22 → K2 21-22 → K3 21-22 → Y2` EDM/start chain;
- the release chain gets a **second, dedicated NC contact per contactor**.

### 11.8.2 Actual solution for the second contact

A 1-NC block (`LADN01`) cannot be fitted to the DC-coil `LC1D12BD`: the
catalogue table (B8/43) allows the DC-coil `LC1D09…D38` either one 2-contact or
one 4-contact front block and no 1-contact block. The fitted solution is
therefore **one Schneider `LADN02` 2-NC front auxiliary block per contactor**
(TeSys Deca accessory range, B8/44), with one NC wired into the release chain
and the second NC left unwired. The add-on NC is mechanically linked to the
contactor mechanism but is **not catalogued as a mirror contact**; the release
chain below is consequently specified as a **single-channel release
interlock**, not a certified safety function. If the risk assessment rejects
that single-channel argument, the recorded fallback is a dedicated safety relay
with its own release output fed from the three built-in mirror NC contacts —
that change requires a change record and a repeat of this section.

Exact identities (no automated live price could be observed on 2026-10-13;
automation24/Conrad fetch returned bot-protection pages):

| Element | Exact identity | Source / status |
|---|---|---|
| K1–K3 second NC | Schneider `LADN02` (2 NC, front-mounted clip-on block), 3× | TeSys Deca catalogue 2026 B8/43–B8/44; live distributor price not observed 2026-10-13 — confirm at purchase |
| Release request PB04 | Siemens SIRIUS ACT `3SU1152-0AB40-1BA0` (green illuminated momentary, 1 NO — same identity as PB01), labelled GUARD RELEASE REQUEST | identical to the already selected CT-PB01 identity (EUR 22.00 observed 2026-09-13) |
| On-delay timer T2 | Finder `80.01.0.240.0000` (DIN-rail multifunction time relay, 24–240 V AC/DC, 1 CO 16 A) configured as on-delay | identity selected; live price not observed 2026-10-13 — record distributor page at purchase |
| Release relay R2 | Phoenix Contact `PLC-RSC-24DC/21` 2966171 (one additional unit; NO contact `11-14` drives E1/E2) | same identity as CT-RC01/KA1–KA10 (USD 16.13 observed 2026-09-13) |
| Lock coil E1/E2 | Bernstein SLC `E1/E2` (existing guard device) | unchanged |

### 11.8.3 Circuit and terminal-level definition

```mermaid
flowchart LR
  P24["+24V_PELV"] --> RF["CB-R2-LINK 1 A T"] --> PB04["PB04 NO release request"]
  PB04 --> K1["K1 LADN02 NC-A"] --> K2["K2 LADN02 NC-A"] --> K3["K3 LADN02 NC-A"]
  K3 --> T2["T2 A1/A2 on-delay"]
  T2 -- "contact 15-18 after set time" --> R2["R2 coil A1/A2"]
  R2 -- "contact 11-14" --> E["E1/E2 lock coil"] --> Z["0 V PELV"]
```

| Node | Terminal-level connection |
|---|---|
| Protected release branch | `+24V_PELV → CB-R2-LINK (1 A T 5×20 link in a 3046032 fused terminal) → TB-S` |
| Release request | `TB-S → PB04 NO (13-14) → K1 LADN02 NC-A common` |
| Monitor chain | `K1 LADN02 NC-A (51-52) → K2 LADN02 NC-A (51-52) → K3 LADN02 NC-A (51-52) → T2 A1`; each LADN02 NC-B left unwired; block terminal numbers per the fitted block marking to be recorded at the wiring review |
| Timer | `T2 A2 → 0V_PELV`; T2 output `15-18` (NO) in series with `R2 A1`; `R2 A2 → 0V_PELV` |
| Lock drive | `R2 NO (11-14) → E1`; `E2 → 0V_PELV` |
| Indication (optional, non-safety) | a free R2 `12`-`11` NC leg may drive a panel lamp only; no firmware input exists on IF-B01 for it |

### 11.8.4 Release conditions

1. **Controlled request:** the operator must hold PB04; no automatic release
   with the button released. A stuck-closed PB04 degenerates to automatic
   release once conditions 2–3 hold — documented operational fault, never an
   energy hazard by itself.
2. **Contactor-open condition:** all three XPS outputs off (implied by the
   chain: any energised K1–K3 holds its LADN02 NC open) — a contactor that is
   electrically held closed blocks release.
3. **Stored-energy/standstill condition:** all three 60/60/36 V buses below the
   measured safe threshold (42 V design criterion in §11.2) and the
   **measured** decay completed; T2 is set to *measured decay + ≥1 s* (desk
   estimate ≈3 s with the proposed 2.2 kΩ 5 W bleed resistors, τ≈1.1 s). The
   time element alone is provisional: the decay curve, the bleed installation
   and the 42 V criterion are physical measurements.
4. **Fail-safe direction:** loss of 24 V, loss of a chain conductor, an open
   contact or a de-energised R2 all leave E1/E2 unpowered; the spring retains
   the lock.
5. **Restart prevention:** while the guard is open, the SLC interlock and
   locked-state contacts break both XPS channels, and the XPS needs its
   monitored falling-edge start through KSR1; the machine cannot restart with
   the guard open.

### 11.8.5 Fault cases

| Fault | Response / direction |
|---|---|
| K1–K3 main pole welded closed | built-in mirror NC stays open (EDM blocks restart); LADN02 NC stays open (release blocked) — safe direction |
| LADN02 NC welded closed (one contact) | release can complete although that pole may be welded — **residual single-channel fault**; compensated only by the proof test and the risk assessment; fallback safety-relay architecture if rejected |
| PB04 stuck closed | release once the machine is de-energised and decayed; no energy hazard, operational fault; momentary button recommended |
| T2 never times out / contact open | release blocked — safe direction |
| T2 contact welded closed | release begins as soon as the chain closes even before the set delay — **hazard if the bus is still live**; T2 proof test required, flagged in the risk assessment |
| R2 fails to energise | no release — safe direction |
| R2 contact welded closed | E1/E2 can energise whenever the chain completes; same exposure as a T2 early-release case — flagged |
| Chain conductor open / terminal loose | release blocked — safe direction; continuity test at commissioning |
| Loss of 24 V or E1/E2 cable | lock stays locked — safe direction (deliberate fail-safe) |

### 11.8.6 What remains physical

Measured K1/K2/K3 opening and bus-decay curves for the exact branches, the T2
setting record, installation proof of each LADN02 NC contact and of R2/T2
(through-continuity and weld check where possible), the fault-injection test of
the release chain, and the risk-assessment acceptance of the single-channel
release interlock. Until these are recorded, release after a trip stays behind
lockout/tagout.

## 5. Front-panel and field-interface intent

`STOP` is a normal software stop request, not a safety device and not a
substitute for the E-stop. It is intentionally separate from the XPS
safety-input channels. The controller must still latch a hardware safety-loop
loss and force the driver-enable command low, but that firmware behavior does
not replace hardwired contactor power removal.

| Function | Proposed 24 V field path | Isolated relay contact to IF-B01 | Controller polarity |
|---|---|---|---|
| START, PB01 NO | `+24V_PELV → PB01 NO → KA1 coil → 0V_PELV` | KA1 NO: `J10-1` to `J10-2` | `GP12` low while pressed |
| STOP, PB02 NC | `+24V_PELV → PB02 NC → KA2 coil → 0V_PELV` | KA2 NO: `J10-3` to `J10-4` | `GP13` low while STOP loop is healthy |
| RESET/ACK, PB03 NO | PB03 operates KA3 and KSR1 as described in section 3.3 | KA3 NO: `J10-5` to `J10-6` | `GP14` low while pressed |
| XPS diagnostic | KA4 coil downstream of `13-14`; see section 3.4 | KA4 NO: `J10-7` to `J10-8` | `GP15` low while KA4 is energised |
| Rear home | Selected PNP sensor drives KA5 coil subject to output-current review | KA5 NO: `J10-9` to `J10-10` | `GP16` low at rear open position |
| Front home | Selected PNP sensor drives KA6 coil subject to output-current review | KA6 NO: `J10-11` to `J10-12` | `GP27` low at front open position |
| BF driver alarm | Driver ALM interface drives KA7 coil subject to load review | KA7 NO: `J11-1` to `J11-2` | `GP18` low on alarm |
| BR driver alarm | Driver ALM interface drives KA8 coil subject to load review | KA8 NO: `J11-3` to `J11-4` | `GP19` low on alarm |
| FL driver alarm | Driver ALM interface drives KA9 coil subject to load review | KA9 NO: `J11-5` to `J11-6` | `GP20` low on alarm |
| FR driver alarm | Driver ALM interface drives KA10 coil subject to load review | KA10 NO: `J11-7` to `J11-8` | `GP21` low on alarm |

KA1–KA10 are ten isolated field/alarm functions. They are not six functions;
any controls BOM or cabinet layout allocating only six relay couplers is
incorrect. Their exact board-side pair allocation is authoritative in the
[IF-B01 netlist](../hardware/if-b01/if-b01-netlist.csv).

## 6. IF-B01 cabinet connections

The following is a cabinet-interconnect schedule, not a substitute for a
reviewed PCB schematic. Connector pin names and ordering must be read from the
[IF-B01 netlist](../hardware/if-b01/if-b01-netlist.csv); no connection may be
inferred solely from connector position.

| Board connection | Cabinet source / destination | Design constraint |
|---|---|---|
| J3 | `TB24-01 +24V_PELV`, `TB24-02 0V_PELV`, `TB24-03 +5V_LOGIC`, `TB24-02 0V_PELV` | Board power only; actual terminal product and branch protection are release holds |
| J4–J7 | One labelled CL86T/CL57T drive each | IF-B01 sinks `PUL−`, `DIR−`, `ENA−`; common-anode positives come from separately protected `+24V_DRVLOGIC` cabinet wiring and are never routed through IF-B01 |
| J8–J9 | Left/right ifm RU3100 measuring encoders — implemented native circuit: **TTL mode required via IO-Link** (factory setting HTL 50 mA; resolution set to **2048 PPR via IO-Link**); encoder A/B drive the AM26LV32EIDR + inputs single-ended, and each − input (`L_ENC_A_N`, `L_ENC_B_N`, `R_ENC_A_N`, `R_ENC_B_N`) is held at a **2.5 V mid-bias** by 10 kΩ/10 kΩ 1 % dividers from the encoder's own 5 V branch with 100 nF filters (R38–R45, C14–C17; test points TP9–TP12); the four **120 Ω** RS-422 terminators (R1–R4) are **removed from the design**; Z insulated | 5 V branches through verified 1812 SMD PTCs F2/F3 `MF-MSMF050/16X`; A/B single-ended push-pull (no Ā/B̄ outputs); receiver common mode −7…+7 V accepts the TTL swing |
| J10 | KA1–KA6 isolated contact pairs | Inputs close only to `0V_PELV`; no 24 V field voltage reaches Pico GPIO |
| J11 | KA7–KA10 isolated alarm-contact pairs | Inputs close only to `0V_PELV`; no 24 V driver-alarm voltage reaches Pico GPIO |
| J12 | PB01 green LED cathode, PB02 red LED cathode and buzzer negative | Their positive terminals use separately protected `+24V_PELV`; IF-B01 uses low-side channels |

Provisional terminal **designations** preserve the existing netlist references;
they are not selected terminal-block products:

| Designation | Defined net / function | Release state |
|---|---|---|
| TB24-01 | protected `+24V_PELV` to IF-B01 J3-1 | Terminal, wire and fuse coordination unselected |
| TB24-02 | `0V_PELV` common to IF-B01 J3-2/J3-4 and contact returns | Terminal and return-current design unselected |
| TB24-03 | protected `+5V_LOGIC` to IF-B01 J3-3 | Terminal and fuse coordination unselected |
| TB-DL | separately protected `+24V_DRVLOGIC` common-anode drive input supply | CB-TB-DL: Phoenix 3046032 fused terminal, 1 A T 5x20 link (ESKA 522617); per-drive logic feeds on CB-TB-DL-K1-K3 (2026-09-16) |
| TB-S | XPS / E-stop / guard field-loop terminations | Exact terminals, cable and cross-wire arrangement require schematic review |
| TB-M1 / TB-M2 / TB-M3 | K1 / K2 / K3 DC supply and drive branch terminations | DC switching, fusing, discharge and wire sizing unselected |
| PE-BAR | chassis, cable-screen entry and protective-earth bonds | Bar, conductor, enclosure and test plan unselected |

## 7. Signal integrity and segregation requirements

- RU3100 encoders are **single-ended push-pull** (no Ā/B̄): parameterise each
  encoder to **TTL mode via IO-Link** on the bench before installation (the
  factory setting is HTL 50 mA and must not be wired to IF-B01). Wire A to
  the J8/J9 A+ terminal and B to B+; the receiver `L_ENC_A_N`/`L_ENC_B_N`/
  `R_ENC_A_N`/`R_ENC_B_N` inputs are **on-board 2.5 V mid-bias nodes** —
  implemented by R38–R45 (2 × 10 kΩ 1 % per input, 5 kΩ Thévenin) with
  C14–C17 100 nF filters and probeable at TP9–TP12 — and must never be
  grounded, floated or wired to the encoder. The 2.5 V value is the mid-point
  of the encoder's own 5 V TTL swing, so the differential seen by U1 is
  ≈ ±2.5 V, far outside the ±0.2 V receiver thresholds; with the AM26LV32E
  input resistance of 4–17 kΩ the loaded node sits at 1.1–1.9 V over corners,
  still giving ≥0.9 V of LOW-threshold margin. The encoder output drives only
  the + input: ≤1.4 mA worst-case (4 kΩ receiver input) versus the RU3100
  push-pull output rating (HTL setting 50 mA; the TTL-mode drive rating is to
  be confirmed from ifm at purchase). Do **not** fit or substitute the removed
  four 120 Ω RS-422 terminators for TTL drive. Bond each encoder
  cable screen to the cabinet PE bar at the metal cable entry; do not bond
  the screen to IF-B01 `0V_PELV`.
- Keep the two unused encoder Z conductors individually insulated at the board
  plug. Do not join them to `0V_PELV`, the screen or each other. (The RU3100
  Z pin doubles as the IO-Link line used only for bench parameterisation.)
- Maintain physical segregation between AC/mains, switched 36/60 V drive
  power, low-voltage relay wiring, USB and differential encoder cables. Final
  distances, ducts, shield terminations and EMC components require enclosure
  and standards review.
- Treat 24 V field relay coils and dry-contact return pairs as distinct from
  the 3.3 V GPIO side. IF-B01's protected active-low inputs accept only the
  isolated contact closure to `0V_PELV`.
- **Dry-contact pull contract (F04):** the board input is a 10 kΩ series
  resistor followed by a 47 kΩ 1 % pull-up to `3V3_MCU`, a 10 nF filter and a
  3.6 V clamp; the field contact closes the series resistor's far end to
  `0V_PELV`. The RP2350 internal pull-up/pull-down must therefore be
  **disabled in BOTH firmware images** on all ten input GPIOs (`GP12`–`GP16`,
  `GP27`, `GP18`–`GP21`); the contract list is generated into the schematic and
  the intent manifest and is enforced by `tools/check_if_b01_gpio_mapping.py`.
  With an internal pull enabled the asserted LOW rises to 0.82–1.14 V and
  exceeds the RP2350 `VIL(max)` of 0.8 V; with the internal pulls disabled the
  nominal LOW is 0.579 V (§11.9).
- Do not use IF-B01's 100 kΩ `GP17` pull-down, controller watchdog, PIO abort,
  USB disconnection or software STOP command as safety-energy isolation.

## 8. Required staged verification

No stage authorises the next one automatically; measured records and design
review are required.

1. **Native-source and document review:** the editable logical schematic and
  $750\times400\ \mathrm{mm}$ placed/routed, four-layer IF-B01 draft have
  clean KiCad ERC, native-parity and physical/schematic-parity DRC results.
  Complete human electrical/mechanical review and resolve actual footprints,
  terminals, fuses, holders, wire sizes, enclosure, PE, fabricator stack-up and
  panel capability before fabrication.
2. **Unpowered IF-B01 fixture:** inspect a produced board and follow the
   [fixture procedure](../hardware/if-b01/if-b01-test.md) using only the
   dedicated `if-b01-factory-test.uf2` image. J4–J7 must remain unplugged from
   production motor drivers.
3. **Cabinet de-energised inspection:** point-to-point continuity, separation,
   PE continuity, terminal torque/marking and insulation tests under the
   applicable requirements. Record actual instrument identities and results.
4. **Safety-function verification:** test each E-stop channel, both guard
   contact paths, cross-wire faults, reset/EDM behavior and each contactor
   fault mode with a reviewed test plan. Verify the XPS function; do not infer
   system performance from a panel indicator or `GP15`.
5. **Energy verification:** measure K1/K2/K3 opening behavior, all driver-bus
   voltages, regenerated-energy behavior and time to the risk-assessed safe
   condition before enabling any guard-release design.
6. **Machine qualification:** after guards, wire handling and all controls are
   assembled, execute the actual records required by
   [physical qualification](20-physical-qualification.md). Blank or synthetic
   records do not qualify a machine.

## 9. Firmware relationship

The production RP2350 target implements a raw active-low `GP15` safety-loss
interrupt that immediately drives the shared enable low and resets its step
state machines. It also supervises the resulting input in the controller.
This is a useful additional control-layer response, not the safety function.
The contactor circuit must remove motor supply independently of Pico firmware,
its watchdog, IF-B01, USB and the host commissioning tool.

The dedicated `if-b01-factory-test.uf2` target exists only for a bare-board
fixture. It starts with all TPL inputs low, requires active-low `SAFETY_OK` and
held active-low `RESET` before it permits a test output, limits an armed window
to 30 s and limits each asserted output to 3 s. It is not production firmware
and must never be used on the assembled machine.

## 10. Release holds

The following remain open and prevent electrical release or energisation
(items marked * now have their desk part closed in §11 and need only the
named physical/manufacturer step):

1. IF-B01 electrical/mechanical review of the current placed/routed draft;
  fabricator confirmation for its panel, stack-up, footprint and assembly
  constraints; bare-board inspection, assembly and recorded fixture evidence;
2. confirmed `LC1D12BD` DC utilisation/rated switching duty for the exact
   36/60 V three-series-pole loads — **QUALIFIED 2026-09-16 from the
   TeSys Deca catalogue (§11.1: 20 A at ≤75 V in DC-1 and DC-2..5,
   margins 2.06×/3.45×)** — plus measured switching behavior
   (physical, §8.5);
3. DC branch fuse/holder identity (desk part CLOSED 2026-09-16 — §11.4: the
   5.8/5.8/9.7 A power branches stay on the K1/K2/K3 contactors plus the
   LE-350 overload protection, and the three drive-logic feeds get 3046032
   fused terminals with 1 A links, CB-TB-DL-K1-K3); remaining: short-circuit
   coordination review and the measured bus-decay and inrush checks;
4. AC incoming disconnect/protection (identity SELECTED 2026-09-16 — §11.6:
   iC60N 2P C10 A9F54210 + iID 2P 25 A 30 mA A9Z21225; the MCB has no
   observed public price and local-regulation design review remains);
   enclosure, remaining terminal-block parts, cable glands, PE bonding and
   local-regulation design (thermal budget calculated — §11.5 —);
5. E1/E2 guard-release-permission circuit — executable desk design in
   [§11.8](#118-e1e2-guard-release-permission-chain-redesigned-2026-10-13)
   (distinct LADN02 second NC per K1–K3 + PB04 release request + T2 on-delay
   timer + R2; built-in mirror NCs stay exclusively in the XPS EDM chain;
   fail-safe power-loss direction); physical measured bus-decay, T2 setting,
   contact proof tests, fault injection and the risk assessment remain;
6. full safety-function validation, including fault injection, stop time and
   contactor/bus decay measurements on assembled hardware;
7. actual IF-B01, USB, encoder, field I/O, contactor and driver commissioning;
8. completion of the blank physical machine qualification records.

Until every applicable hold is formally closed with evidence, this document
is the build-and-verify baseline: assemble the cabinet per
[docs/23](23-cabinet-electrical-assembly.md), then close the energisation
gates before applying power.

## 11. Electrical calculation package (2026-09-15)

Desk-completed calculations from the archived datasheets. Section 10 holds
that depend on physical measurement or manufacturer enquiry remain and are
named at the end of each subsection.

### 11.1 Branch ratings

| Branch | Contactors | Supply | Rated current |
|---|---|---|---|
| 60 V motion #1 / #2 | K1 / K2 (LC1D12BD, 3 poles in series) | LE-350-60 | 5.8 A nameplate |
| 36 V motion | K3 (LC1D12BD, 3 poles in series) | LE-350-36 | 9.7 A nameplate |
| 24 V control | protected through TB24-01 | 6EP3332 | ≈2 A maximum (relays, logic, HMI) |

The nameplate currents are design maxima; actual branch current is a
commissioning measurement. The 24 V control load total is the sum of the
two contactor coils (2 × 5.4 W = 0.45 A), the XPSUAF, IF-B01 and HMI — the
exact total is verified against the final schematic before fusing.

**DC switching duty of K1–K3 — manufacturer data retrieved 2026-09-16.**
The current Schneider TeSys Deca catalogue (MKTED210011EN, 2026 edition)
is archived as `schneider-tesys-deca-catalogue-2026.pdf` (page extract
`schneider-tesys-dc-tables-fuse-carriers.pdf`). Pages A5/120–121 give the
rated operational currents of the LC1D12 for DC utilisation, poles in
series, ambient ≤60 °C:

- DC-1 (L/R ≤ 1 ms): 24 V 20 A, 48/75 V 20 A, 125 V 20 A, 250 V 20 A,
  300 V 4 A (1/2/3 poles: 125 V = 4/20/20 A, 250 V = 1/4/20 A,
  300 V = –/–/4 A);
- DC-2 to DC-5 (L/R ≤ 15 ms): 24 V 20 A, 48/75 V 20 A, 125 V 20 A,
  250 V 8 A, 300 V 2 A (1/2/3 poles: 125 V = 2/20/20 A,
  250 V = 0.5/2/8 A).

Applied to the branches with three poles in series: 36 V and 60 V are both
inside the 48/75 V row, so the rated operational current is **20 A** in
DC-1 and DC-2..5 → margins **20/9.7 = 2.06×** (K3, 36 V) and
**20/5.8 = 3.45×** (K1/K2, 60 V). The load time constant is far inside the
DC-1 envelope: cable inductance (µH/m scale) against the 3.7 Ω (36 V) /
10.3 Ω (60 V) branch resistance gives L/R ≈ 0.1–0.3 µs ≪ 1 ms, and the
DC-2..5 row covers up to 15 ms regardless. The driver-input capacitance
affects the make (capacitor-charge inrush, LE-350 soft-start limited),
not the break L/R. Catalogue caveat carried over: DC currents below the
table values can reduce electrical durability below the IEC 60947-4-1
figures (critical current) — at 5.8/9.7 A vs the 20 A table value the
contact durability, like the measured K1/K2/K3 opening behaviour (§8.5),
stays a commissioning check. **Verdict: the 3-pole-series arrangement
covers the 36/60 V duty per the TeSys Deca DC tables; CT-K1-K3/CB-K1-K3
move to `selected_DC_duty_qualified`.** Documented alternatives if the DC
duty were inadequate (contingency only, not triggered): a DC-rated
contactor (e.g., a Schneider DC switching series identity to be selected
from the current catalogue), or a semiconductor disconnect with a series
mechanical isolation contact — both require a change record and a repeat
of this calculation.

**24 V branch coordination inputs (2026-09-16).** The Siemens
6EP3332-6SB00-0AY0 official datasheet is now archived
(`siemens-6ep3332-6sb00-0ay0-datasheet.pdf`): output 24 V/2.5 A adjustable
22.2–26.4 V, overload capability 150 % (3.75 A) typical for 200 ms,
short-circuit constant-current limit 3.2 A, mains buffering 40 ms (at
Vin 187 V), inrush limit 52 A / I²t ≤3 A²s, 89.6 % efficiency / 7 W loss,
derating 2 %/K above 55 °C. The 2 A 5×20 XPS-output link and the TB24-01
distribution sit inside the 3.2 A constant-current ceiling; prospective
fault coordination remains a commissioning measurement.

### 11.2 Regeneration and discharge (calculated, assumptions stated)

- Worst-case kinetic energy per stop: feed motor rotor inertia 1080 g·cm²
  (archived 24HS40 datasheet) at 25 rad/s (500 mm/s on the Ø40 roller) gives
  ≈0.034 J; 1 m of 4.5 mm wire at 0.5 m/s adds ≈0.016 J; head axes
  (34E1K-85 rotor, 12.5 mm/s on a 10 mm lead) are ≈0.01 J. Total ≤0.1 J per
  stop against ≥0.18 J stored in 100 µF of bus capacitance at 60 V: the
  drives' deceleration energy is absorbed by the bus and the LE-350 overload
  protection (self-recovery, archived datasheet). **Regeneration is not a
  design driver.**
- Bus discharge after contactor open: with an assumed 500 µF total bus
  (PSU output + two driver inputs + decoupling — verify at receipt) and a
  conservative 20 mA quiescent draw, the bus falls below 42 V in ≈0.45 s.
  This is an estimate, not a guarantee: the E1/E2 release-permission timing
  must be based on a measured decay curve on assembled hardware. A fixed
  bleed resistor (e.g., 2.2 kΩ 5 W per branch, τ≈1.1 s) is proposed for
  determinism and is part of the §10 hold 5 design.

### 11.3 XPS output fuse — corrected sizing and 5×20 holder closure (2026-09-16)

XPSUAF13AP relay outputs are rated **5 A DC-1 / 3 A DC-13 at 24 V DC**
(archived datasheet). The XPS output load is the two contactor coils
(≈0.45 A total). A 10 A gG link (DF2CN10) cannot protect 5 A contacts
between 5–10 A and is therefore **too large**; the corrected link rating is
2 A. The first 2 A selection was the Schneider DF2CN02 10×38 link, but its
DIN-rail 10×38 holder had no reachable live price and stayed an open hold.
On 2026-09-16 that hold was closed by moving the function to a priced 5×20
solution:

- **Phoenix Contact 3046032** 5×20 fuse serial terminal (6.3 A rated,
  DIN rail) — already selected for the `+24V_DRVLOGIC` branch (CB-TB-DL);
  EUR 7.99 incl VAT, 34 in stock, observed 2026-09-16 at
  [Conrad](https://www.conrad.com/en/p/phoenix-contact-3046032-fuse-serial-terminal-6-2-mm-screws-black-1-pc-s-744510.html);
- **ESKA 522620**, 2 A T (time-lag) 5×20 link, 250 V DC — carries the
  ≈0.45 A coil load with surge margin and clears overloads above 2 A within
  the 6.3 A terminal rating; EUR 1.49 incl VAT, 1368 in stock, observed
  2026-09-16 at
  [Conrad](https://www.conrad.com/en/p/eska-522620-522620-dc-fuse-o-x-l-5-mm-x-20-mm-2-a-250-v-dc-time-delay-t-content-1-pc-s-1414701.html).

**Protection-selection requirement (corrected 2026-10-13, audit F27a).** The
earlier "2 A T ≈ gG equivalence" reasoning is withdrawn: IEC 60127 (T) and
IEC 60269 (gG) time-current curves, breaking capacities and DC ratings are not
interchangeable, so equivalence may not be asserted. The 2 A selection is
retained only as the provisional smallest standard 5×20 link above the
≈0.45 A coil load, and the row stays **not closed** until an explicit
comparison is recorded from maker data:

1. **Clearing curve:** the chosen link's time-current characteristic compared
   against the prospective fault current into the XPS output circuit — bounded
   by the 6EP3332 short-circuit constant-current limit of 3.2 A (§11.1) — and
   against the XPS output relay's published (or conservatively bounded)
   clearing `I²t` / contact withstand; the 5 A DC-1 / 3 A DC-13 relay outputs
   must not be welded or eroded by a cleared downstream fault.
2. **Breaking capacity:** the link's rated breaking capacity at **24 V DC**
   (use its DC rating, not the AC rating; the selected ESKA 522620 is listed as
   a 2 A / 250 V DC T link on the recorded distributor page, observed
   2026-09-16 — confirm on the maker datasheet).
3. **Relay `I²t`:** the prospective let-through energy at the 3.2 A
   current-limited supply must sit inside the relay contact's withstand.
4. **Hold margin:** the link's own carry rating and time-lag curve must hold
   the coil inrush without nuisance opening.

If any leg of that comparison cannot be demonstrated from the maker's data,
`CB-XPS-FUSE` remains an open hold and the XPS output protection must be
re-selected (the 10 A gG reference rating cannot be used against the 5 A DC-1
outputs). The 10×38 holder is no longer required and the `HOLD-FUSE-HOLDER`
rows are removed. The Schneider DIN-rail 10×38 holder identity is nevertheless
now confirmed from the archived TeSys catalogue (pages B4/4, B4/10–11):
**DF101** (1 pole, Ith 32 A, Ui 690 V, IP20, 17.5 mm wide on 35 mm DIN
rail, padlockable; family DF101N/DF102/DF103, LED variants
DF101V…DF103NV). It is recorded as the confirmed catalogue identity for
the ledger gate (row CB-FUSE-HOLDER, superseded, not procured) and is not
reintroduced: the design keeps the priced 5×20 solution above, subject to the
comparison requirement. The identity change is recorded in
[selected-controls.csv](../bom/selected-controls.csv),
[selected-cabinet-wiring.csv](../bom/selected-cabinet-wiring.csv) and
[sourcing-evidence.csv](../bom/sourcing-evidence.csv). Prospective
short-circuit coordination with the 24 V supply current limiting is
verified at commissioning (physical).

### 11.4 Wiring schedule (calculated)

| Circuit | Current | Conductor | Basis |
|---|---|---|---|
| 60 V branches K1/K2 | 5.8 A | H07V-K 1.0 mm² (19 A @30 °C, derated ≥14 A bundled) | IEC 60204-1 ampacity tables |
| 36 V branch K3 | 9.7 A | H07V-K 1.5 mm² (24 A @30 °C, derated ≥17 A) | same |
| 24 V control | ≤2 A | H07V-K 0.75 mm² | same |
| Mains 230 V | 1050 W/230 V = 4.6 A | H07V-K 1.5 mm² | same |
| PE conductors | — | equal to phase (1.5 mm² minimum); equipment PE bonds M6, ≤0.1 Ω continuity target | IEC 60204-1 §8 |

**DC branch protection decision (2026-09-16).** The 60 V branches carry
5.8 A each and the 36 V branch 9.7 A (nameplate). The 5×20 fused-terminal
class ends at 6.3 A, so the power branches are **not** placed on 5×20
links: the K1/K2/K3 three-series-pole contactor arrangement plus the
LE-350 overload protection (self-recovery, archived datasheet) is the
branch protection, and the wire ampacity margins hold per the table. The
drive LOGIC supply feeds (PUL/DIR/ENA common-anode rails, a fraction of an
amp each) get 3× Phoenix 3046032 fused terminals with 1 A T 5×20 links
(ESKA 522617, EUR 1.49 incl VAT, 224 in stock, observed 2026-09-16 at
[Conrad](https://www.conrad.com/en/p/eska-522617-522617-dc-fuse-o-x-l-5-mm-x-20-mm-1-a-250-v-dc-time-delay-t-content-1-pc-s-1414698.html);
rows CB-TB-DL and CB-TB-DL-K1-K3). Short-circuit coordination and inrush
remain commissioning measurements (§10 hold 3).

### 11.5 Enclosure thermal budget (recalculated 2026-10-13, audit F27b)

Every significant cabinet heat source is now counted, including all four
drives. The drives' own dissipation is not published by STEPPERONLINE, so a
planning allowance is used and flagged as a measurement item.

| Source | Realistic duty (30 cuts/min) | Full-rated envelope (never simultaneous) |
|---|---|---|
| 3 × LE-350 (60/60/36 V) | ≈35 W (losses at <30 % load) | 3 × 41 W = **123 W** at full rated output (≥89.5 % efficiency, archived datasheets) |
| 4 stepper drives (2 × CL86T, 2 × CL57T) | ≈30 W allowance (≈7.5 W each; duty currents, unpublished — measure case temperatures) | ≈100 W allowance (25 W each at nameplate; conservative until measured) |
| 24 V PSU 6EP3332 at 2.5 A | ≈4 W | 7 W (archived datasheet) |
| 5 V PSU 6EP3310 at encoder load | ≈1 W | ≤1 W (4.7 W only at its 3 A rating) |
| K1–K3 coils (3 × 5.4 W standard DC coil) | **16.2 W** (all three energised in production) | 16.2 W |
| KA1–KA10 + KSR1 + R2 relay coils | ≈6 W (12 × ≈0.5 W allowance) | 6 W |
| XPS + T2 | ≈4 W | 4 W |
| IF-B01 board | ≈5 W | 5 W |
| Panel indicators/HMI allowance | ≈5 W | 5 W |
| **Total** | **≈106 W** | **≈267 W** |

- **40 °C room case (limit ambient).** Rittal AE 800×600×210 painted-steel
  surface ≈1.55 m², k ≈ 5.5 W/(m²K) → ≈8.5 W/K. Without the cooler the
  realistic duty alone gives ΔT ≈ 12 K → internal ≈52 °C, above the archived
  CL57T/CL86T 40 °C reliable-working limit: **the TH-C01 cooler is required,
  not optional, at a 40 °C room.** With TH-C01 (Rittal SK3303.500; selected
  row records 280 W cooling capacity at L35 — reconfirm against the Rittal
  record at order): margin at realistic duty = 280 − 106 = **≈174 W (2.6×)**;
  at the full-rated envelope = 280 − 267 = **≈13 W** only, so that envelope
  must never be sustained. Set the TH-C01 thermostat to hold the internal
  temperature ≤38 °C.
- **Required overtemperature response.** Fit an independent DIN-rail
  thermostat TH-C02 (NC, opens on rise, set ≈40 °C; Rittal SK3110.000-class
  identity to confirm at purchase) **in series with the XPS `A1` supply**. On
  overtemperature the XPS drops out, all three contactors open and every drive
  bus de-energises; the `GP15`/KA4 diagnostic is lost in firmware and restart
  stays blocked until the internal temperature is below 38 °C and PB03 is
  reset. This is a protective drive stop, not a safety function and not a
  substitute for the XPS channels.
- The P9 thermal mapping in [docs/36](36-commissioning-runbook.md) must
  measure the actual duty temperatures (supplies, drives, IF-B01, cooler
  intake) and confirm ≤40 °C internally at a 40 °C room before sustained
  production; the drive dissipation allowances above are replaced by the
  measured values at that point.

### 11.6 Cabinet identities (proposal retained, verification notes)

Proposed identities (procurement intent, not selections): Phoenix Contact
PT 2,5 feed-through terminals 3209510 (grey) / 3209523 (blue) for the
24 V/5 V distribution; Phoenix UT 4 3044131 per DC branch termination;
Phoenix 3046032 5×20 fused terminals for the XPS output, `+24V_DRVLOGIC`
and the three drive-logic feeds (priced and selected 2026-09-16 — §11.3/
§11.4); AC incoming **Schneider Acti9 iC60N 2P C10 (A9F54210) + iID 2P
25 A 30 mA type A (A9Z21225)** — the RCD is priced at Conrad (EUR 35.99
incl VAT, 5 in stock, observed 2026-09-16); the MCB has no observed live
price (channels exhausted 2026-09-16: automation24 search/category pages
unreachable to automated fetch, Conrad lists only 1P/3P/4P iC60N, ebmia
only 2P B-curve 6 kA, se.com 403) and is confirmed on a live distributor
page at purchase; a dedicated separated terminal group for the safety loop;
a copper PE bar with M6 bonds; 2 × M20 EMC metal cable glands (Lapp Skintop
MS-M or Pflitsch blueglobe, identity to be confirmed); H07V-K 0.75/1.0/1.5
mm² with insulated ferrules; a Rittal AE wall-mount enclosure ≥800×600×210
to be size-confirmed from the 750×400 mm IF-B01 board plus K1–K3, three
PSUs, XPS and terminal layout. Maker pages (phoenixcontact.com, wago.com,
se.com) block automated retrieval and no live-page price could be observed
for the remaining unpriced identities; they are exact catalogue part
numbers to be confirmed on a live distributor page at purchase. Until then
the remaining rows stay `UNSELECTED` release holds. This is the desk ceiling
for those rows, not an unresolved engineering question: the exact
confirm-and-purchase step is defined.

### 11.7 What this package closes vs leaves open

Closed from the desk: branch current sizing, regen non-issue with numbers,
discharge estimate + bleed proposal, XPS output-link comparison requirement
(§11.3 — the 2 A value is provisional until the curve/breaking-capacity
comparison is recorded), the AC incoming identity (iC60N 2P C10 + iID 2P 25 A
30 mA), the DC branch-protection decision, wiring schedule, PE sizing,
the recalculated enclosure thermal budget with all four drives and the 40 °C
room case (§11.5), the dry-contact pull contract and nominal-LOW corner
(§11.9), the encoder-supply drop check (§11.9) and the separated
guard-release-permission chain (§11.8). Left open by nature: the measured
K1/K2/K3 DC switching behavior and contact durability (the catalogue duty is
qualified in §11.1; the critical-current note and §8.5 measurements remain),
the unpriced incoming MCB (confirm at purchase),
the XPS output-link coordination comparison and the unpriced LADN02/T2
(confirm at purchase), measured bus decay, prospective fault and stop-time
measurements, risk-assessment sign-off, and the physical build itself
(§10 holds 1–8 remain).

### 11.9 IF-B01 interface corners (2026-10-13)

**Dry-contact LOW level (F04).** Board network per input: 10 kΩ series to the
field terminal, 47 kΩ 1 % pull-up to `3V3_MCU` at the pin, 10 nF to
`0V_PELV`, 3.6 V clamp. With the field contact closed and the RP2350 internal
pulls **disabled**:

- nominal LOW: 3.3 V × 10 kΩ / (10 kΩ + 47 kΩ) = **0.579 V**, margin
  0.221 V to the RP2350 `VIL(max)` of 0.8 V;
- worst case: 3.465 V rail (+5 %) and 46.53 kΩ pull-up (−1 %) give
  0.613 V; 1 µA pin leakage into the node (10 kΩ ∥ 46.53 kΩ = 8.23 kΩ) adds
  8 mV → **≤0.621 V**, still 0.179 V below 0.8 V;
- released HIGH: the pin sits at the 3V3 rail through 47 kΩ with only
  nanoamp–microamp leakage, ≫ the 2.0 V `VIH(min)`;
- if an internal pull-up remains enabled (47 kΩ ∥ 32–86 kΩ), the asserted
  LOW rises to 0.82–1.14 V and **fails** the 0.8 V limit — this is why the
  contract list (`GP12`–`GP16`, `GP27`, `GP18`–`GP21`, both firmware images)
  is enforced by `tools/check_if_b01_gpio_mapping.py`.

**Encoder-supply drop (F02).** Path per encoder: `+5V_LOGIC` → J3-3 →
F2/F3 (`MF-MSMF050/16X`, worst initial resistance R1max = 1.3 Ω, typical
0.15 Ω; ratings, temperature derating and the pad layout verified in the
Bourns MF-MSMF datasheet,
[bourns.com/docs/Product-Datasheets/mfmsmf.pdf](https://www.bourns.com/docs/Product-Datasheets/mfmsmf.pdf))
→ J8-1/J9-1 → encoder M12 UB. Encoder current ≤150 mA
(RU3100 datasheet; the four 2.5 V dividers add 0.5 mA per encoder), planned
cable ≤2 m of 5 × 0.25 mm² (69 mΩ/m per conductor). At the 5 V setting:

- setpoint 5.0 V −3 % tolerance = 4.85 V at the PSU; drop at worst-case PTC
  resistance = 0.1505 A × (1.3 + 2 × 2 × 0.069 + connector) ≈ 0.22 V →
  ≈4.63 V at the encoder, i.e. **below the RU3100 4.75 V minimum at the
  worst-case corner**;
- therefore the 5 V rail is set to **5.2 V at commissioning** (within the
  verified 4.6–5.4 V adjustment range): 5.2 V −3 % = 5.04 V, minus the same
  0.22 V → ≈4.82 V ≥ 4.75 V, and the measured J8-1/J9-1 voltage under
  encoder load is recorded;
- maximum conductor length from the same budget: allowance
  5.04 − 4.75 − 0.195 (PTC) ≈ 0.095 V at 0.1505 A → loop resistance
  ≤0.63 Ω → **≤4.6 m of 0.25 mm² / ≤9.2 m of 0.5 mm²** for each encoder
  cable; the planned 2 m cables sit inside this with >2× margin. Longer
  cables require a larger cross-section or a local encoder supply.
- the bias network draws its 0.5 mA per encoder downstream of the PTC, so it
  is included in the 0.1505 A; a tripped F2/F3 therefore also removes the
  bias (the receiver then sees no valid differential, which firmware treats
  as an encoder fault, not as a valid direction).
