sbelakho2/Cutting/engineering/generated/feed-fem/step-readback/vendor-cylinders.csv

file | radius_mm | axis_x | axis_y | axis_z | origin_x | origin_y | origin_z | vmin_mm | vmax_mm | umin_rad | umax_rad
F101-R6-analysis.step | 1.52 | 0 | 0 | 1 | 0 | 95.97 | -10 | 5 | 6.65 | 3.14159265359 | 6.28318530718
F101-R6-analysis.step | 0.15 | -0 | 1 | 0 | 1.37 | 95.97 | -3.35 | 0 | 15.06 | 4.71238898038 | 6.28318530718
F101-R6-analysis.step | 5 | 0 | 1 | 0 | 0 | 92 | 0 | 0.2 | 20.8 | 0 | 6.28318530718
F101-R6-analysis.step | 1.52 | 0 | 0 | 1 | 0 | 111.03 | -10 | 5 | 6.65 | 0 | 3.14159265359
F101-R6-analysis.step | 0.15 | 0 | -1 | -0 | -1.37 | 111.03 | -3.35 | 0 | 15.06 | 4.71238898038 | 6.28318530718
F101-R6-analysis.step | 6 | 0 | 1 | 0 | 0 | 87 | 0 | 0.5 | 5 | 0 | 6.28318530718
F101-R6-analysis.step | 2.5 | 0 | 1 | 0 | 0 | 98.8 | 0 | 0 | 14 | 0 | 6.28318530718
F101-R6-analysis.step | 2.1 | 0 | 1 | 0 | 0 | 95 | 0 | 0 | 3.8 | 0 | 6.28318530718
F101-R6-analysis.step | 9.5 | 0 | 1 | 0 | 0 | 82 | 0 | 0 | 5 | 0 | 6.28318530718
F101-R6-analysis.step | 7.5 | 0 | 1 | 0 | 0 | 64.5 | 0 | 8.5 | 17.3 | 0 | 6.28318530718
F101-R6-analysis.step | 0.5 | 0 | 0 | 1 | 1.6 | 72.5 | 5.5 | 0.15 | 1.26332019056 | 0 | 1.5707963268
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
