sbelakho2/Cutting/engineering/generated/feed-fem/step-readback/vendor-planes.csv

file | normal_x | normal_y | normal_z | origin_x | origin_y | origin_z | xmin | ymin | zmin | xmax | ymax | zmax
F101-R6-analysis.step | 1 | 0 | -0 | 1.52 | 95.97 | -10 | 1.52 | 95.97 | -4.76336015854 | 1.52 | 111.03 | -3.35
F101-R6-analysis.step | 1 | 0 | -0 | -1.52 | 95.97 | -10 | -1.52 | 95.97 | -4.76336015854 | -1.52 | 111.03 | -3.35
F101-R6-analysis.step | 0 | 0 | 1 | 0 | 111.03 | -3.2 | -1.37 | 94.6 | -3.2 | 1.37 | 112.4 | -3.2
F101-R6-analysis.step | 0 | 1 | 0 | 0 | 113 | 0 | -4.8 | 113 | -4.8 | 4.8 | 113 | 4.8
F101-R6-analysis.step | 0 | 1 | 0 | 0 | 92 | 0 | -6 | 92 | -6 | 6 | 92 | 6
F101-R6-analysis.step | 0 | 1 | 0 | 0 | 98.8 | 0 | -2.5 | 98.8 | -2.5 | 2.5 | 98.8 | 2.5
F101-R6-analysis.step | 0 | 1 | 0 | 0 | 87 | 0 | -9.5 | 87 | -9.5 | 9.5 | 87 | 9.5
F101-R6-analysis.step | 0 | 1 | 0 | 0 | 82 | 0 | -9.5 | 82 | -9.5 | 9.5 | 82 | 9.5
F101-R6-analysis.step | 0 | 1 | 0 | 0 | 73 | 0 | -7.5 | 73 | -7.5 | 7.5 | 73 | 7.5
F101-R6-analysis.step | 1 | 0 | -0 | 2.1 | 31.2 | 5.5 | 2.0999999 | 60.566359233 | 5.6499999 | 2.1000001 | 72.5000001 | 7.2000001
F101-R6-analysis.step | 0 | 0 | 1 | -2.1 | 31.2 | 5.5 | -1.95000000001 | 60.8538420984 | 5.5 | 1.95000000001 | 72.85 | 5.5
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
