sbelakho2/Cutting/engineering/sources/misumi-belt-installation.png

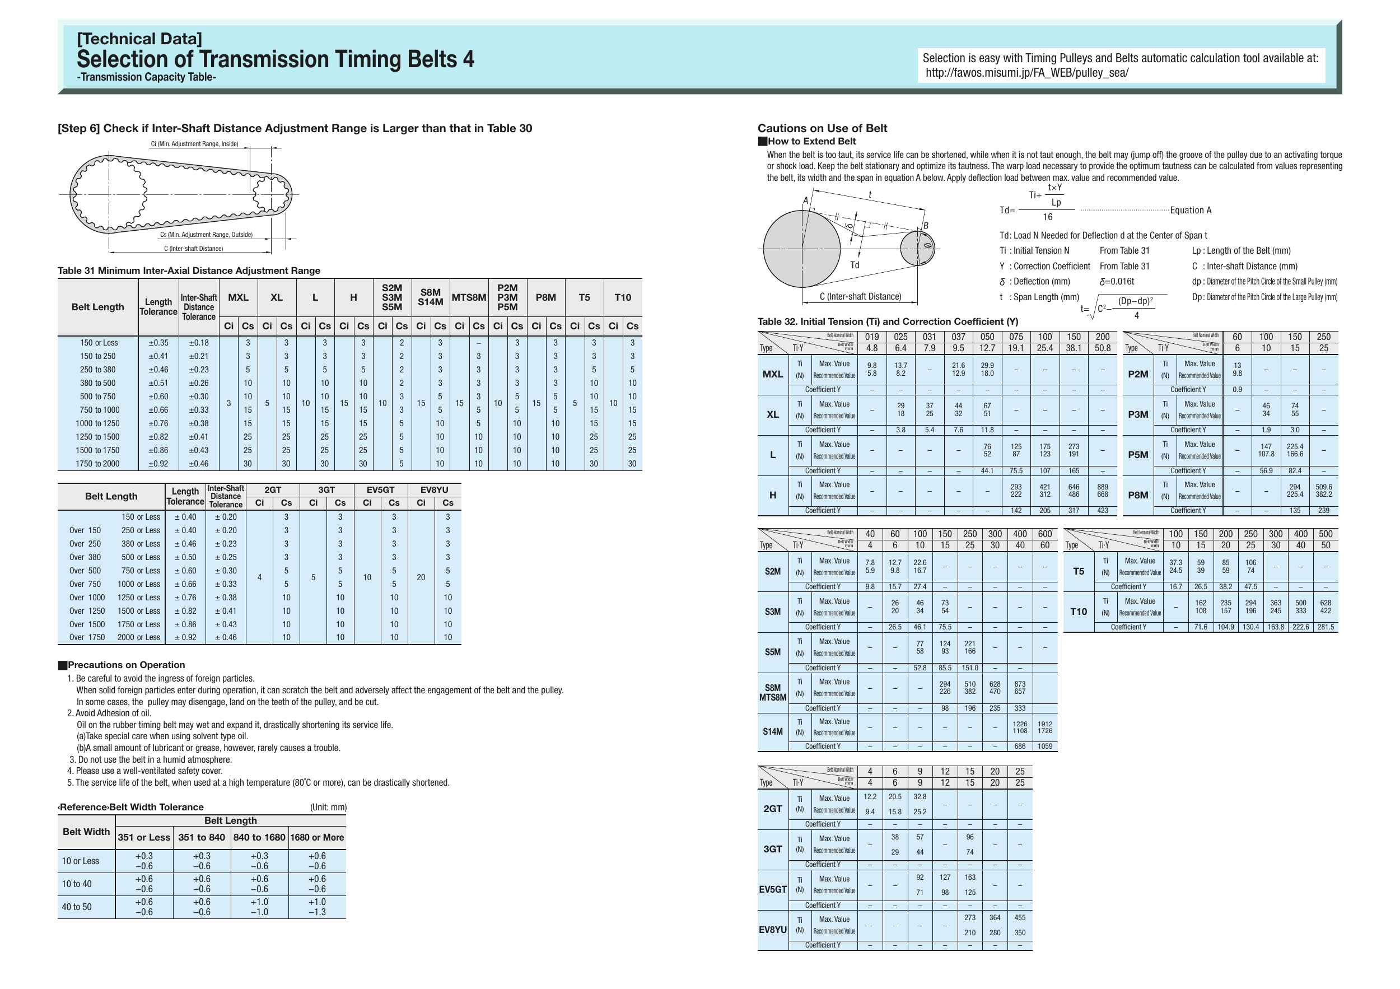
engineering/sources/misumi-belt-installation.png
