sbelakho2/Cutting/engineering/generated/measurement/M201-inspection-template.csv

characteristic | minimum | maximum | unit | method | measured_value | instrument_id | uncertainty | result | inspector | date
part_identity | M201-R2 | M201-R2 | text | part_mark_and_revision
material | EN_AW_6082-T6 | EN_AW_6082-T6 | text | material_certificate
width_X | 59.95 | 60.05 | mm | micrometer
height_Z | 59.95 | 60.05 | mm | micrometer
thickness_corner_1 | 5.98 | 6.02 | mm | micrometer
thickness_corner_2 | 5.98 | 6.02 | mm | micrometer
thickness_corner_3 | 5.98 | 6.02 | mm | micrometer
thickness_corner_4 | 5.98 | 6.02 | mm | micrometer
seat_bore | 36.50 | 36.55 | mm | bore_gauge
seat_cylindricity | 0 | 0.01 | mm | form_measurement
seat_perpendicularity_to_A | 0 | 0.02 | mm | datum_referenced_measurement
A_flatness | 0 | 0.02 | mm | surface_plate_and_indicator
opposite_face_parallelism | 0 | 0.02 | mm | datum_A_surface_plate_and_indicator
encoder_hole_1_diameter | 4.50 | 4.60 | mm | gauges
encoder_hole_2_diameter | 4.50 | 4.60 | mm | gauges
encoder_hole_3_diameter | 4.50 | 4.60 | mm | gauges
encoder_hole_1_position | 0 | 0.10 | mm_diameter | CMM_A_B_C
encoder_hole_2_position | 0 | 0.10 | mm_diameter | CMM_A_B_C
encoder_hole_3_position | 0 | 0.10 | mm_diameter | CMM_A_B_C
support_tap_1_M4_go_no_go | M4x0.7 | M4x0.7 | text | thread_gauges
support_tap_2_M4_go_no_go | M4x0.7 | M4x0.7 | text | thread_gauges
support_tap_3_M4_go_no_go | M4x0.7 | M4x0.7 | text | thread_gauges
support_tap_4_M4_go_no_go | M4x0.7 | M4x0.7 | text | thread_gauges
support_tap_1_position | 0 | 0.10 | mm_diameter | CMM_A_B_C
support_tap_2_position | 0 | 0.10 | mm_diameter | CMM_A_B_C
support_tap_3_position | 0 | 0.10 | mm_diameter | CMM_A_B_C
support_tap_4_position | 0 | 0.10 | mm_diameter | CMM_A_B_C
edge_chamfer | 0.15 | 0.25 | mm | profile_measurement
seat_Ra | 0 | 0.8 | um | profilometer
joint_face_Ra | 0 | 1.6 | um | profilometer
other_surface_Ra | 0 | 3.2 | um | profilometer
cleanliness | no_burrs_chips_or_coating_on_A_B | no_burrs_chips_or_coating_on_A_B | text | visual_and_wipe
