sbelakho2/Cutting/engineering/generated/feed-submodel/gmsh/pulley_key_working/results.csv

root_mm | mode | nodes | tets | case | sampled_vm_MPa | phase_upper_MPa | peak_x_mm | peak_S_mm | peak_z_mm | phase_deg | CAD_state
0.02 | sector | 66229 | 377929 | working | 37.0902550409 | 39.3635120755 | 2.58444465796 | 59.2396337223 | 6.43237718703 | 240 | inside
0.0175 | sector | 80115 | 461967 | working | 37.082037797 | 39.3536302269 | 2.59435085503 | 59.1288282272 | 6.3345448988 | 240 | inside
