sbelakho2/Cutting/engineering/generated/feed-submodel/gmsh/roller_key_root/results.csv

root_mm | mode | nodes | tets | case | sampled_vm_MPa | phase_upper_MPa | peak_x_mm | peak_S_mm | peak_z_mm | phase_deg | CAD_state
0.02 | sector | 71621 | 406184 | working | 42.2168632855 | 43.3250234267 | -1.37987302804 | 103.72132377 | -3.18054844663 | 315 | inside
0.02 | sector | 71621 | 406184 | fault | 145.53942589 | 146.648097309 | -1.37987302804 | 103.72132377 | -3.18054844663 | 315 | inside
0.0175 | sector | 90380 | 517535 | working | 41.7831478977 | 42.8902744854 | -1.3843407965 | 103.463748609 | -3.19099071778 | 315 | inside
0.0175 | sector | 90380 | 517535 | fault | 143.89067018 | 144.997716255 | -1.3843407965 | 103.463748609 | -3.19099071778 | 315 | inside
