sbelakho2/Cutting/engineering/generated/feed-submodel/gmsh/roller_shoulder/results.csv

root_mm | mode | nodes | tets | case | sampled_vm_MPa | phase_upper_MPa | peak_x_mm | peak_S_mm | peak_z_mm | phase_deg | CAD_state
0.02 | full | 102080 | 423725 | working | 46.1372107184 | 48.5543174369 | -2.24767813837 | 92.1211383741 | -4.47112000575 | 112.5 | inside
0.02 | sector | 33392 | 141859 | working | 45.3503299266 | 47.9384682626 | -2.2896129811 | 92.117459723 | 4.45628179332 | 157.5 | inside
0.01 | sector | 87820 | 359525 | working | 45.1635796573 | 47.8505618141 | 1.66521202802 | 92.1180809879 | 4.72954949943 | 300 | inside
