sbelakho2/Cutting/engineering/generated/feed-submodel/netgen/m15_relief/results.csv

root_mm | mode | nodes | tets | case | sampled_vm_MPa | phase_upper_MPa | peak_x_mm | peak_S_mm | peak_z_mm | phase_deg | CAD_state
0.02 | sector | 60645 | 251363 | working | 60.4632831772 | 63.6433214901 | 2.05510358306 | 72.7150381194 | 6.41163306308 | 37.5 | inside
0.02 | sector | 60645 | 251363 | fault | 110.528044159 | 113.418393418 | -2.00166295616 | 72.8122644998 | 6.44379204383 | 142.5 | inside
0.01 | sector | 139132 | 552041 | working | 60.4149314229 | 63.479226251 | 2.00102620256 | 72.8094524672 | 6.44541597257 | 37.5 | inside
0.01 | sector | 139132 | 552041 | fault | 115.129572733 | 118.166728539 | -1.99325028701 | 72.8179398015 | 6.44859145379 | 142.5 | inside
