sbelakho2/Cutting/engineering/generated/feed-submodel/netgen/roller_key_root/results.csv

root_mm | mode | nodes | tets | case | sampled_vm_MPa | phase_upper_MPa | peak_x_mm | peak_S_mm | peak_z_mm | phase_deg | CAD_state
0.02 | sector | 65381 | 349885 | working | 42.0069901889 | 43.1455230984 | -1.41739896682 | 101.136829619 | -3.19440090876 | 315 | inside
0.02 | sector | 65381 | 349885 | fault | 145.743706772 | 146.882239682 | -1.41739896682 | 101.136829619 | -3.19440090876 | 315 | inside
0.0175 | sector | 82209 | 444496 | working | 42.9553267993 | 44.0974584336 | -1.42275191398 | 102.997937407 | -3.18643613773 | 315 | inside
0.0175 | sector | 82209 | 444496 | fault | 147.876728835 | 149.018860469 | -1.42275191398 | 102.997937407 | -3.18643613773 | 315 | inside
