sbelakho2/Cutting/engineering/generated/feed-submodel/netgen/roller_shoulder/results.csv

root_mm | mode | nodes | tets | case | sampled_vm_MPa | phase_upper_MPa | peak_x_mm | peak_S_mm | peak_z_mm | phase_deg | CAD_state
0.02 | full | 101337 | 402405 | fault | 106.034030212 | 108.139962708 | -0.709697948757 | 92.1229223437 | -4.95996891589 | 232.5 | inside
0.02 | sector | 37275 | 151212 | fault | 105.460918047 | 107.553217324 | -0.575511490491 | 92.1128492705 | -4.98133260047 | 240 | inside
0.01 | sector | 91231 | 358487 | fault | 104.738457797 | 106.929300265 | 1.28294192844 | 92.1120625959 | -4.85044773986 | 45 | inside
