sbelakho2/Cutting/engineering/generated/measurement-analysis/raw-error-budget.csv

commanded_length_mm | factory_scale_error_mm | runout_allocation_mm | quantisation_allocation_mm | tension_allocation_mm | slip_allocation_mm | bounded_total_mm | target_mm | result
200 | 0.2 | 0.2 | 0.025 | 0.15 | 0.25 | 0.825 | 0.3 | FAIL
500 | 0.5 | 0.2 | 0.025 | 0.15 | 0.25 | 1.125 | 0.45 | FAIL
1000 | 1 | 0.2 | 0.025 | 0.15 | 0.25 | 1.625 | 0.7 | FAIL
3000 | 3 | 0.2 | 0.025 | 0.15 | 0.25 | 3.625 | 1.7 | FAIL
