sbelakho2/Cutting/engineering/generated/measurement-analysis/synthetic-fit.csv

from_count | to_count | reference_mm | reference_uncertainty_mm
0 | 256 | 6.2738840322016127 | 0.001
256 | 0 | -6.2738840322016127 | 0.001
0 | 512 | 12.547018343236509 | 0.001
512 | 0 | -12.547018343236509 | 0.001
0 | 768 | 18.81868202330196 | 0.001
768 | 0 | -18.81868202330196 | 0.001
0 | 1024 | 25.088210678118653 | 0.001
1024 | 0 | -25.088210678118653 | 0.001
0 | 1280 | 31.355021961230253 | 0.001
1280 | 0 | -31.355021961230253 | 0.001
0 | 1536 | 37.618637953251124 | 0.001
1536 | 0 | -37.618637953251124 | 0.001
0 | 1792 | 43.878703528040326 | 0.001
1792 | 0 | -43.878703528040326 | 0.001
0 | 2048 | 50.134999999999998 | 0.001
2048 | 0 | -50.134999999999998 | 0.001
0 | 2304 | 56.387453528040318 | 0.001
2304 | 0 | -56.387453528040318 | 0.001
0 | 2560 | 62.636137953251122 | 0.001
2560 | 0 | -62.636137953251122 | 0.001
0 | 2816 | 68.881271961230254 | 0.001
2816 | 0 | -68.881271961230254 | 0.001
0 | 3072 | 75.123210678118653 | 0.001
3072 | 0 | -75.123210678118653 | 0.001
0 | 3328 | 81.362432023301949 | 0.001
3328 | 0 | -81.362432023301949 | 0.001
0 | 3584 | 87.599518343236511 | 0.001
3584 | 0 | -87.599518343236511 | 0.001
0 | 3840 | 93.835134032201609 | 0.001
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
