sbelakho2/Cutting/hardware/if-b01/manufacturing/draft-r2-2026-09-13/assembly/if-b01-bottom-assembly.pdf

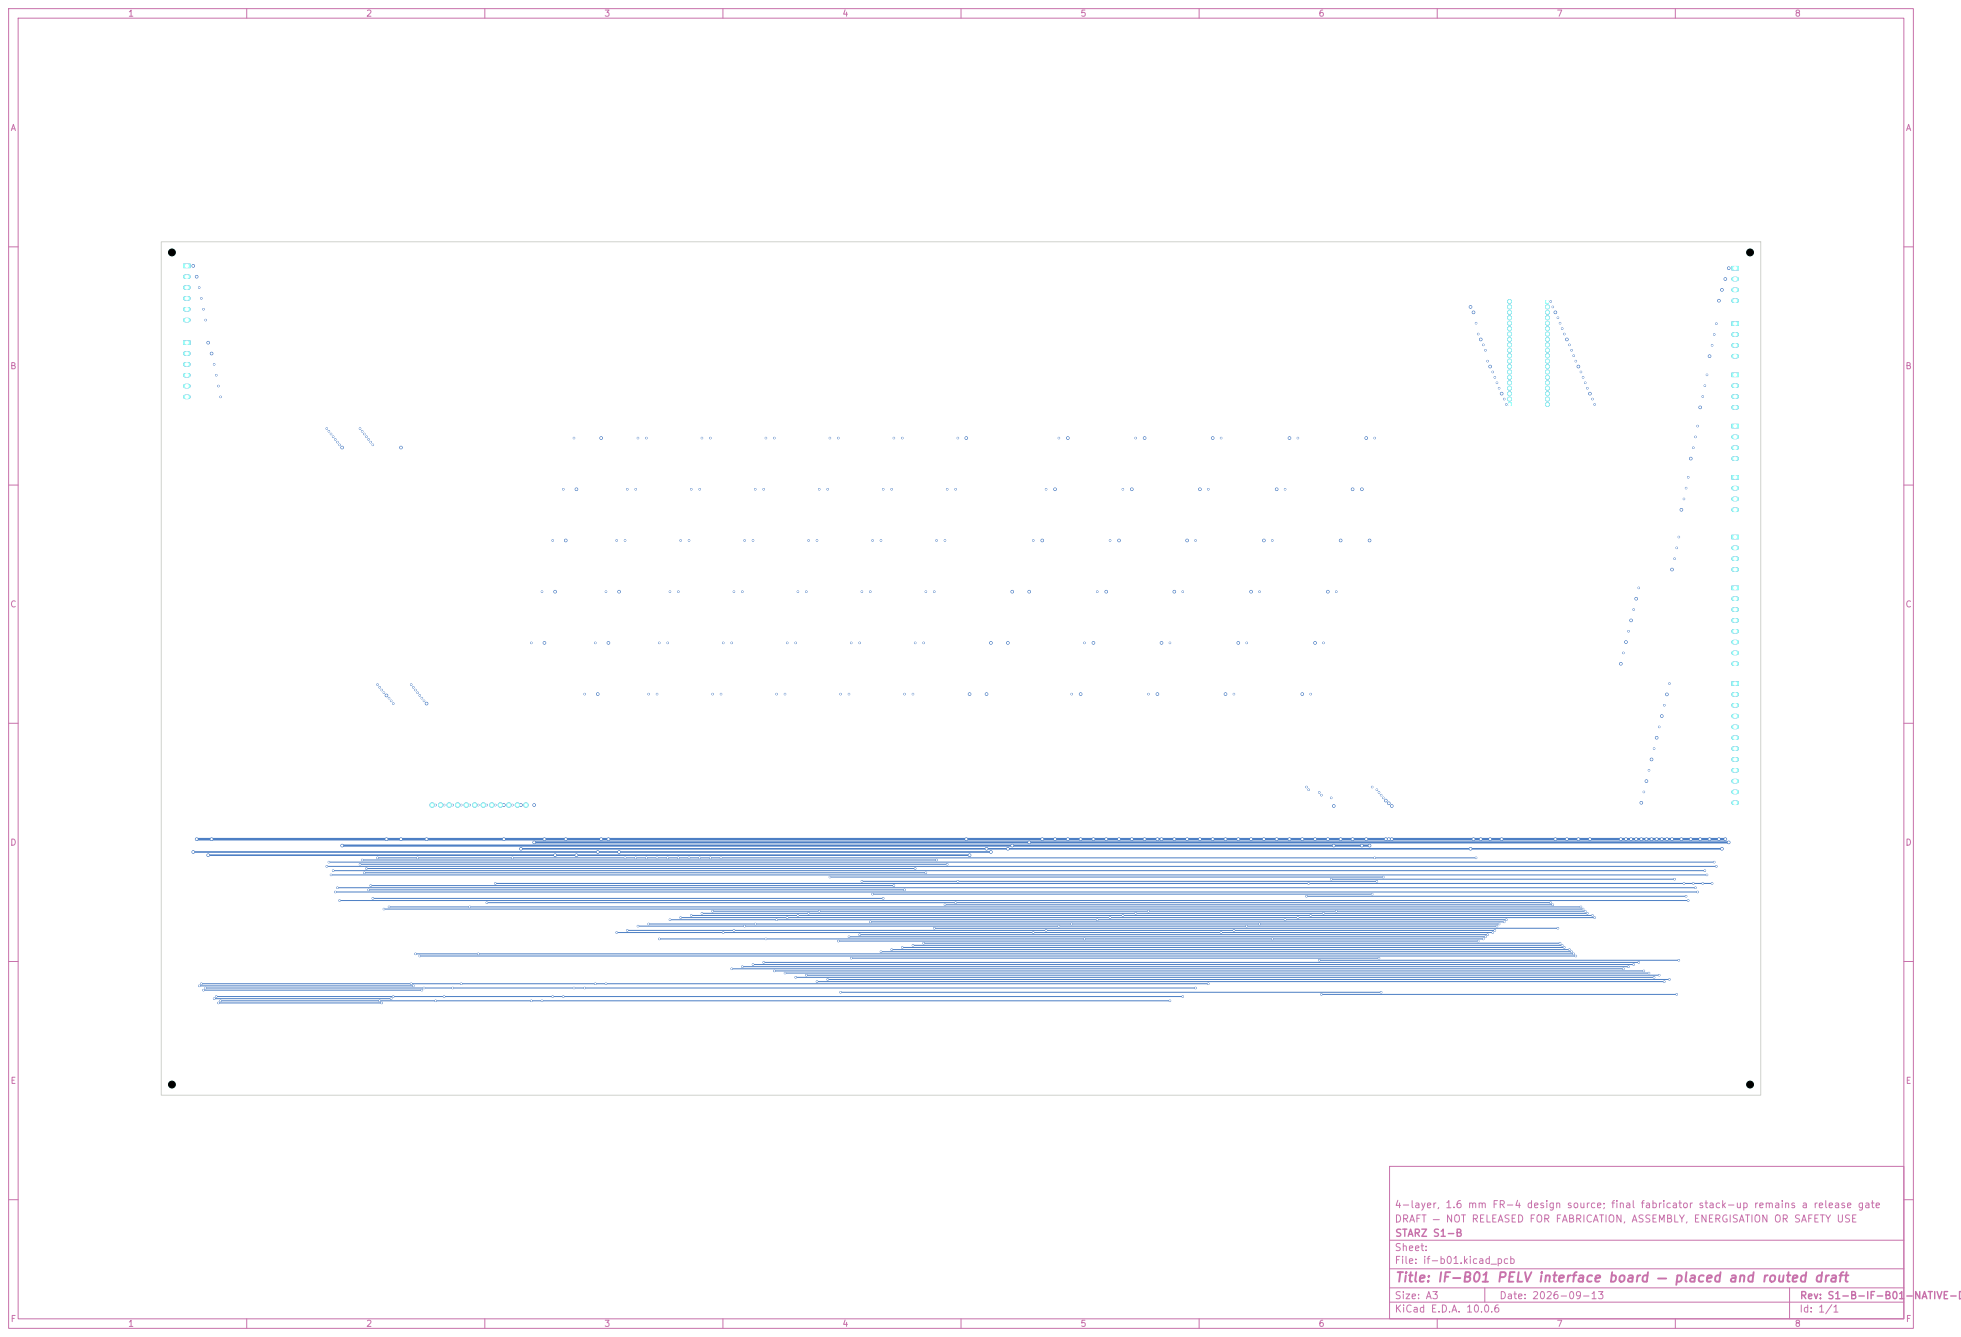
[picture p74: page 1]

4-layer, 1.6 mm FR-4 design source; final fabricator stack-up remains a release gate
DRAFT — NOT RELEASED FOR FABRICATION, ASSEMBLY, ENERGISATION OR SAFETY USE
STARZ S1-B
Sheet:
File: if-b01.kicad_pcb
Title: IF-B01 PELV interface board — placed and routed draft

F Date: 2026-09-13

KiCad E.D.A. 10.0.6 | Id: 1/1
