sbelakho2/Cutting/engineering/sources/34E1K-85.pdf

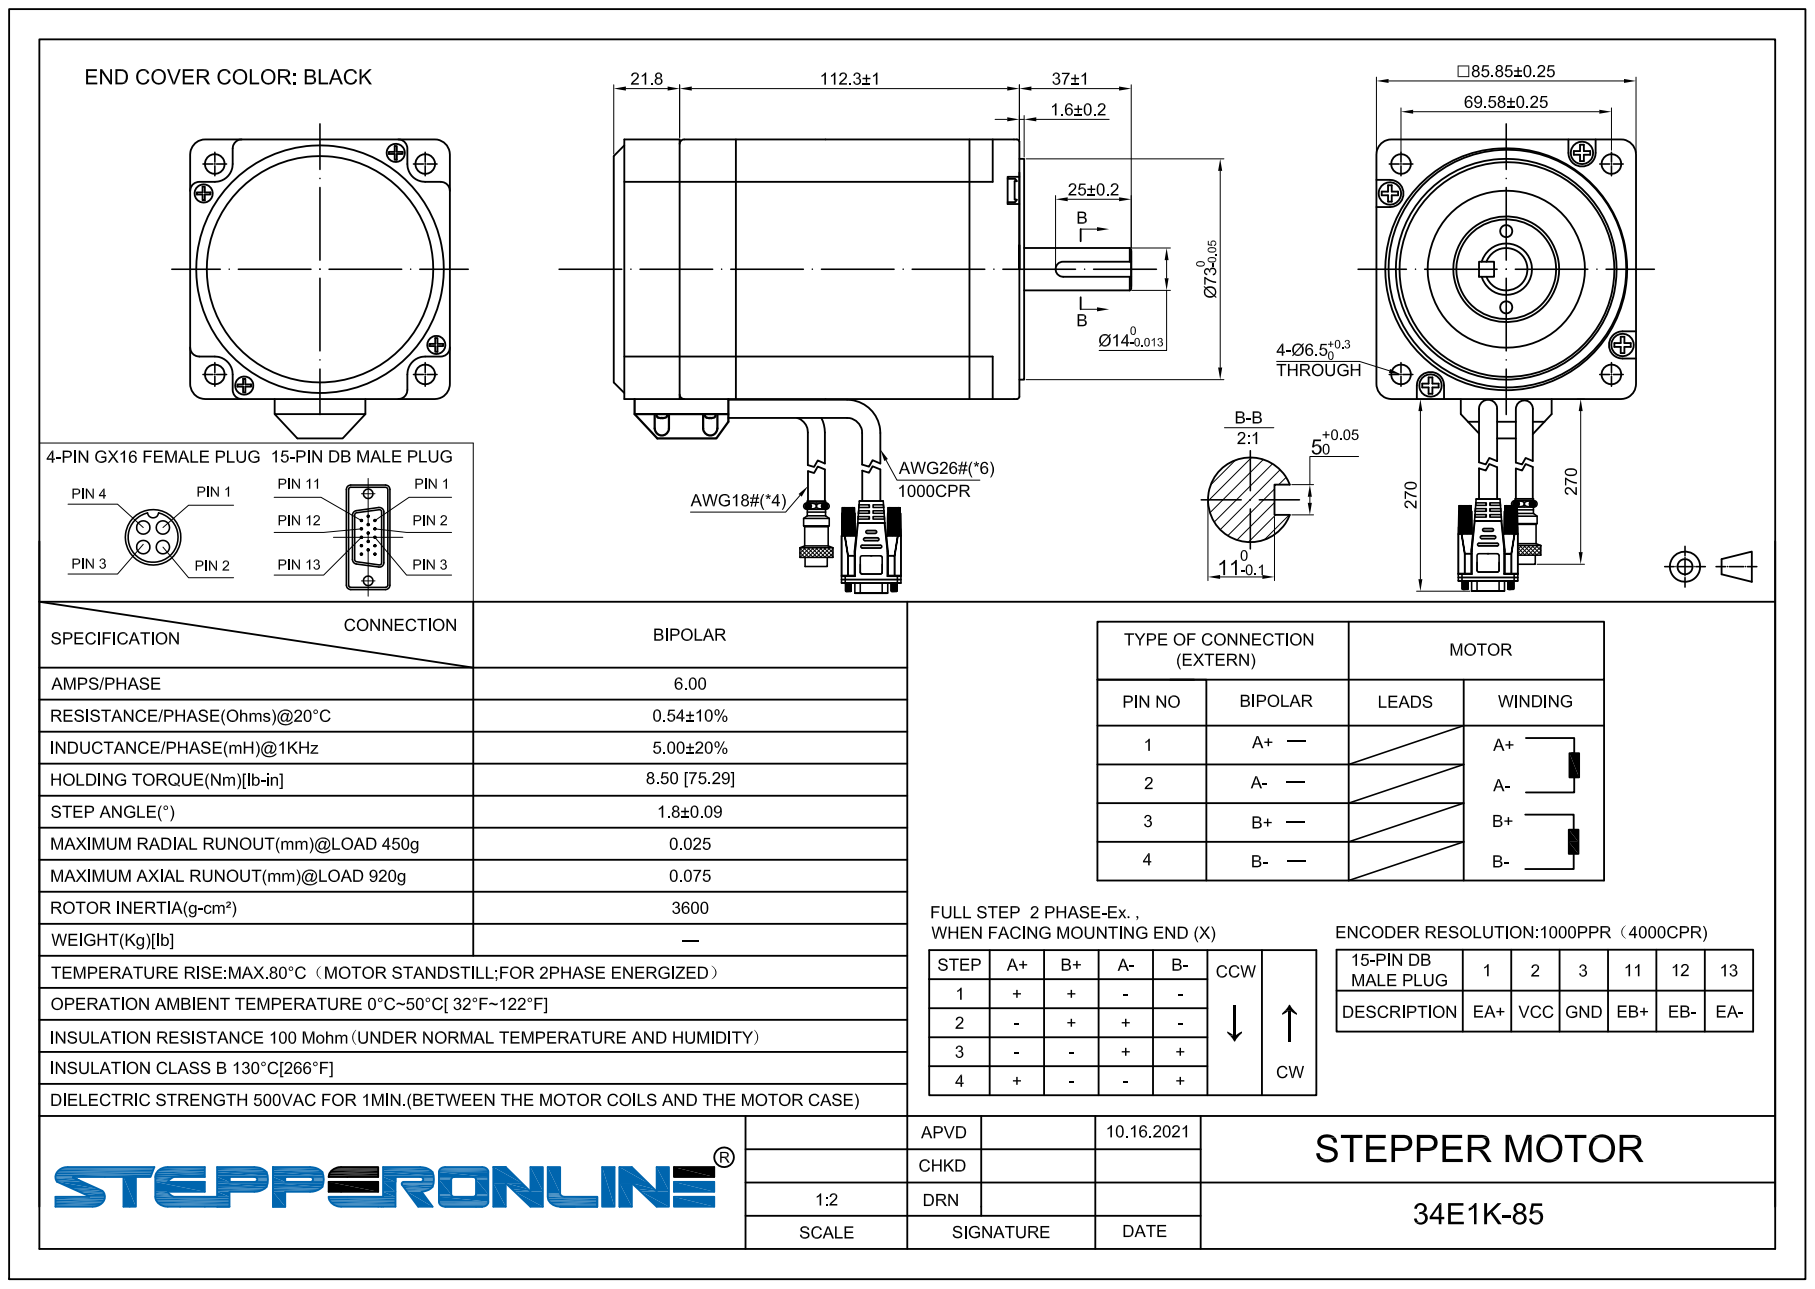
[picture p75: page 1]
