sbelakho2/Cutting/hardware/if-b01/if-b01.kicad_pcb

## KiCad design hardware/if-b01/if-b01.kicad_pcb (2026-10-13)

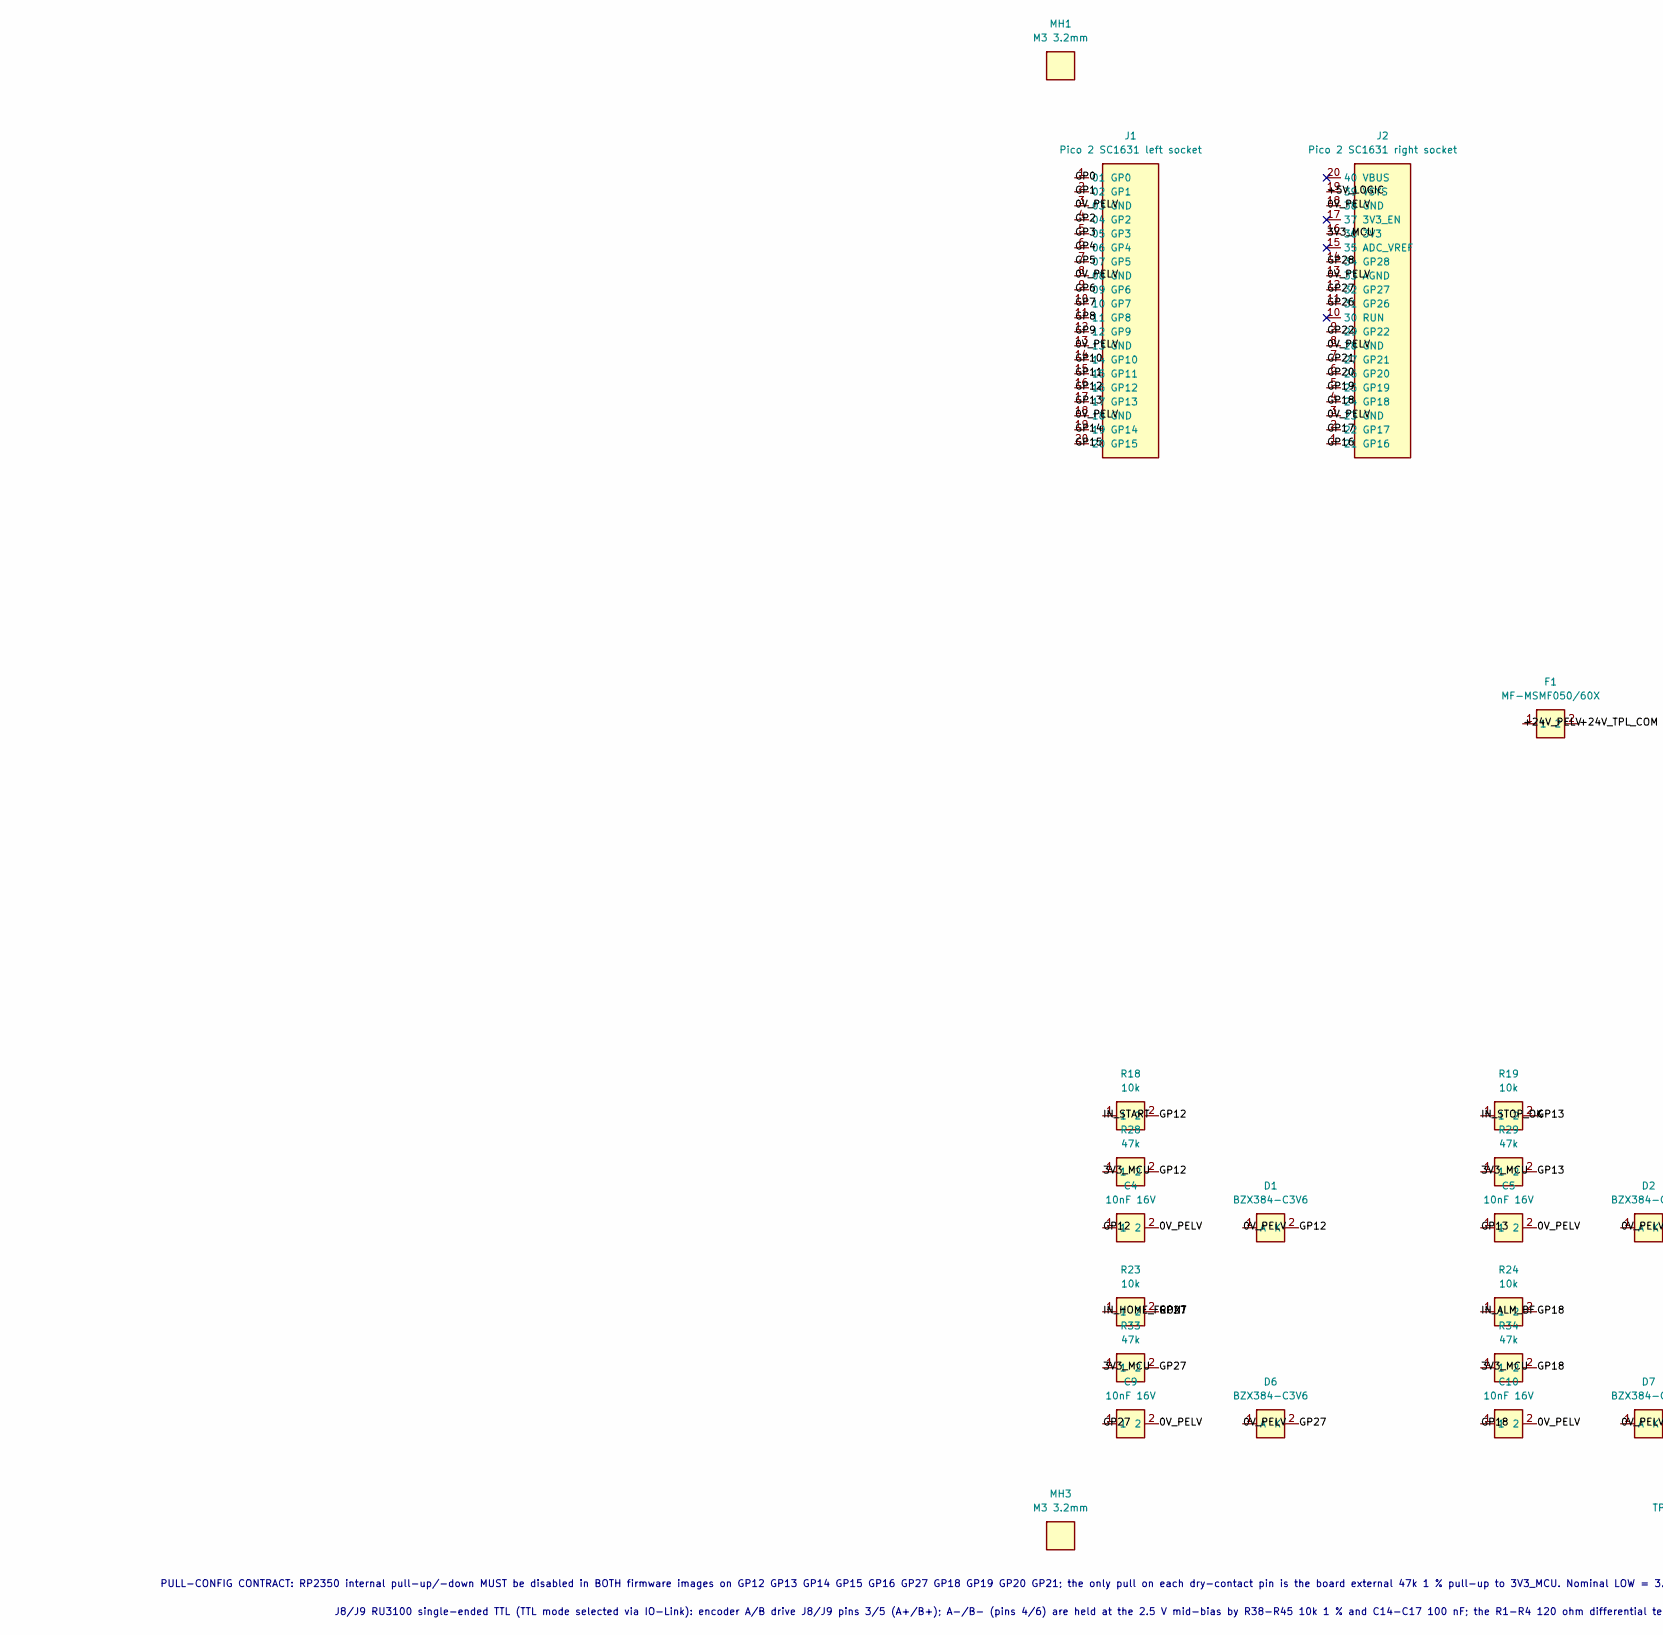
[picture p76: schematic if-b01.kicad_sch, IF-B01 PELV interface board — native logical capture, part in row 1, column 1]

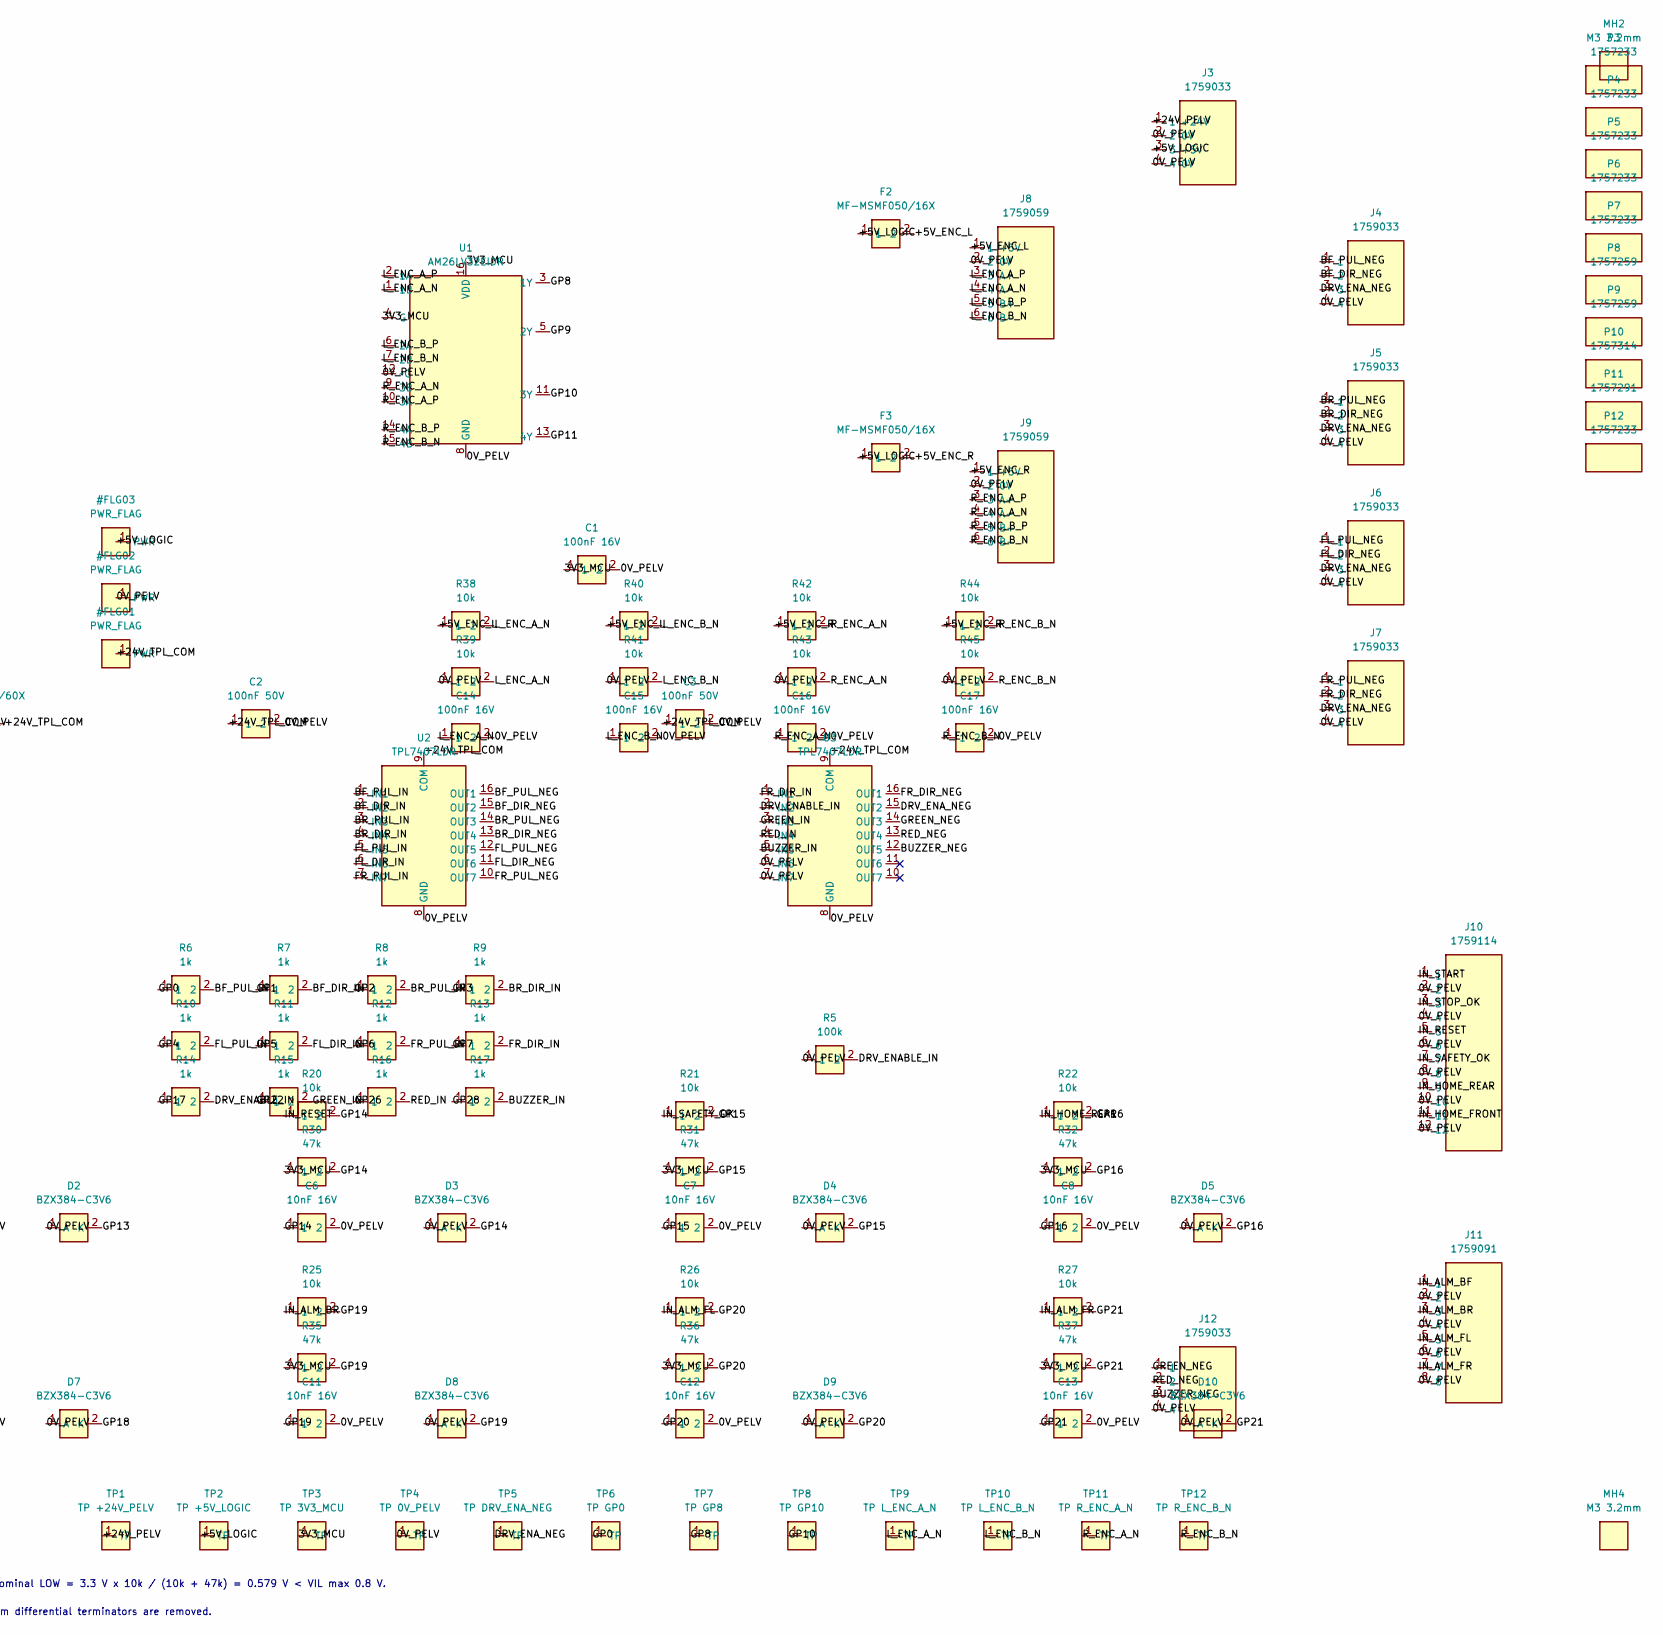
[picture p77: schematic if-b01.kicad_sch, IF-B01 PELV interface board — native logical capture, part in row 1, column 2]

Parts:
C1, C14, C15, C16, C17: 100nF 16V; C_0603_1608; MPN GRM188R71C104KA01D
C2, C3: 100nF 50V; C_0603_1608; MPN GRM188R71H104KA93D
C4, C5, C6, C7, C8, C9, C10, C11, C12, C13: 10nF 16V; C_0603_1608; MPN GRM188R71C103KA01D
D1, D2, D3, D4, D5, D6, D7, D8, D9, D10: BZX384-C3V6; SOD_323; MPN BZX384-C3V6
F1: MF-MSMF050/60X; PTC_1812; MPN MF-MSMF050/60X
F2, F3: MF-MSMF050/16X; PTC_1812; MPN MF-MSMF050/16X
J1: Pico 2 SC1631 left socket; PICO_SOCKET_1X20; MPN SSQ-120-23-G-S
J2: Pico 2 SC1631 right socket; PICO_SOCKET_1X20_RIGHT; MPN SSQ-120-23-G-S
J3, J4, J5, J6, J7, J12: 1759033; MSTB_2_5_4_G_5_08; MPN 1759033
J8, J9: 1759059; MSTB_2_5_6_G_5_08; MPN 1759059
J10: 1759114; MSTB_2_5_12_G_5_08; MPN 1759114
J11: 1759091; MSTB_2_5_8_G_5_08; MPN 1759091
MH1, MH2, MH3, MH4: M3 3.2mm; MountingHole_3_2mm_M3; MPN 9903
P3, P4, P5, P6, P7, P12: 1757233; MPN 1757233
P8, P9: 1757259; MPN 1757259
P10: 1757314; MPN 1757314
P11: 1757291; MPN 1757291
R5: 100k; R_0603_1608; MPN RC0603FR-07100KL
R6, R7, R8, R9, R10, R11, R12, R13, R14, R15, R16, R17: 1k; R_0603_1608; MPN RC0603FR-071KL
R18, R19, R20, R21, R22, R23, R24, R25, R26, R27, R38, R39, R40, R41, R42, R43, R44, R45: 10k; R_0603_1608; MPN RC0603FR-0710KL
R28, R29, R30, R31, R32, R33, R34, R35, R36, R37: 47k; R_0603_1608; MPN RC0603FR-0747KL
TP1: TP +24V_PELV; TestPoint_1_0mm; MPN 5000
TP2: TP +5V_LOGIC; TestPoint_1_0mm; MPN 5000
TP3: TP 3V3_MCU; TestPoint_1_0mm; MPN 5000
TP4: TP 0V_PELV; TestPoint_1_0mm; MPN 5000
TP5: TP DRV_ENA_NEG; TestPoint_1_0mm; MPN 5000
TP6: TP GP0; TestPoint_1_0mm; MPN 5000
TP7: TP GP8; TestPoint_1_0mm; MPN 5000
TP8: TP GP10; TestPoint_1_0mm; MPN 5000
TP9: TP L_ENC_A_N; TestPoint_1_0mm; MPN 5000
TP10: TP L_ENC_B_N; TestPoint_1_0mm; MPN 5000
TP11: TP R_ENC_A_N; TestPoint_1_0mm; MPN 5000
TP12: TP R_ENC_B_N; TestPoint_1_0mm; MPN 5000
U1: AM26LV32EIDR; SOIC_16_3_9x9_9_P1_27; MPN AM26LV32EIDR
U2, U3: TPL7407LDR; SOIC_16_3_9x9_9_P1_27; MPN TPL7407LDR

Connections:
/0V_PELV: C1.2, C2.2, C3.2, C4.2, C5.2, C6.2, C7.2, C8.2, C9.2, C10.2, C11.2, C12.2, C13.2, C14.2, C15.2, C16.2, C17.2, D1.1 (A), D2.1 (A), D3.1 (A), D4.1 (A), D5.1 (A), D6.1 (A), D7.1 (A), D8.1 (A), D9.1 (A), D10.1 (A), J1.3 (03 GND), J1.8 (08 GND), J1.13 (13 GND), J1.18 (18 GND), J2.3 (23 GND), J2.8 (28 GND), J2.13 (33 AGND), J2.18 (38 GND), J3.2 (2 0V), J3.4 (4 0V), J4.4, J5.4, J6.4, J7.4, J8.2 (2 0V), J9.2 (2 0V), J10.2, J10.4, J10.6, J10.8, J10.10, J10.12, J11.2, J11.4, J11.6, J11.8, J12.4, R5.1, R39.1, R41.1, R43.1, R45.1, TP4.1, U1.8 (GND), U1.12 (~G), U2.8 (GND), U3.6 (IN6), U3.7 (IN7), U3.8 (GND)
/3V3_MCU: C1.1, J2.16 (36 3V3), R28.1, R29.1, R30.1, R31.1, R32.1, R33.1, R34.1, R35.1, R36.1, R37.1, TP3.1, U1.4 (G), U1.16 (VDD)
/+5V_ENC_L: F2.2, J8.1 (1 +5V), R38.1, R40.1
/+5V_ENC_R: F3.2, J9.1 (1 +5V), R42.1, R44.1
/+5V_LOGIC: F2.1, F3.1, J2.19 (39 VSYS), J3.3 (3 +5V), TP2.1
/+24V_PELV: F1.1, J3.1 (1 +24V), TP1.1
/+24V_TPL_COM: C2.1, C3.1, F1.2, U2.9 (COM), U3.9 (COM)
/BF_DIR_IN: R7.2, U2.2 (IN2)
/BF_DIR_NEG: J4.2, U2.15 (OUT2)
/BF_PUL_IN: R6.2, U2.1 (IN1)
/BF_PUL_NEG: J4.1, U2.16 (OUT1)
/BR_DIR_IN: R9.2, U2.4 (IN4)
/BR_DIR_NEG: J5.2, U2.13 (OUT4)
/BR_PUL_IN: R8.2, U2.3 (IN3)
/BR_PUL_NEG: J5.1, U2.14 (OUT3)
/BUZZER_IN: R17.2, U3.5 (IN5)
/BUZZER_NEG: J12.3, U3.12 (OUT5)
/DRV_ENABLE_IN: R5.2, R14.2, U3.2 (IN2)
/DRV_ENA_NEG: J4.3, J5.3, J6.3, J7.3, TP5.1, U3.15 (OUT2)
/FL_DIR_IN: R11.2, U2.6 (IN6)
/FL_DIR_NEG: J6.2, U2.11 (OUT6)
/FL_PUL_IN: R10.2, U2.5 (IN5)
/FL_PUL_NEG: J6.1, U2.12 (OUT5)
/FR_DIR_IN: R13.2, U3.1 (IN1)
/FR_DIR_NEG: J7.2, U3.16 (OUT1)
/FR_PUL_IN: R12.2, U2.7 (IN7)
/FR_PUL_NEG: J7.1, U2.10 (OUT7)
/GP0: J1.1 (01 GP0), R6.1, TP6.1
/GP1: J1.2 (02 GP1), R7.1
/GP2: J1.4 (04 GP2), R8.1
/GP3: J1.5 (05 GP3), R9.1
/GP4: J1.6 (06 GP4), R10.1
/GP5: J1.7 (07 GP5), R11.1
/GP6: J1.9 (09 GP6), R12.1
/GP7: J1.10 (10 GP7), R13.1
/GP8: J1.11 (11 GP8), TP7.1, U1.3 (1Y)
/GP9: J1.12 (12 GP9), U1.5 (2Y)
/GP10: J1.14 (14 GP10), TP8.1, U1.11 (3Y)
/GP11: J1.15 (15 GP11), U1.13 (4Y)
/GP12: C4.1, D1.2 (K), J1.16 (16 GP12), R18.2, R28.2
/GP13: C5.1, D2.2 (K), J1.17 (17 GP13), R19.2, R29.2
/GP14: C6.1, D3.2 (K), J1.19 (19 GP14), R20.2, R30.2
/GP15: C7.1, D4.2 (K), J1.20 (20 GP15), R21.2, R31.2
/GP16: C8.1, D5.2 (K), J2.1 (21 GP16), R22.2, R32.2
/GP17: J2.2 (22 GP17), R14.1
/GP18: C10.1, D7.2 (K), J2.4 (24 GP18), R24.2, R34.2
/GP19: C11.1, D8.2 (K), J2.5 (25 GP19), R25.2, R35.2
/GP20: C12.1, D9.2 (K), J2.6 (26 GP20), R26.2, R36.2
/GP21: C13.1, D10.2 (K), J2.7 (27 GP21), R27.2, R37.2
/GP22: J2.9 (29 GP22), R15.1
/GP26: J2.11 (31 GP26), R16.1
/GP27: C9.1, D6.2 (K), J2.12 (32 GP27), R23.2, R33.2
/GP28: J2.14 (34 GP28), R17.1
/GREEN_IN: R15.2, U3.3 (IN3)
/GREEN_NEG: J12.1, U3.14 (OUT3)
/IN_ALM_BF: J11.1, R24.1
/IN_ALM_BR: J11.3, R25.1
/IN_ALM_FL: J11.5, R26.1
/IN_ALM_FR: J11.7, R27.1
/IN_HOME_FRONT: J10.11, R23.1
/IN_HOME_REAR: J10.9, R22.1
/IN_RESET: J10.5, R20.1
/IN_SAFETY_OK: J10.7, R21.1
/IN_START: J10.1, R18.1
/IN_STOP_OK: J10.3, R19.1
/L_ENC_A_N: C14.1, J8.4 (4 A-), R38.2, R39.2, TP9.1, U1.1 (1B)
/L_ENC_A_P: J8.3 (3 A+), U1.2 (1A)
/L_ENC_B_N: C15.1, J8.6 (6 B-), R40.2, R41.2, TP10.1, U1.7 (2B)
/L_ENC_B_P: J8.5 (5 B+), U1.6 (2A)
/RED_IN: R16.2, U3.4 (IN4)
/RED_NEG: J12.2, U3.13 (OUT4)
/R_ENC_A_N: C16.1, J9.4 (4 A-), R42.2, R43.2, TP11.1, U1.9 (3B)
/R_ENC_A_P: J9.3 (3 A+), U1.10 (3A)
/R_ENC_B_N: C17.1, J9.6 (6 B-), R44.2, R45.2, TP12.1, U1.15 (4B)
/R_ENC_B_P: J9.5 (5 B+), U1.14 (4A)

Notes on the sheet:
PULL-CONFIG CONTRACT: RP2350 internal pull-up/-down MUST be disabled in BOTH firmware images on GP12 GP13 GP14 GP15 GP16 GP27 GP18 GP19 GP20 GP21; the only pull on each dry-contact pin is the board external 47k 1 % pull-up to 3V3_MCU. Nominal LOW = 3.3 V x 10k / (10k + 47k) = 0.579 V < VIL max 0.8 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
J8/J9 RU3100 single-ended TTL (TTL mode selected via IO-Link): encoder A/B drive J8/J9 pins 3/5 (A+/B+); A-/B- (pins 4/6) are held at the 2.5 V mid-bias by R38-R45 10k 1 % and C14-C17 100 nF; the R1-R4 120 ohm differential terminators are removed.

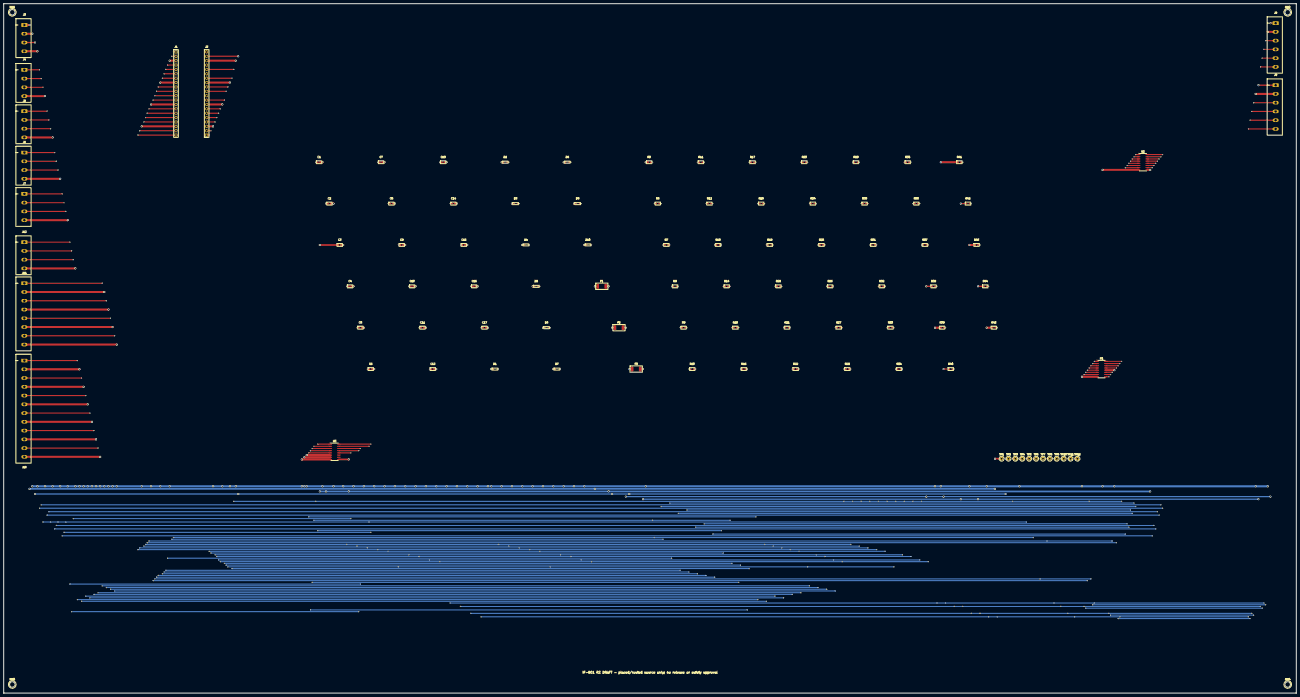
[picture p78: board if-b01.kicad_pcb from above]

Board: 4 copper layers, 750.0 x 400.0 mm, 102 parts (0 on the bottom side), 75 nets.
