sbelakho2/Cutting/engineering/src/fabrication_drawings.cpp

#include "shared/cutting_head_spec.hpp"
#include "shared/feed_drive_spec.hpp"
#include "shared/measurement_spec.hpp"
#include "shared/mechanism_spec.hpp"
#include <QGuiApplication>
#include <QPainter>
#include <QPdfWriter>
#include <QPageSize>
#include <QSvgRenderer>
#include <array>
#include <cmath>
#include <filesystem>
#include <fstream>
#include <iomanip>
#include <iostream>
#include <numbers>
#include <sstream>
#include <stdexcept>

namespace fs=std::filesystem;
namespace d=starz::head::design;
namespace c=starz::head::catalogue;
namespace md=starz::mechanism::design;
namespace {
void text(std::ostream& s,double x,double y,const std::string& value,double size=3.1) {
    s<<"<text x='"<<x<<"' y='"<<y<<"' font-size='"<<size<<"'>"<<value<<"</text>\n";
}
void line(std::ostream& s,double x1,double y1,double x2,double y2,const char* css="edge") {
    s<<"<line class='"<<css<<"' x1='"<<x1<<"' y1='"<<y1<<"' x2='"<<x2<<"' y2='"<<y2<<"'/>\n";
}
void circle(std::ostream& s,double x,double y,double r,const char* css="edge") {
    s<<"<circle class='"<<css<<"' cx='"<<x<<"' cy='"<<y<<"' r='"<<r<<"'/>\n";
}
void dimension(std::ostream& s,double a,double b,double base,double at,const std::string& label) {
    line(s,a,base,a,at+2,"dim");line(s,b,base,b,at+2,"dim");
    s<<"<path class='dim' marker-start='url(#arrow)' marker-end='url(#arrow)' d='M"<<a<<' '<<at<<" H"<<b<<"'/>\n";
    text(s,(a+b)/2-12,at-1.4,label);
}
void begin(std::ostream& s,const std::string& title="H003 — CUTTING MOTOR ADAPTER / R6") {
    s<<"<svg xmlns='http://www.w3.org/2000/svg' width='420mm' height='297mm' viewBox='0 0 420 297'>\n"
      <<"<defs><marker id='arrow' markerWidth='5' markerHeight='5' refX='2.5' refY='2.5' orient='auto-start-reverse'><path d='M5 0 L0 2.5 L5 5' fill='none' stroke='#111' stroke-width='.5'/></marker></defs>\n"
      <<"<style>text{font-family:DejaVu Sans,Arial,sans-serif;fill:#111}.edge{fill:none;stroke:#111;stroke-width:.35}.dim{fill:none;stroke:#444;stroke-width:.18}.centre{fill:none;stroke:#888;stroke-width:.16;stroke-dasharray:4 1 1 1}</style>\n"
      <<"<rect width='420' height='297' fill='white'/><rect class='edge' x='8' y='8' width='404' height='281'/>\n";
    text(s,14,20,"STARZ ELECTRONICS",7);
    text(s,14,28,title,4.5);
    text(s,250,18,"ENGINEERING DRAWING — RELEASE HOLD",4);
    text(s,250,25,"Units mm · A3 · Do not scale dimensions",3);
}
void adapter(const fs::path& out) {
    const auto path=out/"H003-R6-adapter.svg";std::ofstream s(path);
    s<<std::setprecision(10);begin(s);
    const double x=85,y=105,q=35/std::sqrt(2.0);
    s<<"<rect class='edge' x='35' y='55' width='100' height='100'/>\n";
    circle(s,x,y,21);circle(s,x,y,d::adapter_motor_pilot_diameter/2);
    circle(s,x,y,d::adapter_f0_register_diameter/2,"centre");
    circle(s,x,y,35,"centre");line(s,27,y,143,y,"centre");line(s,x,47,x,163,"centre");
    for(double a:{-q,q})for(double b:{-q,q}){circle(s,x+a,y+b,2.75);circle(s,x+a,y+b,4.75);}
    for(double a:{-c::motor_pitch/2,c::motor_pitch/2})for(double b:{-c::motor_pitch/2,c::motor_pitch/2})circle(s,x+a,y+b,2.1);
    dimension(s,35,135,155,168,"100.00 ±0.05");
    dimension(s,x-c::motor_pitch/2,x+c::motor_pitch/2,55,45,"69.58 BASIC");
    text(s,39,180,"MOTOR-SIDE VIEW / 1:1",3.5);
    text(s,17,190,"4 × M5×0.8-6H THRU; square69.58 BASIC; position Ø0.10 to A|B|C");
    text(s,17,197,"4 × Ø5.50 +0.10/0 THRU on PCD70 BASIC,45° quadrants");
    text(s,17,204,"Counterbore Ø9.50 +0.10/0 ×8.50 ±0.05 deep FROM MOTOR FACE");
    text(s,17,211,"Pilot pocket Ø73.10 +0.02/0 ×2.10 ±0.02 deep;central Ø42.00 +0.10/0");

    // Axial section: motor face left, F0 face right. Radial coordinate shown
    // above/below centreline. Draw the actual15mm plate and2mm F0 boss.
    const double sx=210,cy=105,t=d::adapter_thickness;
    const auto step=[&](double r1,double r2,double depth) {
        s<<"<path class='edge' d='M"<<sx<<' '<<cy-r2<<" H"<<sx+depth<<" V"<<cy-r1<<" H"<<sx+t<<" M"<<sx<<' '<<cy+r2<<" H"<<sx+depth<<" V"<<cy+r1<<" H"<<sx+t<<"'/>\n";
    };
    line(s,sx,55,sx,cy-d::adapter_motor_pilot_diameter/2);line(s,sx,cy+d::adapter_motor_pilot_diameter/2,sx,155);
    line(s,sx,55,sx+t,55);line(s,sx,155,sx+t,155);
    line(s,sx+t,55,sx+t,cy-d::adapter_f0_register_diameter/2);
    line(s,sx+t,cy+d::adapter_f0_register_diameter/2,sx+t,155);
    step(21,d::adapter_motor_pilot_diameter/2,d::adapter_motor_pilot_depth);
    s<<"<path class='edge' d='M"<<sx+t<<' '<<cy-d::adapter_f0_register_diameter/2<<" H"<<sx+t+2<<" V"<<cy-21<<" H"<<sx+t
      <<" M"<<sx+t<<' '<<cy+21<<" H"<<sx+t+2<<" V"<<cy+d::adapter_f0_register_diameter/2<<" H"<<sx+t<<"'/>\n";
    line(s,197,cy,245,cy,"centre");dimension(s,sx,sx+t,155,168,"15.00 ±0.02");
    text(s,193,180,"AXIAL SECTION / 1:1",3.5);
    text(s,258,57,"DATUM A: F0 mounting face");
    text(s,258,64,"DATUM B: Ø49.97 F0 register axis");
    text(s,258,71,"DATUM C: left edge X−50 in this view");
    text(s,258,82,"F0 boss: Ø49.97 ±0.01 ×2.00 ±0.02");
    text(s,258,89,"A flatness0.01;motor face parallel0.01 to A");
    text(s,258,96,"Pilot pocket position Ø0.03 to A|B");
    text(s,258,103,"Mounting/pilot surfaces Ra0.8µm");
    text(s,258,110,"Other machined surfaces Ra3.2µm");
    text(s,258,121,"Material42CrMo4+QT,min650MPa yield");
    text(s,258,128,"Rough stock105×105×20;quantity2");
    text(s,258,135,"No paint/plating on locating or joint faces");
    text(s,258,146,"General edges0.2×45°;remove all burrs");
    text(s,258,153,"Do not countersink screw bearing seats");
    text(s,258,166,"F0:4 ×ISO4762 M5×16,class10.9");
    text(s,258,173,"withISO7092 M5 washers Ø9×1,200HV");
    text(s,258,180,"Motor:4 ×M5×25,class10.9,same washers");
    text(s,258,191,"Counterbore depth clears the motor pilot");
    text(s,258,198,"Old5.5mm recess FAILS screw-head collision");
    text(s,258,209,"Joint preload and peak convergence open");
    line(s,8,222,412,222);
    text(s,14,231,"PROCESS: rough all features;finish A and motor face in controlled setups;finish concentric registers;drill/tap;deburr;inspect.");
    text(s,14,239,"INSPECT: thickness at4corners;A/face flatness;both register diameters;pilot depth;counterbore depths;hole position;M5thread gauges.");
    text(s,14,247,"ASSEMBLY: remove motor key;use actual free-length coupling;set stage hub1.00±0.05from locknut shoulder;do not stretch bellows.");
    text(s,14,255,"Release hold: updated adapter stress/convergence,joint/thread checks,and remaining full-machine integration. Drawing is not a release stamp.");
    line(s,8,264,412,264);line(s,235,264,235,289);
    text(s,14,274,"PART H003 · ADAPTER · SINGLE SELECTED DESIGN",4);
    text(s,14,282,starz::head::revision,3.2);
    text(s,241,274,"SCALE1:1 / THIRD-ANGLE FRONT + AXIAL SECTION",3);
    text(s,241,282,"SOURCE: shared cutting_head_spec and catalogue evidence",3);
    s<<"</svg>\n";s.close();if(!s)throw std::runtime_error("Drawing SVG output failed");
    QSvgRenderer renderer(QString::fromStdString(path.string()));
    if(!renderer.isValid())throw std::runtime_error("Generated drawing SVG invalid");
    QPdfWriter pdf(QString::fromStdString((out/"H003-R6-adapter.pdf").string()));
    pdf.setPageSize(QPageSize(QPageSize::A3));pdf.setPageOrientation(QPageLayout::Landscape);
    pdf.setPageMargins(QMarginsF(0,0,0,0));pdf.setResolution(300);
    pdf.setTitle("STARZ H003 R6 adapter — engineering drawing,release hold");
    QPainter painter(&pdf);if(!painter.isActive())throw std::runtime_error("Drawing PDF output failed");
    renderer.render(&painter,QRectF(0,0,pdf.width(),pdf.height()));painter.end();
    // Inline SVG inside an HTML document also makes browser review accessible;
    // standalone SVG documents have no body element in some editor webviews.
    std::ifstream drawing(path);std::ofstream review(out/"index.html");
    review<<"<!doctype html><html lang='en'><meta charset='utf-8'><title>STARZ H003 drawing review</title>"
          <<"<style>body{margin:24px;background:#e5e7eb;font-family:Arial,sans-serif;color:#0b0f14}"
          <<"header{display:flex;gap:24px;align-items:center;margin-bottom:16px}h1{font-size:20px}"
          <<"a{color:#b00020}svg{display:block;width:100%;height:auto;background:white;box-shadow:0 2px 12px #0002}</style>"
          <<"<body><header><h1>STARZ · H003 R6 adapter</h1><a href='H003-R6-adapter.pdf'>A3 vector PDF</a>"
          <<"<span>Engineering drawing · release hold</span></header>"<<drawing.rdbuf()<<"</body></html>";
    if(!drawing||!review)throw std::runtime_error("Drawing review output failed");
}
void shaft(const fs::path& out) {
    const auto path=out/"F101-R6-shaft.svg";std::ofstream s(path);
    s<<std::setprecision(10);begin(s,"F101 — FEED ROTOR SHAFT / R6 · SHEET1/2");
    // Orthographic side profile,2:1 onA3;S increases to the right,+Z upwards.
    constexpr double x0=25,y0=81,k=2;
    const std::array<std::array<double,3>,9> turns{{{0,18.5,12},{18.5,19.62,11.45},{19.62,31.5,12},
        {31.5,64.5,14},{64.5,71.5,15},{71.5,73,13.5},{73,82,15},{82,87,19},{87,92,12}}};
    double last_r=0;
    for(const auto& q:turns) {
        const double a=x0+k*q[0],b=x0+k*q[1],r=k*q[2]/2;
        const double lead=(q[0]==0?0.2:(q[0]==64.5?0.5:0));
        for(int sign:{-1,1}) {
            line(s,a+k*lead,y0+sign*r,b,y0+sign*r);
            if(lead>0) {
                line(s,a,y0+sign*(r-k*lead),a+k*lead,y0+sign*r);
                line(s,a,y0+sign*last_r,a,y0+sign*(r-k*lead));
            }else line(s,a,y0+sign*last_r,a,y0+sign*r);
        }
        last_r=r;
    }
    line(s,x0+k*92,y0-last_r,x0+k*92,y0-10);line(s,x0+k*92,y0+last_r,x0+k*92,y0+10);
    for(int sign:{-1,1}) {
        line(s,x0+k*92,y0+sign*10,x0+k*112.8,y0+sign*10);
        line(s,x0+k*112.8,y0+sign*10,x0+k*113,y0+sign*9.6);
    }
    line(s,x0+k*113,y0-9.6,x0+k*113,y0+9.6);line(s,18,y0,260,y0,"centre");
    // Key-seat floor and drilled-hole detail;small radii governed by callouts.
    line(s,x0+k*33.45,y0-8,x0+k*61.55,y0-8);
    line(s,x0+k*94.45,y0+6.4,x0+k*112.55,y0+6.4);
    line(s,x0+k*31.2,y0-11,x0+k*73,y0-11,"centre");
    for(int sign:{-1,1}) {
        line(s,x0+k*95,y0+sign*4.2,x0+k*98.8,y0+sign*4.2,"centre");
        line(s,x0+k*98.8,y0+sign*5,x0+k*113,y0+sign*5,"centre");
        line(s,x0+k*95,y0+sign*4.2,x0+k*(95-2.1/std::tan(59*std::numbers::pi/180)),y0,"centre");
    }
    dimension(s,x0,x0+k*113,y0+19,114,"113.00 ±0.02");
    text(s,23,126,"SIDE VIEW / 2:1 · S from rear end · small root radii per callouts",3);
    text(s,275,46,"S interval       Diameter / thread",3.4);
    const std::array<std::string,10> sizes{{"0–18.5           Ø12 h6","18.5–19.62    groove Ø11.45 ±0.02",
        "19.62–31.5    Ø12 matched j5","31.5–64.5      Ø14 h6","64.5–71.5      M15×1-6g","71.5–73         relief Ø13.50 ±0.02",
        "73–82             Ø15 matched j5","82–87             Ø19 ±0.02","87–92             Ø12 −0.02/0","92–113           Ø10 h6"}};
    for(std::size_t i=0;i<sizes.size();++i)text(s,275,54+7*static_cast<double>(i),sizes[i]);
    text(s,17,139,"DATUM A: common bearing-seat axis. DATUM B: front bearing shoulder S82.",3.4);
    text(s,17,147,"Bearing seats: j5 −0.003/+0.005 AND 0.003–0.006 actual interference to assigned SKF P6 bore.");
    text(s,17,154,"12 h6 /14 h6: −0.011/0;10 h6: −0.009/0. Match-bearing table governs final seat diameters.");
    text(s,17,161,"Bearing-seat cylindricity0.001,total radial runout0.002 to A;B perpendicularity0.004 to A.");
    text(s,17,168,"Ø14/Ø10 total runout0.010 to A. Bearing seats Ra0.4µm;roller/coupling0.8µm;other surfaces3.2µm.");
    text(s,17,177,"PULLEY KEY: S33.45–61.55,L28.10±0.02,W5.04±0.01,on+Z;floorZ4.00±0.02;endsR2.52.",2.8);
    text(s,17,183,"ROLLER KEY: S94.45–112.55,L18.10±0.02,W3.04±0.01,on−Z;floorZ−3.20±0.02;endsR1.52.",2.8);
    text(s,17,189,"Both key-floor perimeters R0.15±0.02;matching keys:shaft-facing perimeter0.20±0.02×45°.",2.8);
    text(s,17,195,"MB2 SLOT: S31.20–73.00,W4.20±0.05,on+Z;floorZ5.50±0.05;R0.50plan/intersections,R0.15floor. See sheet2.",2.6);
    text(s,17,201,"GROOVE: S18.50±0.02,W1.12±0.02,Ø11.45±0.02;both rootsR0.04±0.01;SEEGER A12.",2.8);
    text(s,17,207,"SHOULDERS: S31.5/S82/S92 R0.20±0.02;S87 R0.50±0.05;M15 relief rootsR0.20±0.02.",2.8);
    text(s,17,213,"END TAP: M5×0.8-6H,14.00–14.05full thread AFTER C0.20±0.02;drillØ4.20+0.03/0×18.00±0.05 PLUS118°±2° point.",2.6);
    line(s,8,218,412,218);
    text(s,17,228,"Material42CrMo4+QT,certified yield≥650MPa;rough stockØ20×120;quantity8. General axial coordinates±0.02.");
    text(s,17,236,"ENDS: external C0.20±0.02 at S0/S113;M15 lead C0.50±0.02. Full-profile M15 thread required over S65.10–71.30.",2.8);
    text(s,17,244,"ASSEMBLY: fit MB2 BEFORE pulley key. Keep F112 removable;insert preassembled rotor from+S with locating dowels removed.");
    text(s,17,252,"RELEASE HOLD: local stress/contact,thermal-field validation and joint preload. R6 edge geometry is defined on both sheets.");
    line(s,8,264,412,264);line(s,235,264,235,289);
    text(s,14,274,"PART F101 · FEED ROTOR · SHAFT",4);
    text(s,14,282,std::string(starz::feed::revision),3.2);
    text(s,241,274,"SCALE2:1 / DIMENSION RECORD / NO RELEASE STAMP",3);
    text(s,241,282,"Companion: feed cartridge assembly and bearing matching record",2.8);
    s<<"</svg>\n";s.close();if(!s)throw std::runtime_error("Shaft SVG output failed");
    QSvgRenderer renderer(QString::fromStdString(path.string()));if(!renderer.isValid())throw std::runtime_error("Shaft SVG invalid");
    QPdfWriter pdf(QString::fromStdString((out/"F101-R6-shaft.pdf").string()));
    pdf.setPageSize(QPageSize(QPageSize::A3));pdf.setPageOrientation(QPageLayout::Landscape);pdf.setPageMargins(QMarginsF(0,0,0,0));pdf.setResolution(300);
    pdf.setTitle("STARZ F101 R6 shaft — sheet1 of2,release hold");
    QPainter painter(&pdf);if(!painter.isActive())throw std::runtime_error("Shaft PDF failed");
    renderer.render(&painter,QRectF(0,0,pdf.width(),pdf.height()));painter.end();
    std::ifstream drawing(path);std::ofstream review(out/"shaft-review.html");
    review<<"<!doctype html><html lang='en'><meta charset='utf-8'><title>STARZ F101 drawing review</title>"
          <<"<style>body{margin:24px;background:#e5e7eb;font-family:Arial,sans-serif}svg{width:100%;height:auto;background:white}</style>"
          <<"<body><h1>F101 R6 shaft dimension record</h1><p><a href='F101-R6-shaft.pdf'>A3 sheet1 PDF</a> · <a href='F101-R6-details.pdf'>A3 sheet2 PDF</a> · <a href='shaft-details-review.html'>Machining detail review</a> · Engineering release hold</p>"
          <<drawing.rdbuf()<<"</body></html>";
    if(!drawing||!review)throw std::runtime_error("Shaft review output failed");
}
void shaftDetails(const fs::path& out) {
        namespace f=starz::feed::design;
        const auto path=out/"F101-R6-details.svg";std::ofstream s(path);
        s<<std::setprecision(10);begin(s,"F101 — SLOT / END MACHINING DETAILS · R6 · SHEET2/2");
        // Analytic constant-height outline of the two-pocket union at Z6.2.
        // The R.5 intersection centres are the intersection of the offset straight
        // wall and the key-end circle offset by the same radius; no polyline fit.
        constexpr double k=5,x0=24,y0=80,keyR=2.52,keyNear=35.97,keyFar=59.03;
        const double half=f::washer_slot_width/2,r=f::washer_slot_intersection_radius;
        const double off=std::sqrt(std::pow(keyR+r,2)-std::pow(half+r,2));
        const double near=keyNear-off,far=keyFar+off;
        const double contactX=(half+r)*keyR/(keyR+r),contactNear=keyNear-off*keyR/(keyR+r),contactFar=keyFar+off*keyR/(keyR+r);
        const auto px=[&](double station){return x0+k*(station-30);};
        const auto py=[&](double transverse){return y0-k*transverse;};
        s<<"<path class='edge' d='M"<<px(31.7)<<' '<<py(half);
        const auto go=[&](double station,double x){s<<" L"<<px(station)<<' '<<py(x);};
        const auto arc=[&](double radius,int sweep,double station,double x){s<<" A"<<k*radius<<' '<<k*radius<<" 0 0 "<<sweep<<' '<<px(station)<<' '<<py(x);};
        go(near,half);arc(r,0,contactNear,contactX);arc(keyR,1,keyNear,keyR);go(keyFar,keyR);
        arc(keyR,1,contactFar,contactX);arc(r,0,far,half);go(72.5,half);arc(0.5,1,73,1.6);go(73,-1.6);arc(0.5,1,72.5,-half);
        go(far,-half);arc(r,0,contactFar,-contactX);arc(keyR,1,keyFar,-keyR);go(keyNear,-keyR);
        arc(keyR,1,contactNear,-contactX);arc(r,0,near,-half);go(31.7,-half);arc(0.5,1,31.2,-1.6);go(31.2,1.6);arc(0.5,1,31.7,half);
        s<<" Z'/>\n";
        line(s,px(30.5),y0,px(74),y0,"centre");
        for(double station:{31.2,33.45,61.55,73.0})line(s,px(station),102,px(station),116,"dim");
        text(s,px(31.2)-9,124,"S31.20",2.8);text(s,px(33.45)-3,115,"S33.45",2.8);
        text(s,px(61.55)-9,115,"S61.55",2.8);text(s,px(73)-9,124,"S73.00",2.8);
        text(s,24,47,"POCKET TOOL SECTION Z6.20 / 5:1 · S increases right",3.1);
        text(s,24,137,"Near/far intersection coordinates are REF;nominal key circles R2.52,centres S35.97/59.03.",2.7);
        text(s,268,48,"MB2 slot: W4.20±0.05",3.1);
        text(s,268,56,"Start S31.20±0.02;end S73.00±0.02");
        text(s,268,64,"Four plan corners R0.50±0.02");
        text(s,268,72,"Four vertical key intersections R0.50±0.02");
        text(s,268,80,"All slot floor/lip blends R0.15±0.02");
        text(s,268,88,"Floor Z5.50±0.05;key floor Z4.00±0.02");
        text(s,268,100,"Do not round the key's straight load flanks");
        text(s,268,108,"End0.00–0.04 before actual Ø15 seat start");
        text(s,268,116,"Fit MB2 before the pulley key");
        text(s,268,124,"Rear entry is interrupted by the Ø12 land");
        line(s,8,145,412,145);
        // Enlarged local slot-floor section. The cylinder crown is deliberately
        // outside this local detail; the floor and side-wall radii are dimensional.
        constexpr double cx=74,base=192,q=10;
        s<<"<path class='edge' d='M"<<cx-q*half<<" 163 V"<<base-q*0.15
            <<" A1.5 1.5 0 0 0 "<<cx-q*(half-0.15)<<' '<<base<<" H"<<cx+q*(half-0.15)
            <<" A1.5 1.5 0 0 0 "<<cx+q*half<<' '<<base-q*0.15<<" V163'/>\n";
        line(s,36,base,113,base,"centre");
        dimension(s,cx-q*half,cx+q*half,163,156,"4.20 ±0.05");
        text(s,28,203,"S70 LOCAL FLOOR SECTION / 10:1",3);
        text(s,28,211,"Z5.50±0.05 · R0.15±0.02 both roots",3);
        text(s,144,156,"END / THREAD / FINISH REQUIREMENTS",3.4);
        text(s,144,166,"S0 and S113 external edges: 0.20±0.02×45°.");
        text(s,144,175,"M15 lead at S64.50: 0.50±0.02×45°;full profile S65.10–71.30.");
        text(s,144,184,"M5 entry: C0.20±0.02,independent of the external end chamfer.");
        text(s,144,193,"Final slot/key machining precedes matched journal finishing.");
        text(s,144,202,"Remove raised lips;edge break0.05–0.10 on remaining slot openings.");
        text(s,144,211,"Do not touch bearing-seat lands or dimensional key load flanks.");
        line(s,8,220,412,220);
        text(s,14,231,"INSPECT: optical profile/replica of slot roots and intersections;slot start/end/width/depth;end chamfers;thread GO/NO-GO and full depth.",2.8);
        text(s,14,239,"SECTION AUDIT:191 nominal B-rep sections compared against the reduced beam I;this does not resolve local peak stress or fatigue.",2.8);
        text(s,14,247,"Angular C:pulley-key radial midplane,+Z toward opening. Roller key180°±0.10°;MB2 slot median offset≤0.025 to C.",2.8);
        text(s,14,255,"RELEASE HOLD: local stress/contact,joint preload and operating thermal field. No machining or physical inspection result is prefilled.",2.8);
        line(s,8,264,412,264);line(s,235,264,235,289);
        text(s,14,274,"PART F101 · FEED ROTOR · DETAIL SHEET",4);
        text(s,14,282,std::string(starz::feed::revision),3.2);
        text(s,241,274,"SCALES5:1 /10:1 · SHEET2 OF2",3);
        text(s,241,282,"All unspecified axial coordinates ±0.02 · do not scale",3);
        s<<"</svg>\n";s.close();if(!s)throw std::runtime_error("Shaft detail SVG output failed");
        QSvgRenderer renderer(QString::fromStdString(path.string()));if(!renderer.isValid())throw std::runtime_error("Shaft detail SVG invalid");
        QPdfWriter pdf(QString::fromStdString((out/"F101-R6-details.pdf").string()));
        pdf.setPageSize(QPageSize(QPageSize::A3));pdf.setPageOrientation(QPageLayout::Landscape);pdf.setPageMargins(QMarginsF(0,0,0,0));pdf.setResolution(300);
        pdf.setTitle("STARZ F101 R6 machining details — sheet2 of2,release hold");
        QPainter painter(&pdf);if(!painter.isActive())throw std::runtime_error("Shaft detail PDF failed");
        renderer.render(&painter,QRectF(0,0,pdf.width(),pdf.height()));painter.end();
        std::ifstream drawing(path);std::ofstream review(out/"shaft-details-review.html");
        review<<"<!doctype html><html lang='en'><meta charset='utf-8'><title>STARZ F101 machining details</title>"
                    <<"<style>body{margin:24px;background:#e5e7eb;font-family:Arial,sans-serif}svg{width:100%;height:auto;background:white}</style>"
                    <<"<body><h1>F101 R6 machining details</h1><p><a href='F101-R6-details.pdf'>A3 sheet2 PDF</a> · <a href='shaft-review.html'>Sheet1</a></p>"
                    <<drawing.rdbuf()<<"</body></html>";
        if(!drawing||!review)throw std::runtime_error("Shaft detail review output failed");
}
void encoderPlate(const fs::path& out) {
    namespace m=starz::measurement;
    const auto path=out/"M201-R2-encoder-plate.svg";std::ofstream s(path);
    s<<std::setprecision(10);begin(s,"M201 — MEASURING ENCODER PLATE / R2");
    constexpr double cx=85,cy=100,scale=2;
    const double width=m::design::encoder_plate_width_mm;
    s<<"<rect class='edge' x='"<<cx-width<<"' y='"<<cy-width<<"' width='"<<2*width<<"' height='"<<2*width<<"'/>\n";
    circle(s,cx,cy,m::design::encoder_plate_seat_mm);
    circle(s,cx,cy,m::catalogue::encoder_mount_pcd_mm,"centre");
    line(s,31,cy,139,cy,"centre");line(s,cx,46,cx,154,"centre");
    for(int i=0;i<3;++i) {
        const double angle=i*2*std::numbers::pi/3;
        circle(s,cx+21*std::sin(angle),cy-21*std::cos(angle),m::design::encoder_plate_encoder_clearance_mm);
    }
    for(double x:{-18.0,18.0})for(double z:{-18.0,18.0})circle(s,cx+x,cy-z,m::design::encoder_plate_support_tap_mm);
    dimension(s,cx-width,cx+width,cy+width,164,"60.00 ±0.05");
    dimension(s,cx-18,cx+18,54,43,"36 BASIC");
    text(s,37,176,"VIEW FROM COUPLING SIDE / 2:1",3.3);
    text(s,17,189,"3 × Ø4.50 +0.10/0 THRU;PCD42 BASIC;120° apart;one hole on+Z.");
    text(s,17,197,"4 × M4×0.7 TAP THRU at(±18,±18);36×36 BASIC;plate support screws from coupling side.");
    text(s,17,205,"Central seat bore Ø36.50 +0.05/0 THRU;Ø36.5-class synchro-flange seat;no shoulder.");
    text(s,17,213,"All hole positions Ø0.10 to A|B|C. Hole coordinates below are BASIC.");
    // Axial section: face A at left;seat bore through the6mm plate thickness.
    constexpr double sx=205,sy=100;
    const double t=scale*m::design::encoder_plate_thickness_mm,r=m::design::encoder_plate_seat_mm;
    for(int sign:{-1,1})s<<"<rect class='edge' x='"<<sx<<"' y='"<<(sign<0?sy-width:sy+r)<<"' width='"<<t<<"' height='"<<width-r<<"'/>\n";
    line(s,sx-10,sy,sx+25,sy,"centre");dimension(s,sx,sx+t,146,164,"6.00 ±0.02");
    text(s,188,176,"AXIAL SECTION / 2:1",3.3);
    text(s,258,46,"DATUM A: encoder mounting face Y0");
    text(s,258,53,"DATUM B: central bore axis");
    text(s,258,60,"DATUM C: left edge X−30 in this view");
    text(s,258,71,"A flatness0.02;opposite face parallel0.02");
    text(s,258,78,"B perpendicularity0.02 to A");
    text(s,258,85,"B cylindricity0.01;seat bore Ra0.8µm");
    text(s,258,92,"Joint faces Ra1.6µm;other faces Ra3.2µm");
    text(s,258,103,"Material EN AW-6082-T6;no coating on A/B");
    text(s,258,110,"Stock66×66×8;quantity2;edgesC0.20±0.05");
    text(s,258,121,"Encoder holes (X,Z),PCD42 BASIC:");
    text(s,258,128,"(0,+21), (+18.1865,−10.5)");
    text(s,258,135,"(−18.1865,−10.5)");
    text(s,258,146,"3 ×ISO4762 M4×12,class8.8");
    text(s,258,153,"Nominal flange engagement6.0");
    text(s,258,160,"(ifm M4×0.7 thread depth6)");
    text(s,258,171,"4 ×ISO4762 M4×6,class8.8 support screws");
    text(s,258,178,"Heads in M203 rear counterbores Ø7.5×4");
    text(s,258,189,"Encoder ifm RU3100: body Ø58.6×63.5");
    text(s,258,196,"Shaft Ø6×10;tip10 from A;no flat");
    text(s,258,203,"Flange 3×M4×0.7×6 on PCD42;no pilot");
    text(s,258,210,"on the archived drawing — confirm centering");
    text(s,258,217,"M12 5-pole radial connector;orient +X");
    text(s,258,224,"Final mounting torque/support still open");
    line(s,8,231,412,231);
    text(s,14,240,"PROCESS: square stock;finish A/opposite face;finish seat bore;drill3PCD holes;tap4M4 support holes;deburr without dishing A.");
    text(s,14,248,"INSPECT:60square;6thickness;seat bore diameter/cylindricity;face flatness/parallelism;hole positions and clearance diameters;M4 tap engagement.");
    text(s,14,256,"ASSEMBLY: encoder flange face on A;shaft passes the seat bore;M4×12 screws from the coupling side into the flange;support screws into the M203 counterbores.");
    text(s,14,264,"SCOPE: five-part encoder face mount only. Pressure arm,shaft bearings,complete tool access and wire guides are not this drawing.");
    line(s,8,273,412,273);line(s,235,273,235,289);
    text(s,14,283,"PART M201 · MEASURING ENCODER PLATE",4);
    text(s,14,291,std::string(m::revision),3.2);
    text(s,241,283,"SCALE2:1 / SINGLE SELECTED DIMENSION RECORD",3);
    text(s,241,291,"SOURCE: ifm RU3100 datasheet;STARZ measurement_spec",3);
    s<<"</svg>\n";s.close();if(!s)throw std::runtime_error("Encoder plate SVG failed");
    QSvgRenderer renderer(QString::fromStdString(path.string()));if(!renderer.isValid())throw std::runtime_error("Encoder plate SVG invalid");
    QPdfWriter pdf(QString::fromStdString((out/"M201-R2-encoder-plate.pdf").string()));
    pdf.setPageSize(QPageSize(QPageSize::A3));pdf.setPageOrientation(QPageLayout::Landscape);pdf.setPageMargins(QMarginsF(0,0,0,0));pdf.setResolution(300);
    pdf.setTitle("STARZ M201 R2 encoder plate — dimension record,release hold");
    QPainter painter(&pdf);if(!painter.isActive())throw std::runtime_error("Encoder plate PDF failed");
    renderer.render(&painter,QRectF(0,0,pdf.width(),pdf.height()));painter.end();
    std::ifstream drawing(path);std::ofstream review(out/"encoder-plate-review.html");
    review<<"<!doctype html><html lang='en'><meta charset='utf-8'><title>STARZ M201 drawing review</title>"
          <<"<style>body{margin:24px;background:#e5e7eb;font-family:Arial,sans-serif}svg{width:100%;height:auto;background:white}</style>"
          <<"<body><h1>M201 R2 encoder plate</h1><p><a href='M201-R2-encoder-plate.pdf'>A3 vector PDF</a> · Engineering release hold</p>"
          <<drawing.rdbuf()<<"</body></html>";
    if(!drawing||!review)throw std::runtime_error("Encoder plate review output failed");
}
void payoffSpindle(const fs::path& out) {
    const auto path=out/"P002-R2-payoff-spindle.svg";std::ofstream s(path);
    s<<std::setprecision(10);begin(s,"P002 — PAYOFF SPINDLE / R2 · SELECTED DESIGN,NOT FABRICATED");
    const double sx=60,sy=150;
    line(s,sx-2,sy,sx+330,sy,"centre");
    s<<"<rect class='edge' x='"<<sx<<"' y='"<<sy-10<<"' width='330' height='20'/>\n";
    line(s,sx,sy-10,sx+25,sy-10);line(s,sx,sy+10,sx+25,sy+10);
    line(s,sx+305,sy-10,sx+330,sy-10);line(s,sx+305,sy+10,sx+330,sy+10);
    for(double x:{sx+25,sx+305}){line(s,x,sy-8,x,sy+8);}
    line(s,sx+25,sy-10,sx+25,sy-8);line(s,sx+305,sy-10,sx+305,sy-8);
    line(s,sx+25,sy+10,sx+25,sy+8);line(s,sx+305,sy+10,sx+305,sy+8);
    text(s,sx+28,sy-13,"M20×1.5-6g");text(s,sx+280,sy-13,"M20×1.5-6g");
    text(s,sx+70,sy+19,"Ø20 h6 GROUND FULL LENGTH BETWEEN THREADS");
    dimension(s,sx,sx+330,sy+40,sy+52,"660.00 ±0.20");
    dimension(s,sx,sx+25,sy+40,sy+64,"25.00");
    dimension(s,sx+305,sx+330,sy+40,sy+64,"25.00");
    line(s,sx+25,sy-28,sx+25,sy+8,"dim");line(s,sx+305,sy-28,sx+305,sy+8,"dim");
    text(s,sx+26,sy-31,"BEARING SEAT ZONE Ø20 h6 (6204-2Z/C3 ×2, posts P004/P005)");
    text(s,sx,sy+80,"DATUM A = SPINDLE AXIS · radial runout ≤0.010 between seats;cylindricity ≤0.004 on seats");
    text(s,sx,sy+88,"DATUM B = left seat centreline at Y=−279.5 (machine coords);seats spanY=−289…−271 andY=+271…+289");
    text(s,250,60,"Material C45 (EN 1.0503),ground stock");
    text(s,250,68,"Surface finish Ra0.8 on Ø20, Ra1.6 elsewhere");
    text(s,250,76,"Both ends chamfer C0.5;no centre hole specified");
    text(s,250,84,"Hardness: as-supplied;no heat treatment");
    text(s,250,100,"Interface: spool P001 rides on Ø20 through");
    text(s,250,108,"two Ø20.5 flange bores;brake disc P006");
    text(s,250,116,"sits on Ø20 outboard of the right post.");
    text(s,250,124,"Retention:2 × M20×1.5 nut (KM-class)");
    text(s,250,132,"with tab washer, supplier-selected;");
    text(s,250,140,"threads are NOT modeled in the CAD.");
    line(s,8,222,412,222);
    text(s,14,231,"PROCESS: centreless-grind Ø20 h6;single-point the M20×1.5 ends from the ground diameter;deburr.");
    text(s,14,239,"INSPECT: length660;Ø20 actual within h6;seat runout/cylindricity;thread gauging;visual for grinding burns.");
    text(s,14,247,"ASSEMBLY: fit 6204 bearings into P004/P005 pockets;insert spindle through spool bores and bearings;");
    text(s,14,255,"clamp P006 and nut M20×1.5 outboard. Match-mark bearing-to-post and nut-to-shaft after first fit.");
    line(s,8,264,412,264);line(s,235,264,235,289);
    text(s,14,274,"PART P002 · PAYOFF SPINDLE",4);
    text(s,14,282,std::string(starz::mechanism::revision),3.2);
    text(s,241,274,"SCALE1:2 / SINGLE SELECTED DIMENSION RECORD",3);
    text(s,241,282,"RELEASE HOLD: load validation (docs/26 §4/§6);not fabricated",3);
    s<<"</svg>\n";s.close();if(!s)throw std::runtime_error("Payoff spindle SVG failed");
    QSvgRenderer renderer(QString::fromStdString(path.string()));if(!renderer.isValid())throw std::runtime_error("Payoff spindle SVG invalid");
    QPdfWriter pdf(QString::fromStdString((out/"P002-R2-payoff-spindle.pdf").string()));
    pdf.setPageSize(QPageSize(QPageSize::A3));pdf.setPageOrientation(QPageLayout::Landscape);pdf.setPageMargins(QMarginsF(0,0,0,0));pdf.setResolution(300);
    pdf.setTitle("STARZ P002 R2 payoff spindle — dimension record,release hold");
    QPainter painter(&pdf);if(!painter.isActive())throw std::runtime_error("Payoff spindle PDF failed");
    renderer.render(&painter,QRectF(0,0,pdf.width(),pdf.height()));painter.end();
    std::ifstream drawing(path);std::ofstream review(out/"payoff-spindle-review.html");
    review<<"<!doctype html><html lang='en'><meta charset='utf-8'><title>STARZ P002 drawing review</title>"
          <<"<style>body{margin:24px;background:#e5e7eb;font-family:Arial,sans-serif}svg{width:100%;height:auto;background:white}</style>"
          <<"<body><h1>P002 R2 payoff spindle</h1><p><a href='P002-R2-payoff-spindle.pdf'>A3 vector PDF</a> · Engineering release hold</p>"
          <<drawing.rdbuf()<<"</body></html>";
    if(!drawing||!review)throw std::runtime_error("Payoff spindle review output failed");
}
void payoffPlates(const fs::path& out) {
    const auto path=out/"P004-P007-R2-payoff-plates.svg";std::ofstream s(path);
    s<<std::setprecision(10);begin(s,"P001/P003/P004/P005/P006 — PAYOFF PLATES / R2");
    const double x=85,y=105;
    s<<"<rect class='edge' x='40' y='55' width='70' height='18'/>\n";
    circle(s,x,y,23.5);circle(s,x,y,10.25,"centre");circle(s,x,y,11.25,"dim");
    line(s,26,y,144,y,"centre");line(s,x,38,x,168,"centre");
    dimension(s,40,110,78,92,"70.00 ±0.20");
    dimension(s,x-23.5,x+23.5,40,32,"Ø47 H7 +0.025/0");
    text(s,17,180,"POST (2×, MIRRORED): 70 × 18 plate;bearing pocket Ø47 H7 ×14 deep");
    text(s,17,187,"from the spool-side face;spindle bore Ø20.5 +0.2/0 through.");
    text(s,17,194,"Pocket and bore share the datum axis (X−650,Z112 machine coords).");
    text(s,17,201,"Z span −845…+320;welded to P003 base all around;grind top face flat.");
    text(s,17,208,"Material S235JR;laser/waterjet + bore on mill;deburr without chamfering the pocket.");
    const double sx=210,cy=105;
    circle(s,sx,cy,90);circle(s,sx,cy,10,"centre");
    line(s,sx-95,cy,sx+95,cy,"centre");line(s,sx,cy-95,sx,cy+95,"centre");
    dimension(s,sx-90,sx+90,204,218,"Ø180 ±0.5");
    text(s,258,60,"BRAKE DISC (1×): Ø180 × 6, bore Ø20 H7");
    text(s,258,68,"+0.021/0 on the spindle, keyway 6 JS9 ×");
    text(s,258,76,"2.8 deep (DIN6885-A key) and one M6×8");
    text(s,258,84,"ISO4029 cup-point setscrew over the key.");
    text(s,258,92,"Faces ground flat, parallel ≤0.05, Ra1.6.");
    text(s,258,100,"Material S235JR;blank laser-cut, finish-turned.");
    text(s,258,116,"Caliper bracket P007 is a plain S235JR");
    text(s,258,124,"bracket per docs/26 §3 (pads/spring");
    text(s,258,132,"purchase-to-requirement);no machining");
    text(s,258,140,"tolerances are released on this sheet.");
    text(s,258,156,"SPOOL P001: two S235JR flanges Ø400 x3,");
    text(s,258,164,"bore Ø20.5 +0.2/0, laser-cut, welded to a");
    text(s,258,172,"Ø60x2.5 ERW hub tube 160 long; hub passes");
    text(s,258,180,"through both flanges (welded joint); paint.");
    text(s,258,188,"DRIVE BOSS P008: C45 Ø54.6 x 12, 20H7 bore plus");
    text(s,258,196,"6JS9 keyseat; welded to the left flange inside the hub.");
    text(s,258,204,"Keyed to the spindle key; transmits the brake torque");
    text(s,258,212,"into the spool. NB the whole assembly is 60 mm further");
    text(s,258,220,"outboard than R1 (spool at X-710) - see docs/26.");
    text(s,258,236,"BASE P003: S235JR 430x560x8; four Ø13");
    text(s,258,204,"anchor holes at 340x470 spacing; edges");
    text(s,258,212,"deburred; posts welded to the top face.");
    line(s,8,222,412,222);
    text(s,14,231,"PROCESS: cut blanks;mill pockets/bore to the common datum;weld posts to base with a fixture holding both posts");
    text(s,14,239,"coaxial;stress-relieve;re-check pocket positions after welding.INSPECT: pocket Ø47 H7, coaxiality of the");
    text(s,14,247,"two posts ≤0.1 after welding;disc bore and faces.ASSEMBLY: press 6204 bearings;insert spindle.");
    line(s,8,264,412,264);line(s,235,264,235,289);
    text(s,14,274,"PARTS P001 · P003 · P004 · P005 · P006 (P007 reference)",4);
    text(s,14,282,std::string(starz::mechanism::revision),3.2);
    text(s,241,274,"SCALE1:1 / DIMENSION RECORD",3);
    text(s,241,282,"RELEASE HOLD: weld quality and load validation;not fabricated",3);
    s<<"</svg>\n";s.close();if(!s)throw std::runtime_error("Payoff plates SVG failed");
    QSvgRenderer renderer(QString::fromStdString(path.string()));if(!renderer.isValid())throw std::runtime_error("Payoff plates SVG invalid");
    QPdfWriter pdf(QString::fromStdString((out/"P004-P007-R2-payoff-plates.pdf").string()));
    pdf.setPageSize(QPageSize(QPageSize::A3));pdf.setPageOrientation(QPageLayout::Landscape);pdf.setPageMargins(QMarginsF(0,0,0,0));pdf.setResolution(300);
    pdf.setTitle("STARZ P004/P005/P006 R2 payoff plates — dimension record,release hold");
    QPainter painter(&pdf);if(!painter.isActive())throw std::runtime_error("Payoff plates PDF failed");
    renderer.render(&painter,QRectF(0,0,pdf.width(),pdf.height()));painter.end();
    std::ifstream drawing(path);std::ofstream review(out/"payoff-plates-review.html");
    review<<"<!doctype html><html lang='en'><meta charset='utf-8'><title>STARZ P004-P007 drawing review</title>"
          <<"<style>body{margin:24px;background:#e5e7eb;font-family:Arial,sans-serif}svg{width:100%;height:auto;background:white}</style>"
          <<"<body><h1>P004/P005/P006 R2 payoff plates</h1><p><a href='P004-P007-R2-payoff-plates.pdf'>A3 vector PDF</a> · Engineering release hold</p>"
          <<drawing.rdbuf()<<"</body></html>";
    if(!drawing||!review)throw std::runtime_error("Payoff plates review output failed");
}
void guardPanels(const fs::path& out) {
    const auto path=out/"G101-G106-R2-guard-panels.svg";std::ofstream s(path);
    s<<std::setprecision(10);begin(s,"G101–G106 — GUARD PANELS AND DOOR / R2");
    const double x=100,y=120;
    s<<"<rect class='edge' x='40' y='60' width='110' height='120'/>\n";
    circle(s,x,y,15);
    text(s,x-15,y-22,"Ø30 WIRE");
    text(s,x-15,y-16,"PASS-THROUGH");
    dimension(s,40,150,184,198,"LEFT/RIGHT SIDE: 690 × 315 × 2, APERTURE Ø30 AT X±(345..347), Y0, Z112");
    text(s,17,210,"Side/rear/roof panels: DC01 2 mm, powder-coat RAL7035,edges deburred, radiused C2 on");
    text(s,17,217,"exposed corners. Rear 690 × 315 × 2;roof 690 × 1250 × 2. Mounting:M6×12 8.8 at ≤200 pitch");
    text(s,17,224,"into rivet nuts;pass-through edge guarded with split grommet (purchase-to-requirement).");
    text(s,258,60,"FRONT DOOR (G105): clear polycarbonate 5 mm,");
    text(s,258,68,"690 × 315, in a 20×20×2 S235JR tube frame;");
    text(s,258,76,"door weight ≈ panel 1.2 kg/m² × 0.217 m²");
    text(s,258,84,"+ frame;two hinges rated ≥15 kg total,");
    text(s,258,92,"zinc-plated (purchase-to-requirement);");
    text(s,258,100,"ACF-1 actuator mounted to the door,");
    text(s,258,108,"SLC body on the G106 jamb plate.");
    text(s,258,124,"LOCK PLATE (G106): S235JR 5 mm, 60 × 55,");
    text(s,258,132,"welded to the door jamb;body pocket");
    text(s,258,140,"30×192×44 +0.5 clearance per CAD;the SLC");
    text(s,258,148,"drilling pattern REQUIRES the Bernstein");
    text(s,258,156,"mounting drawing — do not drill from the");
    text(s,258,164,"envelope (docs/26 §2).");
    line(s,8,222,412,222);
    text(s,14,231,"PROCESS: laser/brake;powder-coat after bending;mount rivet nuts;glaze door with mechanical fixing + seal.");
    text(s,14,239,"INSPECT: panel flatness, coating, aperture position, door weight, hinge alignment, actuator/lock alignment by");
    text(s,14,247,"physical fit. ASSEMBLY: hang door, verify 0.5 mm CAD clearance class and locking travel physically.");
    line(s,8,264,412,264);line(s,235,264,235,289);
    text(s,14,274,"PARTS G101–G106 · GUARD SET",4);
    text(s,14,282,std::string(starz::mechanism::revision),3.2);
    text(s,241,274,"DIMENSION RECORD",3);
    text(s,241,282,"RELEASE HOLD: risk assessment,safety distances,aperture;not fabricated",3);
    s<<"</svg>\n";s.close();if(!s)throw std::runtime_error("Guard panels SVG failed");
    QSvgRenderer renderer(QString::fromStdString(path.string()));if(!renderer.isValid())throw std::runtime_error("Guard panels SVG invalid");
    QPdfWriter pdf(QString::fromStdString((out/"G101-G106-R2-guard-panels.pdf").string()));
    pdf.setPageSize(QPageSize(QPageSize::A3));pdf.setPageOrientation(QPageLayout::Landscape);pdf.setPageMargins(QMarginsF(0,0,0,0));pdf.setResolution(300);
    pdf.setTitle("STARZ G101-G106 R2 guard panels — dimension record,release hold");
    QPainter painter(&pdf);if(!painter.isActive())throw std::runtime_error("Guard panels PDF failed");
    renderer.render(&painter,QRectF(0,0,pdf.width(),pdf.height()));painter.end();
    std::ifstream drawing(path);std::ofstream review(out/"guard-panels-review.html");
    review<<"<!doctype html><html lang='en'><meta charset='utf-8'><title>STARZ G101-G106 drawing review</title>"
          <<"<style>body{margin:24px;background:#e5e7eb;font-family:Arial,sans-serif}svg{width:100%;height:auto;background:white}</style>"
          <<"<body><h1>G101-G106 R2 guard panels</h1><p><a href='G101-G106-R2-guard-panels.pdf'>A3 vector PDF</a> · Engineering release hold</p>"
          <<drawing.rdbuf()<<"</body></html>";
    if(!drawing||!review)throw std::runtime_error("Guard panels review output failed");
}
void axisPlates(const fs::path& out) {
    const auto path=out/"H005-H006-R1-axis-plates.svg";std::ofstream s(path);
    s<<std::setprecision(10);begin(s,"H005/H006 — CUSTOM CUT-AXIS PLATES / R1");
    const double x=100,y=150;
    s<<"<rect class='edge' x='40' y='60' width='100' height='180'/>\n";
    line(s,40,y-70,140,y-70);line(s,40,y+70,140,y+70);
    for(double lx:{60.,80.,100.,120.}){circle(s,lx,y-70,3.3);circle(s,lx,y+70,3.3);}
    text(s,17,35,"H005 BASE PLATE 6082-T6: 86 x 440 x 20;two HGR20 rail seats");
    text(s,17,42,"milled flat 0.02/300,60 mm pitch M5;BK12 land at the fixed end,");
    text(s,17,49,"BF12 land at the distal end;6x Ø6.6 base grid 46/100 to H001/H002.");
    text(s,17,56,"Deburr;no hard anodise on the rail seats.");
    const double cx=300,cy=120;
    s<<"<rect class='edge' x='260' y='70' width='80' height='100'/>\n";
    line(s,cx-30,cy-38,cx+30,cy-38);line(s,cx-30,cy+38,cx+30,cy+38);
    circle(s,cx,cy-14,6);circle(s,cx,cy+16,6);
    for(double px:{-23.,23.})for(double pz:{-23.,23.})circle(s,cx+px,cy+pz,2.5);
    for(double px:{-19.,19.})for(double pz:{-19.,19.})circle(s,cx+px,cy+pz,1.6);
    text(s,243,60,"H006 CARRIAGE PLATE 6082-T6: carriage pad 60x75 at 46 mm;");
    text(s,243,67,"blade-holder interface 4x M6 on 46x46 (datum A);");
    text(s,243,74,"DSG16h nut pocket per the housing datasheet on the centreline;");
    text(s,243,81,"block lands 4x M5 per the HGH20CA datasheet. NO F0/PCD70 pattern here.");
    text(s,243,95,"H003 is the FIXED-END motor adapter (not on this plate).");
    text(s,243,102,"The KK86 carriage envelope is NOT reproduced: the custom axis");
    text(s,243,109,"is its own interface; the adapter FEM applies to H003 only.");
    line(s,8,222,412,222);
    text(s,14,231,"PROCESS: plate stock, mill both faces, drill/tap from one fixture; nut pocket and pad in the same setup.");
    text(s,14,239,"INSPECT: flatness, hole positions ±0.05, M6/M5 tapping depth, nut-pocket depth, block-land parallelism.");
    text(s,14,247,"ASSEMBLY: rails to H005, blocks to H006, nut housing in pocket, screw through BK12/BF12; run-in 1 h;");
    text(s,14,255,"re-measure preload and repeatability ±0.02 over 194 mm (DTI); record in the build record.");
    line(s,8,264,412,264);line(s,235,264,235,289);
    text(s,14,274,"PARTS H005 · H006 · CUSTOM CUT AXIS (docs/39)",4);
    text(s,14,282,std::string(starz::mechanism::revision),3.2);
    text(s,241,274,"DIMENSION RECORD",3);
    text(s,241,282,"RELEASE HOLD: physical run-in and repeatability record",3);
    s<<"</svg>\n";s.close();if(!s)throw std::runtime_error("Axis plates SVG failed");
    QSvgRenderer renderer(QString::fromStdString(path.string()));if(!renderer.isValid())throw std::runtime_error("Axis plates SVG invalid");
    QPdfWriter pdf(QString::fromStdString((out/"H005-H006-R1-axis-plates.pdf").string()));
    pdf.setPageSize(QPageSize(QPageSize::A3));pdf.setPageOrientation(QPageLayout::Landscape);pdf.setPageMargins(QMarginsF(0,0,0,0));pdf.setResolution(300);
    pdf.setTitle("STARZ H005/H006 R1 axis plates — dimension record,release hold");
    QPainter painter(&pdf);if(!painter.isActive())throw std::runtime_error("Axis plates PDF failed");
    renderer.render(&painter,QRectF(0,0,pdf.width(),pdf.height()));painter.end();
    std::ifstream drawing(path);std::ofstream review(out/"axis-plates-review.html");
    review<<"<!doctype html><html lang='en'><meta charset='utf-8'><title>STARZ H005/H006 drawing review</title>"
          <<"<style>body{margin:24px;background:#e5e7eb;font-family:Arial,sans-serif}svg{width:100%;height:auto;background:white}</style>"
          <<"<body><h1>H005/H006 R1 axis plates</h1><p><a href='H005-H006-R1-axis-plates.pdf'>A3 vector PDF</a> · Engineering release hold</p>"
          <<drawing.rdbuf()<<"</body></html>";
    if(!drawing||!review)throw std::runtime_error("Axis plates review output failed");
}
}
int main(int argc,char** argv) try {
    QGuiApplication app(argc,argv);
    if(argc!=3||std::string(argv[1])!="--out")throw std::invalid_argument("Use --out output_directory");
    const fs::path out=argv[2];fs::create_directories(out);
    adapter(out);shaft(out);shaftDetails(out);encoderPlate(out);
    payoffSpindle(out);payoffPlates(out);guardPanels(out);axisPlates(out);
    std::cout<<"H003 R6,F101 R6(two sheets),M201 R2,P002 R2,P004-P007 R2,G101-G106 R2 andH005-H006 R1 A3 dimensioned SVG/vector PDFs generated\n";
    return 0;
}catch(const std::exception& e){std::cerr<<e.what()<<'\n';return 1;}
