sbelakho2/Cutting/engineering/src/bearing_contact_thermal.cpp

#include "bearing_contact_thermal.hpp"
#include <BRepAlgoAPI_Cut.hxx>
#include <BRepAlgoAPI_Fuse.hxx>
#include <BRepCheck_Analyzer.hxx>
#include <BRep_Builder.hxx>
#include <BRepGProp.hxx>
#include <BRepPrimAPI_MakeBox.hxx>
#include <BRepPrimAPI_MakeCylinder.hxx>
#include <GProp_GProps.hxx>
#include <STEPControl_Writer.hxx>
#include <TopoDS.hxx>
#include <TopoDS_Compound.hxx>
#include <TopoDS_Shape.hxx>
#include <TopoDS_Solid.hxx>
#include <Eigen/Dense>
#include <Eigen/Sparse>
#include <algorithm>
#include <cmath>
#include <fstream>
#include <iomanip>
#include <iostream>
#include <map>
#include <numbers>
#include <sstream>
#include <stdexcept>

namespace starz::engineering {
namespace {
void check(bool ok,const char* message) { if(!ok) throw std::runtime_error(message); }

Eigen::Matrix<double,6,6> constitutive(const ElasticMaterial& m) {
    const double lambda=m.young_pa*m.poisson/((1+m.poisson)*(1-2*m.poisson));
    const double mu=m.young_pa/(2*(1+m.poisson));
    Eigen::Matrix<double,6,6> d=Eigen::Matrix<double,6,6>::Zero();
    d.block<3,3>(0,0).setConstant(lambda);
    for(int a=0;a<3;++a){ d(a,a)+=2*mu; d(a+3,a+3)=mu; }
    return d;
}
Eigen::Matrix<double,6,12> bmatrix(const TetMesh& mesh,const std::array<int,4>& ids) {
    Eigen::Matrix4d a;
    for(int i=0;i<4;++i){ a(i,0)=1; a.block<1,3>(i,1)=mesh.nodes_mm.at(static_cast<std::size_t>(ids[static_cast<std::size_t>(i)])).transpose()*1e-3; }
    const double v=std::abs(a.determinant())/6;
    check(std::isfinite(v)&&v>1e-20,"Degenerate bearing-contact tetrahedron");
    const Eigen::Matrix4d inverse=a.inverse();
    Eigen::Matrix<double,6,12> b=Eigen::Matrix<double,6,12>::Zero();
    for(int i=0;i<4;++i){
        const double x=inverse(1,i),y=inverse(2,i),z=inverse(3,i);
        b(0,3*i)=x; b(1,3*i+1)=y; b(2,3*i+2)=z;
        b(3,3*i)=y; b(3,3*i+1)=x;
        b(4,3*i+1)=z; b(4,3*i+2)=y;
        b(5,3*i)=z; b(5,3*i+2)=x;
    }
    return b;
}
double vonMises(const Eigen::Matrix<double,6,1>& s) {
    const double xx=s(0),yy=s(1),zz=s(2),xy=s(3),yz=s(4),xz=s(5);
    return std::sqrt(std::max(0.0,xx*xx+yy*yy+zz*zz-xx*yy-yy*zz-zz*xx+3*(xy*xy+yz*yz+xz*xz)));
}
std::vector<std::array<int,3>> boundaryFaces(const TetMesh& mesh) {
    std::map<std::array<int,3>,int> count;
    for(const auto& t:mesh.tetrahedra) for(int omit=0;omit<4;++omit) {
        std::array<int,3> f{}; int j=0;
        for(int i=0;i<4;++i) if(i!=omit) f[static_cast<std::size_t>(j++)]=t[static_cast<std::size_t>(i)];
        std::sort(f.begin(),f.end()); ++count[f];
    }
    std::vector<std::array<int,3>> out;
    for(const auto& [f,n]:count){ check(n==1||n==2,"Non-manifold bearing-contact mesh"); if(n==1) out.push_back(f); }
    return out;
}
double selectedArea(const TetMesh& mesh,const std::vector<std::array<int,3>>& faces,
                    const std::function<bool(const Eigen::Vector3d&)>& select) {
    double area=0;
    for(const auto& f:faces) {
        const auto& a=mesh.nodes_mm[static_cast<std::size_t>(f[0])];
        const auto& b=mesh.nodes_mm[static_cast<std::size_t>(f[1])];
        const auto& c=mesh.nodes_mm[static_cast<std::size_t>(f[2])];
        if(select((a+b+c)/3)) area+=(b-a).cross(c-a).norm()/2;
    }
    return area;
}
// --- Study 1 CAD (local axis +Z, seat z in [0,9]) --------------------------
TopoDS_Shape buildStudy1Solid(const BearingContactGeometry& g) {
    const double r_seat=g.seat_diameter_mm/2, r_shoulder=g.shoulder_diameter_mm/2, r_neck=g.neck_diameter_mm/2;
    const double seat_rear=-g.rear_extension_mm, seat_front=g.seat_length_mm;
    // Rings are inset axially by 0.1 mm and their bore surfaces are separated
    // from the near-coincident shaft/bore surfaces by stated CAD stand-ins so
    // the gmsh OCC import heal cannot weld the disjoint solids together. The
    // fits are applied as resolved pressures, not as geometry.
    const double ring_z0=-0.1, ring_z1=g.seat_length_mm-0.1;
    const TopoDS_Shape shaftMain=BRepPrimAPI_MakeCylinder(gp_Ax2(gp_Pnt(0,0,seat_rear),gp_Dir(0,0,1)),r_seat,
        g.seat_length_mm+g.rear_extension_mm).Solid();
    const TopoDS_Shape shoulder=BRepPrimAPI_MakeCylinder(gp_Ax2(gp_Pnt(0,0,seat_front),gp_Dir(0,0,1)),r_shoulder,
        g.shoulder_length_mm).Solid();
    const TopoDS_Shape neck=BRepPrimAPI_MakeCylinder(gp_Ax2(gp_Pnt(0,0,seat_front+g.shoulder_length_mm),gp_Dir(0,0,1)),r_neck,
        g.neck_length_mm).Solid();
    BRepAlgoAPI_Fuse fuse12(shaftMain,shoulder);
    check(fuse12.IsDone(),"Shaft/shoulder fuse failed");
    BRepAlgoAPI_Fuse fuse123(fuse12.Shape(),neck);
    check(fuse123.IsDone(),"Shaft/neck fuse failed");
    const TopoDS_Shape shaft=fuse123.Shape();
    const TopoDS_Shape innerRingOuter=BRepPrimAPI_MakeCylinder(gp_Ax2(gp_Pnt(0,0,ring_z0),gp_Dir(0,0,1)),g.inner_ring_od_mm/2,g.seat_length_mm).Solid();
    const TopoDS_Shape innerRingHole=BRepPrimAPI_MakeCylinder(gp_Ax2(gp_Pnt(0,0,ring_z0-1),gp_Dir(0,0,1)),7.6,g.seat_length_mm+2).Solid();
    BRepAlgoAPI_Cut innerCut(innerRingOuter,innerRingHole);
    check(innerCut.IsDone(),"Inner ring cut failed");
    const TopoDS_Shape innerRing=innerCut.Shape();
    const TopoDS_Shape outerRingOuter=BRepPrimAPI_MakeCylinder(gp_Ax2(gp_Pnt(0,0,ring_z0),gp_Dir(0,0,1)),g.outer_ring_od_mm/2,g.seat_length_mm).Solid();
    const TopoDS_Shape outerRingHole=BRepPrimAPI_MakeCylinder(gp_Ax2(gp_Pnt(0,0,ring_z0-1),gp_Dir(0,0,1)),g.outer_ring_id_mm/2,g.seat_length_mm+2).Solid();
    BRepAlgoAPI_Cut outerCut(outerRingOuter,outerRingHole);
    check(outerCut.IsDone(),"Outer ring cut failed");
    const TopoDS_Shape outerRing=outerCut.Shape();
    const TopoDS_Shape block=BRepPrimAPI_MakeBox(gp_Pnt(-g.housing_x_mm/2,-g.housing_y_mm/2,0),
        gp_Pnt(g.housing_x_mm/2,g.housing_y_mm/2,g.housing_z_mm)).Solid();
    const TopoDS_Shape bore=BRepPrimAPI_MakeCylinder(gp_Ax2(gp_Pnt(0,0,-1),gp_Dir(0,0,1)),g.housing_bore_diameter_mm/2,
        g.housing_z_mm+2).Solid();
    BRepAlgoAPI_Cut housingCut(block,bore);
    check(housingCut.IsDone(),"Housing bore cut failed");
    const TopoDS_Shape housing=housingCut.Shape();
    TopoDS_Compound compound;
    BRep_Builder builder; builder.MakeCompound(compound);
    for(const auto& solid:{shaft,innerRing,outerRing,housing}) {
        check(BRepCheck_Analyzer(solid).IsValid(),"Invalid bearing-contact solid");
        GProp_GProps props; BRepGProp::VolumeProperties(solid,props);
        check(props.Mass()>0,"Empty bearing-contact solid");
        builder.Add(compound,solid);
    }
    return compound;
}
// --- Study 2 CAD: F101 front half (local z = S - 31.5, docs/12 §2) ---------
struct ShaftStep { double z0,z1,radius; };
const std::vector<ShaftStep>& frontHalfSteps() {
    static const std::vector<ShaftStep> steps{
        {0.0,33.0,7.0},      // Ø14 pulley seat S31.5..64.5
        {33.0,41.5,6.75},    // M15 thread + runout, Ø13.5 stand-in
        {41.5,50.5,7.5},     // Ø15 locating-bearing seat S73..82
        {50.5,55.5,9.5},     // Ø19 shoulder S82..87
        {55.5,60.5,6.0},     // Ø12 neck S87..92
        {60.5,81.5,5.0},     // Ø10 roller journal S92..113
    };
    return steps;
}
TopoDS_Shape buildFrontHalfSolid() {
    TopoDS_Shape out;
    bool first=true;
    for(const auto& step:frontHalfSteps()) {
        const TopoDS_Shape piece=BRepPrimAPI_MakeCylinder(gp_Ax2(gp_Pnt(0,0,step.z0),gp_Dir(0,0,1)),step.radius,step.z1-step.z0).Solid();
        if(first){ out=piece; first=false; }
        else { BRepAlgoAPI_Fuse fuse(out,piece); check(fuse.IsDone(),"Front-half fuse failed"); out=fuse.Shape(); }
    }
    check(BRepCheck_Analyzer(out).IsValid(),"Invalid front-half solid");
    GProp_GProps props; BRepGProp::VolumeProperties(out,props);
    check(props.Mass()>0,"Empty front-half solid");
    return out;
}
void writeStep(const TopoDS_Shape& solid,const std::filesystem::path& path) {
    STEPControl_Writer writer;
    check(writer.Transfer(solid,STEPControl_AsIs)==IFSelect_RetDone,"STEP transfer failed");
    check(writer.Write(path.string().c_str())==IFSelect_RetDone,"STEP write failed");
}
TetMesh meshSolid(const TopoDS_Shape& solid,const std::string& label,double bulk,double minimum,
                  const std::function<double(const Eigen::Vector3d&)>& sizing) {
    check(std::isfinite(bulk)&&bulk>0&&std::isfinite(minimum)&&minimum>0&&minimum<=bulk,"Invalid bearing-contact mesh sizes");
    const auto stepPath=std::filesystem::temp_directory_path()/("starz-bct-"+label+".step");
    writeStep(solid,stepPath);
    return meshStepRefined(stepPath,bulk,minimum,sizing,RefinedMeshOptimizer::gmsh);
}
double study1Size(const Eigen::Vector3d& p) {
    const double r=std::hypot(p.x(),p.y()),z=p.z();
    double s=3.0;
    if(z>=-0.5&&z<=9.5) {
        const double dSeat=std::abs(r-7.5);
        if(dSeat<0.55) s=0.45;
        else if(std::abs(r-9.87)<0.75) s=0.6;
        else if(r>13.0&&r<16.3) s=std::abs(r-16.0)<0.7?0.7:1.2;
        else if(r<9.6) s=1.4;
    } else {
        if(r<9.6&&z>=-8.0&&z<=17.0) s=1.4;
        if(std::abs(r-16.15)<1.5&&z>=0&&z<=19.02) s=std::min(s,1.2);
    }
    return s;
}
double study2Size(const Eigen::Vector3d& p) {
    const double r=std::hypot(p.x(),p.y()),z=p.z();
    if(z>40.9&&z<51.1&&std::abs(r-7.5)<0.6) return 0.5;
    if(z>-0.1&&z<33.6&&std::abs(r-7.0)<0.6) return 0.8;
    return 1.6;
}
// --- Resolved-pressure sector patches (collar_contact pattern) -------------
std::vector<LoadPatch> radialPressurePatches(const TetMesh& mesh,const std::vector<std::array<int,3>>& faces,
        double radius_mm,double z_min,double z_max,double pressure_pa,int sectors,bool outward) {
    std::vector<LoadPatch> patches;
    for(int i=0;i<sectors;++i) {
        const double a0=2*std::numbers::pi*i/sectors,a1=2*std::numbers::pi*(i+1)/sectors,amid=(a0+a1)/2;
        const auto select=[=](const Eigen::Vector3d& c){
            double ang=std::atan2(c.y(),c.x()); if(ang<0) ang+=2*std::numbers::pi;
            return c.z()>z_min&&c.z()<z_max&&std::abs(std::hypot(c.x(),c.y())-radius_mm)<0.02
                &&ang>=a0&&ang<a1; };
        const double area=selectedArea(mesh,faces,select);
        check(area>1e-6,"Radial pressure sector not resolved by the mesh");
        const double force=pressure_pa*area*1e-6*(outward?1.0:-1.0);
        patches.push_back(LoadPatch{select,{force*std::cos(amid),force*std::sin(amid),0},std::nullopt,{0,0,0},{}});
    }
    return patches;
}
void writeThermalVtu(const std::filesystem::path& path,const TetMesh& mesh,const std::vector<double>& temperature_c) {
    std::ofstream f(path); f<<std::setprecision(12);
    f<<"<?xml version=\"1.0\"?>\n<VTKFile type=\"UnstructuredGrid\" version=\"0.1\" byte_order=\"LittleEndian\"><UnstructuredGrid>\n"
     <<"<Piece NumberOfPoints=\""<<mesh.nodes_mm.size()<<"\" NumberOfCells=\""<<mesh.tetrahedra.size()<<"\">\n"
     <<"<Points><DataArray type=\"Float64\" NumberOfComponents=\"3\" format=\"ascii\">\n";
    for(const auto& p:mesh.nodes_mm) f<<p.transpose()<<'\n';
    f<<"</DataArray></Points><Cells><DataArray type=\"Int32\" Name=\"connectivity\" format=\"ascii\">\n";
    for(const auto& t:mesh.tetrahedra) f<<t[0]<<' '<<t[1]<<' '<<t[2]<<' '<<t[3]<<'\n';
    f<<"</DataArray><DataArray type=\"Int32\" Name=\"offsets\" format=\"ascii\">\n";
    for(std::size_t i=1;i<=mesh.tetrahedra.size();++i) f<<4*i<<' ';
    f<<"</DataArray><DataArray type=\"UInt8\" Name=\"types\" format=\"ascii\">\n";
    for(std::size_t i=0;i<mesh.tetrahedra.size();++i) f<<"10 ";
    f<<"</DataArray></Cells><PointData><DataArray type=\"Float64\" Name=\"temperature_C\" format=\"ascii\">\n";
    for(double t:temperature_c) f<<t<<'\n';
    f<<"</DataArray></PointData></Piece></UnstructuredGrid></VTKFile>\n";
    f.close();
    if(!f) throw std::runtime_error("Failed to write thermal VTU");
}
} // anonymous namespace

// --- Analytic Lamé ---------------------------------------------------------
double laméPressure(double d,double D,double delta_r_um,double e_hub,double nu_hub,double e_sleeve,double nu_sleeve) {
    for(double v:{d,D,delta_r_um,e_hub,nu_hub,e_sleeve,nu_sleeve})
        if(!std::isfinite(v)) throw std::invalid_argument("Non-finite Lamé input");
    if(d<=0||D<=d||delta_r_um<0||e_hub<=0||e_sleeve<=0||nu_hub<=-1||nu_hub>=0.5||nu_sleeve<=-1||nu_sleeve>=0.5)
        throw std::invalid_argument("Invalid Lamé geometry/material");
    const double ri=d/2*1e-3,ro=D/2*1e-3;
    const double ch=(1-nu_hub)/e_hub;
    const double cs=((ro*ro+ri*ri)/(ro*ro-ri*ri)+nu_sleeve)/e_sleeve;
    return delta_r_um*1e-6/(ri*(ch+cs));
}
double laméSleeveHoop(double d,double D,double p) {
    if(!std::isfinite(p)||d<=0||D<=d) throw std::invalid_argument("Invalid Lamé hoop input");
    const double ri=d/2,ro=D/2;
    return p*(ro*ro+ri*ri)/(ro*ro-ri*ri);
}

// --- Study 1 ---------------------------------------------------------------
BearingContactResult runBearingContactStudy(const BearingContactGeometry& g,const BearingContactRun& run) {
    using namespace std::filesystem;
    const TetMesh mesh=meshSolid(buildStudy1Solid(g),"study1",run.bulk_mm,run.minimum_mm,
        [&](const Eigen::Vector3d& p){ return std::max(run.minimum_mm,study1Size(p)); });
    const auto faces=boundaryFaces(mesh);
    const ElasticMaterial steel42{205e9,0.29,7850};      // 42CrMo4
    const ElasticMaterial steelRing{210e9,0.30,7810};    // 100Cr6
    const ElasticMaterial alu{70e9,0.33,2700};           // 6082-T6 (F112 block)
    const auto d42=constitutive(steel42),dRing=constitutive(steelRing),dAlu=constitutive(alu);
    const double p_fit=laméPressure(15.0,g.inner_ring_od_mm,g.shaft_interference_diametral_um/2,
        steel42.young_pa,steel42.poisson,steelRing.young_pa,steelRing.poisson);
    const int sectors=24;
    auto seatPressure=[&](){
        return radialPressurePatches(mesh,faces,7.4975,-0.1,9.1,p_fit,sectors,false);
    };
    auto ringPressure=[&](){
        return radialPressurePatches(mesh,faces,7.6,-0.2,9.0,p_fit,sectors,true);
    };
    auto neckLoad=[&](double force){
        const auto select=[&](const Eigen::Vector3d& c){
            return std::abs(std::hypot(c.x(),c.y())-g.neck_diameter_mm/2)<0.05&&c.z()>15.5&&c.z()<17.05; };
        check(selectedArea(mesh,faces,select)>1e-6,"Neck load surface not resolved");
        return LoadPatch{select,{force,0,0},std::nullopt,{0,0,0},{}};
    };
    auto boreWallLoad=[&](double force){
        const auto select=[&](const Eigen::Vector3d& c){
            const double r=std::hypot(c.x(),c.y());
            return std::abs(r-g.housing_bore_diameter_mm/2)<0.02&&c.z()>0.05&&c.z()<g.housing_z_mm-0.05
                &&c.x()>=0.7071*r; };
        check(selectedArea(mesh,faces,select)>1e-6,"Bore wall load surface not resolved");
        return LoadPatch{select,{force,0,0},std::nullopt,{0,0,0},{}};
    };
    const double chain_area=std::numbers::pi*g.inner_ring_od_mm*g.seat_length_mm*1e-6; // m^2
    const double chain_pa_m=g.chain_stiffness_n_per_um*1e6/chain_area;
    auto chainSelect=[&](const Eigen::Vector3d& c){
        return std::abs(std::hypot(c.x(),c.y())-g.inner_ring_od_mm/2)<0.02&&c.z()>-0.2&&c.z()<9.0; };
    auto ringFaceSelect=[&](const Eigen::Vector3d& c){
        const double r=std::hypot(c.x(),c.y());
        return (std::abs(c.z()+0.1)<0.004||std::abs(c.z()-(g.seat_length_mm-0.1))<0.004)&&r>7.59&&r<9.88; };
    auto outerBoreSelect=[&](const Eigen::Vector3d& c){
        return std::abs(std::hypot(c.x(),c.y())-g.outer_ring_od_mm/2)<0.02&&c.z()>-0.2&&c.z()<9.0; };
    auto outerFaceSelect=[&](const Eigen::Vector3d& c){
        const double r=std::hypot(c.x(),c.y());
        return (std::abs(c.z()+0.1)<0.004||std::abs(c.z()-(g.seat_length_mm-0.1))<0.004)&&r>13.62&&r<16.01; };
    auto mountSelect=[&](const Eigen::Vector3d& c){
        const double r=std::hypot(c.x(),c.y());
        if(r<16.25) return false;
        return std::abs(c.x()+g.housing_x_mm/2)<0.2||std::abs(c.x()-g.housing_x_mm/2)<0.2
            ||std::abs(c.y()+g.housing_y_mm/2)<0.2||std::abs(c.y()-g.housing_y_mm/2)<0.2
            ||std::abs(c.z())<0.2||std::abs(c.z()-g.housing_z_mm)<0.2; };
    auto shaftEndSelect=[&](const Eigen::Vector3d& c){
        const double r=std::hypot(c.x(),c.y());
        return (std::abs(c.z()+g.rear_extension_mm)<0.02&&r<7.51)||(std::abs(c.z()-17.0)<0.02&&r<6.01); };
    // Case A: four-mesh style rigid seat (rings pinned out of the load path).
    const auto rigidBoundary=[&](const Eigen::Vector3d& p){
        const double r=std::hypot(p.x(),p.y()),z=p.z();
        if(std::abs(r-7.4975)<0.02&&z>-0.1&&z<9.1) return Constraint{0.0,0.0,0.0};
        if(r>7.49&&r<16.05&&z>-0.2&&z<9.0) return Constraint{0.0,0.0,0.0};  // rings, not in the path
        if(mountSelect(p)) return Constraint{0.0,0.0,0.0};                   // housing mount faces
        return Constraint{std::nullopt,std::nullopt,std::nullopt};
    };
    // Case B: compliant chain (foundation supports; stabilising springs stated).
    const auto foundations=[&](double chain_multiplier){
        const double chain=chain_pa_m*chain_multiplier;
        std::vector<FoundationPatch> f;
        f.push_back({chainSelect,{chain,chain,0},{}});                 // balls + bore wall series
        f.push_back({ringFaceSelect,{0,0,1e8},{}});                    // axial stack location
        f.push_back({outerBoreSelect,{4.42e11,4.42e11,0},{}});         // bore-wall radial seat
        f.push_back({outerFaceSelect,{0,0,1e8},{}});
        f.push_back({mountSelect,{1e13,1e13,1e13},{}});                // bolted housing mount
        f.push_back({shaftEndSelect,{1e9,1e9,1e9},{}});                // shaft end stabilisation
        return f;
    };
    std::vector<LoadPatch> fitLoads;
    for(const auto& patch:seatPressure()) fitLoads.push_back(patch);
    for(const auto& patch:ringPressure()) fitLoads.push_back(patch);
    std::vector<LoadPatch> fitPlusNeck=fitLoads; fitPlusNeck.push_back(neckLoad(g.radial_load_n));
    const std::vector<std::vector<LoadPatch>> rigidCases{{neckLoad(g.radial_load_n)}};
    const std::vector<std::vector<LoadPatch>> compliantCases{fitLoads,fitPlusNeck,{boreWallLoad(g.radial_load_n)}};
    const auto rigidResults=solveElasticCases(mesh,steel42,rigidBoundary,rigidCases,0);
    const auto compliantResults=solveElasticFoundationCases(mesh,steel42,foundations(1.0),compliantCases,0);
    const auto compliantSoft=solveElasticFoundationCases(mesh,steel42,foundations(0.5),{fitPlusNeck},0);
    const auto compliantStiff=solveElasticFoundationCases(mesh,steel42,foundations(2.0),{fitPlusNeck},0);
    const auto extract=[&](const ElasticResult& result){
        BearingContactCase out;
        for(std::size_t e=0;e<mesh.tetrahedra.size();++e) {
            const auto& t=mesh.tetrahedra[e];
            Eigen::Matrix<double,12,1> ue;
            for(int j=0;j<4;++j) ue.segment<3>(3*j)=result.displacement_m[static_cast<std::size_t>(t[static_cast<std::size_t>(j)])];
            Eigen::Vector3d c=Eigen::Vector3d::Zero();
            for(int j=0;j<4;++j) c+=mesh.nodes_mm[static_cast<std::size_t>(t[static_cast<std::size_t>(j)])]/4;
            const double r=std::hypot(c.x(),c.y()),z=c.z(),vm=vonMises(d42*bmatrix(mesh,t)*ue);
            if(r<7.49&&z>0.1&&z<8.9) out.peak_seat_vm_mpa=std::max(out.peak_seat_vm_mpa,vm/1e6);
            else if(r>7.58&&r<9.85&&z>0.0&&z<8.9) out.peak_ring_vm_mpa=std::max(out.peak_ring_vm_mpa,vm/1e6);
            if(r>15.2&&r<17.8&&z>9.1&&z<18.9) out.peak_housing_wall_vm_mpa=std::max(out.peak_housing_wall_vm_mpa,vm/1e6);
        }
        out.max_displacement_um=result.max_displacement_m*1e6;
        return out;
    };
    BearingContactResult out;
    out.nodes=mesh.nodes_mm.size(); out.tetrahedra=mesh.tetrahedra.size();
    out.lamé_pressure_mpa=p_fit/1e6;
    out.resolved_seat_pressure_mpa=p_fit/1e6;
    out.housing_contact_pressure_mpa=0.0; // record value is an 8..28 um diametral clearance
    out.fit_only=extract(compliantResults[0]);
    out.compliant_load=extract(compliantResults[1]);
    out.bore_wall_load=extract(compliantResults[2]);
    out.rigid_load=extract(rigidResults[0]);
    out.load_induced_seat_mpa=std::max(0.0,out.compliant_load.peak_seat_vm_mpa-out.fit_only.peak_seat_vm_mpa);
    out.boundary_effect_percent=out.rigid_load.peak_seat_vm_mpa>1e-9?
        100*(out.rigid_load.peak_seat_vm_mpa-out.load_induced_seat_mpa)/out.rigid_load.peak_seat_vm_mpa:0;
    out.chain_soft=extract(compliantSoft[0]);
    out.chain_stiff=extract(compliantStiff[0]);
    const auto vmPeakSeatFit=out.fit_only.peak_seat_vm_mpa;
    const bool okSeat=out.fit_only.peak_seat_vm_mpa<out.shaft_seat_allowable_mpa;
    const bool okRing=out.fit_only.peak_ring_vm_mpa<out.ring_allowable_mpa;
    const bool okHousing=out.fit_only.peak_housing_wall_vm_mpa<out.housing_allowable_mpa
        &&out.bore_wall_load.peak_housing_wall_vm_mpa<out.housing_allowable_mpa;
    out.solved=true;
    out.verdict=(okSeat&&okRing&&okHousing&&vmPeakSeatFit>0)?"PASS":"HOLD";
    if(run.vtu_dir) {
        create_directories(*run.vtu_dir);
        writeVtu(*run.vtu_dir/"fit.vtu",mesh,compliantResults[0]);
        writeVtu(*run.vtu_dir/"compliant_load.vtu",mesh,compliantResults[1]);
        writeVtu(*run.vtu_dir/"rigid_load.vtu",mesh,rigidResults[0]);
        writeVtu(*run.vtu_dir/"bore_wall_load.vtu",mesh,compliantResults[2]);
    }
    return out;
}

// --- Study 2 thermal solver -------------------------------------------------
ThermalResult solveThermal(const TetMesh& mesh,double k,const std::vector<ThermalBoundary>& bc) {
    check(std::isfinite(k)&&k>0,"Invalid thermal conductivity");
    check(!mesh.nodes_mm.empty()&&!mesh.tetrahedra.empty(),"Empty thermal mesh");
    check(mesh.nodes_mm.size()<=150000,"Thermal mesh exceeds the 150000-node cap");
    const int count=static_cast<int>(mesh.nodes_mm.size());
    std::vector<Eigen::Triplet<double>> entries; entries.reserve(mesh.tetrahedra.size()*16);
    for(const auto& t:mesh.tetrahedra) {
        const auto b=bmatrix(mesh,t);
        Eigen::Matrix4d a;
        for(int i=0;i<4;++i){ a(i,0)=1; a.block<1,3>(i,1)=mesh.nodes_mm.at(static_cast<std::size_t>(t[static_cast<std::size_t>(i)])).transpose()*1e-3; }
        const double v=std::abs(a.determinant())/6;
        const auto g=b.topRows<3>(); // 3x12: grad N_i = {g(0,3i), g(1,3i+1), g(2,3i+2)}
        Eigen::Matrix4d local=Eigen::Matrix4d::Zero();
        for(int i=0;i<4;++i) for(int j=0;j<4;++j) {
            const Eigen::Vector3d gi(g(0,3*i),g(1,3*i+1),g(2,3*i+2));
            const Eigen::Vector3d gj(g(0,3*j),g(1,3*j+1),g(2,3*j+2));
            local(i,j)=k*v*gi.dot(gj);
        }
        for(int i=0;i<4;++i) for(int j=0;j<4;++j)
            entries.emplace_back(t[static_cast<std::size_t>(i)],t[static_cast<std::size_t>(j)],local(i,j));
    }
    Eigen::SparseMatrix<double> K(count,count); K.setFromTriplets(entries.begin(),entries.end());
    entries.clear(); entries.shrink_to_fit();
    Eigen::VectorXd rhs=Eigen::VectorXd::Zero(count);
    const auto faces=boundaryFaces(mesh);
    std::vector<bool> claimed(faces.size(),false);
    std::vector<int> prescribedNodes; std::vector<double> prescribedValues;
    double powerIn=0;
    for(const auto& b:bc) {
        check(static_cast<bool>(b.select)&&std::isfinite(b.value)&&std::isfinite(b.sink_c),"Invalid thermal boundary");
        if(b.kind==ThermalBoundary::Kind::prescribed) {
            for(std::size_t i=0;i<faces.size();++i) {
                const auto& f=faces[i];
                const auto& a=mesh.nodes_mm[static_cast<std::size_t>(f[0])];
                const auto& c=mesh.nodes_mm[static_cast<std::size_t>(f[1])];
                const auto& d=mesh.nodes_mm[static_cast<std::size_t>(f[2])];
                if(b.select((a+c+d)/3)) { claimed[i]=true;
                    for(int id:f){ prescribedNodes.push_back(id); prescribedValues.push_back(b.value); } }
            }
        }
    }
    for(const auto& b:bc) {
        if(b.kind==ThermalBoundary::Kind::prescribed) continue;
        for(std::size_t i=0;i<faces.size();++i) {
            if(claimed[i]) continue;
            const auto& f=faces[i];
            const auto& a=mesh.nodes_mm[static_cast<std::size_t>(f[0])];
            const auto& c=mesh.nodes_mm[static_cast<std::size_t>(f[1])];
            const auto& d=mesh.nodes_mm[static_cast<std::size_t>(f[2])];
            if(!b.select((a+c+d)/3)) continue;
            const double areaM2=(c-a).cross(d-a).norm()/2*1e-6;
            if(b.kind==ThermalBoundary::Kind::flux) {
                const double q=b.value*areaM2; powerIn+=q;
                for(int id:f) rhs[static_cast<std::size_t>(id)]+=q/3;
            } else {
                check(b.value>0,"Nonpositive convection/conduction coefficient");
                const double gv=b.value*areaM2;
                for(int id:f){ K.coeffRef(id,id)+=gv/3; rhs[static_cast<std::size_t>(id)]+=gv/3*b.sink_c; }
            }
        }
    }
    check(powerIn>1e-9,"Thermal model has no heat input");
    std::vector<int> freeIndex(static_cast<std::size_t>(count),-1),global;
    Eigen::VectorXd prescribed=Eigen::VectorXd::Zero(count);
    std::vector<bool> isPrescribed(static_cast<std::size_t>(count),false);
    for(std::size_t i=0;i<prescribedNodes.size();++i) {
        const int node=prescribedNodes[i];
        if(isPrescribed[static_cast<std::size_t>(node)]) continue;
        isPrescribed[static_cast<std::size_t>(node)]=true;
        prescribed[static_cast<std::size_t>(node)]=prescribedValues[i];
    }
    for(int i=0;i<count;++i) {
        if(isPrescribed[static_cast<std::size_t>(i)]) continue;
        freeIndex[static_cast<std::size_t>(i)]=static_cast<int>(global.size()); global.push_back(i);
    }
    const int nf=static_cast<int>(global.size());
    check(nf>0,"Thermal model pins every node");
    std::vector<Eigen::Triplet<double>> reduced;
    for(int col=0;col<K.outerSize();++col) for(Eigen::SparseMatrix<double>::InnerIterator it(K,col);it;++it) {
        const int rf=freeIndex[static_cast<std::size_t>(it.row())],cf=freeIndex[static_cast<std::size_t>(it.col())];
        if(rf>=0&&cf>=0) reduced.emplace_back(rf,cf,it.value());
    }
    Eigen::SparseMatrix<double> kf(nf,nf); kf.setFromTriplets(reduced.begin(),reduced.end());
    Eigen::VectorXd lifted=rhs;
    for(int c=0;c<count;++c) {
        if(freeIndex[static_cast<std::size_t>(c)]>=0) continue;
        for(Eigen::SparseMatrix<double>::InnerIterator it(K,c);it;++it) {
            if(freeIndex[static_cast<std::size_t>(it.row())]>=0)
                lifted[static_cast<std::size_t>(it.row())]-=it.value()*prescribed[static_cast<std::size_t>(c)];
        }
    }
    Eigen::VectorXd rhsFree(nf);
    for(int i=0;i<nf;++i) rhsFree[i]=lifted[static_cast<std::size_t>(global[static_cast<std::size_t>(i)])];
    Eigen::SimplicialLDLT<Eigen::SparseMatrix<double>> solver;
    solver.compute(kf);
    check(solver.info()==Eigen::Success,"Thermal stiffness factorisation failed");
    check(solver.vectorD().minCoeff()>0,"Thermal stiffness is not positive definite");
    Eigen::VectorXd uf=solver.solve(rhsFree);
    check(solver.info()==Eigen::Success&&uf.allFinite(),"Thermal solve failed");
    Eigen::VectorXd temperature=prescribed;
    for(int i=0;i<nf;++i) temperature[static_cast<std::size_t>(global[static_cast<std::size_t>(i)])]=uf[i];
    const Eigen::VectorXd internal=K*temperature;
    double prescribedOut=0;
    for(int i=0;i<count;++i)
        if(isPrescribed[static_cast<std::size_t>(i)])
            prescribedOut+=internal[static_cast<std::size_t>(i)]-rhs[static_cast<std::size_t>(i)];
    double sinkOut=0;
    for(const auto& b:bc) {
        if(b.kind!=ThermalBoundary::Kind::convection&&b.kind!=ThermalBoundary::Kind::conduction) continue;
        for(const auto& f:faces) {
            const auto& a=mesh.nodes_mm[static_cast<std::size_t>(f[0])];
            const auto& c=mesh.nodes_mm[static_cast<std::size_t>(f[1])];
            const auto& d=mesh.nodes_mm[static_cast<std::size_t>(f[2])];
            if(!b.select((a+c+d)/3)) continue;
            const double areaM2=(c-a).cross(d-a).norm()/2*1e-6;
            sinkOut+=b.value*areaM2/3*(temperature[static_cast<std::size_t>(f[0])]
                +temperature[static_cast<std::size_t>(f[1])]+temperature[static_cast<std::size_t>(f[2])]-3*b.sink_c);
        }
    }
    ThermalResult out;
    out.nodes=mesh.nodes_mm.size(); out.tetrahedra=mesh.tetrahedra.size();
    out.temperature_c.reserve(mesh.nodes_mm.size());
    for(int i=0;i<count;++i) out.temperature_c.push_back(temperature[i]);
    out.power_in_w=powerIn;
    out.power_out_w=sinkOut-prescribedOut;
    out.balance_relative=std::abs(powerIn+prescribedOut-sinkOut)/std::max(1e-9,powerIn);
    check(out.balance_relative<1e-6,"Thermal power balance failed");
    return out;
}
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
