sbelakho2/Cutting/engineering/include/head_fit.hpp

#pragma once
#include "shared/cutting_head_spec.hpp"
#include <algorithm>
#include <array>
#include <cmath>
#include <stdexcept>

namespace starz::engineering {
// Incoming inspection limits for dimensions whose tolerances are not printed
// in the HIWIN/R+W catalogue. These are STARZ acceptance requirements, not
// invented manufacturer tolerances. Assemble against the measured shoulder.
struct HeadFitInput {
    double motor_shaft_mm = head::catalogue::motor_shaft;
    double adapter_mm = head::design::adapter_thickness;
    double shoulder_from_f0_mm = 54;
    double stage_exposed_mm = 18;
    double coupling_free_length_mm = head::catalogue::coupling_length;
    double stage_hub_mm = head::catalogue::coupling_fit;
    double motor_hub_mm = head::catalogue::coupling_fit;
    double shoulder_gap_mm = head::design::stage_hub_shoulder_gap;
};
struct HeadFitResult {
    double coupling_near_mm, coupling_far_mm;
    double motor_engagement_mm, stage_engagement_mm;
    double motor_projection_beyond_hub_mm, stage_projection_beyond_hub_mm;
    double shaft_end_gap_mm, shoulder_gap_mm;
    bool full_hubs;
};
inline HeadFitResult headFit(const HeadFitInput& p) {
    for(double v:std::array{p.motor_shaft_mm,p.adapter_mm,p.shoulder_from_f0_mm,
             p.stage_exposed_mm,p.coupling_free_length_mm,p.stage_hub_mm,p.motor_hub_mm,p.shoulder_gap_mm})
        if(!std::isfinite(v)||v<=0) throw std::invalid_argument("Invalid cutting coupling fit input");
    if(p.coupling_free_length_mm<=p.motor_hub_mm+p.stage_hub_mm ||
       p.stage_exposed_mm>=p.shoulder_from_f0_mm)
        throw std::invalid_argument("Invalid shaft/hub ordering");
    const double far=p.shoulder_from_f0_mm-p.shoulder_gap_mm;
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
