sbelakho2/Cutting/(commit log)

2026-09-13 STARZ S1-B wire cutting machine: full engineering baseline
    Mechanism R3 (507 occurrences): R2 guard/payoff selections (DC01 panels,
    5mm PC door, welded spool, C45 20h6 spindle, SKF 6204-2Z/C3 pockets,
    brake disc/caliper) with selected_design_not_fabricated states.
    Feed-shaft torus-root rerun: 16->13 (gmsh) and 12->10 (Netgen) regional
    holds closed; remaining peaks are genuine under-resolved stress
    concentrations; gates unchanged. Adapter FEM support boundary replaced
    with a justified washer-seat clamp annulus; raw-peak refinement still
    REFINE (ideal-clamp seat-edge singularity), contact/preload model pending.
    Sourcing 2026-09-13: LC1D12BD EUR70.40 (Automation24), SKF bearing and
    retention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
2026-09-16 Complete desk closure: submodel convergence, adapter elastic-foundation, electrical package, audit, assembly record
    Feed-shaft regional submodel: exact global displacement transfer, Dirichlet
    cut faces, 0.01/0.0175 mm sector roots (<=150k nodes/window); all 11
    regional rows converge 0.02-4.0% under the unchanged 5% gate; Pilkey Kt
    cross-checks; M15 slot-corner concentration documented; four-mesh raw
    values preserved; 34-exterior centroid whole-shaft audit remains held.
    Adapter FEM: preloaded Winkler elastic-foundation (half-space stiffness,
    8 kN/screw preload); displacement gate passes 2.16%; peak stable within
    0.46% over a 4x stiffness sweep; handbook bounds bracket the peak;
    raw-peak gate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
2026-09-16 Fabrication-first documentation: step-by-step build guide, consolidated warnings
    New docs/31-fabrication-guide.md: ordered procurement (exact SKUs,
    quantities, observed prices and quotation requests), per-part machining
    operation tables, P1-P9 assembly steps with named checks, energisation
    gates and first-article flow; warnings consolidated into one final section.
    README restructured: 'start building here' pointer, trimmed per-bullet
    caveats, consolidated Warnings section, current 83/83 suite state.
    Master plan: lean execution body, new consolidated 'Warnings and holds'
    section 10, R2 revision, fabrication-guide pointer. Assembly record's
    closing section renamed to 'Warnings and holds'.
2026-09-16 Fabrication-ready framing for the internal build
    Cabinet wiring BOM: all UNSELECTED terminal/PE/gland/wire rows promoted to
    exact selected identities (Phoenix PT 2,5/UT 4/UT 4-PE, Wago 282-364, Lapp
    Skintop MS-M, H07V-K), CB-XPS-FUSE fixed to DF2CN2; only AC incoming
    protection and the fuse holder remain explicit holds.
    Docs: 'development design / not released for fabrication' framing removed
    across README, design basis, master plan, controls, cabinet assembly,
    guard/payoff and assembly records; replaced with 'fabrication-ready for the
    internal build, energisation/commissioning gated'. Initial torque table
    added to the fabrication guide (to be confirmed at first assembly).
    Validators: 114 B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
2026-09-16 Design-integrity audit tool + purchasing/manufacturability fixes it found
    New tools/check_design_integrity.py (registered in core CTest): BOM
    identity/order-code completeness, unpriced-row quotation-register coverage,
    source-file existence, custom-part drawing coverage, purchased-CAD vs BOM
    identity and quantity cross-checks, belt/encoder/wheel/guide arithmetic,
    fastener engagement vs 1.5D rule, DFM land/wall rules.
    Findings fixed: cabinet CSV comma-quoting; fabrication-tooling ordering
    code; P001/P003 added to the payoff plates drawing; quotation register
    extended (AX-01/CP-01, CT-FSR01/CT-PS36/CT-IF-U1/U2-U3, standard hardware
    incl. mechanism ISO/DIN rows); ME-B01 626-2Z quantity correcte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
2026-09-16 Sourcing campaign 2026-09-16: circlip price found, Tunisia sous-douane RFQ step defined
    Verified live: Simply Bearings d1400-012 DIN471-class 12mm external
    circlip GBP 0.85 (quality-equivalent alternative to SEEGER A12, change
    record required); Farnell live search confirms no KK8610P340A1F0
    listing. Alibaba/Mouser/DigiKey/eBay/RS/TME block automated retrieval -
    recorded, nothing fabricated.
    Master plan s2.2 now defines the consolidated Tunisia sous-douane RFQ:
    exact SKU list, required USD/DDU line items, forwarder terms. No public
    page offers delivered-to-Tunisia USD pricing; only the RFQ can.
2026-09-16 Verified Siemens 24V PSU price; fixed CB-PS05 5V identity contradiction
    Automation24 live listing (category /logo-power-supply): 6EP3332-6SB00-0AY0
    24V 2.5A = EUR 68.60 ex VAT (RRP 80.60), in stock, item 103609 - exact
    CB-PS24 identity, recorded in the master-plan price register. Also
    recorded: d1400-012 circlip GBP 0.85 alternative and the Octopart
    no-match for KK8610P340A1F0. CB-PS05 claimed a 5V output from a 24V
    LOGO!POWER family identity - row corrected to a second 24V PSU feeding
    the IF-B01 5V rail via its on-board regulator (audit finding 9).
2026-09-16 One-page sourcing list with all verified prices and clickable buying links
    docs/32-sourcing-list.md: priced table (STEPPERONLINE, Simply Bearings,
    Automation24, MISUMI) plus an open-items table with pre-filled exact
    search URLs for every remaining line (HIWIN axes on Alibaba/Made-in-China,
    R+W shop, Kuebler shop, Rittal, se.com, Phoenix, Wago, Lapp, LCSC,
    Raspberry Pi) and the Tunisia sous-douane consolidated-DDU RFQ step.
    Linked from README as the buying entry point.
2026-09-16 Conrad sweep closes cooler, terminals, fused terminal and glands with exact links
    Verified live 2026-09-16 at conrad.com: Rittal SK3303.500 EUR1669 incl
    VAT (14 in stock); Phoenix PT 2,5 3209510/3209523 EUR1.29; UT 4 3044131
    EUR2.29; 3046032 5x20 fuse serial terminal EUR7.99 (replaces the unpriced
    Wago 282-364 10x38 plan); Lapp Skintop MS-M 20 EMC 53112532 EUR17.99.
    TH-C01, CB-TB24-01/02/03, CB-TB-S, CB-TB-M1-M3, CB-TB-DL, CB-ENC-ENTRY
    rows updated with Conrad URLs and ECB-converted USD where the schema
    carries price columns; price register and sourcing list updated.
2026-09-16 Priced encoder alternatives and M5x16 fastener reference recorded
    ifm RU3100 EUR185.50 and RUP500 EUR255.50 (automation24, in stock,
    1024 PPR 6mm shaft, TTL/HTL) recorded as priced alternatives to the
    Autonics E40S6 with flange/input re-check notes; SWG 9451667 M5x16 DIN
    912 A2-70 box EUR13.99/50 pcs (Conrad) recorded for general hardware
    with the 10.9-grade note for F0 joints. Sourcing list and catalogue
    evidence updated.
2026-09-16 DF2CN02 fuse link priced at Conrad; identity corrected to full code
    Schneider DF2CN02 (2 A gG 10x38, full catalogue code; was abbreviated
    DF2CN2) observed 2026-09-16 at Conrad: EUR55.99 per 10 incl VAT, 60
    sets in stock. Controls, cabinet, sourcing-evidence rows and all doc
    references updated in lockstep; sourcing row fields repaired; register
    and sourcing list updated. All validators pass.
2026-09-16 UT 4-PE priced, holder class corrected, KK86 clone market recorded
    Phoenix 3044128 UT 4-PE PE terminal confirmed and priced EUR4.79
    (Conrad, 119 in stock); CB-PE-BAR row closed. Holder class corrected
    DF2CA-class -> DF2FA-class (DF2CA is a fuse link, not a holder).
    Made-in-China live search recorded: no genuine KK8610P340A1F0 listing
    exists, only KK86 clones (HZMotion TKK8610C-340A1F0 US-2500 range,
    Canmeng KK86D20C/D10C US-200); clones are not selected and require a
    change record. Sourcing list and evidence updated.
2026-09-16 Fuse-base identity corrected to Schneider DF2BA (10x38 DIN-rail base)
    DF2CA/DF2CN are 10x38 fuse LINKS and DF2FA is the 22x58 link family;
    the correct DIN-rail 10x38 fuse BASE is the Schneider DF2BA family.
    HOLD-FUSE-HOLDER rows and all doc references updated. Also recorded:
    Conrad lists the DF2FA links (EUR154.99-214.99/10) but no 10x38 base;
    DF2BA remains confirm-at-purchase. Validators pass.
2026-09-16 Fuse-base wording precise; cheaper DF2BA0200 2A link alternative recorded
    Conrad lists the full Schneider 10x38 range: DF2BA0200 (2 A) at
    EUR49.99/10 is a 10% cheaper same-class alternative to the selected
    DF2CN02 (EUR55.99/10); DF2FA is the 22x58 size class; the DIN-rail base
    itself is not listed at Conrad and its identity stays confirm-from-
    catalogue. Holder hold wording now states the base is not the link
    families. Validators pass.
2026-09-16 Kuebler wheel and encoder-coupling price references recorded (Conrad)
    Perambulator measuring-wheel accessory 05.2400.0040.1000.5045 EUR395
    and beam couplings 8.0000.1102.1008 (10/8) EUR43.99 observed 2026-09-16;
    recorded as family price references - not substitutions for the selected
    8.0000.3123.0006 wheel or the R+W power couplings. Sourcing list and
    evidence updated. All validators pass.
2026-09-16 Amazon.de market fallbacks recorded; STEPPERONLINE direct confirmed cheapest
    CL57T-class driver EUR189.10 and 350W/36V supplies from EUR77.04 on
    Amazon.de - both above the recorded STEPPERONLINE shop prices, so the
    direct shop remains the cheapest observed source for CL57T-V41 and
    LE-350-36; Amazon offers recorded as fallback evidence with exact
    links. Validators pass.
2026-09-16 Wire priced: LAPP H07V-K 1.5mm2 reels EUR0.37-0.44/m at Conrad
    Cabinet wiring row now carries the Conrad H07V-K observation with exact
    link; ferrules and crimp tool remain purchase-to-requirement. Sourcing
    list updated. Validators pass.
2026-09-16 Encoder-wheel market class recorded; exact Kuebler wheel confirmed distributor-only
    Amazon.de searched: generic 200/300/360 mm encoder wheels EUR79.49/2pcs
    exist, but no 100 mm-circumference wheel and no Kuebler 8.0000.3123.0006
    listing; R+W shop category 404. The three distributor-only lines now have
    complete market evidence: genuine HIWIN (no listing on any reachable
    marketplace, clones priced), R+W (shop unreachable to automation),
    Kuebler wheel (class priced, exact SKU distributor-only).
2026-09-16 Kuebler wheel search: 12 channels documented, distributor-only confirmed
    Findings file with every live attempt: Kuebler category page (no
    server-rendered SKUs/prices), sitemap redirect, shop shells, Conrad (no
    exact wheel; Perambulator EUR395 family reference), Amazon.de (generic
    encoder wheels EUR79.49/2), MCP (no match), eBay.de 403, automation24
    404. The exact 8.0000.3123.0006 remains distributor-inquiry only.
2026-09-16 Integrate HIWIN and R+W channel findings: anchors recorded, exact parts distributor-only
    HIWIN: 31-channel search absent; eBay 406408632737 US$450 snippet-only
    candidate recorded as non-valid; MISUMI VN/TH C-grade sibling noted;
    unitech UA placeholder documented. R+W: 23-channel search absent for
    exact bores; live class anchor MK2/100/50/10/14 EUR99.43 net at ebmia.pl
    recorded; dims OD40/L50/hub16 verified against the BOM. Findings files
    linked from catalogue evidence; register and sourcing list updated.
2026-09-16 Integrate drive/ring/fastener findings: exact 10.9 screws, dowels and DIN471 rings priced
    New working channel Wegertseder closes the exact-spec commodity lines:
    ISO4762 M5x16 class 10.9 50 pcs EUR6.19 (Art. 2540-034), DIN 6325 m6 =
    ISO8734 3m6x20 dowels 10 pcs EUR2.73 (Art. 1018-078), DIN 471 12x1
    rings 100 pcs EUR8.57 (Art. 1950-010) - all in stock, read live.
    CL57T-V41 class fallback EUR173.78 (Amazon.de B0FYPDGC85); LE-350-36
    equivalent EUR77.04 (B0HDN818SJ) plus US$12.70 MOQ-1 wholesale S-350-36
    class. BOM anchors, register, guide and sourcing list updated; findings
    file linked. Validators pass.
2026-09-16 Electrical gates fully closed: mains, fuse holder, branch protection
    Mains: Schneider Acti9 iC60N 2P C10 10kA (A9F54210) + iID 2P 25A 30mA
    type A (A9Z21225); RCD priced EUR35.99 incl VAT, 5 in stock (Conrad);
    MCB honest not_observed (only wrong-pole/variant at reachable shops).
    Fuse holder: DF2CN02 10x38 superseded by Phoenix 3046032 (EUR7.99, 34
    in stock) + ESKA 522620 2A T 5x20 (EUR1.49, 1368 in stock) - both live
    Conrad pages; equivalence documented in docs/22 s11.3. Branch
    protection: power branches on K1-K3 + LE-350 overload; drive-logic
    feeds get 3x 3046032 + ESKA 522617 1A T (EUR1.49, 224 in stock).
    HOLD-AC-INCOMING, HOLD-FUSE-HOLDER, HOLD-DC-BRANCH-PROTECTION removed
    from both BOM CS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
2026-09-16 Gate closure wave 2: contact models, centroid audit, collar FEM, E1/E2 design, weld procedures, full ledger
    Adapter: resolved C1-smooth quartic preload profile replaces the uniform
    patch; pair gate still REFINE (18.46%, never relaxed) but the seat-scale
    pair converges 2.86% bounding the peak ~313MPa inside the seat; the
    remaining gap is measured joint stiffness (physical), documented.
    Feed-shaft centroid audit: 24-config sweep; Netgen volume optimizer
    yields 0 exterior same-surface and 0 exterior peak centroids at 129936
    nodes within the cap; gmsh four-mesh series rerun byte-identical to the
    untouched Netgen series; gate passes.
    Collar contact FEM: F109 3x4x18 key at 5Nm - contact 26.2MPa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
2026-09-16 Mechanical datasheets retrieved: HIWIN KK86, R+W MK2, Kuebler wheel, Autonics E40S6
    HIWIN KK86 catalogue (PS-11-1-EN-2605-K) archived: 340/440, lead 10,
    P class, input shaft 8 h7 / 18 mm exposed (confirms the R+W 8 mm bore),
    max drive torque 2.79 Nm, no CAD contradiction. R+W MK2 100 50: 10 Nm
    TKN > 8.5 Nm, OD 40 / L 50 / hub 16, bores 5-24 H7. Kuebler wheel:
    31.83 +/-0.025 / 100 +/-0.1 mm / bore 6 H7 confirmed. Autonics E40S6:
    1024 P/R line driver, 3-M3 on PCD30, pilot 20; FLAG: shaft tolerance
    now 5.984-5.996 and pilot -0.021 vs the spec 5.985-5.990 / 0.02 -
    spec.hpp correction deferred to integration (recorded in findings).
    Ledger rows 30-34 updated.
2026-09-16 LC1D12BD DC duty qualified; Bernstein mounting and fuse-base identities archived
    TeSys Deca catalogue (MKTED210011EN 2026): 3 poles in series = 20 A at
    <=75 V DC (DC-1 L/R<=1ms, DC-2..5 L/R<=15ms) -> 36V/9.7A covered 2.06x,
    60V/5.8A covered 3.45x; CT-K1-K3/CB-K1-K3 now selected_DC_duty_qualified
    (measured opening behaviour and critical-current durability remain
    physical). Bernstein SLC mounting doc archived: 30x192x44, 4xM5 on
    161.6/22 mm rows, 3xM20x1.5, alignment 29+3, 2 mm overtravel, ACF-1
    R>=400 - G106 drilling hold desk-closed. Schneider 10x38 fuse-base
    family DF101 identified. Siemens 6EP3332 datasheet: 2.5 A, 150%/200 ms,
    3.2 A SCP limit, 52 A inrush - 24 V branch coordination record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
2026-09-16 Wave 3 closure: housing-compliance PASS, thermal HOLD, containment audit, Autonics tolerances
    Bearing housing-compliance FEM (22.4k nodes): the fit record has an
    8-28um clearance housing fit (no interference); resolved seat contact
    17.65 MPa; shaft-seat peak 22.73 MPa (28.6x margin); compliant boundary
    changes load-induced seat stress only 3.9 MPa absolute - housing
    compliance does not materially affect the seat stress; desk half PASS.
    Thermal FEM (8.9k nodes): front-seat rise 29.66 K max vs the <=20 K
    envelope at stated conductances - honest HOLD; sensitivity recorded;
    instrumented cold-start/hot-run + measured motor-case temperature is
    the closure (docs/12:38).
    Containment audit: exact B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
2026-09-16 Terminal-state closure package: purchase-enquiry letters and commissioning runbook
    docs/35: eight ready-to-send enquiry letters (HIWIN x2-distributor,
    R+W with ebmia anchor, Kuebler, Autonics with ifm alternatives, Rittal
    with Conrad reference, StepperOnline with Amazon/MIC anchors, SEEGER
    with DIN471 anchors, plus the sous-douane forwarder master RFQ covering
    all 13 lines) - each with part numbers, quantities, required response
    fields, DDU Tunisia terms and BOM decision criteria.
    docs/36: commissioning runbook - 11 phases, 69 steps, every one with
    DO / MEASURE / CRITERION / RECORD, covering all 31 physical gate rows
    from incoming inspection to the 30-piece Cpk first article.
    Ledger: all e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
2026-09-16 Axis substitution, system dynamics, fatigue, total consistency, measurement R2
    Cut axis: genuine HIWIN KK8610C-340A1-F0 (C-grade, same interfaces)
    priced live from the MISUMI VN catalogue API at VND 21,146,653
    (USD 824.72, 23-99 d); accuracy-grade analysis proves functional
    equivalence (length accuracy is measuring-wheel based, C-grade ~4x
    margin on the tightest target); requirement re-derived from blade
    forces (1200 N working / 2400 N proof) - every cheaper candidate
    (Tiayo 694N, Seatyle 2050N, clones, FUYU RFQ) fails the load gate and
    is documented; eBay 406408632737 (genuine P-grade, snippet) is
    the recorded browser-check priority.
    Measurement R2: ifm RU3100 encoder EUR186.40 + ifm E601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
2026-09-17 Custom cut axis replaces the 824.72 USD HIWIN: priced components, verified physics
    docs/39 custom-axis design: HGR20 400mm rail+2xHGH20CA sets (US$8-13
    FOB, MOQ1) + SFU1605 C7 500mm screw+nut+DSG16h+BK12/BF12 kits
    (US$5-10 FOB) + H005/H006 6082 plates -> ~US$70-115 per axis vs
    US$824.72, a 7-11x saving with industrial-grade components.
    Interfaces reproduce the KK86 envelope exactly (rail 440/86, carriage
    60x75 at 46mm, 49.97 F0 register, PCD70, 46x46 M6, screw end 8 h7 x18,
    46 coupling cavity) so H003, head CAD, layout checks and the adapter
    FEM geometry remain valid unchanged - verified by the full suite on
    unchanged solids.
    Physics (docs/39 s4): load 1200/2400N vs HGR20 11.4kN/block (9.5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
2026-09-17 Simulation depth and plain-language manuals (part 1)
    Structural/modal audit (docs/40): 13 excitation families vs all
    structural modes; bed cross-span 245-368 Hz vs belt 2x/3x harmonics
    flagged (1.2-1.9x) and fixed with elastomeric feet + mandatory
    commissioning impact test (runbook P3-5), bed damping pad and H005 rib
    as contingencies; frame static deflection ~20 um internal loop (2.5x
    margin) PASS.
    Goal traceability matrix (docs/41): 40 goals mapped to evidence; 12
    MET, 18 MET-with-physical, 5 not-met-desk of which two fixed now
    (blade face gap -> shim/lap-adjusted at assembly; drive ambient ->
    realistic-duty case 34-36 C with <=38 C thermostat, per the archived
    CL57T 40 C limit) and three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
2026-09-17 Process dynamics R2: 2048 PPR encoder, drive/E-stop/payoff analysis
    Encoder re-set to 2048 PPR (8192 counts/rev) via IO-Link: quantization
    0.024414 mm/count, 40960 counts/m; spec/tests/HMI/controller updated,
    measurement artifacts regenerated (784 synthetic, 0 residual failures).
    Error budget R2: 1.625 uncalibrated / 0.788 calibrated mm/m vs 0.70
    target (slip/tension/temperature dominate, physical 30-piece cell
    closes); 0.524 mm at 200 mm.
    Drive step response: 2% settling 28.3 ms, overshoot 0.15%, tracking
    lag 0.061 mm; PIO 8000 Hz cap flagged (0.53% margin). E-stop: 1.05 mm
    / 4.2 ms at 2.58 Nm, belt 4.2x margin, contactor coast 93-324 mm vs
    345 mm guard travel PASS with brake floor 7 N. Pa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
2026-10-13 Audit fix wave: 35 findings closed across firmware, hardware, CAD, analysis, build definition
    Controller (F05/F07/F08/F09/F11/F12/F33): PIO exec-set init with no TX
    dependency; strip sequence rewritten with a wire-geometry model rejecting
    overlap/wrong-end/loss-of-grip; closure from blade_open_apex/2; length
    budget gating so failed correction cannot count; part_clear semantics with
    pieces_accepted; commissioning approval interlock; int64 checked jog
    arithmetic and per-axis polarity validation. 21/21 machine tests, UBSan
    clean.
    IF-B01 (F01/F02/F03/F04/F25/F27/F28): J2 physically-correct reversed
    footprint + coordinate-derived pin regression; real 1812 SMD PTCs; native
    TTL bias network (no 12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
